adlererik/voicevault/hardware/evidence/2026-11-12/README.md

# VoiceVault B0 hardware evidence — 2026-11-12

**Latest complete-board routing checkpoint fails native DRC. Manufacturing and physical qualification remain blocked.** No board was manufactured or measured. The Rust laboratory's eleven verification groups were not rerun for this CAD-only change.

Actual native KiCad partial routing

The native board contains **296 electrical components, 14 probe pads and four mounting holes**, on a provisional two-sided 70 × 45 mm outline. The image labels actual, unchanged footprint positions and shows the latest complete-board autorouter result. Routing is incomplete and has native DRC errors. The six-layer/1.0mm stackup is a proposal, not an accepted manufacturing specification.

## Latest global autorouting result

Official **FreeRouting 2.5.0**, unmodified JAR, OpenJDK 25.0.4.1. The 30-minute job limit was reached, and the router saved an SES. The entire copper result was imported into the live editor through kipy; all 314 placements and original zones were preserved. Copper zones were refilled before native DRC.

**Native KiCad: 280 open connections; 33 layout errors and 100 warnings; 2,137 tracks/vias (274 vias, including 53 laser).** Two tracks violate the antenna rule, twelve tracks are undersized, nineteen thermal connections are starved, and one hundred copper items are dangling. This is not accepted manufacturing copper. [Complete result, logs, DSN, SES and native DRC](autoroute/README.md).

## Historical input checkpoint and circuit-model checks

The table, `report.json` and `drc.json` below describe the saved **pre-autoroute source hash `40b4ab8a…`**, not the current board. Earlier passing guards do not establish that the new global result passes. The input checkpoint remains available in Git commit `53378f2`. The Rust laboratory and circuit models were not rerun for the global copper import.

| Check | Recorded result | Evidence / scope |
|---|---|---|
| Source copies | Nine preserved references match their hashes | [Report](report.json) |
| MCU identity/pin mapping | 144 balls and 29 selected functions agree with pinned ST data | Actual native schematic export and [independent ST data](../../rev-b/reference/st-ufbga144-ballout.json) |
| Circuit-to-pad correspondence | 1,026 schematic-connected nodes, 124 intentional NC pins; 314 footprints | Actual PCB pad/net inspection, not just the circuit manifest |
| microSD replacement | Molex 1040310811, eleven logical pins / fourteen lands agree with reviewed drawing and actual board | [Geometry check](microsd-footprint.json), [replacement stage](routing/microsd-replacement.json), [revision/provenance limits](../../rev-b/reference/microsd-selection.json) |
| ERC | Zero issues | [Native ERC report](erc.rpt) |
| DRC | Zero non-routing violations; **495 unrouted connections** | [Native DRC report](drc.json). This snapshot lists all 495 open connections. Progress always uses the full native ratsnest when the detailed list is capped. |
| Antenna rule negative control | Unrelated track and ground via rejected; RF-feed track allowed | [Result](antenna-negative/result.json). A board copy was deliberately modified; the live PCB was unchanged. |
| Copper import guard | Valid existing-net RF connection retained, antenna intrusion rejected; live board unchanged | [Control result](routing/import-control.json), [reproducible check](../../tools/check_routing_import.py) |
| Laser-via audit | Thirty-one laser vias; no nominal geometry violations; deliberately bad spacing rejected | [Geometry and limits](hdi-geometry.json) |
| MCP acceptance guards | Changed candidate and stale source rejected; live board unchanged | [Actual negative controls](routing/mcp-acceptance-control.json) |
| Local KiCad MCP | KiCad 10.0.8, 314 footprints, 199 named nets | [Actual stdio-to-IPC call result](mcp-connection.json) |
| ngspice 47 models | **799 cases completed** | Passive/static model assumptions below. |
| Power allocation | Named engineering modes fit the proposed 1200mAh-pack allocation under explicit assumptions | [Budget inputs/results and limitations](power-budget.json). Not measured power or battery life. |
| Historical routing trial | Incomplete, 480-second timeout; no accepted route | [Record](routing-study.json), [log](routing-study.log). Earlier copy, no output applied. Fanout progress is not routing completion. |

The pre-autoroute board contained **345 track segments, 103 vias (31 laser) and four ground pours**, alongside the tested antenna rule area. The full native count fell from 853 to 495; most of that reduction comes from ground pours. [Initial RF-stage record](routing/rf-stage.json), [accepted MCU connection](routing/core-route.json), [RF ground refinement](routing/rf-ground-refinement.json). A later bounded lattice-router study timed out with no saved route and was not applied: [record](routing/lattice-timeout.json), [log](routing/lattice.log).

Accepted routing stages: [14 MCU ground escapes](routing/mcu-ground-escape.json), [PMIC capacitor/placement adaptation](routing/pmic-cap-route.json), [first control batch](routing/control-wave1.json), [second control batch](routing/control-wave2.json). The batches each contain eight control nets; the associated `*-plan.json` and `*-mcp.json` records retain the proposed paths and actual local acceptance calls. [Main crystal placement, routes and seven ground microvias](routing/hse-layout.json) were accepted after a separate explicit placement/pad comparison and native checks; the chip and capacitor branches stay on F.Cu. [Method, reproducibility and process assumptions](../../rev-b/ROUTING.md).

[Manufacturing cost comparison](../../rev-b/MANUFACTURING_COST.md) targets four assemblies delivered to Sweden. Public fees establish cost drivers, not a cheapest complete delivered quotation.

Additional bounded Freerouting studies also timed out without an output session and were not applied: [360-second run](routing/freerouting-bounded.json), [240-second run with fanout disabled](routing/freerouting-no-fanout.json). The [local search-budget modification](routing/freerouting-budget-patch.json) is explicit; these were modified-tool experiments, not upstream qualification results. Fine-pitch escape and clock/decoupling placement need deliberate engineering before another whole-board routing attempt.

The [report](report.json) records SHA-256 hashes of the exact CAD, project/rule files and circuit manifest that were checked. All manufacturing blockers remain visible. Its `native_nets` count includes virtual singleton NC records; **199** is the count of named copper nets.

## Circuit-model measurements

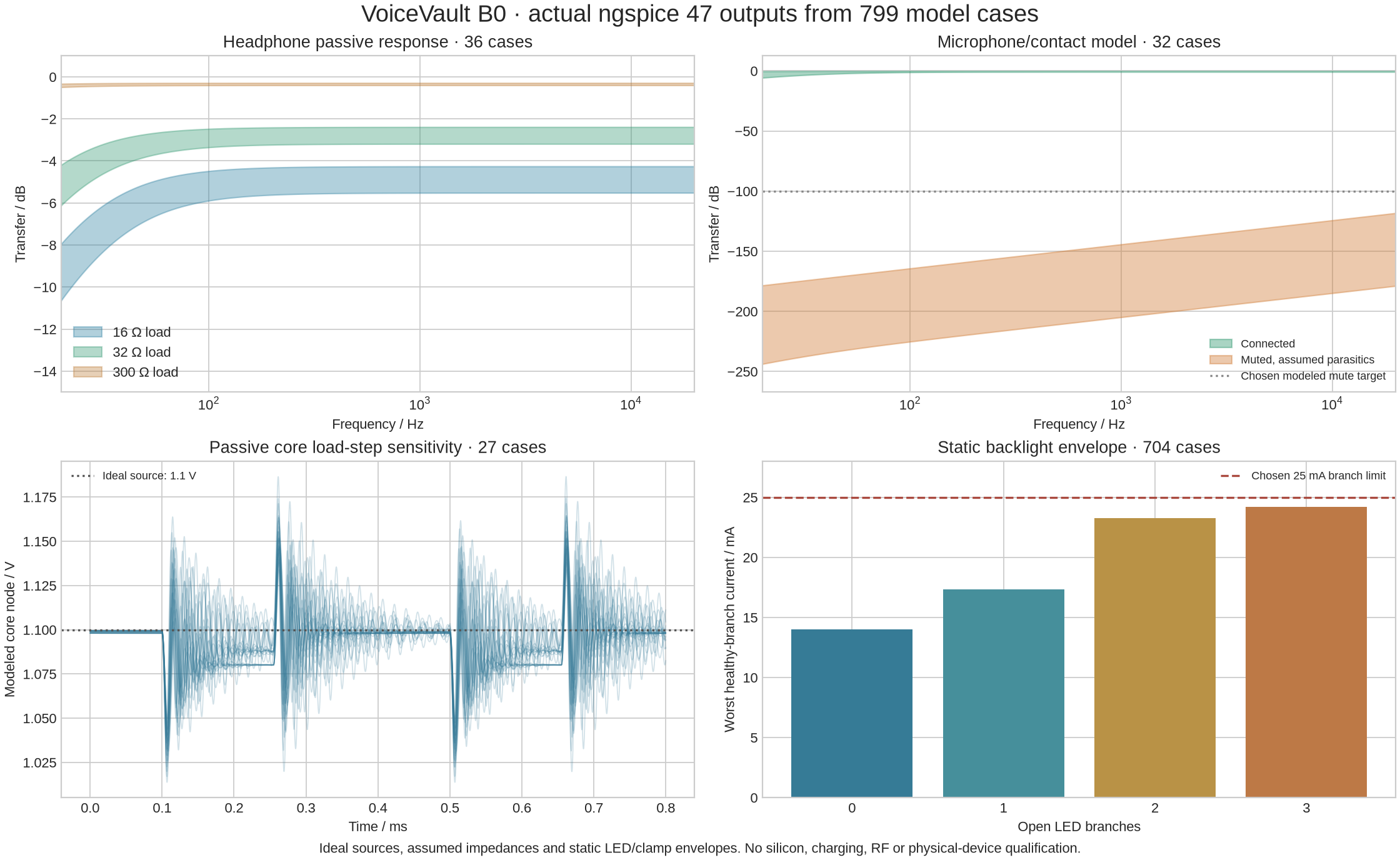
[picture p3: hardware/evidence/2026-11-12/circuit-results.png]
Actual model outputs


- [27 MCU passive core-network cases](spice-core/summary.json): ideal averaged source, component sensitivities and a specified load step. No MCU regulator/control-loop model.
- [36 headphone, 32 microphone and 704 backlight cases](spice-audio-backlight/summary.json): exact measured model outputs, input assumptions and limits. No codec/charging/converter silicon or acoustic model.
- [Representative raw inputs, logs and data](sample-cases/) include the maximum-current and maximum-voltage backlight cases. The complete 799-case numerical summaries are retained above. Re-run the scripts to regenerate every raw case locally.
- [Simulator version](spice-audio-backlight/version.txt), [plot-library versions](plot-tools.json), [latest CAD/import check log](check.log), [799-case run before the final layout-only refinement](model-check-before-layout-refinement.log).

Reproduce available checks with `./hardware/check --design-only --spice`. The `--design-only` exit status concerns available checks; it does not clear the manufacturing verdict. Model results cannot establish that the device functions securely on physical silicon or withstands the adversary described in the software threat model.

## What remains

An accepted HDI stackup/pad process, reviewed exact parts and lifecycle/sourcing, completed power/RF/signal routing and planes, thermal/charging/ESD review, independent electrical review, final BOM/CPL/DFM/test-fixture acceptance, board-specific firmware and actual measured samples/interrupts/access denials. [Active design and gates](../../rev-b/README.md)

## Saved placement before whole-board autorouting

The saved 448-item copper checkpoint has 345 track segments, 103 vias (31 laser), 495 open connections and zero native layout violations. Twelve further control nets were accepted in [batch 3](routing/control-wave3.json), then seven inner escapes were explicitly reworked without changing other copper or pad positions. The [before audit](routing/mcu-escape-before.json) detected nine blocked sites; the [checked rework](routing/mcu-escape-rework.json) and [current audit](mcu-escape-reservations.json) leave all 68 reserved MCU sites clear. The audit also rejects an injected foreign branch on a memory-only copy. This covers MCU escape space, not complete fanout or other packages.

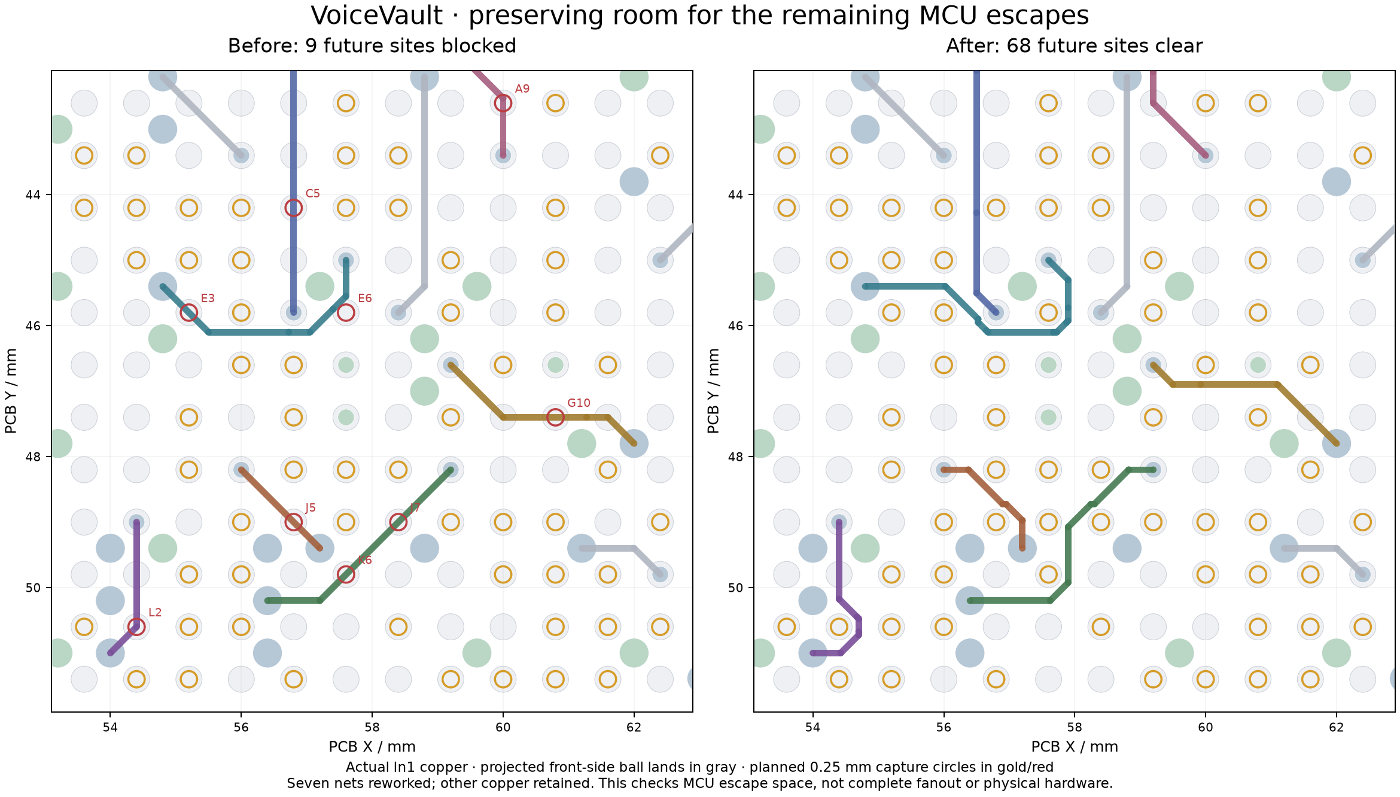
[picture p4: hardware/evidence/2026-11-12/mcu-escape-review.png]
Actual native MCU escape geometry


The owner has now selected a complete-board FreeRouting DSN/SES workflow. These saved-placement checks describe the input checkpoint; the whole-board import and final DRC are separate results.
