adlererik/voicevault/docs/evidence/voicevault-live/README.md

# VoiceVault complete live verification

Run `voicevault-complete` on 2026-11-10, with runtime sources identified by the tested-source manifest (native implementation commit e2742cc, with the subsequent UI refinement explicitly recorded). All eleven required groups and 42 checks passed; the runner exited zero. The journal is the actual event set and the verdict links raw logs. `live`/`live-faults` are extra eight-second observed calls. Scored timing traces are recorded, not live telemetry. The four Kani proofs and six >=120-second fuzz campaigns retain their original bounds/gates.

The local full artifact also contains offline HTML, generated WAVs, fuzz corpora and the public-key diagnostic ELF. These are software evidence, not a physical device test or production firmware. Earlier interrupted development attempts are not counted as successful full runs. The original phase-two directory remains unchanged except for an added verbatim copy of its summary.
