adlererik/voicevault/hardware/evidence/2026-11-13/quilter/routing-input/README.md

# Routing input — not a manufacturing release

This is the native-checked input to Quilter job `6af65cc705fb406688266032`, not a finished result or the live KiCad project. It has unfinished connections and 67 dangling-copper warnings. Native DRC reported zero errors and the separate laser-hole audit passed. See the parent evidence and hardware/rev-b/QUILTER_ROUTING.md. The project uses embedded footprint geometry; its source libraries are in hardware/rev-b.
