adlererik/voicevault/hardware/requirements-design.txt

-r requirements-mcp.txt
# Offline two-sided courtyard packing. KiCad itself supplies the native CAD API.
rectpack==0.2.2
