adlererik/voicevault/hardware/requirements-mcp.txt

# Official MCP SDK and official KiCad IPC bindings, tested together.
mcp==1.26.0
kicad-python==0.8.0
