adlererik/voicevault/hardware/rev-b/QUILTER_ROUTING.md

# Quilter routing preparation — 13 November 2026

**Full cloud trial finished at 89% routed and failed native qualification.** The live KiCad board still contains the earlier unfinished FreeRouting checkpoint. Cloud results and repair candidates are isolated copies, not an accepted replacement. [Actual returned board, failures and native evidence](../evidence/2026-11-13/quilter/routed-return/README.md).

**A corrected full-layout retry launched at 14:35 Europe/Stockholm on 13 November:** [VoiceVault B0 — Corrected routing, fanout disabled](https://app.quilter.ai/jobs/6af70fde5e1a5ebf38278f80). It runs on Quilter's servers and can continue with Codex/the computer off. This is a submitted job, not a completed or qualified PCB. [Saved settings and launch evidence](../evidence/2026-11-13/quilter/native-repair/cloud-retry.json).

The retry uses a fresh-process-verified copy with zero native layout errors, 214 dangling-copper warnings and 207 unfinished connections. Native-DRC-driven cleanup removed 193 offending cloud copper items while preserving all 473 protected source items; the reviewed core/battery-capacitor and package-land corrections are included. [Native cleanup verification](../evidence/2026-11-13/quilter/native-repair/verification.json).

The new submission explicitly disables forced fanout for all seven BGAs and increases new-routing clearance to 0.15 mm and ordinary via diameter to 0.50 mm with 0.20 mm drill. The reviewed current/decoupling/clock/converter tables were re-imported, rather than trusting automatic guesses. All 314 components remain placed; Quilter reports 492 pins to route. The account remains Free Plan; no purchase, upgrade or manufacturing order was made. Returned copper still requires original-rule native refill/DRC, geometry and electrical review before live acceptance. Input ENIG metadata does not change the cloud preset's displayed Lead-Free finish; final finish/stackup acceptance remains open.

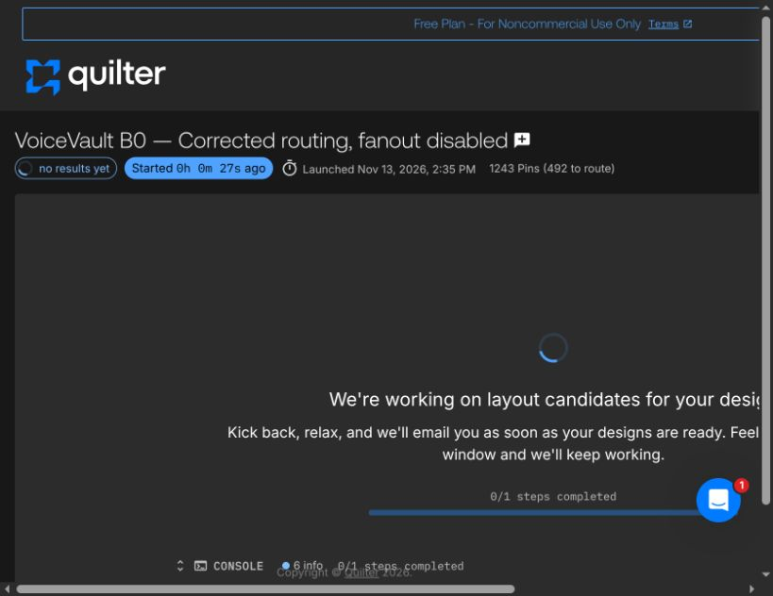
[picture p9: hardware/evidence/2026-11-13/quilter/native-repair/retry-started.jpg]
Corrected cloud retry launched


## Separate new project

The owner requested an independently configured [new VoiceVault project](https://app.quilter.ai/projects/6af617fb05fb406688265ff7). The cancelled project and its guessed settings were not reused or modified. The free account was used; no purchase, upgrade, manufacturing order or supplier message was made.

[The placement-only job](https://app.quilter.ai/jobs/6af61bb61a10ff2500b2aac8) finished on 12 November at 22:27 Europe/Stockholm and produced six placements. This is not a completed routing run. All six were downloaded and checked with native KiCad. Each retained all 314 footprints, 1,243 pads, numbered pad/net assignments and 65 fixed anchors; 249 flexible components moved. Sensitive RF/clock/switch-node copper and the antenna reservations were retained. Quilter's summary reported 122 successful physical-rule checks, two warning groups and no cloud DRC errors per placement.

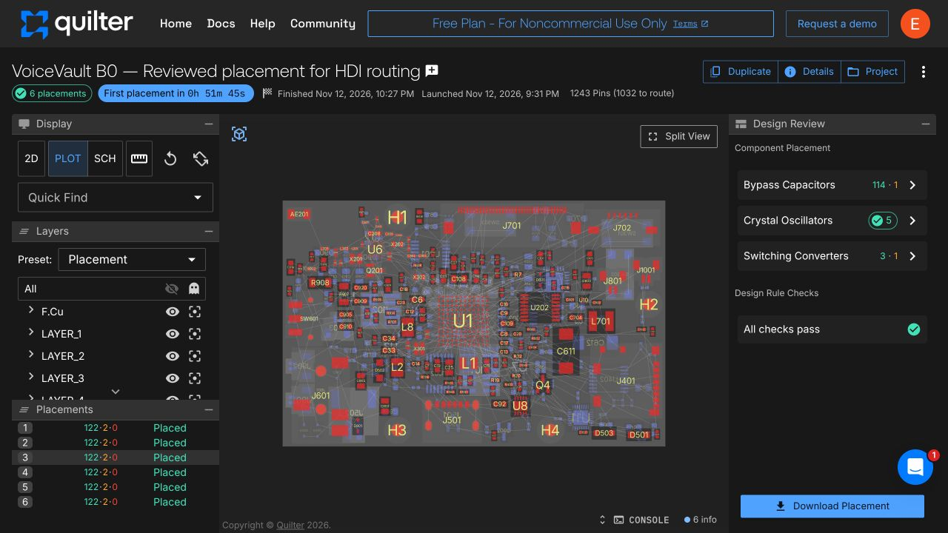
[picture p10: hardware/evidence/2026-11-13/quilter/placement-finished.jpg]
Finished placement job


## Independently selected provisional construction

The new configuration uses six copper layers with ground-reference layers 2 and 5, signals on the other four layers, and no dedicated power plane. The JLCPCB profile is a routing study, not factory acceptance or evidence that JLCPCB is the cheapest assembled supplier. It models 1.538 mm of copper/dielectric; the exported construction including masks sums to approximately 1.599 mm. This differs from the earlier provisional 1.0 mm board.

Minimum routing width/clearance is 0.10 mm; ordinary vias use 0.45 mm lands and 0.20 mm drills; edge allowance is 0.50 mm. The existing first-order HDI laser-via intent is 0.25/0.10 mm. Component gap, current budgets, dielectric construction, effective capacitance and assembly capabilities remain assumptions requiring review. Thirty power-current rows were supplied as design envelopes, not measured currents or fault limits.

The reviewed input had 115 unique bypass-capacitor relationships, five crystal groups, four converter groups and seven BGA fanout entries. A subsequent pin-function review corrected several shared-rail MCU capacitor associations, including the two distinct VDD11 core balls, the SMPS input and the analog/I/O/USB domains. Shared net membership alone does not establish correct decoupling placement. Original submitted tables remain frozen; the corrections are recorded separately in [pin-review.json](../evidence/2026-11-13/quilter/pin-review.json). They do not change schematic nets or establish that the final power layout is adequate.

## Native acceptance checks and rejected experiments

Returned poses from placement 3 were transferred onto the trusted source CAD rather than accepting an entire returned project. This preserved exact original sensitive copper, antenna geometry and native rules. Ground pours were restored. The exported general thickness, still 1.0 mm despite the larger stack, was corrected on the review copy.

Native `kicad-cli` 10.0.8 initialized the original rules, refilled zones and reported **zero layout violations** on that reconstructed placement. This board is still unrouted: the detailed open-connection report reaches its 499-item list limit. Zero layout violations here does not mean a working PCB. [Native placement checks](../evidence/2026-11-13/quilter/placement-drc.json) · [All six identity checks](../evidence/2026-11-13/quilter/placement-inspection.json).

A local automatic capacitor-placement experiment was rejected in full: its courtyard-only search did not account for existing ground vias, and native DRC found 18 findings, including shorts. It was never imported into the live editor. A first automated BGA escape trial was also rejected pending correction of drill-clearance handling. The corrected two-pass trial produced 383 track segments and 90 vias. Native refill/DRC reported zero errors and 67 dangling-copper warnings; the independent laser audit checked 1,002 overlapping-hole pairs and 1,878 foreign-trace pairs with zero findings. Dangling escapes remain unfinished routing, not completed connections. [Escape evidence](../evidence/2026-11-13/quilter/escape-result.json). Router-generated copper must satisfy original native rules and a separate laser-hole geometry audit before acceptance. Rules have not been relaxed to conceal these results.

## Full routing trial launched

[VoiceVault B0 — Native-checked routing trial](https://app.quilter.ai/jobs/6af65cc705fb406688266032) launched on **13 November at 01:49 Europe/Stockholm** in **Full layout** mode. The upload parsed as 314 preplaced components, zero unplaced components and 957 pins to route. The stackup and minimum dimensions were reviewed explicitly. Five configuration tables were downloaded again and matched exactly; GND was verified as primary. [Actual submitted tables and equality checks](../evidence/2026-11-13/quilter/constraints/verification.json).

An additional native physical-connectivity audit examines 250 connected BGA pins with zones excluded from traversal. Its positive control detects existing through vias; its negative control removes conductive links on an in-memory copy and confirms MCU M8 becomes disconnected. Five pins currently have laser-only paths: U10 C3, U6 F7/H1 and U1 A4/A10. Of these 250 pins, 110 currently reach a through via, five have laser-only paths and 135 have no via path. Surface escape routes may still be possible; these counts are not completed-route percentages. Their onward escapes must be checked in the routed output; the input still has 505 full native open connections. [Connectivity evidence](../evidence/2026-11-13/quilter/escape-connectivity.json).

The trial finished on **13 November at 11:22 Europe/Stockholm**, producing candidate 1.1 at 89% routed. Native reconstruction/refill with the original rules found **103 unfinished connections, 294 layout errors and 117 warnings**. The candidate is rejected for live acceptance. The [returned files and diagnosis](../evidence/2026-11-13/quilter/routed-return/README.md) are preserved separately from the [actual native routing input](../evidence/2026-11-13/quilter/routing-input/voicevault-standalone-b0.kicad_pcb). Neither is a fabrication release. A separate DRC-driven repair and whole-board reroute is in progress; the live board remains unchanged until a replacement is qualified.

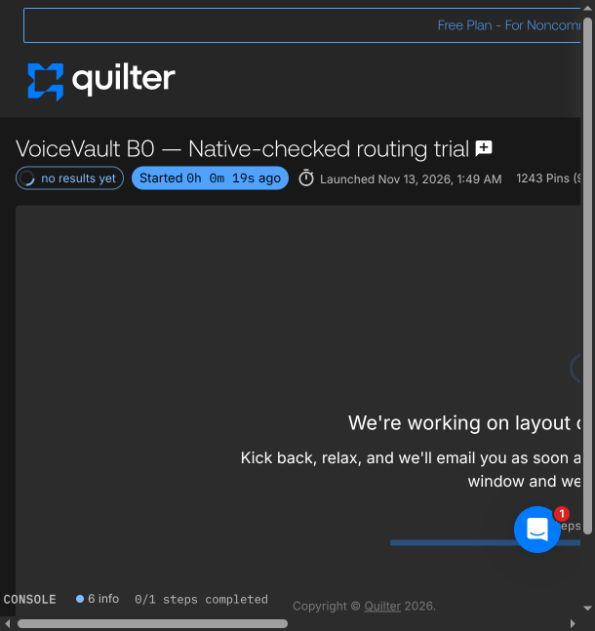
[picture p11: hardware/evidence/2026-11-13/quilter/routing-started.jpg]
Full routing trial launched


## Why routing is staged

Quilter currently documents through-via support; blind/buried-via generation remains in development. Its UI also states that KiCad custom text rules are not parsed. Explicit antenna keepouts were therefore added to the cloud input, and the original native rules are reapplied locally. See [Quilter capabilities](https://www.quilter.ai/) and [official change log](https://www.quilter.ai/changelog).

The planned sequence is placement, locally verified HDI escape preparation, a new full-routing job, returned-copper inspection, native editor import, zone refill and full DRC. Local escape preparation uses public APIs in the official unmodified FreeRouting 2.5.0 JAR through a custom driver. This is an experimental routing aid, not an audited extension or proof of completion. It generates paths algorithmically; no manually supplied trace coordinates are used. CPU and memory limits protect the development computer. The [experimental driver source](../tools/VoiceVaultFanout.java) is included for review; it uses the unchanged official JAR (SHA-256 `f6f51bb02245e8e717f9359bd260cc9c5c0b1bc0acc8b7cb2cd5b8ffeb5de3c7`). The driver and generated escapes remain distinct from the official CLI and from final routing qualification.

Outstanding gates include complete fine-pitch escapes and signal routing, power-return/decoupling geometry, RF/NFC/clock layout, trace-current sizing, exact manufacturer stackup/laser process, sourcing/derating, full ERC/DRC and independent electrical review. No manufacturing files have been released. No physical performance or security claim follows from these CAD checks.

## Returned-board identity gate

[check_quilter_candidate.py](../tools/check_quilter_candidate.py) compares component references, values, library identifiers, poses, pad numbers/nets/geometry, pad orientation/offset/corner treatment, local clearance/mask/paste overrides, copper-layer count, board outline, protected input copper and exact antenna rule areas. It rejects duplicate component references and flags unknown copper nets and unexpected new non-through via processes. Its source/candidate hashes bind the output to actual files. The saved [positive and six deliberate mutation controls](../evidence/2026-11-13/quilter/candidate-gate-controls.json) pass: net substitution, changed antenna restriction, missing protected copper, pad rotation, mask change and duplicate footprint. The controls restore the in-memory candidate and verify it against a fresh file load without saving. This gate does not approve the completed routing: native clearance rules, laser-hole geometry and electrical review remain separate requirements. Split or merged original segments require explicit review; the guard does not silently waive them.

## Proposed core-power placement repair

While the full routing job runs, an isolated three-component proposal moves C27/C107 to the rear beneath VDD11 balls D4/J9 and moves supervisor bypass C305 near U4 supply pin 4. The automatic search includes actual existing copper and drilled-hole obstacles. Native refill/DRC reports zero errors and the same 67 dangling-copper warnings; pad nets are preserved. [Hash-bound proposal and exact positions](../evidence/2026-11-13/quilter/core-power-placement-proposal.json).

These changes are absent from both the live board and the running cloud input. Zero XY projection across two PCB faces is a placement measurement, not proof of a short electrical loop. The proposal needs fresh routing, return-path inspection and qualification on the returned cloud candidate before acceptance.

## Server input verification and supplementary escape trial

The active job's **Download Input Files** archive was downloaded back from Quilter. All 21 file hashes match the upload manifest exactly. The PCB hash differs from the archived failed whole-board FreeRouting result. [Server verification](../evidence/2026-11-13/quilter/server-input-verification.json).

The local fanout driver now has an optional minimum escape-length argument; the default remains 0.6 mm, reproducing the submitted trial. A separate zero-minimum experiment permits the search to consider immediate via locations for fine-pitch pads. It runs on the isolated three-component repair proposal, not on the live board or the running cloud input. It produced 387 track segments and 93 vias, passed native refill/DRC with zero errors and 69 dangling-copper warnings, and passed the independent 14-laser-via audit. It still has 505 open connections. This is preparation for possible repair, not finished routing. [Measured trial result](../evidence/2026-11-13/quilter/direct-escape-trial.json).

No clearance limits were relaxed for this trial. Filled/planarized blind vias, exact stackup and assembly acceptance remain required; see [JLCPCB's published HDI process](https://jlcpcb.com/help/article/hdi-pcb-capabilities-faq).

## Parallel circuit and parts review

While full routing runs, the [parts-selection review](PARTS_SELECTION.md) records 182 additional nominal component candidates and a separately checked C502 battery-decoupling correction. It records rejected/held tolerance mismatches and preserves effective-capacitance, regulator-loop and assembly gates. The corrected copy preserves all source copper and electrical net assignments and passes native ERC/layout-error checks, but retains 505 open connections. It is not uploaded to the running job and is not accepted into the live editor. It must be integrated with fresh routing and electrical review after a routed result is available.

## Fine-pitch package review

Manufacturer drawing review identified two more geometry corrections to evaluate after the cloud result. ST's STWLC38 Figure 17 recommends 0.240 mm footprint lands; U5's draft uses 0.210 mm. ST's ST25R3916B Figure 43 shows a 0.330 mm footprint example; U7's draft uses 0.250 mm. The nominal grid/pad centers are retained in the isolated correction probe. [STWLC38 DS14078 p56](https://www.st.com/resource/en/datasheet/stwlc38.pdf) · [ST25R3916B DS13541 Rev11 p163](https://www.st.com/resource/en/datasheet/st25r3916b.pdf).

An isolated copy applies only those two diameter changes after the battery/core-capacitor proposals. Its 76 changed pads retain exact numbers, net assignments and centers; all 473 source copper items, antenna restrictions and outline are preserved. Native initialized refill/DRC reports zero layout errors and 67 dangling-copper warnings, with 505 full open connections. The isolated footprint-library copies match the changed board instances. [Hash-bound geometry probe](../evidence/2026-11-13/quilter/package-land-probe/verification.json).

TI's exact [YZF eight-ball package drawing](https://www.ti.com/lit/pdf/MXBG053J), linked from the TPS61062YZFR product page, confirms the draft's 0.5 mm grid and missing B2 position. It is a package drawing, not approval of PCB mask, paste or land construction; U9 remains unchanged.

These are **review copies**, not changes to the live board or current cloud input. Final copper/mask/paste construction, filled/planarized via integration, electrical return paths, routing and assembler acceptance remain open. Manufacturer nominal examples do not establish that the complete board can be assembled or will work.
