adlererik/voicevault/hardware/evidence/2026-11-13/quilter/constraints/ground_nets.csv

net_name | is_primary | use_region_pour
GND | true | false
