adlererik/voicevault/docs/evidence/phase2/README.md

# Recorded phase-two evidence

This is a curated snapshot of the fresh complete run. The raw verdict links its diagnostic logs. Timing and ARM reports state their gates, observations and limits. Reproduce with `./lab watch` to generate a new run; exact OS timings and OS-random calls will differ. The diagnostic ELF and recovered synthetic WAVs remain in the local downloadable evidence bundle. No production secret keys are included.
