adlererik/voicevault/docs/screenshots/authenticated-peer-rejection.jpg

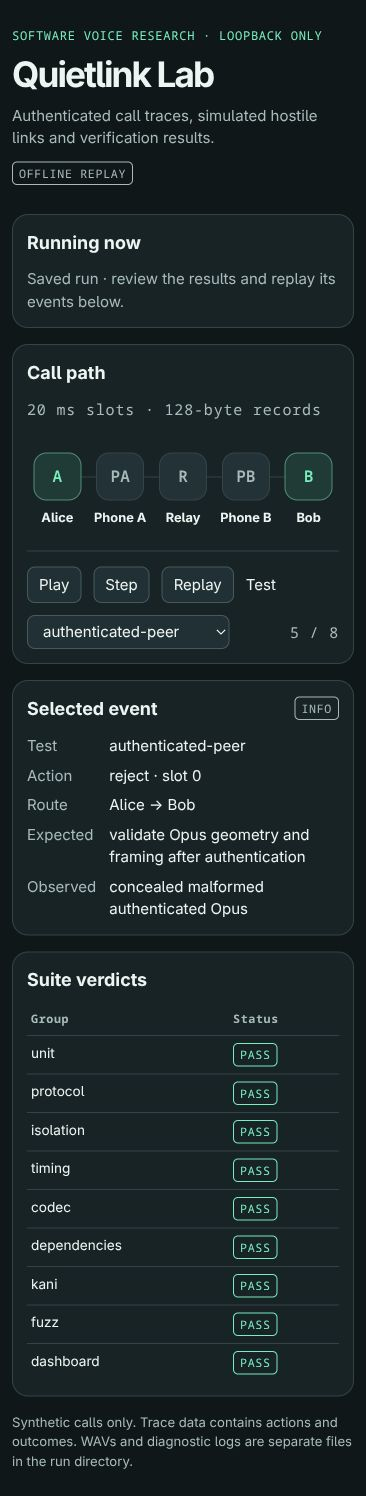
docs/screenshots/authenticated-peer-rejection.jpg
