adlererik/voicevault/docs/screenshots/command-deck-narrow-deck.png

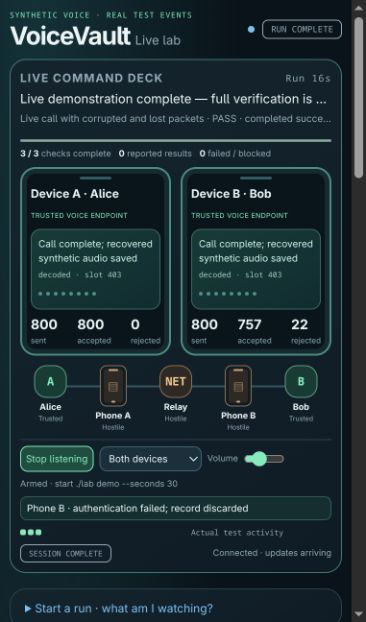
docs/screenshots/command-deck-narrow-deck.png
