adlererik/voicevault/docs/screenshots/dashboard-overview.jpg

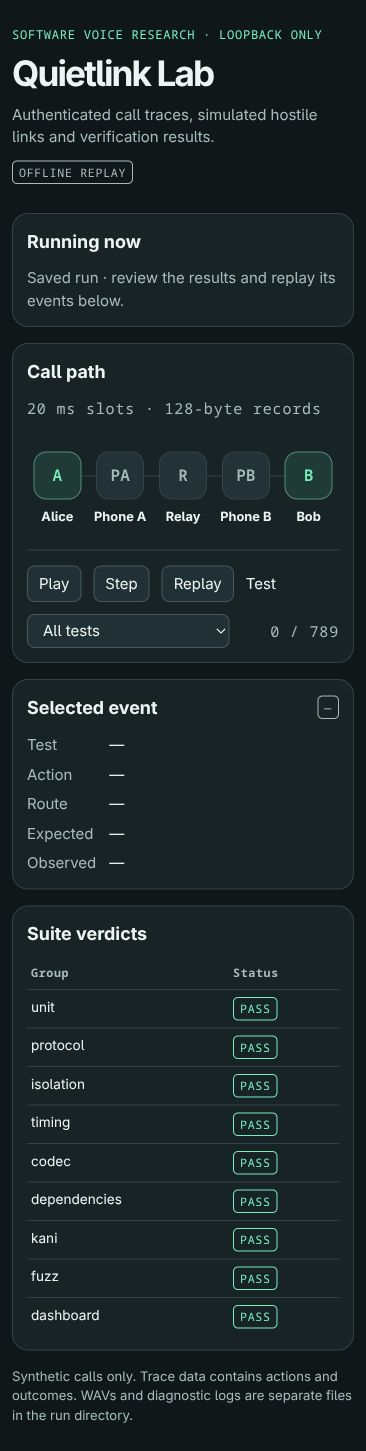
docs/screenshots/dashboard-overview.jpg
