adlererik/voicevault/docs/screenshots/phase2-live.jpg

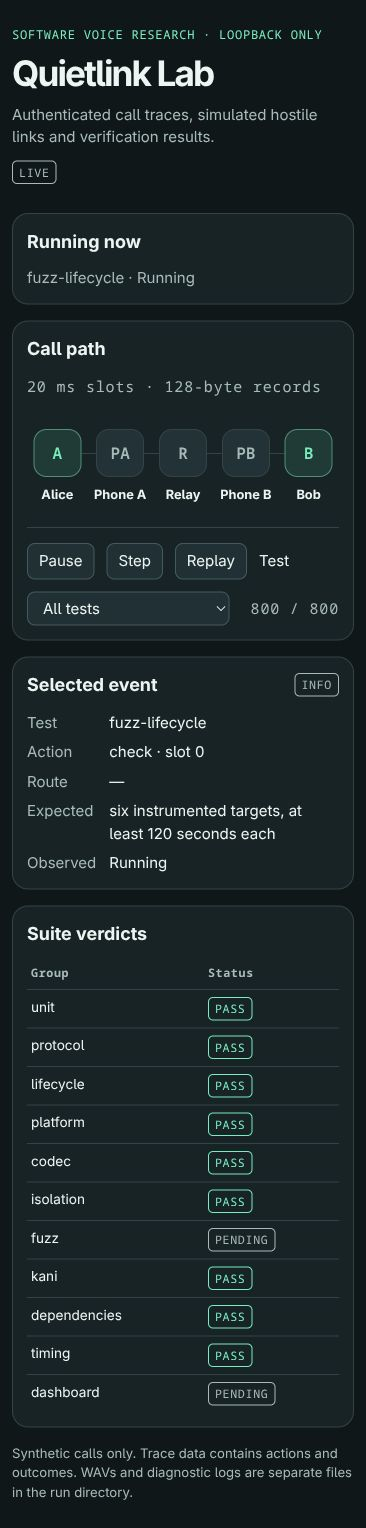
docs/screenshots/phase2-live.jpg
