adlererik/voicevault/docs/screenshots/voicevault-complete.png

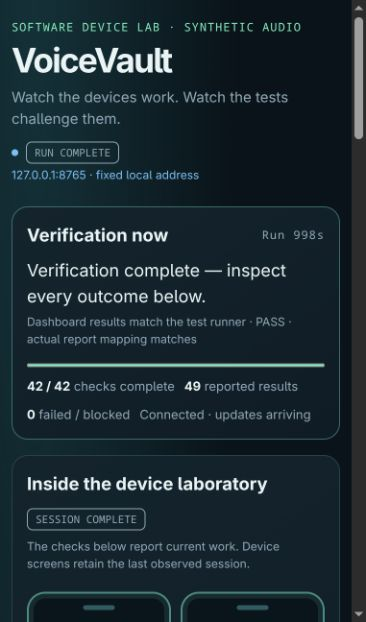
docs/screenshots/voicevault-complete.png
