adlererik/voicevault/docs/screenshots/voicevault-fuzz-progress.png

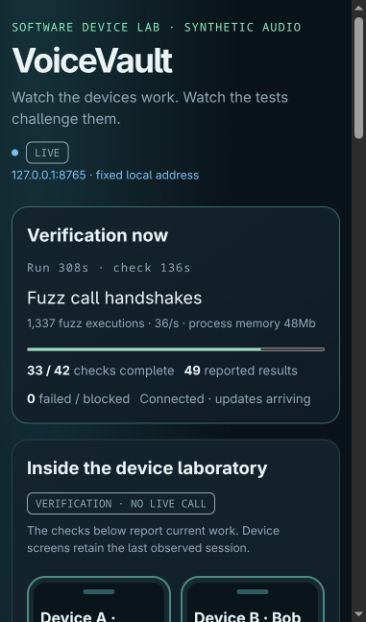
docs/screenshots/voicevault-fuzz-progress.png
