adlererik/voicevault/docs/screenshots/voicevault-live-devices.png

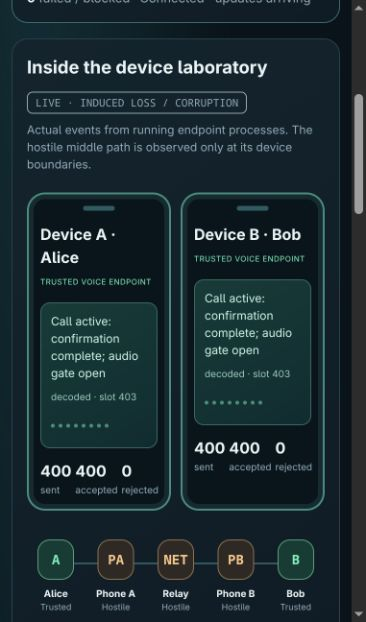
docs/screenshots/voicevault-live-devices.png
