adlererik/voicevault/docs/screenshots/voxbastion-pairing.jpg

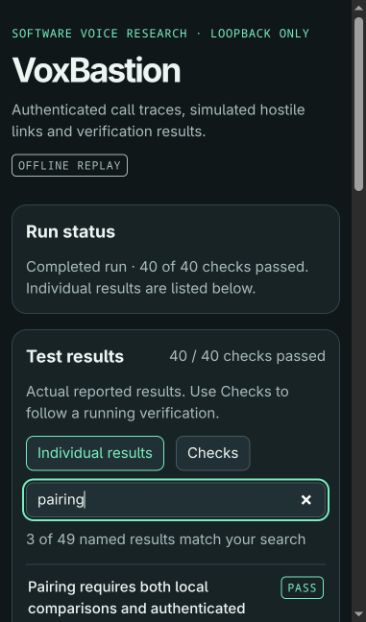
docs/screenshots/voxbastion-pairing.jpg
