adlererik/voicevault/hardware/evidence/2026-11-12/placement.png

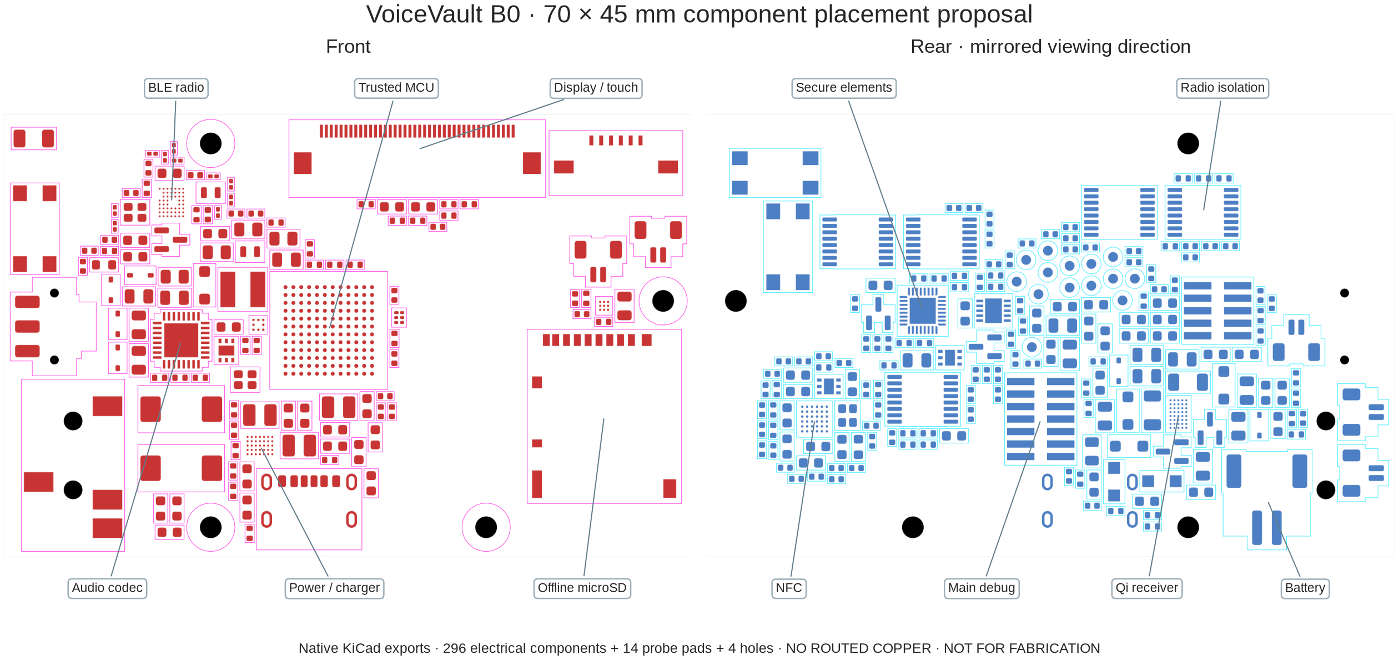
hardware/evidence/2026-11-12/placement.png
