adlererik/voicevault/hardware/rev-b/evidence/board-power-draft.png

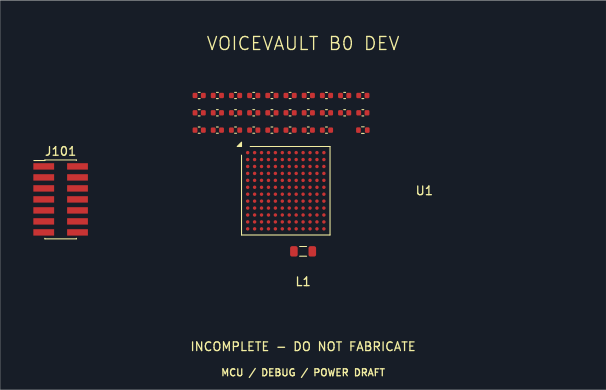
hardware/rev-b/evidence/board-power-draft.png
