adlererik/voicevault/hardware/rev-b/parts-candidates.csv

Manufacturer | CandidateMPN | QuantityPerBoard | QuantityForFourBoards | References | Package | NominalValue | Source | Status | RemainingReview
YAGEO | CC0201GRNPO9BN120 | 2 | 8 | C210,C211 | 0201 | 12p | https://www.yageogroup.com/component-documentation/download/specsheet/CC0201GRNPO9BN120 | CANDIDATE ONLY - NOT ACCEPTED FOR ASSEMBLY | Radio/crystal nominal value and tolerance only; load/stray capacitance, oscillator startup and RF behavior require measurement
YAGEO | CC0201GRNPO9BN160 | 2 | 8 | C201,C202 | 0201 | 16p | https://www.yageogroup.com/component-documentation/download/specsheet/CC0201GRNPO9BN160 | CANDIDATE ONLY - NOT ACCEPTED FOR ASSEMBLY | Radio/crystal nominal value and tolerance only; load/stray capacitance, oscillator startup and RF behavior require measurement
YAGEO | CC0201JRNPO9BN101 | 2 | 8 | C206,C207 | 0201 | 100p | https://www.yageogroup.com/component-documentation/download/specsheet/CC0201JRNPO9BN101 | CANDIDATE ONLY - NOT ACCEPTED FOR ASSEMBLY | Radio/crystal nominal value and tolerance only; load/stray capacitance, oscillator startup and RF behavior require measurement
YAGEO | CC0201KRX7R6BB104 | 2 | 8 | C204,C205 | 0201 | 100n | https://www.yageogroup.com/component-documentation/download/specsheet/CC0201KRX7R6BB104 | CANDIDATE ONLY - NOT ACCEPTED FOR ASSEMBLY | Nominal catalogue screening only; effective capacitance, DC bias, temperature, parasitics, layout and circuit qualification remain open
YAGEO | CC0402JRNPO9BN120 | 4 | 16 | C301,C302,C303,C304 | 0402 | 12p | https://www.yageogroup.com/component-documentation/download/specsheet/CC0402JRNPO9BN120 | CANDIDATE ONLY - NOT ACCEPTED FOR ASSEMBLY | Nominal catalogue checks; effective capacitance, aging, ripple and circuit qualification remain open
YAGEO | CC0402JRNPO9BN330 | 1 | 4 | C610 | 0402 | 33p | https://www.yageogroup.com/component-documentation/download/specsheet/CC0402JRNPO9BN330 | CANDIDATE ONLY - NOT ACCEPTED FOR ASSEMBLY | Nominal catalogue checks; effective capacitance, aging, ripple and circuit qualification remain open
YAGEO | CC0402KRX5R6BB105 | 2 | 8 | C119,C120 | 0402 | 1u | https://www.yageogroup.com/component-documentation/download/specsheet/CC0402KRX5R6BB105 | CANDIDATE ONLY - NOT ACCEPTED FOR ASSEMBLY | Nominal catalogue screening only; effective capacitance, DC bias, temperature, parasitics, layout and circuit qualification remain open; X5R maximum +85 C is an explicit device-temperature constraint
YAGEO | CC0402KRX7R7BB104 | 44 | 176 | C7,C8,C9,C10,C11,C12,C13,C14,C16,C17,C18,C20,C21,C22,C23,C24,C26,C91,C101,C102,C103,C112,C213,C214,C215,C216,C305,C306,C403,C404,C405,C501,C604,C606,C607,C608,C702,C801,C802,C1002,C1027,C1028,C1029,C1030 | 0402 | 100n | https://www.yageogroup.com/component-documentation/download/specsheet/CC0402KRX7R7BB104 | CANDIDATE ONLY - NOT ACCEPTED FOR ASSEMBLY | Nominal catalogue checks; effective capacitance, aging, ripple and circuit qualification remain open
YAGEO | CC0603KRX5R6BB475 | 10 | 40 | C6,C15,C19,C92,C104,C109,C208,C701,C911,C1005 | 0603 | 4.7u | https://www.yageogroup.com/component-documentation/download/specsheet/CC0603KRX5R6BB475 | CANDIDATE ONLY - NOT ACCEPTED FOR ASSEMBLY | Nominal catalogue screening only; effective capacitance, DC bias, temperature, parasitics, layout and circuit qualification remain open; X5R maximum +85 C is an explicit device-temperature constraint
YAGEO | CC0603KRX7R6BB225 | 11 | 44 | C27,C107,C401,C614,C615,C704,C1001,C1003,C1007,C1009,C1016 | 0603 | 2.2u | https://www.yageogroup.com/component-documentation/download/specsheet/CC0603KRX7R6BB225 | CANDIDATE ONLY - NOT ACCEPTED FOR ASSEMBLY | Nominal X7R bulk/bypass candidate. MCU C27/C107 additionally require guaranteed ESR/effective-capacitance and regulator stability: nominal model plots are not maximum ESR/PVT specifications; all return paths and bench checks remain open.
YAGEO | CC0603KRX7R7BB105 | 10 | 40 | C32,C110,C111,C116,C117,C118,C609,C703,C912,C1012 | 0603 | 1u | https://www.yageogroup.com/component-documentation/download/specsheet/CC0603KRX7R7BB105 | CANDIDATE ONLY - NOT ACCEPTED FOR ASSEMBLY | Nominal catalogue screening only; effective capacitance, DC bias, temperature, parasitics, layout and circuit qualification remain open
YAGEO | CC0603KRX7R9BB104 | 5 | 20 | C35,C114,C115,C917,C918 | 0603 | 100n | https://www.yageogroup.com/component-documentation/download/specsheet/CC0603KRX7R9BB104 | CANDIDATE ONLY - NOT ACCEPTED FOR ASSEMBLY | Nominal catalogue checks; effective capacitance, aging, ripple and circuit qualification remain open
YAGEO | CC0805KFX5R8BB106 | 12 | 48 | C25,C108,C402,C601,C602,C603,C605,C803,C913,C914,C915,C916 | 0805 | 10u | https://www.yageogroup.com/component-documentation/download/specsheet/CC0805KFX5R8BB106 | CANDIDATE ONLY - NOT ACCEPTED FOR ASSEMBLY | Nominal catalogue screening only; effective capacitance, DC bias, temperature, parasitics, layout and circuit qualification remain open; X5R maximum +85 C is an explicit device-temperature constraint; C25 MCU SMPS input and Qi rectifier effective-capacitance/ripple requirements are not qualified
Panasonic | ERJ2RKF10R0X | 2 | 8 | R606,R607 | 0402 | 10R | https://na.industrial.panasonic.com/products/resistors/smd-chip-resistors/lineup/chip-resistors/series/57494/model/65828 | CANDIDATE ONLY - NOT ACCEPTED FOR ASSEMBLY | Meets printed minimum power rating; actual thermal/pulse/layout capability and allocation remain open
Panasonic | ERJ2RKF12R0X | 1 | 4 | R707 | 0402 | 12R | https://industrial.panasonic.com/ww/products/pt/general-purpose-chip-resistors/models/ERJ2RKF12R0X | CANDIDATE ONLY - NOT ACCEPTED FOR ASSEMBLY | Meets printed minimum power rating; actual thermal/pulse/layout capability and allocation remain open
Panasonic | ERJP06F2000V | 4 | 16 | R709,R710,R711,R712 | 0805 | 200R | https://industrial.panasonic.com/tw/products/pt/small-and-high-power-chip-resistors/models/ERJP06F2000V | CANDIDATE ONLY - NOT ACCEPTED FOR ASSEMBLY | Meets printed minimum power rating; actual thermal/pulse/layout capability and allocation remain open
YAGEO | RC0402FR-07100KL | 21 | 84 | R201,R203,R204,R205,R206,R302,R401,R402,R603,R608,R703,R704,R708,R801,R906,R912,R913,R914,R1001,R1005,R1006 | 0402 | 100k | https://www.yageogroup.com/component-documentation/download/specsheet/RC0402FR-07100KL | CANDIDATE ONLY - NOT ACCEPTED FOR ASSEMBLY | Nominal catalogue checks only; actual power/temperature and assembler allocation remain open
YAGEO | RC0402FR-0710KL | 3 | 12 | R301,R901,R904 | 0402 | 10k | https://www.yageogroup.com/component-documentation/download/specsheet/RC0402FR-0710KL | CANDIDATE ONLY - NOT ACCEPTED FOR ASSEMBLY | Nominal catalogue checks only; actual power/temperature and assembler allocation remain open
YAGEO | RC0402FR-07150KL | 1 | 4 | R905 | 0402 | 150k | https://www.yageogroup.com/component-documentation/download/specsheet/RC0402FR-07150KL | CANDIDATE ONLY - NOT ACCEPTED FOR ASSEMBLY | Nominal catalogue checks only; actual power/temperature and assembler allocation remain open
YAGEO | RC0402FR-071KL | 3 | 12 | R34,R106,R605 | 0402 | 1k | https://www.yageogroup.com/component-documentation/download/specsheet/RC0402FR-071KL | CANDIDATE ONLY - NOT ACCEPTED FOR ASSEMBLY | Nominal catalogue checks only; actual power/temperature and assembler allocation remain open
YAGEO | RC0402FR-07220KL | 1 | 4 | R903 | 0402 | 220k | https://www.yageogroup.com/component-documentation/download/specsheet/RC0402FR-07220KL | CANDIDATE ONLY - NOT ACCEPTED FOR ASSEMBLY | Nominal catalogue checks only; actual power/temperature and assembler allocation remain open
YAGEO | RC0402FR-072K2L | 9 | 36 | R5,R7,R19,R20,R601,R602,R604,R909,R910 | 0402 | 2.2k | https://www.yageogroup.com/component-documentation/download/specsheet/RC0402FR-072K2L | CANDIDATE ONLY - NOT ACCEPTED FOR ASSEMBLY | Nominal catalogue checks only; actual power/temperature and assembler allocation remain open
YAGEO | RC0402FR-07330KL | 2 | 8 | R12,R102 | 0402 | 330k | https://www.yageogroup.com/component-documentation/download/specsheet/RC0402FR-07330KL | CANDIDATE ONLY - NOT ACCEPTED FOR ASSEMBLY | Nominal catalogue checks only; actual power/temperature and assembler allocation remain open
YAGEO | RC0402FR-0747KL | 21 | 84 | R21,R22,R31,R32,R33,R103,R104,R105,R202,R303,R304,R403,R404,R405,R406,R407,R705,R706,R802,R911,R1002 | 0402 | 47k | https://www.yageogroup.com/component-documentation/download/specsheet/RC0402FR-0747KL | CANDIDATE ONLY - NOT ACCEPTED FOR ASSEMBLY | Nominal catalogue checks only; actual power/temperature and assembler allocation remain open
YAGEO | RC0402FR-074K7L | 2 | 8 | R701,R702 | 0402 | 4.7k | https://www.yageogroup.com/component-documentation/download/specsheet/RC0402FR-074K7L | CANDIDATE ONLY - NOT ACCEPTED FOR ASSEMBLY | Nominal catalogue checks only; actual power/temperature and assembler allocation remain open
YAGEO | RC0402FR-076K8L | 1 | 4 | R902 | 0402 | 6.8k | https://www.yageogroup.com/component-documentation/download/specsheet/RC0402FR-076K8L | CANDIDATE ONLY - NOT ACCEPTED FOR ASSEMBLY | Nominal catalogue checks only; actual power/temperature and assembler allocation remain open
YAGEO | RC0402JR-070RL | 1 | 4 | R101 | 0402 | 0R | https://www.yageogroup.com/component-documentation/download/specsheet/RC0402JR-070RL | CANDIDATE ONLY - NOT ACCEPTED FOR ASSEMBLY | Jumper current/resistance govern selection; not an ideal zero-resistance current shunt
YAGEO | RC0603JR-070RL | 1 | 4 | R609 | 0603 | 0R | https://www.yageogroup.com/component-documentation/download/specsheet/RC0603JR-070RL | CANDIDATE ONLY - NOT ACCEPTED FOR ASSEMBLY | Jumper current/resistance govern selection; not an ideal zero-resistance current shunt
KEMET | T520D227M006ATE025 | 2 | 8 | C611,C612 | EIA-7343-31 | 220u | https://www.yageogroup.com/component-documentation/download/specsheet/T520D227M006ATE025 | CANDIDATE ONLY - NOT ACCEPTED FOR ASSEMBLY | C611/C612 headphone DC-block candidates only; verify polarized land pattern, DC operating point, transient/reverse stress, leakage, pop and dummy-load behavior before wearing headphones
