adlererik/voicevault/hardware/rev-b/circuit-inventory.csv

Reference | Circuit value / requirements | KiCad footprint | Identified design order code | Procurement status | Remaining part review
AE201 | 2450AT18B0100001E | VoiceVault_B0:Johanson_2450AT18x100 | 2450AT18B0100001E | NOT ACCEPTED FOR ASSEMBLY | Exact package/revision, lifecycle, sourcing and assembly acceptance required
C6 | 4.7u 10V | VoiceVault_B0:C_0603_1608Metric |  | NOT ACCEPTED FOR ASSEMBLY | Exact MPN, tolerance/derating, package/polarity and current/thermal review required
C7 | 100n 10V | VoiceVault_B0:C_0402_1005Metric |  | NOT ACCEPTED FOR ASSEMBLY | Exact MPN, tolerance/derating, package/polarity and current/thermal review required
C8 | 100n 10V | VoiceVault_B0:C_0402_1005Metric |  | NOT ACCEPTED FOR ASSEMBLY | Exact MPN, tolerance/derating, package/polarity and current/thermal review required
C9 | 100n 10V | VoiceVault_B0:C_0402_1005Metric |  | NOT ACCEPTED FOR ASSEMBLY | Exact MPN, tolerance/derating, package/polarity and current/thermal review required
C10 | 100n 10V | VoiceVault_B0:C_0402_1005Metric |  | NOT ACCEPTED FOR ASSEMBLY | Exact MPN, tolerance/derating, package/polarity and current/thermal review required
C11 | 100n 10V | VoiceVault_B0:C_0402_1005Metric |  | NOT ACCEPTED FOR ASSEMBLY | Exact MPN, tolerance/derating, package/polarity and current/thermal review required
C12 | 100n 10V | VoiceVault_B0:C_0402_1005Metric |  | NOT ACCEPTED FOR ASSEMBLY | Exact MPN, tolerance/derating, package/polarity and current/thermal review required
C13 | 100n 10V | VoiceVault_B0:C_0402_1005Metric |  | NOT ACCEPTED FOR ASSEMBLY | Exact MPN, tolerance/derating, package/polarity and current/thermal review required
C14 | 100n 10V | VoiceVault_B0:C_0402_1005Metric |  | NOT ACCEPTED FOR ASSEMBLY | Exact MPN, tolerance/derating, package/polarity and current/thermal review required
C15 | 4.7u 10V | VoiceVault_B0:C_0603_1608Metric |  | NOT ACCEPTED FOR ASSEMBLY | Exact MPN, tolerance/derating, package/polarity and current/thermal review required
C16 | 100n 10V | VoiceVault_B0:C_0402_1005Metric |  | NOT ACCEPTED FOR ASSEMBLY | Exact MPN, tolerance/derating, package/polarity and current/thermal review required
C17 | 100n 10V | VoiceVault_B0:C_0402_1005Metric |  | NOT ACCEPTED FOR ASSEMBLY | Exact MPN, tolerance/derating, package/polarity and current/thermal review required
C18 | 100n 10V | VoiceVault_B0:C_0402_1005Metric |  | NOT ACCEPTED FOR ASSEMBLY | Exact MPN, tolerance/derating, package/polarity and current/thermal review required
C19 | 4.7u 10V | VoiceVault_B0:C_0603_1608Metric |  | NOT ACCEPTED FOR ASSEMBLY | Exact MPN, tolerance/derating, package/polarity and current/thermal review required
C20 | 100n 10V | VoiceVault_B0:C_0402_1005Metric |  | NOT ACCEPTED FOR ASSEMBLY | Exact MPN, tolerance/derating, package/polarity and current/thermal review required
C21 | 100n 10V | VoiceVault_B0:C_0402_1005Metric |  | NOT ACCEPTED FOR ASSEMBLY | Exact MPN, tolerance/derating, package/polarity and current/thermal review required
C22 | 100n 10V | VoiceVault_B0:C_0402_1005Metric |  | NOT ACCEPTED FOR ASSEMBLY | Exact MPN, tolerance/derating, package/polarity and current/thermal review required
C23 | 100n 10V | VoiceVault_B0:C_0402_1005Metric |  | NOT ACCEPTED FOR ASSEMBLY | Exact MPN, tolerance/derating, package/polarity and current/thermal review required
C24 | 100n 10V | VoiceVault_B0:C_0402_1005Metric |  | NOT ACCEPTED FOR ASSEMBLY | Exact MPN, tolerance/derating, package/polarity and current/thermal review required
C25 | 10u 10V | VoiceVault_B0:C_0805_2012Metric |  | NOT ACCEPTED FOR ASSEMBLY | Exact MPN, tolerance/derating, package/polarity and current/thermal review required
C26 | 100n 10V | VoiceVault_B0:C_0402_1005Metric |  | NOT ACCEPTED FOR ASSEMBLY | Exact MPN, tolerance/derating, package/polarity and current/thermal review required
C27 | 2.2u 10V | VoiceVault_B0:C_0603_1608Metric |  | NOT ACCEPTED FOR ASSEMBLY | Exact MPN, tolerance/derating, package/polarity and current/thermal review required
C32 | 1u 16V | VoiceVault_B0:C_0603_1608Metric |  | NOT ACCEPTED FOR ASSEMBLY | Exact MPN, tolerance/derating, package/polarity and current/thermal review required
C33 | 10u 10V | VoiceVault_B0:C_0603_1608Metric |  | NOT ACCEPTED FOR ASSEMBLY | Exact MPN, tolerance/derating, package/polarity and current/thermal review required
C34 | 10u 10V | VoiceVault_B0:C_0603_1608Metric |  | NOT ACCEPTED FOR ASSEMBLY | Exact MPN, tolerance/derating, package/polarity and current/thermal review required
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
C609 | 1u 10V X7R | VoiceVault_B0:C_0603_1608Metric |  | NOT ACCEPTED FOR ASSEMBLY | Exact MPN, tolerance/derating, package/polarity and current/thermal review required
C610 | 33p C0G | VoiceVault_B0:C_0402_1005Metric |  | NOT ACCEPTED FOR ASSEMBLY | Exact MPN, tolerance/derating, package/polarity and current/thermal review required
C611 | 220u 6.3V polymer; exact MPN qualification pending | VoiceVault_B0:CP_EIA-7343-31_Kemet-D |  | NOT ACCEPTED FOR ASSEMBLY | Exact MPN, tolerance/derating, package/polarity and current/thermal review required
C612 | 220u 6.3V polymer; exact MPN qualification pending | VoiceVault_B0:CP_EIA-7343-31_Kemet-D |  | NOT ACCEPTED FOR ASSEMBLY | Exact MPN, tolerance/derating, package/polarity and current/thermal review required
C614 | 2.2u 10V | VoiceVault_B0:C_0603_1608Metric |  | NOT ACCEPTED FOR ASSEMBLY | Exact MPN, tolerance/derating, package/polarity and current/thermal review required
C615 | 2.2u 10V | VoiceVault_B0:C_0603_1608Metric |  | NOT ACCEPTED FOR ASSEMBLY | Exact MPN, tolerance/derating, package/polarity and current/thermal review required
C701 | 4.7u 10V | VoiceVault_B0:C_0603_1608Metric |  | NOT ACCEPTED FOR ASSEMBLY | Exact MPN, tolerance/derating, package/polarity and current/thermal review required
C702 | 100n 10V | VoiceVault_B0:C_0402_1005Metric |  | NOT ACCEPTED FOR ASSEMBLY | Exact MPN, tolerance/derating, package/polarity and current/thermal review required
C703 | 1u 10V | VoiceVault_B0:C_0603_1608Metric |  | NOT ACCEPTED FOR ASSEMBLY | Exact MPN, tolerance/derating, package/polarity and current/thermal review required
C704 | 2.2u 10V | VoiceVault_B0:C_0603_1608Metric |  | NOT ACCEPTED FOR ASSEMBLY | Exact MPN, tolerance/derating, package/polarity and current/thermal review required
C705 | 1u 50V X7R | VoiceVault_B0:C_0805_2012Metric |  | NOT ACCEPTED FOR ASSEMBLY | Exact MPN, tolerance/derating, package/polarity and current/thermal review required
C801 | 100n 10V | VoiceVault_B0:C_0402_1005Metric |  | NOT ACCEPTED FOR ASSEMBLY | Exact MPN, tolerance/derating, package/polarity and current/thermal review required
C802 | 100n 10V | VoiceVault_B0:C_0402_1005Metric |  | NOT ACCEPTED FOR ASSEMBLY | Exact MPN, tolerance/derating, package/polarity and current/thermal review required
C803 | 10u 10V | VoiceVault_B0:C_0805_2012Metric |  | NOT ACCEPTED FOR ASSEMBLY | Exact MPN, tolerance/derating, package/polarity and current/thermal review required
C901 | 100n 50V X7R | VoiceVault_B0:C_0805_2012Metric |  | NOT ACCEPTED FOR ASSEMBLY | Exact MPN, tolerance/derating, package/polarity and current/thermal review required
C902 | 100n 50V X7R | VoiceVault_B0:C_0805_2012Metric |  | NOT ACCEPTED FOR ASSEMBLY | Exact MPN, tolerance/derating, package/polarity and current/thermal review required
C903 | 47n 50V X7R | VoiceVault_B0:C_0805_2012Metric |  | NOT ACCEPTED FOR ASSEMBLY | Exact MPN, tolerance/derating, package/polarity and current/thermal review required
C904 | 1n 50V C0G | VoiceVault_B0:C_0603_1608Metric |  | NOT ACCEPTED FOR ASSEMBLY | Exact MPN, tolerance/derating, package/polarity and current/thermal review required
C905 | 47n 50V | VoiceVault_B0:C_0603_1608Metric |  | NOT ACCEPTED FOR ASSEMBLY | Exact MPN, tolerance/derating, package/polarity and current/thermal review required
C906 | 47n 50V | VoiceVault_B0:C_0603_1608Metric |  | NOT ACCEPTED FOR ASSEMBLY | Exact MPN, tolerance/derating, package/polarity and current/thermal review required
C907 | 22n 50V | VoiceVault_B0:C_0603_1608Metric |  | NOT ACCEPTED FOR ASSEMBLY | Exact MPN, tolerance/derating, package/polarity and current/thermal review required
C908 | 22n 50V | VoiceVault_B0:C_0603_1608Metric |  | NOT ACCEPTED FOR ASSEMBLY | Exact MPN, tolerance/derating, package/polarity and current/thermal review required
C909 | 10n 50V | VoiceVault_B0:C_0603_1608Metric |  | NOT ACCEPTED FOR ASSEMBLY | Exact MPN, tolerance/derating, package/polarity and current/thermal review required
C910 | 10n 50V | VoiceVault_B0:C_0603_1608Metric |  | NOT ACCEPTED FOR ASSEMBLY | Exact MPN, tolerance/derating, package/polarity and current/thermal review required
C911 | 4.7u 10V | VoiceVault_B0:C_0603_1608Metric |  | NOT ACCEPTED FOR ASSEMBLY | Exact MPN, tolerance/derating, package/polarity and current/thermal review required
C912 | 1u 10V | VoiceVault_B0:C_0603_1608Metric |  | NOT ACCEPTED FOR ASSEMBLY | Exact MPN, tolerance/derating, package/polarity and current/thermal review required
C913 | 10u 25V X5R | VoiceVault_B0:C_0805_2012Metric |  | NOT ACCEPTED FOR ASSEMBLY | Exact MPN, tolerance/derating, package/polarity and current/thermal review required
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
C1016 | 2.2u 10V | VoiceVault_B0:C_0603_1608Metric |  | NOT ACCEPTED FOR ASSEMBLY | Exact MPN, tolerance/derating, package/polarity and current/thermal review required
C1017 | 680p C0G 50V | VoiceVault_B0:C_0402_1005Metric |  | NOT ACCEPTED FOR ASSEMBLY | Exact MPN, tolerance/derating, package/polarity and current/thermal review required
C1018 | 680p C0G 50V | VoiceVault_B0:C_0402_1005Metric |  | NOT ACCEPTED FOR ASSEMBLY | Exact MPN, tolerance/derating, package/polarity and current/thermal review required
C1019 | 150p C0G 50V | VoiceVault_B0:C_0402_1005Metric |  | NOT ACCEPTED FOR ASSEMBLY | Exact MPN, tolerance/derating, package/polarity and current/thermal review required
C1020 | 150p C0G 50V | VoiceVault_B0:C_0402_1005Metric |  | NOT ACCEPTED FOR ASSEMBLY | Exact MPN, tolerance/derating, package/polarity and current/thermal review required
C1021 | 68p C0G 50V | VoiceVault_B0:C_0402_1005Metric |  | NOT ACCEPTED FOR ASSEMBLY | Exact MPN, tolerance/derating, package/polarity and current/thermal review required
C1022 | 68p C0G 50V | VoiceVault_B0:C_0402_1005Metric |  | NOT ACCEPTED FOR ASSEMBLY | Exact MPN, tolerance/derating, package/polarity and current/thermal review required
C1023 | 10p C0G 50V | VoiceVault_B0:C_0402_1005Metric |  | NOT ACCEPTED FOR ASSEMBLY | Exact MPN, tolerance/derating, package/polarity and current/thermal review required
C1024 | 10p C0G 50V | VoiceVault_B0:C_0402_1005Metric |  | NOT ACCEPTED FOR ASSEMBLY | Exact MPN, tolerance/derating, package/polarity and current/thermal review required
C1025 | 180p C0G 50V | VoiceVault_B0:C_0402_1005Metric |  | NOT ACCEPTED FOR ASSEMBLY | Exact MPN, tolerance/derating, package/polarity and current/thermal review required
C1026 | 180p C0G 50V | VoiceVault_B0:C_0402_1005Metric |  | NOT ACCEPTED FOR ASSEMBLY | Exact MPN, tolerance/derating, package/polarity and current/thermal review required
C1027 | 100n 10V | VoiceVault_B0:C_0402_1005Metric |  | NOT ACCEPTED FOR ASSEMBLY | Exact MPN, tolerance/derating, package/polarity and current/thermal review required
C1028 | 100n 10V | VoiceVault_B0:C_0402_1005Metric |  | NOT ACCEPTED FOR ASSEMBLY | Exact MPN, tolerance/derating, package/polarity and current/thermal review required
C1029 | 100n 10V | VoiceVault_B0:C_0402_1005Metric |  | NOT ACCEPTED FOR ASSEMBLY | Exact MPN, tolerance/derating, package/polarity and current/thermal review required
C1030 | 100n 10V | VoiceVault_B0:C_0402_1005Metric |  | NOT ACCEPTED FOR ASSEMBLY | Exact MPN, tolerance/derating, package/polarity and current/thermal review required
D501 | PMEG2010ER,115 | VoiceVault_B0:Nexperia_CFP3_SOD-123W | PMEG2010ER,115 | NOT ACCEPTED FOR ASSEMBLY | Exact package/revision, lifecycle, sourcing and assembly acceptance required
D502 | PMEG2010ER,115 | VoiceVault_B0:Nexperia_CFP3_SOD-123W | PMEG2010ER,115 | NOT ACCEPTED FOR ASSEMBLY | Exact package/revision, lifecycle, sourcing and assembly acceptance required
D503 | SMF5.0A | VoiceVault_B0:D_SOD-123F |  | NOT ACCEPTED FOR ASSEMBLY | Exact MPN, tolerance/derating, package/polarity and current/thermal review required
D601 | BAT54WS; DLDO to ALDO pop suppression | VoiceVault_B0:D_SOD-323 |  | NOT ACCEPTED FOR ASSEMBLY | Exact MPN, tolerance/derating, package/polarity and current/thermal review required
D602 | PESD5V0S1BA,115; bidirectional ESD | VoiceVault_B0:D_SOD-323 | PESD5V0S1BA,115 | NOT ACCEPTED FOR ASSEMBLY | Exact package/revision, lifecycle, sourcing and assembly acceptance required
D603 | PESD5V0S1BA,115; bidirectional ESD | VoiceVault_B0:D_SOD-323 | PESD5V0S1BA,115 | NOT ACCEPTED FOR ASSEMBLY | Exact package/revision, lifecycle, sourcing and assembly acceptance required
D604 | PESD5V0S1BA,115; bidirectional ESD | VoiceVault_B0:D_SOD-323 | PESD5V0S1BA,115 | NOT ACCEPTED FOR ASSEMBLY | Exact package/revision, lifecycle, sourcing and assembly acceptance required
D701 | BZT52H-C6V2,115; open-load clamp | VoiceVault_B0:D_SOD-123F | BZT52H-C6V2,115 | NOT ACCEPTED FOR ASSEMBLY | Exact package/revision, lifecycle, sourcing and assembly acceptance required
D901 | 1N4148WS-7-F | VoiceVault_B0:D_SOD-323 | 1N4148WS-7-F | NOT ACCEPTED FOR ASSEMBLY | Exact package/revision, lifecycle, sourcing and assembly acceptance required
D902 | 1N4148WS-7-F | VoiceVault_B0:D_SOD-323 | 1N4148WS-7-F | NOT ACCEPTED FOR ASSEMBLY | Exact package/revision, lifecycle, sourcing and assembly acceptance required
D903 | SMF13A | VoiceVault_B0:D_SOD-123F |  | NOT ACCEPTED FOR ASSEMBLY | Exact MPN, tolerance/derating, package/polarity and current/thermal review required
D904 | SMF13A | VoiceVault_B0:D_SOD-123F |  | NOT ACCEPTED FOR ASSEMBLY | Exact MPN, tolerance/derating, package/polarity and current/thermal review required
F501 | MF-PSMF050X-2 | VoiceVault_B0:Fuse_0805_2012Metric | MF-PSMF050X-2 | NOT ACCEPTED FOR ASSEMBLY | Exact package/revision, lifecycle, sourcing and assembly acceptance required
J101 | FTSH-107-01-L-DV / STDC14 | VoiceVault_B0:Samtec_FTSH-107-01-L-DV | FTSH-107-01-L-DV | NOT ACCEPTED FOR ASSEMBLY | Exact package/revision, lifecycle, sourcing and assembly acceptance required
J102 | FTSH-105-01-L-DV / radio SWD | VoiceVault_B0:Samtec_FTSH-105-01-L-DV | FTSH-105-01-L-DV | NOT ACCEPTED FOR ASSEMBLY | Exact package/revision, lifecycle, sourcing and assembly acceptance required
J401 | 1040310811 | VoiceVault_B0:microSD_HC_Molex_104031-0811 | 1040310811 | NOT ACCEPTED FOR ASSEMBLY | Exact package/revision, lifecycle, sourcing and assembly acceptance required
J501 | USB4125-GF-A | VoiceVault_B0:USB_C_Receptacle_GCT_USB4125-xx-x_6P_TopMnt_Horizontal |  | NOT ACCEPTED FOR ASSEMBLY | Exact MPN, tolerance/derating, package/polarity and current/thermal review required
J502 | S2B-PH-SM4-TB(LF)(SN); BATTERY | VoiceVault_B0:JST_PH_S2B-PH-SM4-TB_1x02-1MP_P2.00mm_Horizontal | S2B-PH-SM4-TB(LF)(SN) | NOT ACCEPTED FOR ASSEMBLY | Exact package/revision, lifecycle, sourcing and assembly acceptance required
J503 | BM02B-SRSS-TB(LF)(SN); EXTERNAL NTC | VoiceVault_B0:JST_SH_BM02B-SRSS-TB_1x02-1MP_P1.00mm_Vertical | BM02B-SRSS-TB(LF)(SN) | NOT ACCEPTED FOR ASSEMBLY | Exact package/revision, lifecycle, sourcing and assembly acceptance required
J601 | SJ-43514-SMT-TR; CTIA headset | VoiceVault_B0:SJ43514SMT | SJ-43514-SMT-TR | NOT ACCEPTED FOR ASSEMBLY | Exact package/revision, lifecycle, sourcing and assembly acceptance required
J701 | FH12-40S-0.5SH(55); TFT FFC | VoiceVault_B0:Hirose_FH12-40S-0.5SH_1x40-1MP_P0.50mm_Horizontal | FH12-40S-0.5SH(55) | NOT ACCEPTED FOR ASSEMBLY | Exact package/revision, lifecycle, sourcing and assembly acceptance required
J702 | 2005280060; TOUCH FFC | VoiceVault_B0:Molex_200528-0060_1x06-1MP_P1.00mm_Horizontal | 2005280060 | NOT ACCEPTED FOR ASSEMBLY | Exact package/revision, lifecycle, sourcing and assembly acceptance required
J801 | BM02B-SRSS-TB(LF)(SN); LRA | VoiceVault_B0:JST_SH_BM02B-SRSS-TB_1x02-1MP_P1.00mm_Vertical | BM02B-SRSS-TB(LF)(SN) | NOT ACCEPTED FOR ASSEMBLY | Exact package/revision, lifecycle, sourcing and assembly acceptance required
J901 | BM02B-SRSS-TB(LF)(SN); 760308101219 COIL | VoiceVault_B0:JST_SH_BM02B-SRSS-TB_1x02-1MP_P1.00mm_Vertical | BM02B-SRSS-TB(LF)(SN) | NOT ACCEPTED FOR ASSEMBLY | Exact package/revision, lifecycle, sourcing and assembly acceptance required
J902 | BM02B-SRSS-TB(LF)(SN); COIL NTC | VoiceVault_B0:JST_SH_BM02B-SRSS-TB_1x02-1MP_P1.00mm_Vertical | BM02B-SRSS-TB(LF)(SN) | NOT ACCEPTED FOR ASSEMBLY | Exact package/revision, lifecycle, sourcing and assembly acceptance required
J1001 | BM02B-SRSS-TB(LF)(SN); NFC ANTENNA | VoiceVault_B0:JST_SH_BM02B-SRSS-TB_1x02-1MP_P1.00mm_Vertical | BM02B-SRSS-TB(LF)(SN) | NOT ACCEPTED FOR ASSEMBLY | Exact package/revision, lifecycle, sourcing and assembly acceptance required
L1 | VLS252012HBX-2R2M-1 / 2.2uH | VoiceVault_B0:L_1008_2520Metric | VLS252012HBX-2R2M-1 | NOT ACCEPTED FOR ASSEMBLY | Exact package/revision, lifecycle, sourcing and assembly acceptance required
L2 | VLS252012HBX-2R2M-1 / 2.2uH | VoiceVault_B0:L_1008_2520Metric | VLS252012HBX-2R2M-1 | NOT ACCEPTED FOR ASSEMBLY | Exact package/revision, lifecycle, sourcing and assembly acceptance required
L8 | VLS252012HBX-2R2M-1 / 2.2uH | VoiceVault_B0:L_1008_2520Metric | VLS252012HBX-2R2M-1 | NOT ACCEPTED FOR ASSEMBLY | Exact package/revision, lifecycle, sourcing and assembly acceptance required
L201 | 3.3nH RF 5% | VoiceVault_B0:L_0201_0603Metric |  | NOT ACCEPTED FOR ASSEMBLY | Exact MPN, tolerance/derating, package/polarity and current/thermal review required
L202 | 2.7nH RF; VNA tune | VoiceVault_B0:L_0402_1005Metric |  | NOT ACCEPTED FOR ASSEMBLY | Exact MPN, tolerance/derating, package/polarity and current/thermal review required
L203 | 3.3nH RF; VNA tune | VoiceVault_B0:L_0402_1005Metric |  | NOT ACCEPTED FOR ASSEMBLY | Exact MPN, tolerance/derating, package/polarity and current/thermal review required
L701 | SRN4018-220M / 22uH | VoiceVault_B0:L_Bourns-SRN4018 | SRN4018-220M | NOT ACCEPTED FOR ASSEMBLY | Exact package/revision, lifecycle, sourcing and assembly acceptance required
L1001 | 270nH RF | VoiceVault_B0:L_0603_1608Metric |  | NOT ACCEPTED FOR ASSEMBLY | Exact MPN, tolerance/derating, package/polarity and current/thermal review required
L1002 | 270nH RF | VoiceVault_B0:L_0603_1608Metric |  | NOT ACCEPTED FOR ASSEMBLY | Exact MPN, tolerance/derating, package/polarity and current/thermal review required
Q2 | AO3401A (AOS) | VoiceVault_B0:SOT-23 | AO3401A | NOT ACCEPTED FOR ASSEMBLY | Exact package/revision, lifecycle, sourcing and assembly acceptance required
Q4 | AO3401A (AOS) | VoiceVault_B0:SOT-23 | AO3401A | NOT ACCEPTED FOR ASSEMBLY | Exact package/revision, lifecycle, sourcing and assembly acceptance required
Q201 | 2N7002 | VoiceVault_B0:SOT-23 |  | NOT ACCEPTED FOR ASSEMBLY | Exact MPN, tolerance/derating, package/polarity and current/thermal review required
Q901 | AO3401A (AOS) | VoiceVault_B0:SOT-23 | AO3401A | NOT ACCEPTED FOR ASSEMBLY | Exact package/revision, lifecycle, sourcing and assembly acceptance required
Q902 | 2N7002 | VoiceVault_B0:SOT-23 |  | NOT ACCEPTED FOR ASSEMBLY | Exact MPN, tolerance/derating, package/polarity and current/thermal review required
R5 | 2.2k 1% | VoiceVault_B0:R_0402_1005Metric |  | NOT ACCEPTED FOR ASSEMBLY | Exact MPN, tolerance/derating, package/polarity and current/thermal review required
R7 | 2.2k 1% | VoiceVault_B0:R_0402_1005Metric |  | NOT ACCEPTED FOR ASSEMBLY | Exact MPN, tolerance/derating, package/polarity and current/thermal review required
R12 | 330k 1% | VoiceVault_B0:R_0402_1005Metric |  | NOT ACCEPTED FOR ASSEMBLY | Exact MPN, tolerance/derating, package/polarity and current/thermal review required
R19 | 2.2k | VoiceVault_B0:R_0402_1005Metric |  | NOT ACCEPTED FOR ASSEMBLY | Exact MPN, tolerance/derating, package/polarity and current/thermal review required
R20 | 2.2k | VoiceVault_B0:R_0402_1005Metric |  | NOT ACCEPTED FOR ASSEMBLY | Exact MPN, tolerance/derating, package/polarity and current/thermal review required
R21 | 47k | VoiceVault_B0:R_0402_1005Metric |  | NOT ACCEPTED FOR ASSEMBLY | Exact MPN, tolerance/derating, package/polarity and current/thermal review required
R22 | 47k | VoiceVault_B0:R_0402_1005Metric |  | NOT ACCEPTED FOR ASSEMBLY | Exact MPN, tolerance/derating, package/polarity and current/thermal review required
R31 | 47k | VoiceVault_B0:R_0402_1005Metric |  | NOT ACCEPTED FOR ASSEMBLY | Exact MPN, tolerance/derating, package/polarity and current/thermal review required
R32 | 47k | VoiceVault_B0:R_0402_1005Metric |  | NOT ACCEPTED FOR ASSEMBLY | Exact MPN, tolerance/derating, package/polarity and current/thermal review required
R33 | 47k | VoiceVault_B0:R_0402_1005Metric |  | NOT ACCEPTED FOR ASSEMBLY | Exact MPN, tolerance/derating, package/polarity and current/thermal review required
R34 | 1k | VoiceVault_B0:R_0402_1005Metric |  | NOT ACCEPTED FOR ASSEMBLY | Exact MPN, tolerance/derating, package/polarity and current/thermal review required
R101 | 0R - VBAT from regulated rail | VoiceVault_B0:R_0402_1005Metric |  | NOT ACCEPTED FOR ASSEMBLY | Exact MPN, tolerance/derating, package/polarity and current/thermal review required
R102 | 330k 1% | VoiceVault_B0:R_0402_1005Metric |  | NOT ACCEPTED FOR ASSEMBLY | Exact MPN, tolerance/derating, package/polarity and current/thermal review required
R103 | 47k 1% | VoiceVault_B0:R_0402_1005Metric |  | NOT ACCEPTED FOR ASSEMBLY | Exact MPN, tolerance/derating, package/polarity and current/thermal review required
R104 | 47k 1% | VoiceVault_B0:R_0402_1005Metric |  | NOT ACCEPTED FOR ASSEMBLY | Exact MPN, tolerance/derating, package/polarity and current/thermal review required
R105 | 47k 1% | VoiceVault_B0:R_0402_1005Metric |  | NOT ACCEPTED FOR ASSEMBLY | Exact MPN, tolerance/derating, package/polarity and current/thermal review required
R106 | 1k | VoiceVault_B0:R_0402_1005Metric |  | NOT ACCEPTED FOR ASSEMBLY | Exact MPN, tolerance/derating, package/polarity and current/thermal review required
R201 | 100k | VoiceVault_B0:R_0402_1005Metric |  | NOT ACCEPTED FOR ASSEMBLY | Exact MPN, tolerance/derating, package/polarity and current/thermal review required
R202 | 47k | VoiceVault_B0:R_0402_1005Metric |  | NOT ACCEPTED FOR ASSEMBLY | Exact MPN, tolerance/derating, package/polarity and current/thermal review required
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
R906 | 100k 1% | VoiceVault_B0:R_0402_1005Metric |  | NOT ACCEPTED FOR ASSEMBLY | Exact MPN, tolerance/derating, package/polarity and current/thermal review required
R907 | ERJ-P08F2000V / 200R surge | VoiceVault_B0:R_1206_3216Metric | ERJ-P08F2000V | NOT ACCEPTED FOR ASSEMBLY | Exact package/revision, lifecycle, sourcing and assembly acceptance required
R908 | ERJ-P08F2000V / 200R surge | VoiceVault_B0:R_1206_3216Metric | ERJ-P08F2000V | NOT ACCEPTED FOR ASSEMBLY | Exact package/revision, lifecycle, sourcing and assembly acceptance required
R909 | 2.2k | VoiceVault_B0:R_0402_1005Metric |  | NOT ACCEPTED FOR ASSEMBLY | Exact MPN, tolerance/derating, package/polarity and current/thermal review required
R910 | 2.2k | VoiceVault_B0:R_0402_1005Metric |  | NOT ACCEPTED FOR ASSEMBLY | Exact MPN, tolerance/derating, package/polarity and current/thermal review required
R911 | 47k | VoiceVault_B0:R_0402_1005Metric |  | NOT ACCEPTED FOR ASSEMBLY | Exact MPN, tolerance/derating, package/polarity and current/thermal review required
R912 | 100k | VoiceVault_B0:R_0402_1005Metric |  | NOT ACCEPTED FOR ASSEMBLY | Exact MPN, tolerance/derating, package/polarity and current/thermal review required
R913 | 100k | VoiceVault_B0:R_0402_1005Metric |  | NOT ACCEPTED FOR ASSEMBLY | Exact MPN, tolerance/derating, package/polarity and current/thermal review required
R914 | 100k | VoiceVault_B0:R_0402_1005Metric |  | NOT ACCEPTED FOR ASSEMBLY | Exact MPN, tolerance/derating, package/polarity and current/thermal review required
R1001 | 100k | VoiceVault_B0:R_0402_1005Metric |  | NOT ACCEPTED FOR ASSEMBLY | Exact MPN, tolerance/derating, package/polarity and current/thermal review required
R1002 | 47k | VoiceVault_B0:R_0402_1005Metric |  | NOT ACCEPTED FOR ASSEMBLY | Exact MPN, tolerance/derating, package/polarity and current/thermal review required
R1003 | 2R 1% | VoiceVault_B0:R_0402_1005Metric |  | NOT ACCEPTED FOR ASSEMBLY | Exact MPN, tolerance/derating, package/polarity and current/thermal review required
R1004 | 2R 1% | VoiceVault_B0:R_0402_1005Metric |  | NOT ACCEPTED FOR ASSEMBLY | Exact MPN, tolerance/derating, package/polarity and current/thermal review required
R1005 | 100k | VoiceVault_B0:R_0402_1005Metric |  | NOT ACCEPTED FOR ASSEMBLY | Exact MPN, tolerance/derating, package/polarity and current/thermal review required
R1006 | 100k | VoiceVault_B0:R_0402_1005Metric |  | NOT ACCEPTED FOR ASSEMBLY | Exact MPN, tolerance/derating, package/polarity and current/thermal review required
SW301 | TL3305AF160QG | VoiceVault_B0:SW_SPST_TL3305A | TL3305AF160QG | NOT ACCEPTED FOR ASSEMBLY | Exact package/revision, lifecycle, sourcing and assembly acceptance required
SW302 | TL3305AF160QG | VoiceVault_B0:SW_SPST_TL3305A | TL3305AF160QG | NOT ACCEPTED FOR ASSEMBLY | Exact package/revision, lifecycle, sourcing and assembly acceptance required
SW503 | TL3305AF160QG; POWER | VoiceVault_B0:SW_SPST_TL3305A | TL3305AF160QG | NOT ACCEPTED FOR ASSEMBLY | Exact package/revision, lifecycle, sourcing and assembly acceptance required
SW601 | JS102011SAQN; physical microphone disconnect | VoiceVault_B0:SW_SPDT_CK_JS102011SAQN | JS102011SAQN | NOT ACCEPTED FOR ASSEMBLY | Exact package/revision, lifecycle, sourcing and assembly acceptance required
U1 | STM32U5G9ZJJ6Q | VoiceVault_B0:UFBGA-144_10x10mm_Layout12x12_P0.8mm | STM32U5G9ZJJ6Q | NOT ACCEPTED FOR ASSEMBLY | Exact package/revision, lifecycle, sourcing and assembly acceptance required
U3 | nPM1300-CAAA | VoiceVault_B0:nPM1300_CAAA_Nordic | nPM1300-CAAA | NOT ACCEPTED FOR ASSEMBLY | Exact package/revision, lifecycle, sourcing and assembly acceptance required
U4 | TPS3420DDRYR | VoiceVault_B0:Texas_USON-6_1x1.45mm_P0.5mm_SMD | TPS3420DDRYR | NOT ACCEPTED FOR ASSEMBLY | Exact package/revision, lifecycle, sourcing and assembly acceptance required
U5 | STWLC38JRM | VoiceVault_B0:STWLC38_WLCSP40_REVIEW | STWLC38JRM | NOT ACCEPTED FOR ASSEMBLY | Exact package/revision, lifecycle, sourcing and assembly acceptance required
U6 | nRF52832-CIAA | VoiceVault_B0:nRF52832_CIAA_Nordic | nRF52832-CIAA | NOT ACCEPTED FOR ASSEMBLY | Exact package/revision, lifecycle, sourcing and assembly acceptance required
U7 | ST25R3916B-BWLT | VoiceVault_B0:ST25R3916B_WLCSP36_REVIEW | ST25R3916B-BWLT | NOT ACCEPTED FOR ASSEMBLY | Exact package/revision, lifecycle, sourcing and assembly acceptance required
U8 | SLS32AIA010MKUSON10XTMA2 | VoiceVault_B0:OPTIGA_PG_USON10_2 | SLS32AIA010MKUSON10XTMA2 | NOT ACCEPTED FOR ASSEMBLY | Exact package/revision, lifecycle, sourcing and assembly acceptance required
U9 | TPS61062YZFR | VoiceVault_B0:TPS61062_YZF8_REVIEW | TPS61062YZFR | NOT ACCEPTED FOR ASSEMBLY | Exact package/revision, lifecycle, sourcing and assembly acceptance required
U10 | DRV2624YFFR | VoiceVault_B0:DRV2624_YFF9 | DRV2624YFFR | NOT ACCEPTED FOR ASSEMBLY | Exact package/revision, lifecycle, sourcing and assembly acceptance required
U11 | TROPIC01 - ordering revision pending | VoiceVault_B0:TROPIC01_QFN32_vendor |  | NOT ACCEPTED FOR ASSEMBLY | Exact MPN, tolerance/derating, package/polarity and current/thermal review required
U201 | SN74AXC4T774PWR | VoiceVault_B0:TSSOP-16_4.4x5mm_P0.65mm | SN74AXC4T774PWR | NOT ACCEPTED FOR ASSEMBLY | Exact package/revision, lifecycle, sourcing and assembly acceptance required
U202 | SN74AXC4T774PWR | VoiceVault_B0:TSSOP-16_4.4x5mm_P0.65mm | SN74AXC4T774PWR | NOT ACCEPTED FOR ASSEMBLY | Exact package/revision, lifecycle, sourcing and assembly acceptance required
U401 | TLV75533PDRVR | VoiceVault_B0:TI_DRV0006A_WSON6_2x2_EP1x1p6 | TLV75533PDRVR | NOT ACCEPTED FOR ASSEMBLY | Exact package/revision, lifecycle, sourcing and assembly acceptance required
U402 | SN74AXC4T774PWR | VoiceVault_B0:TSSOP-16_4.4x5mm_P0.65mm | SN74AXC4T774PWR | NOT ACCEPTED FOR ASSEMBLY | Exact package/revision, lifecycle, sourcing and assembly acceptance required
U601 | TLV320AIC3204IRHBR | VoiceVault_B0:QFN-32-1EP_5x5mm_P0.5mm_EP3.45x3.45mm | TLV320AIC3204IRHBR | NOT ACCEPTED FOR ASSEMBLY | Exact package/revision, lifecycle, sourcing and assembly acceptance required
U602 | TLV75533PDRVR | VoiceVault_B0:TI_DRV0006A_WSON6_2x2_EP1x1p6 | TLV75533PDRVR | NOT ACCEPTED FOR ASSEMBLY | Exact package/revision, lifecycle, sourcing and assembly acceptance required
U1001 | TLV75533PDRVR | VoiceVault_B0:TI_DRV0006A_WSON6_2x2_EP1x1p6 | TLV75533PDRVR | NOT ACCEPTED FOR ASSEMBLY | Exact package/revision, lifecycle, sourcing and assembly acceptance required
U1002 | SN74AXC4T774PWR | VoiceVault_B0:TSSOP-16_4.4x5mm_P0.65mm | SN74AXC4T774PWR | NOT ACCEPTED FOR ASSEMBLY | Exact package/revision, lifecycle, sourcing and assembly acceptance required
U1003 | SN74AXC4T774PWR | VoiceVault_B0:TSSOP-16_4.4x5mm_P0.65mm | SN74AXC4T774PWR | NOT ACCEPTED FOR ASSEMBLY | Exact package/revision, lifecycle, sourcing and assembly acceptance required
X201 | 830059597 / 32MHz CL10pF; load tuning required | VoiceVault_B0:Crystal_SMD_2016-4Pin_2.0x1.6mm | 830059597 | NOT ACCEPTED FOR ASSEMBLY | Exact package/revision, lifecycle, sourcing and assembly acceptance required
X202 | 830062558 / 32.768kHz CL9pF | VoiceVault_B0:Crystal_SMD_2012-2Pin_2.0x1.2mm | 830062558 | NOT ACCEPTED FOR ASSEMBLY | Exact package/revision, lifecycle, sourcing and assembly acceptance required
X301 | 830059597 / 32MHz CL10pF | VoiceVault_B0:Crystal_SMD_2016-4Pin_2.0x1.6mm | 830059597 | NOT ACCEPTED FOR ASSEMBLY | Exact package/revision, lifecycle, sourcing and assembly acceptance required
X302 | 830062558 / 32.768kHz CL9pF | VoiceVault_B0:Crystal_SMD_2012-2Pin_2.0x1.2mm | 830062558 | NOT ACCEPTED FOR ASSEMBLY | Exact package/revision, lifecycle, sourcing and assembly acceptance required
X1001 | 830108212709 / 27.12MHz CL8pF | VoiceVault_B0:Crystal_SMD_2016-4Pin_2.0x1.6mm | 830108212709 | NOT ACCEPTED FOR ASSEMBLY | Exact package/revision, lifecycle, sourcing and assembly acceptance required
