adlererik/voicevault/hardware/rev-b/core-parts.csv

Upstream reference | PDF page | Manufacturer | Upstream MPN | Upstream footprint name | Purpose | JLC part code | Sourcing status
U1 | 2 | STMicroelectronics | STM32U5G9ZJJ6Q | UFBGA144_STM | trusted MCU |  | QUOTE AND EXACT PACKAGE/REVISION CONFIRMATION REQUIRED
U3 | 5 | Nordic Semiconductor | nPM1300-CAAA | Nordic_WLCSP-35_308X238X50 | PMIC |  | QUOTE AND EXACT PACKAGE/REVISION CONFIRMATION REQUIRED
U4 | 5 | Texas Instruments | TPS3420DDRYR | FP-DRY0006A-MFG | push-button reset timer |  | QUOTE AND EXACT PACKAGE/REVISION CONFIRMATION REQUIRED
U5 | 6 | STMicroelectronics | STWLC38JRM | BGA40C40P5X8_213X333X57 | Qi receiver |  | QUOTE AND EXACT PACKAGE/REVISION CONFIRMATION REQUIRED
U6 | 9 | Nordic Semiconductor | nRF52832-CIAA | BGA50C40P7X8_295X322X50 | untrusted BLE controller |  | QUOTE AND EXACT PACKAGE/REVISION CONFIRMATION REQUIRED
U7 | 10 | STMicroelectronics | ST25R3916B-BWLT | WLCSP36_3P213X3P203_STM | NFC controller - retain as requested; VoiceVault use undecided |  | QUOTE AND EXACT PACKAGE/REVISION CONFIRMATION REQUIRED
U8 | 12 | Infineon | SLS32AIA010MKUSON10XTMA2 | PG-USON-10-2_B | OPTIGA Trust M |  | QUOTE AND EXACT PACKAGE/REVISION CONFIRMATION REQUIRED
U9 | 13 | Texas Instruments | TPS61062YZF | YZF0008AEAE | backlight driver |  | QUOTE AND EXACT PACKAGE/REVISION CONFIRMATION REQUIRED
U10 | 14 | Texas Instruments | DRV2624YFFR | BGA-9_1.47X1.47_B | haptic driver |  | QUOTE AND EXACT PACKAGE/REVISION CONFIRMATION REQUIRED
U11 | 11 | Tropic Square | TROPIC01 | QFN32_4x4_TROPIC | secure element - exact silicon/order code still needed |  | QUOTE AND EXACT PACKAGE/REVISION CONFIRMATION REQUIRED
