adlererik/voicevault/hardware/rev-b/upstream-inventory-DRAFT.csv

Source assembly | Source PDF page | Reference (DRAFT) | MPN from upstream metadata | Generic BOM reference | Upstream footprint identifier | Description | Review status
ts7_main_rev_d_sch | 2 | C1 |  | CAPC_12p_5%_50V_C0G | C_0402_B | Ceramic Capacitor | SOURCE MAPPING / PROCUREMENT REVIEW REQUIRED
ts7_main_rev_d_sch | 2 | C2 |  | CAPC_12p_5%_50V_C0G | C_0402_B | Ceramic Capacitor | SOURCE MAPPING / PROCUREMENT REVIEW REQUIRED
ts7_main_rev_d_sch | 2 | C3 |  | CAPC_12p_5%_50V_C0G | C_0402_B | Ceramic Capacitor | SOURCE MAPPING / PROCUREMENT REVIEW REQUIRED
ts7_main_rev_d_sch | 2 | C4 |  | CAPC_12p_5%_50V_C0G | C_0402_B | Ceramic Capacitor | SOURCE MAPPING / PROCUREMENT REVIEW REQUIRED
ts7_main_rev_d_sch | 2 | C5 |  | CAPC_100n_10%_6V3_X5R | C_0201_B | Ceramic Capacitor | SOURCE MAPPING / PROCUREMENT REVIEW REQUIRED
ts7_main_rev_d_sch | 2 | J10 | SQT-16Q1G |  | SQT-16Q1G-Footprint-1 | Spring contact | SOURCE MAPPING / PROCUREMENT REVIEW REQUIRED
ts7_main_rev_d_sch | 2 | R1 |  | RES_6k8_1%_50V | R_0402_B | Resistor | SOURCE MAPPING / PROCUREMENT REVIEW REQUIRED
ts7_main_rev_d_sch | 2 | R2 |  | RES_10k_1%_50V | R_0402_B | Resistor | SOURCE MAPPING / PROCUREMENT REVIEW REQUIRED
ts7_main_rev_d_sch | 2 | R3 |  | RES_2k2_1%_50V | R_0402_B | Resistor | SOURCE MAPPING / PROCUREMENT REVIEW REQUIRED
ts7_main_rev_d_sch | 2 | R4 |  | RES_2k2_1%_50V | R_0402_B | Resistor | SOURCE MAPPING / PROCUREMENT REVIEW REQUIRED
ts7_main_rev_d_sch | 2 | R5 |  | RES_2k2_1%_50V | R_0402_B | Resistor | SOURCE MAPPING / PROCUREMENT REVIEW REQUIRED
ts7_main_rev_d_sch | 2 | R6 |  | RES_2k2_1%_50V | R_0402_B | Resistor | SOURCE MAPPING / PROCUREMENT REVIEW REQUIRED
ts7_main_rev_d_sch | 2 | R7 |  | RES_2k2_1%_50V | R_0402_B | Resistor | SOURCE MAPPING / PROCUREMENT REVIEW REQUIRED
ts7_main_rev_d_sch | 2 | R8 |  | RES_2k2_1%_50V | R_0402_B | Resistor | SOURCE MAPPING / PROCUREMENT REVIEW REQUIRED
ts7_main_rev_d_sch | 2 | TP1 |  |  | TP_1.0mm | SMT test point | SOURCE MAPPING / PROCUREMENT REVIEW REQUIRED
ts7_main_rev_d_sch | 2 | TP2 |  |  | TP_1.0mm | SMT test point | SOURCE MAPPING / PROCUREMENT REVIEW REQUIRED
ts7_main_rev_d_sch | 2 | TP3 |  |  | TP_1.0mm | SMT test point | SOURCE MAPPING / PROCUREMENT REVIEW REQUIRED
ts7_main_rev_d_sch | 2 | TP4 |  |  | TP_1.0mm | SMT test point | SOURCE MAPPING / PROCUREMENT REVIEW REQUIRED
ts7_main_rev_d_sch | 2 | TP5 |  |  | TP_1.0mm | SMT test point | SOURCE MAPPING / PROCUREMENT REVIEW REQUIRED
ts7_main_rev_d_sch | 2 | TP6 |  |  | TP_1.0mm | SMT test point | SOURCE MAPPING / PROCUREMENT REVIEW REQUIRED
ts7_main_rev_d_sch | 2 | TP7 |  |  | TP_1.0mm | SMT test point | SOURCE MAPPING / PROCUREMENT REVIEW REQUIRED
ts7_main_rev_d_sch | 2 | TP12 |  |  | TP_1.0mm | SMT test point | SOURCE MAPPING / PROCUREMENT REVIEW REQUIRED
ts7_main_rev_d_sch | 2 | TP19 |  |  | TP_1.0mm | SMT test point | SOURCE MAPPING / PROCUREMENT REVIEW REQUIRED
ts7_main_rev_d_sch | 2 | TP20 |  |  | TP_1.0mm | SMT test point | SOURCE MAPPING / PROCUREMENT REVIEW REQUIRED
ts7_main_rev_d_sch | 2 | TP42 |  |  | TP_1.0mm | SMT test point | SOURCE MAPPING / PROCUREMENT REVIEW REQUIRED
ts7_main_rev_d_sch | 2 | TP43 |  |  | TP_1.0mm | SMT test point | SOURCE MAPPING / PROCUREMENT REVIEW REQUIRED
ts7_main_rev_d_sch | 2 | TP44 |  |  | TP_1.0mm | SMT test point | SOURCE MAPPING / PROCUREMENT REVIEW REQUIRED
ts7_main_rev_d_sch | 2 | TP49 |  |  | TP_0.8mm | SMT test point | SOURCE MAPPING / PROCUREMENT REVIEW REQUIRED
ts7_main_rev_d_sch | 2 | U1A | STM32U5G9ZJJ6Q |  | UFBGA144_STM | Advanced Graphics and Ultra Low Power CortexM-33 with Trustzone, NEOCHROM VG GPU, 160MHZ, with 3 MBSRAM and 4M of Flash. | SOURCE MAPPING / PROCUREMENT REVIEW REQUIRED
ts7_main_rev_d_sch | 2 | X1 |  |  | WE-XTAL_IQXC-42 | 830059597 WE-XTAL Quartz Crystal | SOURCE MAPPING / PROCUREMENT REVIEW REQUIRED
ts7_main_rev_d_sch | 2 | Y1 |  |  | WE-XTAL_IQXC-25 | 830062558 WE-XTAL Quartz Crystal | SOURCE MAPPING / PROCUREMENT REVIEW REQUIRED
ts7_main_rev_d_sch | 3 | C6 |  | CAPC_4u7_20%_6V3_X5R | C_0201_B | Ceramic Capacitor | SOURCE MAPPING / PROCUREMENT REVIEW REQUIRED
ts7_main_rev_d_sch | 3 | C7 |  | CAPC_100n_10%_6V3_X5R | C_0201_B | Ceramic Capacitor | SOURCE MAPPING / PROCUREMENT REVIEW REQUIRED
ts7_main_rev_d_sch | 3 | C8 |  | CAPC_100n_10%_6V3_X5R | C_0201_B | Ceramic Capacitor | SOURCE MAPPING / PROCUREMENT REVIEW REQUIRED
ts7_main_rev_d_sch | 3 | C9 |  | CAPC_100n_10%_6V3_X5R | C_0201_B | Ceramic Capacitor | SOURCE MAPPING / PROCUREMENT REVIEW REQUIRED
ts7_main_rev_d_sch | 3 | C10 |  | CAPC_100n_10%_6V3_X5R | C_0201_B | Ceramic Capacitor | SOURCE MAPPING / PROCUREMENT REVIEW REQUIRED
ts7_main_rev_d_sch | 3 | C11 |  | CAPC_100n_10%_6V3_X5R | C_0201_B | Ceramic Capacitor | SOURCE MAPPING / PROCUREMENT REVIEW REQUIRED
ts7_main_rev_d_sch | 3 | C12 |  | CAPC_100n_10%_6V3_X5R | C_0201_B | Ceramic Capacitor | SOURCE MAPPING / PROCUREMENT REVIEW REQUIRED
ts7_main_rev_d_sch | 3 | C13 |  | CAPC_100n_10%_6V3_X5R | C_0201_B | Ceramic Capacitor | SOURCE MAPPING / PROCUREMENT REVIEW REQUIRED
ts7_main_rev_d_sch | 3 | C14 |  | CAPC_100n_10%_6V3_X5R | C_0201_B | Ceramic Capacitor | SOURCE MAPPING / PROCUREMENT REVIEW REQUIRED
ts7_main_rev_d_sch | 3 | C15 |  | CAPC_4u7_20%_6V3_X5R | C_0201_B | Ceramic Capacitor | SOURCE MAPPING / PROCUREMENT REVIEW REQUIRED
ts7_main_rev_d_sch | 3 | C16 |  | CAPC_100n_10%_6V3_X5R | C_0201_B | Ceramic Capacitor | SOURCE MAPPING / PROCUREMENT REVIEW REQUIRED
ts7_main_rev_d_sch | 3 | C17 |  | CAPC_100n_10%_6V3_X5R | C_0201_B | Ceramic Capacitor | SOURCE MAPPING / PROCUREMENT REVIEW REQUIRED
ts7_main_rev_d_sch | 3 | C18 |  | CAPC_100n_10%_6V3_X5R | C_0201_B | Ceramic Capacitor | SOURCE MAPPING / PROCUREMENT REVIEW REQUIRED
ts7_main_rev_d_sch | 3 | C19 |  | CAPC_4u7_20%_6V3_X5R | C_0201_B | Ceramic Capacitor | SOURCE MAPPING / PROCUREMENT REVIEW REQUIRED
ts7_main_rev_d_sch | 3 | C20 |  | CAPC_100n_10%_6V3_X5R | C_0201_B | Ceramic Capacitor | SOURCE MAPPING / PROCUREMENT REVIEW REQUIRED
ts7_main_rev_d_sch | 3 | C21 |  | CAPC_100n_10%_6V3_X5R | C_0201_B | Ceramic Capacitor | SOURCE MAPPING / PROCUREMENT REVIEW REQUIRED
ts7_main_rev_d_sch | 3 | C22 |  | CAPC_100n_10%_6V3_X5R | C_0201_B | Ceramic Capacitor | SOURCE MAPPING / PROCUREMENT REVIEW REQUIRED
ts7_main_rev_d_sch | 3 | C23 |  | CAPC_100n_10%_6V3_X5R | C_0201_B | Ceramic Capacitor | SOURCE MAPPING / PROCUREMENT REVIEW REQUIRED
ts7_main_rev_d_sch | 3 | C24 |  | CAPC_100n_10%_6V3_X5R | C_0201_B | Ceramic Capacitor | SOURCE MAPPING / PROCUREMENT REVIEW REQUIRED
ts7_main_rev_d_sch | 3 | C25 |  | CAPC_10u_20%_10V_X5R | C_0402_B | Ceramic Capacitor | SOURCE MAPPING / PROCUREMENT REVIEW REQUIRED
ts7_main_rev_d_sch | 3 | C26 |  | CAPC_100n_10%_6V3_X5R | C_0402_B | Ceramic Capacitor | SOURCE MAPPING / PROCUREMENT REVIEW REQUIRED
ts7_main_rev_d_sch | 3 | C27 |  | CAPC_4u7_20%_6V3_X5R | C_0402_B | Ceramic Capacitor | SOURCE MAPPING / PROCUREMENT REVIEW REQUIRED
ts7_main_rev_d_sch | 3 | L1 |  | IND_2u2 | L_0603_B | Inductor | SOURCE MAPPING / PROCUREMENT REVIEW REQUIRED
ts7_main_rev_d_sch | 3 | TP13 |  |  | TP_1.0mm | SMT test point | SOURCE MAPPING / PROCUREMENT REVIEW REQUIRED
ts7_main_rev_d_sch | 3 | U1B | STM32U5G9ZJJ6Q |  | UFBGA144_STM | Advanced Graphics and Ultra Low Power CortexM-33 with Trustzone, NEOCHROM VG GPU, 160MHZ, with 3 MBSRAM and 4M of Flash. | SOURCE MAPPING / PROCUREMENT REVIEW REQUIRED
ts7_main_rev_d_sch | 4 | C28 |  | CAPC_4n7_5%_50V_X7R | C_0402_B | Ceramic Capacitor | SOURCE MAPPING / PROCUREMENT REVIEW REQUIRED
ts7_main_rev_d_sch | 4 | C29 |  | CAPC_4n7_5%_50V_X7R | C_0402_B | Ceramic Capacitor | SOURCE MAPPING / PROCUREMENT REVIEW REQUIRED
ts7_main_rev_d_sch | 4 | D4 |  |  | FP-DPY0002A-MFG | Trans Voltage Suppressor Diode, 90W, 5.5V V(RWM), Bidirectional, 1 Element, Silicon | SOURCE MAPPING / PROCUREMENT REVIEW REQUIRED
ts7_main_rev_d_sch | 4 | D5 |  |  | FP-DPY0002A-MFG | Trans Voltage Suppressor Diode, 90W, 5.5V V(RWM), Bidirectional, 1 Element, Silicon | SOURCE MAPPING / PROCUREMENT REVIEW REQUIRED
ts7_main_rev_d_sch | 4 | J1 | USB4720-03-A |  | GCT_USB4720-03-A_REVA | IP67 Type C USB 2.0 Connector | SOURCE MAPPING / PROCUREMENT REVIEW REQUIRED
ts7_main_rev_d_sch | 4 | R9 |  | RES_1M_1%_50V | R_0402_B | Resistor | SOURCE MAPPING / PROCUREMENT REVIEW REQUIRED
ts7_main_rev_d_sch | 4 | R10 |  | RES_1M_1%_50V | R_0402_B | Resistor | SOURCE MAPPING / PROCUREMENT REVIEW REQUIRED
ts7_main_rev_d_sch | 4 | TP14 |  |  | TP_1.0mm | SMT test point | SOURCE MAPPING / PROCUREMENT REVIEW REQUIRED
ts7_main_rev_d_sch | 4 | TP15 |  |  | TP_1.0mm | SMT test point | SOURCE MAPPING / PROCUREMENT REVIEW REQUIRED
ts7_main_rev_d_sch | 4 | TP16 |  |  | TP_1.0mm | SMT test point | SOURCE MAPPING / PROCUREMENT REVIEW REQUIRED
ts7_main_rev_d_sch | 4 | TP17 |  |  | TP_1.0mm | SMT test point | SOURCE MAPPING / PROCUREMENT REVIEW REQUIRED
ts7_main_rev_d_sch | 4 | TP18 |  |  | TP_1.0mm | SMT test point | SOURCE MAPPING / PROCUREMENT REVIEW REQUIRED
ts7_main_rev_d_sch | 4 | U2 |  |  | FP-RVZ0014A-MFG | Trans Voltage Suppressor Diode, 40W, 5.5V V(RWM), Unidirectional, 1 Element, Silicon | SOURCE MAPPING / PROCUREMENT REVIEW REQUIRED
ts7_main_rev_d_sch | 5 | C32 |  | CAPC_100n_10%_50V_X7R | C_0402_B | Ceramic Capacitor | SOURCE MAPPING / PROCUREMENT REVIEW REQUIRED
ts7_main_rev_d_sch | 5 | C33 |  | CAPC_10u_20%_10V_X5R | C_0402_B | Ceramic Capacitor | SOURCE MAPPING / PROCUREMENT REVIEW REQUIRED
ts7_main_rev_d_sch | 5 | C34 |  | CAPC_10u_20%_10V_X5R | C_0402_B | Ceramic Capacitor | SOURCE MAPPING / PROCUREMENT REVIEW REQUIRED
ts7_main_rev_d_sch | 5 | C35 |  | CAPC_100n_10%_50V_X7R | C_0402_B | Ceramic Capacitor | SOURCE MAPPING / PROCUREMENT REVIEW REQUIRED
ts7_main_rev_d_sch | 5 | C36 |  | CAPC_10u_20%_10V_X5R | C_0402_B | Ceramic Capacitor | SOURCE MAPPING / PROCUREMENT REVIEW REQUIRED
ts7_main_rev_d_sch | 5 | C37 |  | CAPC_100n_10%_50V_X7R | C_0402_B | Ceramic Capacitor | SOURCE MAPPING / PROCUREMENT REVIEW REQUIRED
ts7_main_rev_d_sch | 5 | C38 |  | CAPC_10u_20%_10V_X5R | C_0402_B | Ceramic Capacitor | SOURCE MAPPING / PROCUREMENT REVIEW REQUIRED
ts7_main_rev_d_sch | 5 | D1A | PMEG4010CPAS |  | DFN2020D-3 | Rectifier Diode, Schottky, 2 Element, 40V V(RRM), Silicon | SOURCE MAPPING / PROCUREMENT REVIEW REQUIRED
ts7_main_rev_d_sch | 5 | D1A | PMEG4010CPAS |  | DFN2020D-3 | Rectifier Diode, Schottky, 2 Element, 40V V(RRM), Silicon | SOURCE MAPPING / PROCUREMENT REVIEW REQUIRED
ts7_main_rev_d_sch | 5 | D6 | BAS521 | DREC_BAS521 | SOD523 | Rectifier Diode | SOURCE MAPPING / PROCUREMENT REVIEW REQUIRED
ts7_main_rev_d_sch | 5 | L2 |  | IND_2u2 | L_0603_B | Inductor | SOURCE MAPPING / PROCUREMENT REVIEW REQUIRED
ts7_main_rev_d_sch | 5 | Q1 | CSD13380F3 | MOSN_CSD13380F3 | FP-YJM003A-MFG | 12-V, N channel NexFET™ power MOSFET, single LGA 0.6 mm x 0.7 mm, 76 mOhm, gate ESD protection | SOURCE MAPPING / PROCUREMENT REVIEW REQUIRED
ts7_main_rev_d_sch | 5 | Q5 | CSD25501F3 |  | PICOSTAR3_YJN_TEX | -20-V, P channel NexFET™ power MOSFET, single LGA 0.6 mm x 0.7 mm, 76 mOhm, gate ESD protection | SOURCE MAPPING / PROCUREMENT REVIEW REQUIRED
ts7_main_rev_d_sch | 5 | R12 |  | RES_330k_1%_50V | R_0402_B | Resistor | SOURCE MAPPING / PROCUREMENT REVIEW REQUIRED
ts7_main_rev_d_sch | 5 | R13 |  | RES_47k_1%_50V | R_0402_B | Resistor | SOURCE MAPPING / PROCUREMENT REVIEW REQUIRED
ts7_main_rev_d_sch | 5 | R39 |  | RES_1M_1%_50V | R_0402_B | Resistor | SOURCE MAPPING / PROCUREMENT REVIEW REQUIRED
ts7_main_rev_d_sch | 5 | TP21 |  |  | TP_1.0mm | SMT test point | SOURCE MAPPING / PROCUREMENT REVIEW REQUIRED
ts7_main_rev_d_sch | 5 | TP22 |  |  | TP_1.0mm | SMT test point | SOURCE MAPPING / PROCUREMENT REVIEW REQUIRED
ts7_main_rev_d_sch | 5 | TP23 |  |  | TP_1.0mm | SMT test point | SOURCE MAPPING / PROCUREMENT REVIEW REQUIRED
ts7_main_rev_d_sch | 5 | TP24 |  |  | TP_1.0mm | SMT test point | SOURCE MAPPING / PROCUREMENT REVIEW REQUIRED
ts7_main_rev_d_sch | 5 | TP25 |  |  | TP_1.0mm | SMT test point | SOURCE MAPPING / PROCUREMENT REVIEW REQUIRED
ts7_main_rev_d_sch | 5 | TP26 |  |  | TP_1.0mm | SMT test point | SOURCE MAPPING / PROCUREMENT REVIEW REQUIRED
ts7_main_rev_d_sch | 5 | TP27 |  |  | TP_1.0mm | SMT test point | SOURCE MAPPING / PROCUREMENT REVIEW REQUIRED
ts7_main_rev_d_sch | 5 | U3 | nPM1300-CAAA |  | Nordic_WLCSP-35_308X238X50 | Li-Ion/Li-Polymer/LiFePo4 USB-C battery charger with high efficiency buck regulators, LDOs or load switches, LED drivers, TWI and VBUSOUT | SOURCE MAPPING / PROCUREMENT REVIEW REQUIRED
ts7_main_rev_d_sch | 5 | U4 | TPS3420DDRYR |  | FP-DRY0006A-MFG | Dual-channel push-button controller with configurable delay | SOURCE MAPPING / PROCUREMENT REVIEW REQUIRED
ts7_main_rev_d_sch | 6 | C39 |  | CAPC_10u_20%_10V_X5R | C_0402_B | Ceramic Capacitor | SOURCE MAPPING / PROCUREMENT REVIEW REQUIRED
ts7_main_rev_d_sch | 6 | C40 |  | CAPC_10u_20%_10V_X5R | C_0402_B | Ceramic Capacitor | SOURCE MAPPING / PROCUREMENT REVIEW REQUIRED
ts7_main_rev_d_sch | 6 | C41 |  | CAPC_22n_10%_50V_X7R | C_0402_B | Ceramic Capacitor | SOURCE MAPPING / PROCUREMENT REVIEW REQUIRED
ts7_main_rev_d_sch | 6 | C42 |  | CAPC_10n_10%_50V_X7R | C_0402_B | Ceramic Capacitor | SOURCE MAPPING / PROCUREMENT REVIEW REQUIRED
ts7_main_rev_d_sch | 6 | C43 |  | CAPC_47n_10%_50V_X7R | C_0402_B | Ceramic Capacitor | SOURCE MAPPING / PROCUREMENT REVIEW REQUIRED
ts7_main_rev_d_sch | 6 | C44 |  | CAPC_3n3_5%_50V_X7R | C_0402_B | Ceramic Capacitor | SOURCE MAPPING / PROCUREMENT REVIEW REQUIRED
ts7_main_rev_d_sch | 6 | C45 |  | CAPC_100n_10%_50V_X7R | C_0402_B | Ceramic Capacitor | SOURCE MAPPING / PROCUREMENT REVIEW REQUIRED
ts7_main_rev_d_sch | 6 | C46 |  | CAPC_100n_10%_50V_X7R | C_0402_B | Ceramic Capacitor | SOURCE MAPPING / PROCUREMENT REVIEW REQUIRED
ts7_main_rev_d_sch | 6 | C47 |  | CAPC_47n_10%_50V_X7R | C_0402_B | Ceramic Capacitor | SOURCE MAPPING / PROCUREMENT REVIEW REQUIRED
ts7_main_rev_d_sch | 6 | C48 |  | CAPC_4u7_20%_6V3_X5R | C_0402_B | Ceramic Capacitor | SOURCE MAPPING / PROCUREMENT REVIEW REQUIRED
ts7_main_rev_d_sch | 6 | C49 |  | CAPC_1u_10%_6V3_X5R | C_0402_B | Ceramic Capacitor | SOURCE MAPPING / PROCUREMENT REVIEW REQUIRED
ts7_main_rev_d_sch | 6 | C50 |  | CAPC_4u7_20%_25V_X5R | C_0402_B | Ceramic Capacitor | SOURCE MAPPING / PROCUREMENT REVIEW REQUIRED
ts7_main_rev_d_sch | 6 | C51 |  | CAPC_10n_10%_50V_X7R | C_0402_B | Ceramic Capacitor | SOURCE MAPPING / PROCUREMENT REVIEW REQUIRED
ts7_main_rev_d_sch | 6 | C52 |  | CAPC_22n_10%_50V_X7R | C_0402_B | Ceramic Capacitor | SOURCE MAPPING / PROCUREMENT REVIEW REQUIRED
ts7_main_rev_d_sch | 6 | NT1 |  |  | NETTIE 2W 03mm | Net Tie 2-way | SOURCE MAPPING / PROCUREMENT REVIEW REQUIRED
ts7_main_rev_d_sch | 6 | R14 |  | RES_100k_1%_50V | R_0402_B | Resistor | SOURCE MAPPING / PROCUREMENT REVIEW REQUIRED
ts7_main_rev_d_sch | 6 | R15 |  | RES_10k_1%_50V | R_0402_B | Resistor | SOURCE MAPPING / PROCUREMENT REVIEW REQUIRED
ts7_main_rev_d_sch | 6 | R16 |  | RES_10k_1%_50V | R_0402_B | Resistor | SOURCE MAPPING / PROCUREMENT REVIEW REQUIRED
ts7_main_rev_d_sch | 6 | R17 | CRCW0603200RFKEAHP | RES_200R_1%_75V | R_0603_B | Resistor | SOURCE MAPPING / PROCUREMENT REVIEW REQUIRED
ts7_main_rev_d_sch | 6 | TP28 |  |  | TP_1.0mm | SMT test point | SOURCE MAPPING / PROCUREMENT REVIEW REQUIRED
ts7_main_rev_d_sch | 6 | TP30 |  |  | TP_1.0mm | SMT test point | SOURCE MAPPING / PROCUREMENT REVIEW REQUIRED
ts7_main_rev_d_sch | 6 | U5 | STWLC38JRM |  | BGA40C40P5X8_213X333X57 | Qi-compliant inductive wireless power receiver for 15W applications | SOURCE MAPPING / PROCUREMENT REVIEW REQUIRED
ts7_main_rev_d_sch | 7 | J2 | BM28B0.6-6DS/2-0.35V(51) |  | BM28B0.6-6DS_2-0.35V | BM28 Series 0.35mm Pitch, 0.6mm Stacking Height, FPC-to-Board Connectors Supporting Up to 5A | SOURCE MAPPING / PROCUREMENT REVIEW REQUIRED
ts7_main_rev_d_sch | 7 | TP32 |  |  | TP_1.0mm | SMT test point | SOURCE MAPPING / PROCUREMENT REVIEW REQUIRED
ts7_main_rev_d_sch | 7 | TP33 |  |  | TP_1.0mm | SMT test point | SOURCE MAPPING / PROCUREMENT REVIEW REQUIRED
ts7_main_rev_d_sch | 8 | J3 | BM28B0.6-6DS/2-0.35V(51) |  | BM28B0.6-6DS_2-0.35V | BM28 Series 0.35mm Pitch, 0.6mm Stacking Height, FPC-to-Board Connectors Supporting Up to 5A | SOURCE MAPPING / PROCUREMENT REVIEW REQUIRED
ts7_main_rev_d_sch | 8 | TP29 |  |  | TP_0.8mm | SMT test point | SOURCE MAPPING / PROCUREMENT REVIEW REQUIRED
ts7_main_rev_d_sch | 8 | TP31 |  |  | TP_0.8mm | SMT test point | SOURCE MAPPING / PROCUREMENT REVIEW REQUIRED
ts7_main_rev_d_sch | 8 | TP47 |  |  | TP_0.8mm | SMT test point | SOURCE MAPPING / PROCUREMENT REVIEW REQUIRED
ts7_main_rev_d_sch | 8 | TP48 |  |  | TP_0.8mm | SMT test point | SOURCE MAPPING / PROCUREMENT REVIEW REQUIRED
ts7_main_rev_d_sch | 9 | A1 |  |  | 2450AT18B0100001E-Footprint-1 | RF/Microwave Antenna, 2400MHz Min, 2500MHz Max | SOURCE MAPPING / PROCUREMENT REVIEW REQUIRED
ts7_main_rev_d_sch | 9 | C30 |  | CAPC_DNP_5%_6V3_X7R | C_0201_B | Ceramic Capacitor | SOURCE MAPPING / PROCUREMENT REVIEW REQUIRED
ts7_main_rev_d_sch | 9 | C31 |  | CAPC_DNP_5%_6V3_X7R | C_0201_B | Ceramic Capacitor | SOURCE MAPPING / PROCUREMENT REVIEW REQUIRED
ts7_main_rev_d_sch | 9 | C53 |  | CAPC_2p2_5%_50V_C0G | C_0201_B | Ceramic Capacitor | SOURCE MAPPING / PROCUREMENT REVIEW REQUIRED
ts7_main_rev_d_sch | 9 | C57 |  | CAPC_15p_2%_50V_C0G | C_0402_B | Ceramic Capacitor | SOURCE MAPPING / PROCUREMENT REVIEW REQUIRED
ts7_main_rev_d_sch | 9 | C58 |  | CAPC_15p_2%_50V_C0G | C_0402_B | Ceramic Capacitor | SOURCE MAPPING / PROCUREMENT REVIEW REQUIRED
ts7_main_rev_d_sch | 9 | C59 |  | CAPC_100n_10%_6V3_X7R | C_0402_B | Ceramic Capacitor | SOURCE MAPPING / PROCUREMENT REVIEW REQUIRED
ts7_main_rev_d_sch | 9 | C60 |  | CAPC_100p_2%_50V_C0G | C_0402_B | Ceramic Capacitor | SOURCE MAPPING / PROCUREMENT REVIEW REQUIRED
ts7_main_rev_d_sch | 9 | C61 |  | CAPC_100p_2%_50V_C0G | C_0402_B | Ceramic Capacitor | SOURCE MAPPING / PROCUREMENT REVIEW REQUIRED
ts7_main_rev_d_sch | 9 | C62 |  | CAPC_1u_10%_6V3_X5R | C_0402_B | Ceramic Capacitor | SOURCE MAPPING / PROCUREMENT REVIEW REQUIRED
ts7_main_rev_d_sch | 9 | C63 |  | CAPC_100n_10%_6V3_X5R | C_0402_B | Ceramic Capacitor | SOURCE MAPPING / PROCUREMENT REVIEW REQUIRED
ts7_main_rev_d_sch | 9 | C64 |  | CAPC_100n_10%_6V3_X5R | C_0402_B | Ceramic Capacitor | SOURCE MAPPING / PROCUREMENT REVIEW REQUIRED
ts7_main_rev_d_sch | 9 | C65 |  | CAPC_4u7_20%_6V3_X5R | C_0402_B | Ceramic Capacitor | SOURCE MAPPING / PROCUREMENT REVIEW REQUIRED
ts7_main_rev_d_sch | 9 | C66 |  | CAPC_4u7_20%_6V3_X5R | C_0402_B | Ceramic Capacitor | SOURCE MAPPING / PROCUREMENT REVIEW REQUIRED
ts7_main_rev_d_sch | 9 | L4 |  | IND_1n | L_0201 | Inductor | SOURCE MAPPING / PROCUREMENT REVIEW REQUIRED
ts7_main_rev_d_sch | 9 | R40 |  | RES_100k_1%_50V | R_0402_B | Resistor | SOURCE MAPPING / PROCUREMENT REVIEW REQUIRED
ts7_main_rev_d_sch | 9 | R43 |  | RES_0R_1%_50V | R_0201 | Resistor | SOURCE MAPPING / PROCUREMENT REVIEW REQUIRED
ts7_main_rev_d_sch | 9 | R44 |  | RES_0R_1%_50V | R_0201 | Resistor | SOURCE MAPPING / PROCUREMENT REVIEW REQUIRED
ts7_main_rev_d_sch | 9 | TP34 |  |  | TP_1.0mm | SMT test point | SOURCE MAPPING / PROCUREMENT REVIEW REQUIRED
ts7_main_rev_d_sch | 9 | TP35 |  |  | TP_1.0mm | SMT test point | SOURCE MAPPING / PROCUREMENT REVIEW REQUIRED
ts7_main_rev_d_sch | 9 | TP36 |  |  | TP_1.0mm | SMT test point | SOURCE MAPPING / PROCUREMENT REVIEW REQUIRED
ts7_main_rev_d_sch | 9 | TP37 |  |  | TP_1.0mm | SMT test point | SOURCE MAPPING / PROCUREMENT REVIEW REQUIRED
ts7_main_rev_d_sch | 9 | U6 | nRF52832-CIAA |  | BGA50C40P7X8_295X322X50 | Multi-protocol Bluetooth Low Energy, ANT and 2.4GHz proprietary system-on-chip | SOURCE MAPPING / PROCUREMENT REVIEW REQUIRED
ts7_main_rev_d_sch | 9 | X2 |  |  | WE-XTAL_IQXC-42 | 830059597 WE-XTAL Quartz Crystal | SOURCE MAPPING / PROCUREMENT REVIEW REQUIRED
ts7_main_rev_d_sch | 10 | C67 |  | CAPC_2u2_20%_6V3_X5R | C_0402_B | Ceramic Capacitor | SOURCE MAPPING / PROCUREMENT REVIEW REQUIRED
ts7_main_rev_d_sch | 10 | C68 |  | CAPC_10n_10%_6V3_X5R | C_0402_B | Ceramic Capacitor | SOURCE MAPPING / PROCUREMENT REVIEW REQUIRED
ts7_main_rev_d_sch | 10 | C69 |  | CAPC_2u2_20%_6V3_X5R | C_0402_B | Ceramic Capacitor | SOURCE MAPPING / PROCUREMENT REVIEW REQUIRED
ts7_main_rev_d_sch | 10 | C70 |  | CAPC_10n_10%_6V3_X5R | C_0402_B | Ceramic Capacitor | SOURCE MAPPING / PROCUREMENT REVIEW REQUIRED
ts7_main_rev_d_sch | 10 | C71 |  | CAPC_150p_5%_50V_C0G | C_0402_B | Ceramic Capacitor | SOURCE MAPPING / PROCUREMENT REVIEW REQUIRED
ts7_main_rev_d_sch | 10 | C72 |  | CAPC_4u7_20%_6V3_X5R | C_0402_B | Ceramic Capacitor | SOURCE MAPPING / PROCUREMENT REVIEW REQUIRED
ts7_main_rev_d_sch | 10 | C73 |  | CAPC_10n_10%_6V3_X5R | C_0402_B | Ceramic Capacitor | SOURCE MAPPING / PROCUREMENT REVIEW REQUIRED
ts7_main_rev_d_sch | 10 | C75 |  | CAPC_22n_10%_50V_X7R | C_0402_B | Ceramic Capacitor | SOURCE MAPPING / PROCUREMENT REVIEW REQUIRED
ts7_main_rev_d_sch | 10 | C76 |  | CAPC_10p_5%_50V_C0G | C_0402_B | Ceramic Capacitor | SOURCE MAPPING / PROCUREMENT REVIEW REQUIRED
ts7_main_rev_d_sch | 10 | C77 |  | CAPC_680p_5%_50V_C0G | C_0402_B | Ceramic Capacitor | SOURCE MAPPING / PROCUREMENT REVIEW REQUIRED
ts7_main_rev_d_sch | 10 | C78 |  | CAPC_180p_5%_50V_C0G | C_0402_B | Ceramic Capacitor | SOURCE MAPPING / PROCUREMENT REVIEW REQUIRED
ts7_main_rev_d_sch | 10 | C79 |  | CAPC_2u2_20%_6V3_X5R | C_0402_B | Ceramic Capacitor | SOURCE MAPPING / PROCUREMENT REVIEW REQUIRED
ts7_main_rev_d_sch | 10 | C80 |  | CAPC_10n_10%_6V3_X5R | C_0402_B | Ceramic Capacitor | SOURCE MAPPING / PROCUREMENT REVIEW REQUIRED
ts7_main_rev_d_sch | 10 | C81 |  | CAPC_1u_10%_6V3_X5R | C_0402_B | Ceramic Capacitor | SOURCE MAPPING / PROCUREMENT REVIEW REQUIRED
ts7_main_rev_d_sch | 10 | C82 |  | CAPC_10n_10%_6V3_X5R | C_0402_B | Ceramic Capacitor | SOURCE MAPPING / PROCUREMENT REVIEW REQUIRED
ts7_main_rev_d_sch | 10 | C83 |  | CAPC_680p_5%_50V_C0G | C_0402_B | Ceramic Capacitor | SOURCE MAPPING / PROCUREMENT REVIEW REQUIRED
ts7_main_rev_d_sch | 10 | C84 |  | CAPC_180p_5%_50V_C0G | C_0402_B | Ceramic Capacitor | SOURCE MAPPING / PROCUREMENT REVIEW REQUIRED
ts7_main_rev_d_sch | 10 | C85 |  | CAPC_10p_5%_50V_C0G | C_0402_B | Ceramic Capacitor | SOURCE MAPPING / PROCUREMENT REVIEW REQUIRED
ts7_main_rev_d_sch | 10 | C86 |  | CAPC_150p_5%_50V_C0G | C_0402_B | Ceramic Capacitor | SOURCE MAPPING / PROCUREMENT REVIEW REQUIRED
ts7_main_rev_d_sch | 10 | C87 |  | CAPC_2u2_20%_6V3_X5R | C_0402_B | Ceramic Capacitor | SOURCE MAPPING / PROCUREMENT REVIEW REQUIRED
ts7_main_rev_d_sch | 10 | C88 |  | CAPC_10n_10%_6V3_X5R | C_0402_B | Ceramic Capacitor | SOURCE MAPPING / PROCUREMENT REVIEW REQUIRED
ts7_main_rev_d_sch | 10 | C89 |  | CAPC_10p_5%_50V_C0G | C_0402_B | Ceramic Capacitor | SOURCE MAPPING / PROCUREMENT REVIEW REQUIRED
ts7_main_rev_d_sch | 10 | C90 |  | CAPC_10p_5%_50V_C0G | C_0402_B | Ceramic Capacitor | SOURCE MAPPING / PROCUREMENT REVIEW REQUIRED
ts7_main_rev_d_sch | 10 | C105 |  | CAPC_68p_5%_50V_C0G | C_0402_B | Ceramic Capacitor | SOURCE MAPPING / PROCUREMENT REVIEW REQUIRED
ts7_main_rev_d_sch | 10 | C106 |  | CAPC_68p_5%_50V_C0G | C_0402_B | Ceramic Capacitor | SOURCE MAPPING / PROCUREMENT REVIEW REQUIRED
ts7_main_rev_d_sch | 10 | L5 |  | IND_270n | L_0402_B | Inductor | SOURCE MAPPING / PROCUREMENT REVIEW REQUIRED
ts7_main_rev_d_sch | 10 | L6 |  | IND_270n | L_0402_B | Inductor | SOURCE MAPPING / PROCUREMENT REVIEW REQUIRED
ts7_main_rev_d_sch | 10 | R18 |  | RES_47k_1%_50V | R_0402_B | Resistor | SOURCE MAPPING / PROCUREMENT REVIEW REQUIRED
ts7_main_rev_d_sch | 10 | R37 |  | RES_2R_1%_50V | R_0402_B | Resistor | SOURCE MAPPING / PROCUREMENT REVIEW REQUIRED
ts7_main_rev_d_sch | 10 | R38 |  | RES_2R_1%_50V | R_0402_B | Resistor | SOURCE MAPPING / PROCUREMENT REVIEW REQUIRED
ts7_main_rev_d_sch | 10 | U7 | ST25R3916B-BWLT |  | WLCSP36_3P213X3P203_STM | High performance NFC universal device and EMVCo reader | SOURCE MAPPING / PROCUREMENT REVIEW REQUIRED
ts7_main_rev_d_sch | 10 | X3 |  |  | WE-XTAL_IQXC-42 | 830108212709 WE-XTAL Quartz Crystal | SOURCE MAPPING / PROCUREMENT REVIEW REQUIRED
ts7_main_rev_d_sch | 11 | C101 |  | CAPC_100n_10%_50V_X5R | C_0402_B | Ceramic Capacitor | SOURCE MAPPING / PROCUREMENT REVIEW REQUIRED
ts7_main_rev_d_sch | 11 | C102 |  | CAPC_100n_10%_50V_X5R | C_0402_B | Ceramic Capacitor | SOURCE MAPPING / PROCUREMENT REVIEW REQUIRED
ts7_main_rev_d_sch | 11 | C103 |  | CAPC_100n_10%_50V_X5R | C_0402_B | Ceramic Capacitor | SOURCE MAPPING / PROCUREMENT REVIEW REQUIRED
ts7_main_rev_d_sch | 11 | C104 |  | CAPC_4u7_20%_6V3_X5R | C_0402_B | Ceramic Capacitor | SOURCE MAPPING / PROCUREMENT REVIEW REQUIRED
ts7_main_rev_d_sch | 11 | Q4 | CSD25501F3 |  | PICOSTAR3_YJN_TEX | -20-V, P channel NexFET™ power MOSFET, single LGA 0.6 mm x 0.7 mm, 76 mOhm, gate ESD protection | SOURCE MAPPING / PROCUREMENT REVIEW REQUIRED
ts7_main_rev_d_sch | 11 | R31 |  | RES_47k_1%_50V | R_0402_B | Resistor | SOURCE MAPPING / PROCUREMENT REVIEW REQUIRED
ts7_main_rev_d_sch | 11 | R32 |  | RES_47k_1%_50V | R_0402_B | Resistor | SOURCE MAPPING / PROCUREMENT REVIEW REQUIRED
ts7_main_rev_d_sch | 11 | R33 |  | RES_47k_1%_50V | R_0402_B | Resistor | SOURCE MAPPING / PROCUREMENT REVIEW REQUIRED
ts7_main_rev_d_sch | 11 | R34 |  | RES_47k_1%_50V | R_0402_B | Resistor | SOURCE MAPPING / PROCUREMENT REVIEW REQUIRED
ts7_main_rev_d_sch | 11 | R35 |  | RES_47k_1%_50V | R_0402_B | Resistor | SOURCE MAPPING / PROCUREMENT REVIEW REQUIRED
ts7_main_rev_d_sch | 11 | R36 |  | RES_47k_1%_50V | R_0402_B | Resistor | SOURCE MAPPING / PROCUREMENT REVIEW REQUIRED
ts7_main_rev_d_sch | 11 | TP9 |  |  | TP_1.0mm | SMT test point | SOURCE MAPPING / PROCUREMENT REVIEW REQUIRED
ts7_main_rev_d_sch | 11 | U11 | TROPIC01 |  | QFN32_4x4_TROPIC | Tropic01 secure element | SOURCE MAPPING / PROCUREMENT REVIEW REQUIRED
ts7_main_rev_d_sch | 12 | C91 |  | CAPC_100n_10%_50V_X5R | C_0402_B | Ceramic Capacitor | SOURCE MAPPING / PROCUREMENT REVIEW REQUIRED
ts7_main_rev_d_sch | 12 | C92 |  | CAPC_4u7_20%_6V3_X5R | C_0402_B | Ceramic Capacitor | SOURCE MAPPING / PROCUREMENT REVIEW REQUIRED
ts7_main_rev_d_sch | 12 | Q2 | CSD25501F3 |  | PICOSTAR3_YJN_TEX | -20-V, P channel NexFET™ power MOSFET, single LGA 0.6 mm x 0.7 mm, 76 mOhm, gate ESD protection | SOURCE MAPPING / PROCUREMENT REVIEW REQUIRED
ts7_main_rev_d_sch | 12 | R19 |  | RES_2k2_1%_50V | R_0402_B | Resistor | SOURCE MAPPING / PROCUREMENT REVIEW REQUIRED
ts7_main_rev_d_sch | 12 | R20 |  | RES_2k2_1%_50V | R_0402_B | Resistor | SOURCE MAPPING / PROCUREMENT REVIEW REQUIRED
ts7_main_rev_d_sch | 12 | R21 |  | RES_47k_1%_50V | R_0402_B | Resistor | SOURCE MAPPING / PROCUREMENT REVIEW REQUIRED
ts7_main_rev_d_sch | 12 | R22 |  | RES_47k_1%_50V | R_0402_B | Resistor | SOURCE MAPPING / PROCUREMENT REVIEW REQUIRED
ts7_main_rev_d_sch | 12 | TP8 |  |  | TP_1.0mm | SMT test point | SOURCE MAPPING / PROCUREMENT REVIEW REQUIRED
ts7_main_rev_d_sch | 12 | U8 | SLS32AIA010MKUSON10XTMA2 |  | PG-USON-10-2_B | Security controller / secure element USON-10 -40°C +85°C | SOURCE MAPPING / PROCUREMENT REVIEW REQUIRED
ts7_main_rev_d_sch | 13 | C93 |  | CAPC_100n_10%_50V_X5R | C_0402_B | Ceramic Capacitor | SOURCE MAPPING / PROCUREMENT REVIEW REQUIRED
ts7_main_rev_d_sch | 13 | C94 |  | CAPC_2u2_20%_10V_X5R | C_0402_B | Ceramic Capacitor | SOURCE MAPPING / PROCUREMENT REVIEW REQUIRED
ts7_main_rev_d_sch | 13 | C95 |  | CAPC_1u_10%_25V_X5R | C_0402_B | Ceramic Capacitor | SOURCE MAPPING / PROCUREMENT REVIEW REQUIRED
ts7_main_rev_d_sch | 13 | C96 |  | CAPC_4u7_20%_16V_X5R | C_0402_B | Ceramic Capacitor | SOURCE MAPPING / PROCUREMENT REVIEW REQUIRED
ts7_main_rev_d_sch | 13 | C97 |  | CAPC_4u7_20%_16V_X5R | C_0402_B | Ceramic Capacitor | SOURCE MAPPING / PROCUREMENT REVIEW REQUIRED
ts7_main_rev_d_sch | 13 | J5 | DF37B-24DS-0.4V(51) |  | DF37B-24DS-0.4V | DF37 Series 24 Position Board Mount 0.5 MM Straight Socket | SOURCE MAPPING / PROCUREMENT REVIEW REQUIRED
ts7_main_rev_d_sch | 13 | J9 | SQT-16Q1G |  | SQT-16Q1G-Footprint-1 | Spring contact | SOURCE MAPPING / PROCUREMENT REVIEW REQUIRED
ts7_main_rev_d_sch | 13 | L7 | SRN2510BTA-150M | IND_15u | SRN2510BTA | Inductor | SOURCE MAPPING / PROCUREMENT REVIEW REQUIRED
ts7_main_rev_d_sch | 13 | Q3 | CSD25501F3 |  | PICOSTAR3_YJN_TEX | -20-V, P channel NexFET™ power MOSFET, single LGA 0.6 mm x 0.7 mm, 76 mOhm, gate ESD protection | SOURCE MAPPING / PROCUREMENT REVIEW REQUIRED
ts7_main_rev_d_sch | 13 | R11 |  | RES_2k2_1%_50V | R_0402_B | Resistor | SOURCE MAPPING / PROCUREMENT REVIEW REQUIRED
ts7_main_rev_d_sch | 13 | R23 |  | RES_12R4_1%_50V | R_0402_B | Resistor | SOURCE MAPPING / PROCUREMENT REVIEW REQUIRED
ts7_main_rev_d_sch | 13 | R24 |  | RES_10k_1%_50V | R_0402_B | Resistor | SOURCE MAPPING / PROCUREMENT REVIEW REQUIRED
ts7_main_rev_d_sch | 13 | R25 |  | RES_47k_1%_50V | R_0402_B | Resistor | SOURCE MAPPING / PROCUREMENT REVIEW REQUIRED
ts7_main_rev_d_sch | 13 | R41 |  | RES_2k2_1%_50V | R_0402_B | Resistor | SOURCE MAPPING / PROCUREMENT REVIEW REQUIRED
ts7_main_rev_d_sch | 13 | R42 |  | RES_10k_1%_50V | R_0402_B | Resistor | SOURCE MAPPING / PROCUREMENT REVIEW REQUIRED
ts7_main_rev_d_sch | 13 | TP38 |  |  | TP_1.0mm | SMT test point | SOURCE MAPPING / PROCUREMENT REVIEW REQUIRED
ts7_main_rev_d_sch | 13 | TP39 |  |  | TP_1.0mm | SMT test point | SOURCE MAPPING / PROCUREMENT REVIEW REQUIRED
ts7_main_rev_d_sch | 13 | TP40 |  |  | TP_1.0mm | SMT test point | SOURCE MAPPING / PROCUREMENT REVIEW REQUIRED
ts7_main_rev_d_sch | 13 | TP45 |  |  | TP_1.0mm | SMT test point | SOURCE MAPPING / PROCUREMENT REVIEW REQUIRED
ts7_main_rev_d_sch | 13 | TP46 |  |  | TP_1.0mm | SMT test point | SOURCE MAPPING / PROCUREMENT REVIEW REQUIRED
ts7_main_rev_d_sch | 13 | U9 | TPS61062YZF |  | YZF0008AEAE | LED Driver, 1-Segment, PBGA8 | SOURCE MAPPING / PROCUREMENT REVIEW REQUIRED
ts7_main_rev_d_sch | 14 | C98 |  | CAPC_100n_10%_50V_X5R | C_0402_B | Ceramic Capacitor | SOURCE MAPPING / PROCUREMENT REVIEW REQUIRED
ts7_main_rev_d_sch | 14 | C99 |  | CAPC_100n_10%_50V_X5R | C_0402_B | Ceramic Capacitor | SOURCE MAPPING / PROCUREMENT REVIEW REQUIRED
ts7_main_rev_d_sch | 14 | J6 | SQT-16Q1G |  | SQT-16Q1G-Footprint-1 | Spring contact | SOURCE MAPPING / PROCUREMENT REVIEW REQUIRED
ts7_main_rev_d_sch | 14 | J7 | SQT-16Q1G |  | SQT-16Q1G-Footprint-1 | Spring contact | SOURCE MAPPING / PROCUREMENT REVIEW REQUIRED
ts7_main_rev_d_sch | 14 | R26 |  | RES_10k_1%_50V | R_0402_B | Resistor | SOURCE MAPPING / PROCUREMENT REVIEW REQUIRED
ts7_main_rev_d_sch | 14 | TP10 |  |  | TP_1.0mm | SMT test point | SOURCE MAPPING / PROCUREMENT REVIEW REQUIRED
ts7_main_rev_d_sch | 14 | TP41 |  |  | TP_1.0mm | SMT test point | SOURCE MAPPING / PROCUREMENT REVIEW REQUIRED
ts7_main_rev_d_sch | 14 | U10 | DRV2624YFFR |  | BGA-9_1.47X1.47_B | LRA/ERM Haptic Drive with waveform library, auto-resonance tracking, & low power consumption BGA9 - 0,4mm pitch | SOURCE MAPPING / PROCUREMENT REVIEW REQUIRED
ts7_main_rev_d_sch | 15 | C100 |  | CAPC_100n_10%_6V3_X5R | C_0402_B | Ceramic Capacitor | SOURCE MAPPING / PROCUREMENT REVIEW REQUIRED
ts7_main_rev_d_sch | 15 | J8 | BM28B0.6-6DS/2-0.35V(51) |  | BM28B0.6-6DS_2-0.35V | BM28 Series 0.35mm Pitch, 0.6mm Stacking Height, FPC-to-Board Connectors Supporting Up to 5A | SOURCE MAPPING / PROCUREMENT REVIEW REQUIRED
ts7_main_rev_d_sch | 15 | R27 |  | RES_100R_1%_50V | R_0402_B | Resistor | SOURCE MAPPING / PROCUREMENT REVIEW REQUIRED
ts7_main_rev_d_sch | 15 | R28 |  | RES_300R_1%_50V | R_0402_B | Resistor | SOURCE MAPPING / PROCUREMENT REVIEW REQUIRED
ts7_main_rev_d_sch | 15 | R29 |  | RES_68R_1%_50V | R_0402_B | Resistor | SOURCE MAPPING / PROCUREMENT REVIEW REQUIRED
ts7_main_rev_d_sch | 15 | R30 |  | RES_680R_1%_50V | R_0402_B | Resistor | SOURCE MAPPING / PROCUREMENT REVIEW REQUIRED
ts7_main_rev_d_sch | 15 | TP11 |  |  | TP_1.0mm | SMT test point | SOURCE MAPPING / PROCUREMENT REVIEW REQUIRED
ts7_fpc_ui_rev_d_sch | 1 | D1 |  |  | FP-APHF1608LSEEQBDZGKC-MFG | LED RGB CLEAR 4SMD | SOURCE MAPPING / PROCUREMENT REVIEW REQUIRED
ts7_fpc_ui_rev_d_sch | 1 | J1 | BM28B0.6-6DP/2-0.35V(51) |  | BM28B0.6-6DP_2-0.35V-Footprint-1 | BM28 Series 0.35mm Pitch, 0.6mm Stacking Height, FPC-to-Board Connectors Supporting Up to 5A | SOURCE MAPPING / PROCUREMENT REVIEW REQUIRED
ts7_fpc_ui_rev_d_sch | 1 | S1 | EVP6AWD40 |  | EVP6A | Operation switches for portable electronic equipment (Mobile phone, Portable audio). Low profile (0.6mm) and Small size (3.0 x 2.0mm). IP67 | SOURCE MAPPING / PROCUREMENT REVIEW REQUIRED
ts7_fpc_ant_rev_d_sch | 1 | J1 | BM28B0.6-6DP/2-0.35V(51) |  | BM28B0.6-6DP_2-0.35V-Footprint-1 | BM28 Series 0.35mm Pitch, 0.6mm Stacking Height, FPC-to-Board Connectors Supporting Up to 5A | SOURCE MAPPING / PROCUREMENT REVIEW REQUIRED
ts7_fpc_ant_rev_d_sch | 1 | R1 |  | RES_10k_1%_50V | R_0402_B | Resistor (NTC) | SOURCE MAPPING / PROCUREMENT REVIEW REQUIRED
