adlererik/voicevault/hardware/evidence/2026-11-13/quilter/native-repair/constraints/bga_components.csv

component | generate_fanout
U1 | false
U3 | false
U5 | false
U6 | false
U7 | false
U9 | false
U10 | false
