adlererik/voicevault/docs/assets/verification-results.png

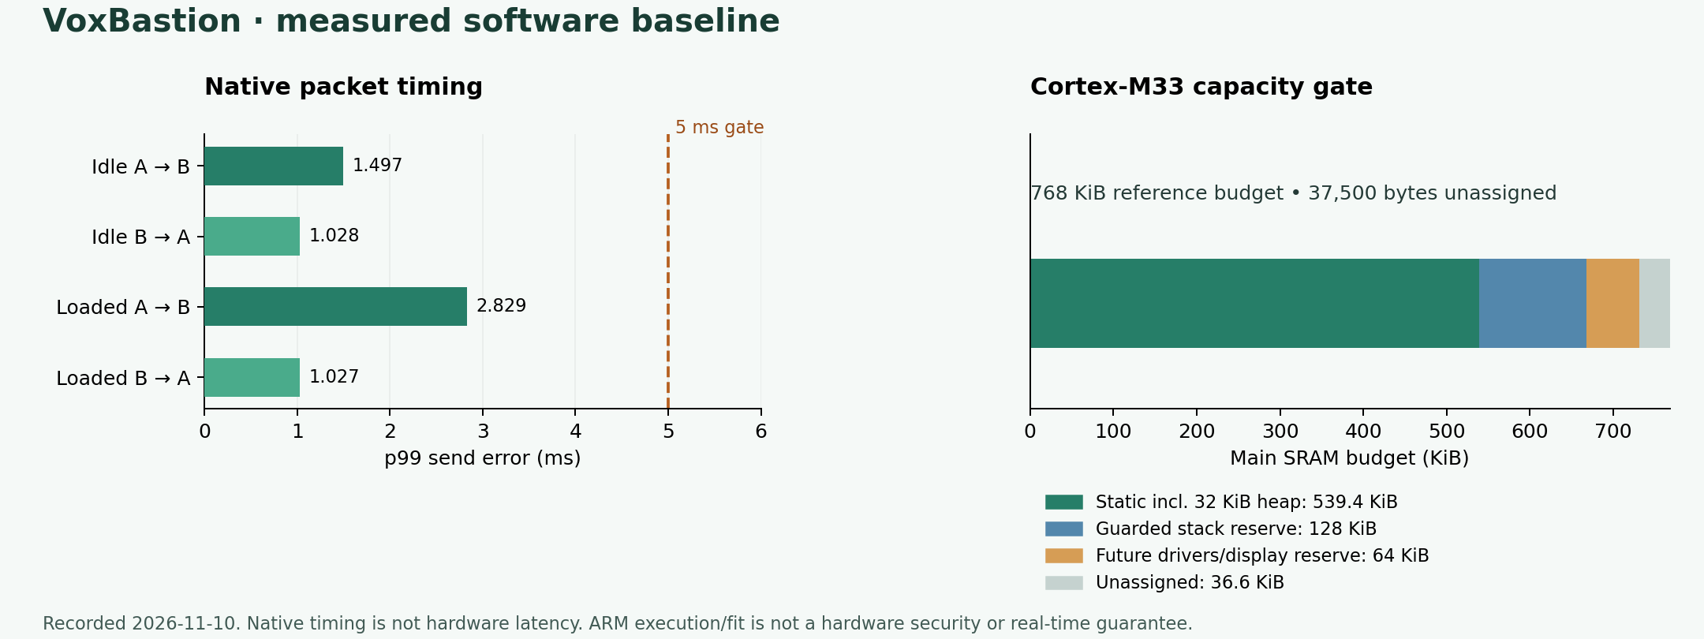
docs/assets/verification-results.png
