adlererik/voicevault/docs/assets/voicevault-verification.png

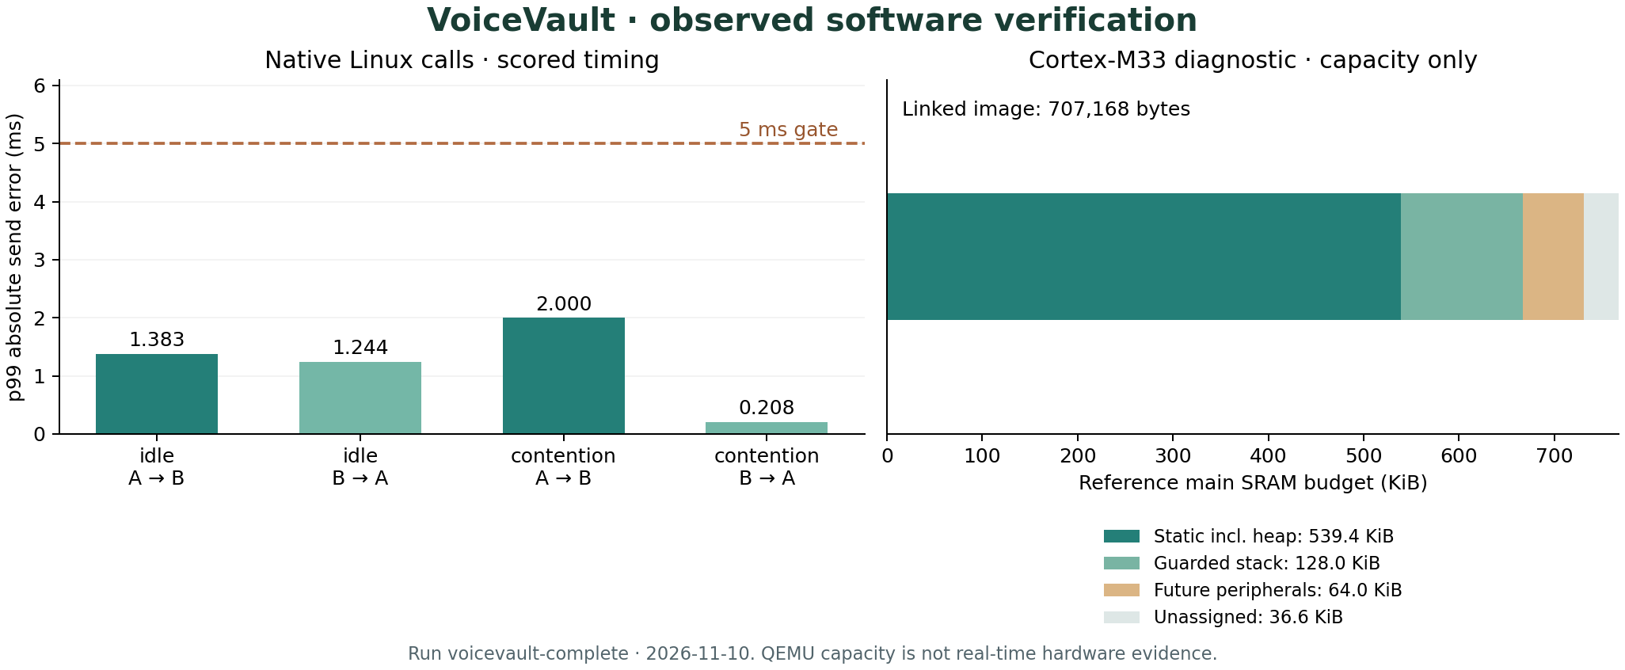
docs/assets/voicevault-verification.png
