adlererik/voicevault/docs/screenshots/phase2-tests-visible.jpg

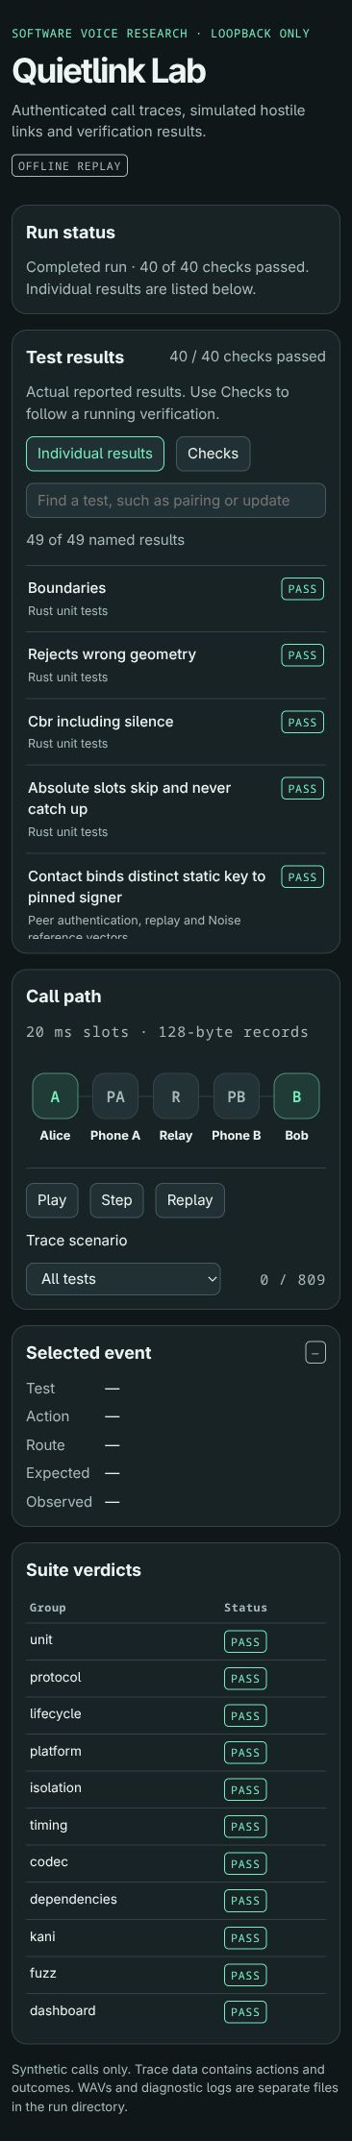
docs/screenshots/phase2-tests-visible.jpg
