adlererik/voicevault/docs/screenshots/voicevault-individual-results.png

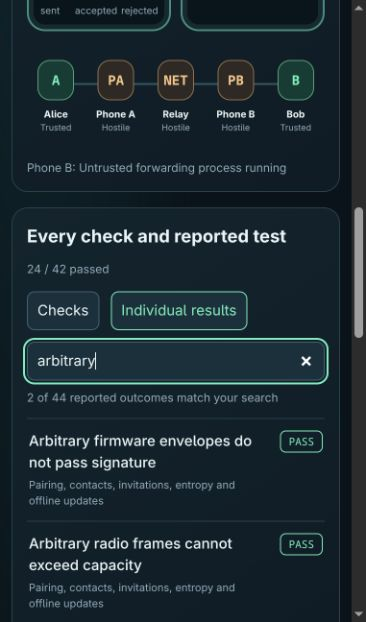
docs/screenshots/voicevault-individual-results.png
