adlererik/voicevault/hardware/evidence/2026-11-13/quilter/native-repair/circuit-settings-ui.txt

Browser tab: 3, Title: "Quilter - The PCB Compiler", URL: "https://app.quilter.ai/jobs/6af70fde5e1a5ebf38278f80/create/circuit-comprehension".
0 AXWebArea Quilter - The PCB Compiler, URL: app.quilter.ai/jobs/6af70fde5e1a5ebf38278f80/create/circuit-comprehension
	1 container
		2 container root
			3 container
				4 link app.quilter.ai/
				5 text Free Plan - For Noncommercial Use Only
				6 link Description: Terms, Value: quilter.ai/terms
				7 link Description: Request a demo, Value: quilter.ai/request-demo
				8 button Erik Adler
					9 image Erik Adler
			10 text Upload Files Stackup Fabricator Constraints Floorplan Circuit Comprehension Constraints Review and Submit
			11 container
				12 text Tell us about your design  —  Review and edit the information that Quilter will use when computing your board.
			13 heading Differential Pairs Download CSV Docs  0 to review, Value: 3
				14 button (collapsed) Differential Pairs Download CSV Docs  0 to review, Secondary Actions: Expand
					15 text Differential Pairs
					16 link Description: Download CSV, Value: app.quilter.ai/jobs/6af70fde5e1a5ebf38278f80/create/circuit-comprehension
					17 link Description: Docs , Value: docs.quilter.ai/differential_pairs
					18 text 0 to review
			19 heading Single-ended Impedance Signals Download CSV Docs  0 to review, Value: 3
				20 button (collapsed) Single-ended Impedance Signals Download CSV Docs  0 to review, Secondary Actions: Expand
					21 text Single-ended Impedance Signals
					22 link Description: Download CSV, Value: app.quilter.ai/jobs/6af70fde5e1a5ebf38278f80/create/circuit-comprehension
					23 link Description: Docs , Value: docs.quilter.ai/single_ended_impedance_signals
					24 text 0 to review
			25 container
				26 heading Power Nets Download CSV Docs  30 to review, Value: 3
					27 button (expanded) Power Nets Download CSV Docs  30 to review, Secondary Actions: Collapse
						28 text Power Nets
						29 link Description: Download CSV, Value: app.quilter.ai/jobs/6af70fde5e1a5ebf38278f80/create/circuit-comprehension
						30 link Description: Docs , Value: docs.quilter.ai/high_current_nets
						31 text 30 to review
				32 text Nets listed here will be sized according to the specified current with an allowable temperature rise of 20°C as defined in IPC-2221. Values may be specified using all common units (mA, A, etc), and will be converted to mA for internal calculations. Voltage drop simulation (BETA): Requires power pours. Optionally configure a source component and pin for resistance and voltage drop. Leave both blank to let Quilter calculate resistance using the worst pin pair and select the worst-case source for voltage drop. 1 to 10 of 30. Page 1 of 3
				33 table
					34 row Net Name Maximum Current (mA) Attempt Power Pour? Actions
						35 cell
							36 text Net Name
						37 cell
							38 text Maximum Current (mA)
						39 cell
							40 text Attempt Power Pour?
						41 cell
							42 text Actions
					43 container
						44 row (selectable) AUD_3V3_REG 250mA Press SPACE to toggle cell value (unchecked)  Remove this row
							45 cell
								46 text AUD_3V3_REG
							47 cell
								48 text 250mA
							49 cell
								50 checkbox (settable, integer) Description: Press SPACE to toggle cell value (unchecked), Value: 0, ID: ag-854-input
								51 text 
							52 cell
								53 button Remove this row
						54 row (selectable) AUD_AVDD_1V8 200mA Press SPACE to toggle cell value (unchecked)  Remove this row
							55 cell
								56 text AUD_AVDD_1V8
							57 cell
								58 text 200mA
							59 cell
								60 checkbox (settable, integer) Description: Press SPACE to toggle cell value (unchecked), Value: 0, ID: ag-856-input
								61 text 
							62 cell
								63 button Remove this row
						64 row (selectable) AUD_DVDD_1V72 50mA Press SPACE to toggle cell value (unchecked)  Remove this row
							65 cell
								66 text AUD_DVDD_1V72
							67 cell
								68 text 50mA
							69 cell
								70 checkbox (settable, integer) Description: Press SPACE to toggle cell value (unchecked), Value: 0, ID: ag-858-input
								71 text 
							72 cell
								73 button Remove this row
						74 row (selectable) AUD_LDOIN_3V3 250mA Press SPACE to toggle cell value (unchecked)  Remove this row
							75 cell
								76 text AUD_LDOIN_3V3
							77 cell
								78 text 250mA
							79 cell
								80 checkbox (settable, integer) Description: Press SPACE to toggle cell value (unchecked), Value: 0, ID: ag-860-input
								81 text 
							82 cell
								83 button Remove this row
						84 row (selectable) AUX_3V3 200mA Press SPACE to toggle cell value (unchecked)  Remove this row
							85 cell
								86 text AUX_3V3
							87 cell
								88 text 200mA
							89 cell
								90 checkbox (settable, integer) Description: Press SPACE to toggle cell value (unchecked), Value: 0, ID: ag-862-input
								91 text 
							92 cell
								93 button Remove this row
						94 row (selectable) MCU_VBAT_3V3 50mA Press SPACE to toggle cell value (unchecked)  Remove this row
							95 cell
								96 text MCU_VBAT_3V3
							97 cell
								98 text 50mA
							99 cell
								100 checkbox (settable, integer) Description: Press SPACE to toggle cell value (unchecked), Value: 0, ID: ag-864-input
								101 text 
							102 cell
								103 button Remove this row
						104 row (selectable) NFC_3V3 200mA Press SPACE to toggle cell value (unchecked)  Remove this row
							105 cell
								106 text NFC_3V3
							107 cell
								108 text 200mA
							109 cell
								110 checkbox (settable, integer) Description: Press SPACE to toggle cell value (unchecked), Value: 0, ID: ag-866-input
								111 text 
							112 cell
								113 button Remove this row
						114 row (selectable) OP_3V3 100mA Press SPACE to toggle cell value (unchecked)  Remove this row
							115 cell
								116 text OP_3V3
							117 cell
								118 text 100mA
							119 cell
								120 checkbox (settable, integer) Description: Press SPACE to toggle cell value (unchecked), Value: 0, ID: ag-868-input
								121 text 
							122 cell
								123 button Remove this row
						124 row (selectable) QI_5V 1000mA Press SPACE to toggle cell value (unchecked)  Remove this row
							125 cell
								126 text QI_5V
							127 cell
								128 text 1000mA
							129 cell
								130 checkbox (settable, integer) Description: Press SPACE to toggle cell value (unchecked), Value: 0, ID: ag-870-input
								131 text 
							132 cell
								133 button Remove this row
						134 row (selectable) QI_VAA_2V5 200mA Press SPACE to toggle cell value (unchecked)  Remove this row
							135 cell
								136 text QI_VAA_2V5
							137 cell
								138 text 200mA
							139 cell
								140 checkbox (settable, integer) Description: Press SPACE to toggle cell value (unchecked), Value: 0, ID: ag-872-input
								141 text 
							142 cell
								143 button Remove this row
				144 container ag-230
					145 text Page Size:
					146 combo box (collapsed) Description: Page Size, Value: 10, Secondary Actions: Expand
						147 text 10
					148 text 1
					149 text to
					150 text 10
					151 text of
					152 text 30
					153 button (disabled) First Page
					154 button (disabled) Previous Page
					155 text Page
					156 text 1
					157 text of
					158 text 3
					159 button Next Page
					160 button Last Page
				161 button Add Row
				162 button Add Multiple
				163 button Add By Netclass
				164 button Download CSV
				165 button Upload CSV
				166 button Remove all entries
			167 container
				168 heading Ground Nets Download CSV Docs  1 to review, Value: 3
					169 button (expanded) Ground Nets Download CSV Docs  1 to review, Secondary Actions: Collapse
						170 text Ground Nets
						171 link Description: Download CSV, Value: app.quilter.ai/jobs/6af70fde5e1a5ebf38278f80/create/circuit-comprehension
						172 link Description: Docs , Value: docs.quilter.ai/ground_nets
						173 text 1 to review
				174 text Ground nets provide return paths and reference planes for signals. The selected Primary Ground will be used for ground layers.
				175 content list
					176 container
						177 AXListMarker • 
						178 text Only one net can be marked as the Primary Ground (main ground layer)
					179 container
						180 AXListMarker • 
						181 text A net cannot be both a Primary Ground and use a Region Pour
				182 text The Region Pours option will attempt to create a ground plane in the shape of the containing Placement Region.
				183 content list
					184 container
						185 AXListMarker • 
						186 text The design MUST have at least one detected ground layer (check your stackup)
					187 container
						188 AXListMarker • 
						189 text Region pours only work if the placement region is manually placed within the board boundary
					190 container
						191 AXListMarker • 
						192 text Components using the ground net to be poured must be included in a placement region
				193 text No Rows To Show
				194 table
					195 row Net Name Primary Ground Use Region Pour Actions
						196 cell
							197 text Net Name
						198 cell
							199 text Primary Ground
						200 cell
							201 text Use Region Pour
						202 cell
							203 text Actions
					204 row (selectable) GND unchecked  Remove this row
						205 cell
							206 text GND
						207 cell
							208 radio button (settable, integer) 1
						209 cell
							210 checkbox (disabled, settable, integer) Description: unchecked, Value: 0, ID: ag-401-input
							211 text 
						212 cell
							213 button Remove this row
				214 button Add Row
				215 button Download CSV
				216 button Upload CSV
				217 button Remove all entries
			218 container
				219 heading Switching Converters Download CSV Docs  4 to review, Value: 3
					220 button (expanded) Switching Converters Download CSV Docs  4 to review, Secondary Actions: Collapse
						221 text Switching Converters
						222 link Description: Download CSV, Value: app.quilter.ai/jobs/6af70fde5e1a5ebf38278f80/create/circuit-comprehension
						223 link Description: Docs , Value: docs.quilter.ai/switching_converters
						224 text 4 to review
				225 text Switching converters added here will have input/output capacitors and inductors placed to minimize current return loops and prevent switching noise.
				226 text Designs may also benefit from adding the converter-inductor net to the Power Nets list and selecting the Attempt Power Pour option.
				227 text Note: Specifying input and output capacitors is optional. No Rows To Show
				228 table
					229 row Switching Converter Inductor Input Capacitor Output Capacitor Actions
						230 cell
							231 text Switching Converter
						232 cell
							233 text Inductor
						234 cell
							235 text Input Capacitor
						236 cell
							237 text Output Capacitor
						238 cell
							239 text Actions
					240 container
						241 row (selectable) U1 L1 C25 C107 Remove this row
							242 cell
								243 text U1
							244 cell
								245 text L1
							246 cell
								247 text C25
							248 cell
								249 text C107
							250 cell
								251 button Remove this row
						252 row (selectable) U3 L2 C33 C36 Remove this row
							253 cell
								254 text U3
							255 cell
								256 text L2
							257 cell
								258 text C33
							259 cell
								260 text C36
							261 cell
								262 button Remove this row
						263 row (selectable) U3 L8 C34 C113 Remove this row
							264 cell
								265 text U3
							266 cell
								267 text L8
							268 cell
								269 text C34
							270 cell
								271 text C113
							272 cell
								273 button Remove this row
						274 row (selectable) U9 L701 C704 C705 Remove this row
							275 cell
								276 text U9
							277 cell
								278 text L701
							279 cell
								280 text C704
							281 cell
								282 text C705
							283 cell
								284 button Remove this row
				285 button Add Row
				286 button Download CSV
				287 button Upload CSV
				288 button Remove all entries
			289 container
				290 heading Bypass Capacitors Download CSV Docs  115 to review, Value: 3
					291 button (expanded) Bypass Capacitors Download CSV Docs  115 to review, Secondary Actions: Collapse
						292 text Bypass Capacitors
						293 link Description: Download CSV, Value: app.quilter.ai/jobs/6af70fde5e1a5ebf38278f80/create/circuit-comprehension
						294 link Description: Docs , Value: docs.quilter.ai/bypass_capacitors
						295 text 115 to review
				296 text Capacitors listed here will be placed to minimize impedance between the capacitor and the pin. The most likely mistake in automatic detection is choosing the wrong pin on the parent component. You can correct any values by clicking a cell in the table. They will:
				297 content list
					298 container
						299 AXListMarker • 
						300 text Be placed as close as possible to the assigned pin
					301 container
						302 AXListMarker • 
						303 text Be placed in order of smallest to largest capacitance
					304 container
						305 AXListMarker • 
						306 text Use as few vias to connect to the pin as possible
				307 text BETA:  Detection confidence shows low, medium, or high confidence based on how we determined the parent component and pin. Low confidence entries (red) should be checked against your schematic while high confidence (green) are likely to be correct. Capacitance values may be specified using all common units (µF/uF, nF, etc), and will be converted to nF for internal calculations. 1 to 10 of 115. Page 1 of 12
				308 table
					309 row Capacitor Bypassed Component Bypassed Pin Capacitance (nF) Detection Confidence Actions
						310 cell
							311 text Capacitor
						312 cell
							313 text Bypassed Component
						314 cell
							315 text Bypassed Pin
						316 cell
							317 text Capacitance (nF)
						318 cell
							319 text Detection Confidence
						320 cell
							321 text Actions
					322 container
						323 row (selectable) C7 U1 H5 100nF Full confidence — set by you Remove this row
							324 cell
								325 text C7
							326 cell
								327 text U1
							328 cell
								329 text H5
							330 cell
								331 text 100nF
							332 cell
								333 container Full confidence — set by you
									334 text ✓
							335 cell
								336 button Remove this row
						337 row (selectable) C8 U1 G8 100nF Full confidence — set by you Remove this row
							338 cell
								339 text C8
							340 cell
								341 text U1
							342 cell
								343 text G8
							344 cell
								345 text 100nF
							346 cell
								347 container Full confidence — set by you
									348 text ✓
							349 cell
								350 button Remove this row
						351 row (selectable) C9 U1 E10 100nF Full confidence — set by you Remove this row
							352 cell
								353 text C9
							354 cell
								355 text U1
							356 cell
								357 text E10
							358 cell
								359 text 100nF
							360 cell
								361 container Full confidence — set by you
									362 text ✓
							363 cell
								364 button Remove this row
						365 row (selectable) C10 U1 F5 100nF Full confidence — set by you Remove this row
							366 cell
								367 text C10
							368 cell
								369 text U1
							370 cell
								371 text F5
							372 cell
								373 text 100nF
							374 cell
								375 container Full confidence — set by you
									376 text ✓
							377 cell
								378 button Remove this row
						379 row (selectable) C11 U1 M8 100nF Full confidence — set by you Remove this row
							380 cell
								381 text C11
							382 cell
								383 text U1
							384 cell
								385 text M8
							386 cell
								387 text 100nF
							388 cell
								389 container Full confidence — set by you
									390 text ✓
							391 cell
								392 button Remove this row
						393 row (selectable) C12 U1 H7 100nF Full confidence — set by you Remove this row
							394 cell
								395 text C12
							396 cell
								397 text U1
							398 cell
								399 text H7
							400 cell
								401 text 100nF
							402 cell
								403 container Full confidence — set by you
									404 text ✓
							405 cell
								406 button Remove this row
						407 row (selectable) C13 U1 D10 100nF Full confidence — set by you Remove this row
							408 cell
								409 text C13
							410 cell
								411 text U1
							412 cell
								413 text D10
							414 cell
								415 text 100nF
							416 cell
								417 container Full confidence — set by you
									418 text ✓
							419 cell
								420 button Remove this row
						421 row (selectable) C14 U1 J4 100nF Full confidence — set by you Remove this row
							422 cell
								423 text C14
							424 cell
								425 text U1
							426 cell
								427 text J4
							428 cell
								429 text 100nF
							430 cell
								431 container Full confidence — set by you
									432 text ✓
							433 cell
								434 button Remove this row
						435 row (selectable) C15 U1 H7 4700nF Full confidence — set by you Remove this row
							436 cell
								437 text C15
							438 cell
								439 text U1
							440 cell
								441 text H7
							442 cell
								443 text 4700nF
							444 cell
								445 container Full confidence — set by you
									446 text ✓
							447 cell
								448 button Remove this row
						449 row (selectable) C16 U1 E8 100nF Full confidence — set by you Remove this row
							450 cell
								451 text C16
							452 cell
								453 text U1
							454 cell
								455 text E8
							456 cell
								457 text 100nF
							458 cell
								459 container Full confidence — set by you
									460 text ✓
							461 cell
								462 button Remove this row
				463 container ag-267
					464 text Page Size:
					465 combo box (collapsed) Description: Page Size, Value: 10, Secondary Actions: Expand
						466 text 10
					467 text 1
					468 text to
					469 text 10
					470 text of
					471 text 115
					472 button (disabled) First Page
					473 button (disabled) Previous Page
					474 text Page
					475 text 1
					476 text of
					477 text 12
					478 button Next Page
					479 button Last Page
				480 button Add Row
				481 button Download CSV
				482 button Upload CSV
				483 button Remove all entries
			484 container
				485 heading Crystal Oscillators Download CSV Docs  5 to review, Value: 3
					486 button (expanded) Crystal Oscillators Download CSV Docs  5 to review, Secondary Actions: Collapse
						487 text Crystal Oscillators
						488 link Description: Download CSV, Value: app.quilter.ai/jobs/6af70fde5e1a5ebf38278f80/create/circuit-comprehension
						489 link Description: Docs , Value: docs.quilter.ai/crystal_oscillators
						490 text 5 to review
				491 text Oscillators listed here will be placed to minimize impedance between the oscillator and their parent's pins by placing them as close as possible to their assigned parent component. Connections will avoid using vias whenever possible. No Rows To Show
				492 table
					493 row Crystal Parent Parent Pin 1 Parent Pin 2 Actions
						494 cell
							495 text Crystal
						496 cell
							497 text Parent
						498 cell
							499 text Parent Pin 1
						500 cell
							501 text Parent Pin 2
						502 cell
							503 text Actions
					504 container
						505 row (selectable) X1001 U7 D6 C6 Remove this row
							506 cell
								507 text X1001
							508 cell
								509 text U7
							510 cell
								511 text D6
							512 cell
								513 text C6
							514 cell
								515 button Remove this row
						516 row (selectable) X201 U6 B2 A1 Remove this row
							517 cell
								518 text X201
							519 cell
								520 text U6
							521 cell
								522 text B2
							523 cell
								524 text A1
							525 cell
								526 button Remove this row
						527 row (selectable) X202 U6 D7 C7 Remove this row
							528 cell
								529 text X202
							530 cell
								531 text U6
							532 cell
								533 text D7
							534 cell
								535 text C7
							536 cell
								537 button Remove this row
						538 row (selectable) X301 U1 H2 J1 Remove this row
							539 cell
								540 text X301
							541 cell
								542 text U1
							543 cell
								544 text H2
							545 cell
								546 text J1
							547 cell
								548 button Remove this row
						549 row (selectable) X302 U1 C1 D2 Remove this row
							550 cell
								551 text X302
							552 cell
								553 text U1
							554 cell
								555 text C1
							556 cell
								557 text D2
							558 cell
								559 button Remove this row
				560 button Add Row
				561 button Download CSV
				562 button Upload CSV
				563 button Remove all entries
			564 container
				565 heading BGA Components Download CSV Docs  7 to review, Value: 3
					566 button (expanded) BGA Components Download CSV Docs  7 to review, Secondary Actions: Collapse
						567 text BGA Components
						568 link Description: Download CSV, Value: app.quilter.ai/jobs/6af70fde5e1a5ebf38278f80/create/circuit-comprehension
						569 link Description: Docs , Value: docs.quilter.ai/bga_components
						570 text 7 to review
				571 text BETA: May not be successful on all footprints, especially those with non-square pin grids. This table lists BGA-like components which typically have high pin densities and may require fanouts to be routed. The "Generate Fanout" option controls whether Quilter should attempt to generate a fanout pattern for the component's pins. Currently detects BGA, CSP, LGA, and PGA type footprints. You can also manually add any components that aren't detected that need a fanout. No Rows To Show
				572 table
					573 row Component Generate Fanout Actions
						574 cell
							575 text Component
						576 cell
							577 text Generate Fanout
						578 cell
							579 text Actions
					580 container
						581 row U1 Press SPACE to toggle cell value (unchecked)  Remove this row
							582 cell
								644 text U1
							583 cell
								584 checkbox (settable, integer) Description: Press SPACE to toggle cell value (unchecked), Value: 0, ID: ag-1395-input
								645 text 
							585 cell
								586 button Remove this row
						587 row U3 Press SPACE to toggle cell value (unchecked)  Remove this row
							588 cell
								646 text U3
							589 cell
								590 checkbox (settable, integer) Description: Press SPACE to toggle cell value (unchecked), Value: 0, ID: ag-1397-input
								647 text 
							591 cell
								592 button Remove this row
						593 row U5 Press SPACE to toggle cell value (unchecked)  Remove this row
							594 cell
								648 text U5
							595 cell
								596 checkbox (settable, integer) Description: Press SPACE to toggle cell value (unchecked), Value: 0, ID: ag-1399-input
								649 text 
							597 cell
								598 button Remove this row
						599 row U6 Press SPACE to toggle cell value (unchecked)  Remove this row
							600 cell
								650 text U6
							601 cell
								602 checkbox (settable, integer) Description: Press SPACE to toggle cell value (unchecked), Value: 0, ID: ag-1401-input
								651 text 
							603 cell
								604 button Remove this row
						605 row U7 Press SPACE to toggle cell value (unchecked)  Remove this row
							606 cell
								652 text U7
							607 cell
								608 checkbox (settable, integer) Description: Press SPACE to toggle cell value (unchecked), Value: 0, ID: ag-1403-input
								653 text 
							609 cell
								610 button Remove this row
						611 row U9 Press SPACE to toggle cell value (unchecked)  Remove this row
							612 cell
								654 text U9
							613 cell
								614 checkbox (settable, integer) Description: Press SPACE to toggle cell value (unchecked), Value: 0, ID: ag-1405-input
								655 text 
							615 cell
								616 button Remove this row
						617 row U10 Press SPACE to toggle cell value (unchecked)  Remove this row
							618 cell
								656 text U10
							619 cell
								620 checkbox (settable, integer) Description: Press SPACE to toggle cell value (unchecked), Value: 0, ID: ag-1407-input
								657 text 
							621 cell
								622 button Remove this row
				623 button Add Row
				624 button Download CSV
				625 button Upload CSV
				626 button Remove all entries
			627 container
				628 link Description: Back, Value: app.quilter.ai/jobs/6af70fde5e1a5ebf38278f80/create/floorplan
				629 button Continue
			630 container
				631 button Expand console
					632 text CONSOLE
				633 text 6 info
			634 text UI:  1.51.0  |  API:  1.51.0 | Copyright © 
			635 link Description: Quilter, Value: quilter.ai/
			636 text 2026 .
		637 container
			638 container Open Intercom Messenger, 1 new message
				639 AXWebArea Intercom Live Chat, URL: about:blank
					640 container Description: Intercom, ID: intercom-container
						641 container Intercom Messenger
							642 button (collapsed) Description: Open Intercom Messenger, 1 new message, Secondary Actions: Expand
			643 text 1

The focused UI element is 625 button Upload CSV
