adlererik/voicevault/(list of files, drawings)

Other design files:
hardware/evidence/2026-11-12/autoroute/voicevault.dsn
