adlererik/voicevault/hardware/rev-b/voicevault-standalone-b0.kicad_pcb

## KiCad design hardware/rev-b/voicevault-standalone-b0.kicad_pcb (2026-11-12)

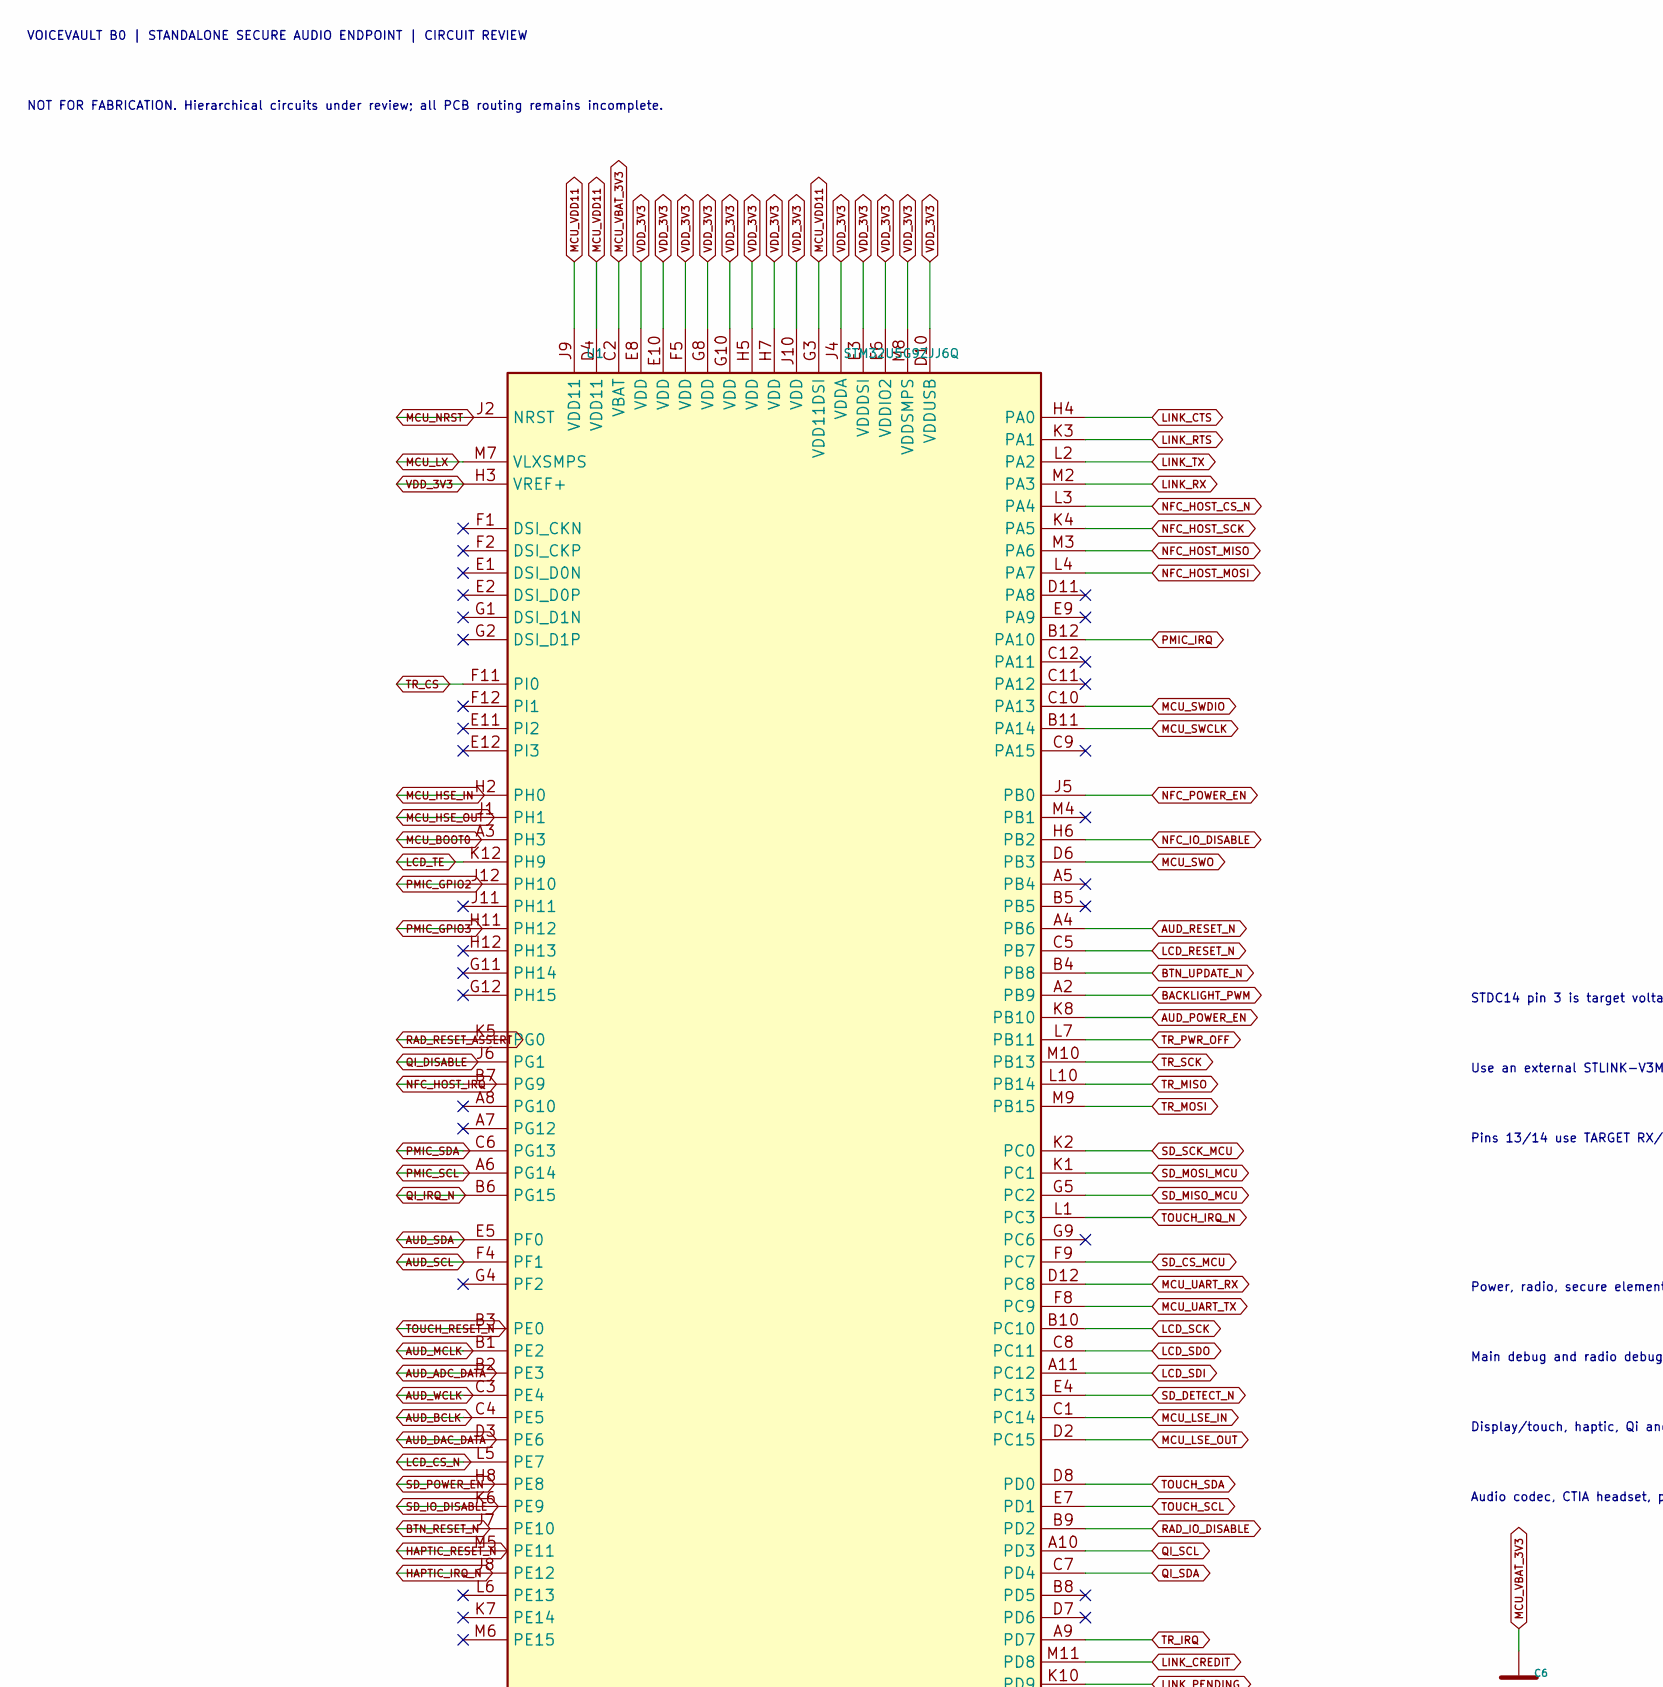
[picture p27: schematic voicevault-standalone-b0.kicad_sch, VoiceVault B0 - standalone circuit review, part in row 1, column 1]

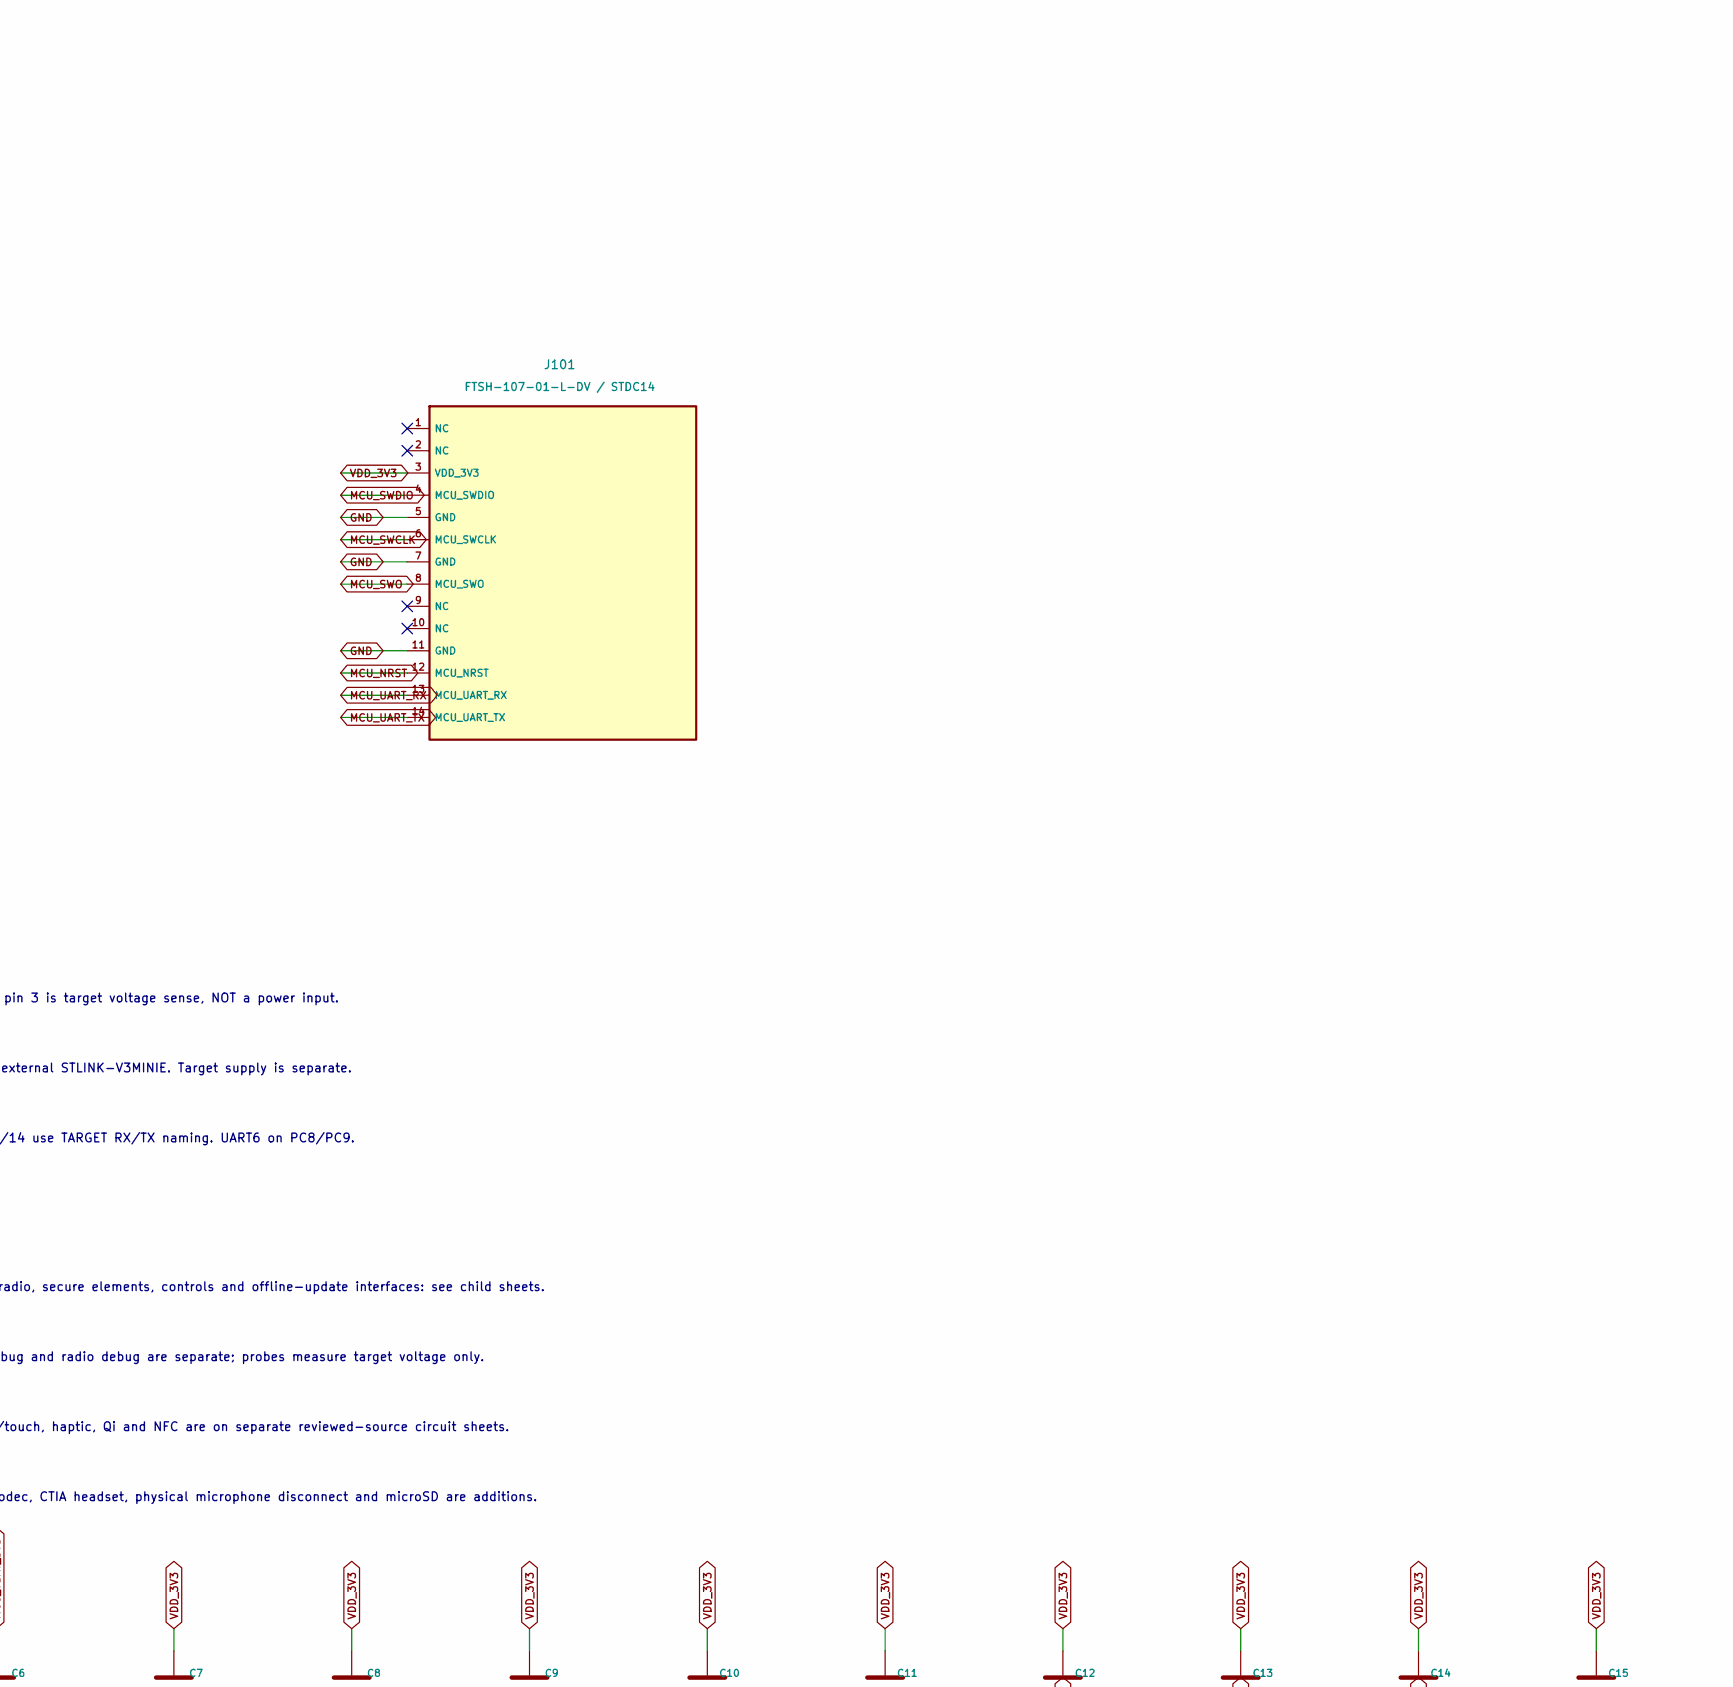
[picture p28: schematic voicevault-standalone-b0.kicad_sch, VoiceVault B0 - standalone circuit review, part in row 1, column 2]

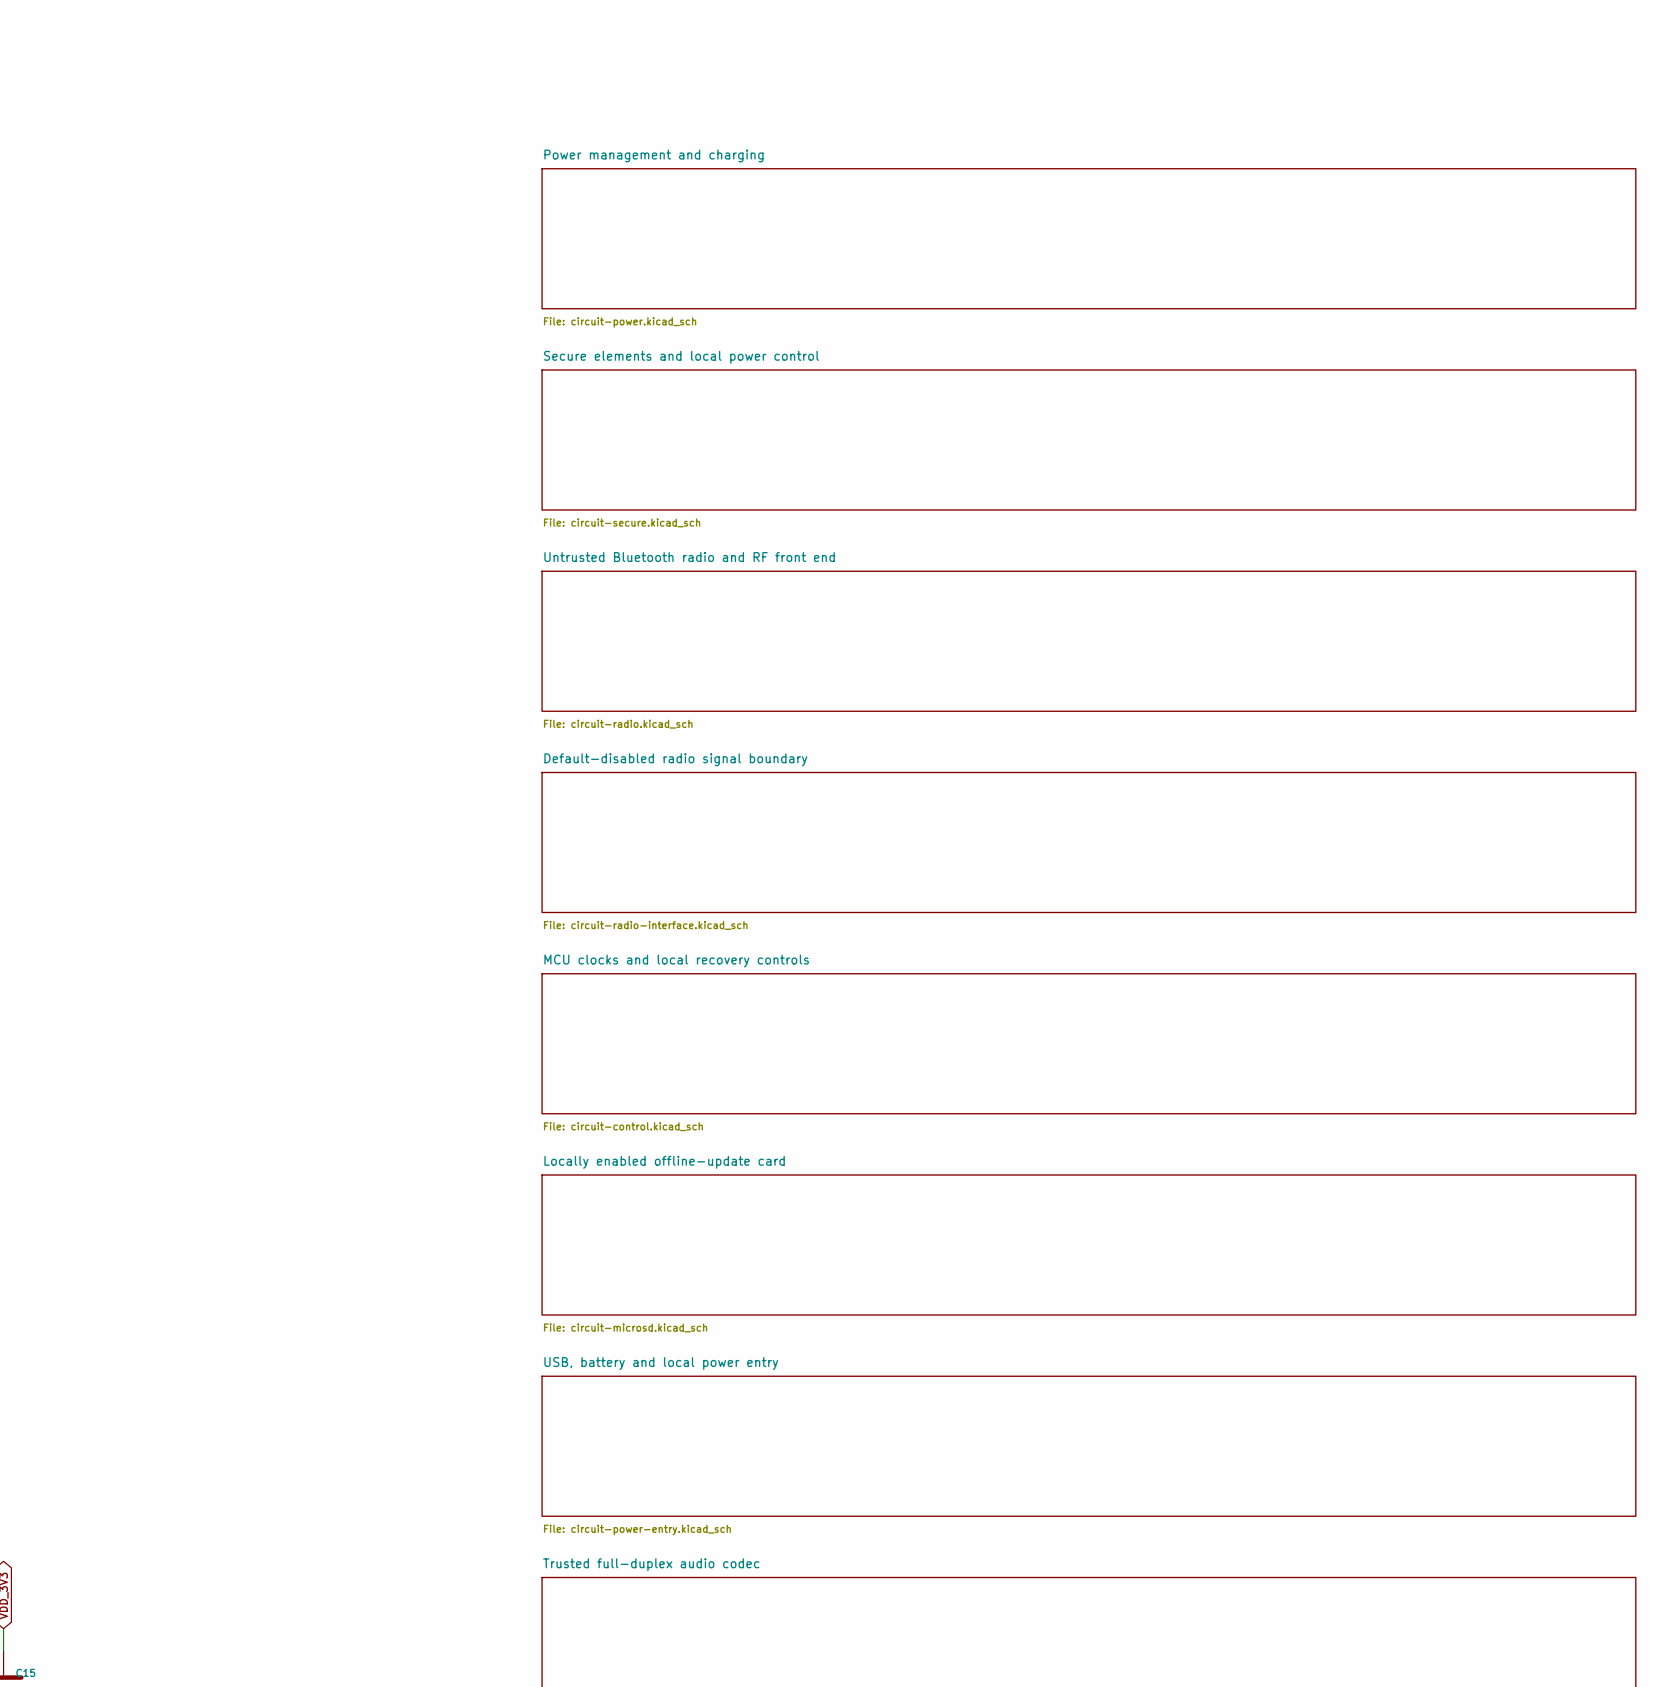
[picture p29: schematic voicevault-standalone-b0.kicad_sch, VoiceVault B0 - standalone circuit review, part in row 1, column 3]

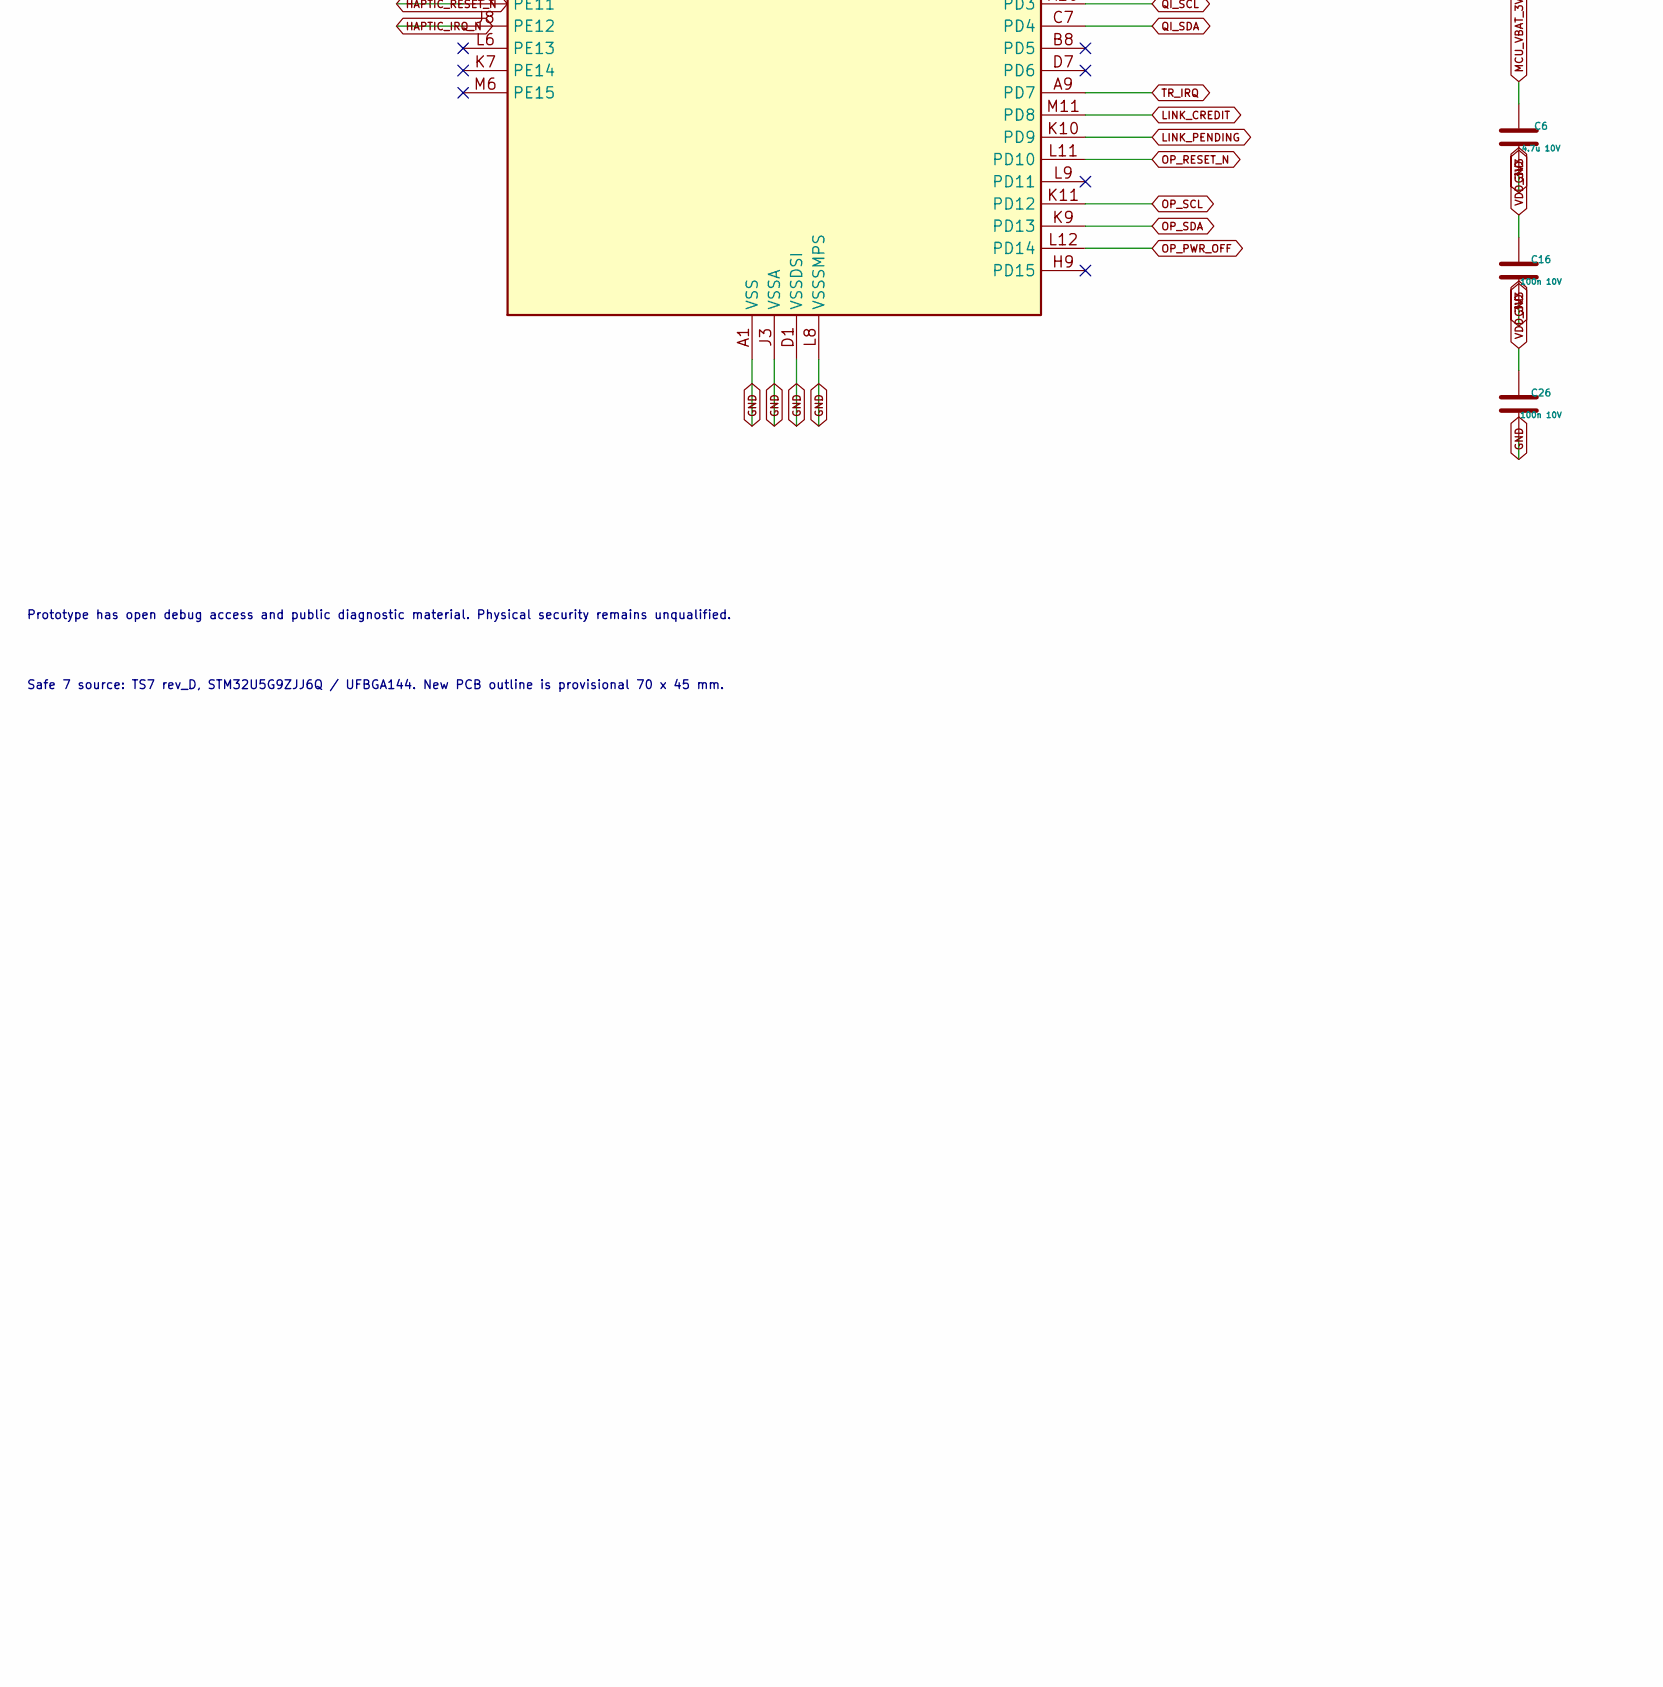
[picture p30: schematic voicevault-standalone-b0.kicad_sch, VoiceVault B0 - standalone circuit review, part in row 2, column 1]

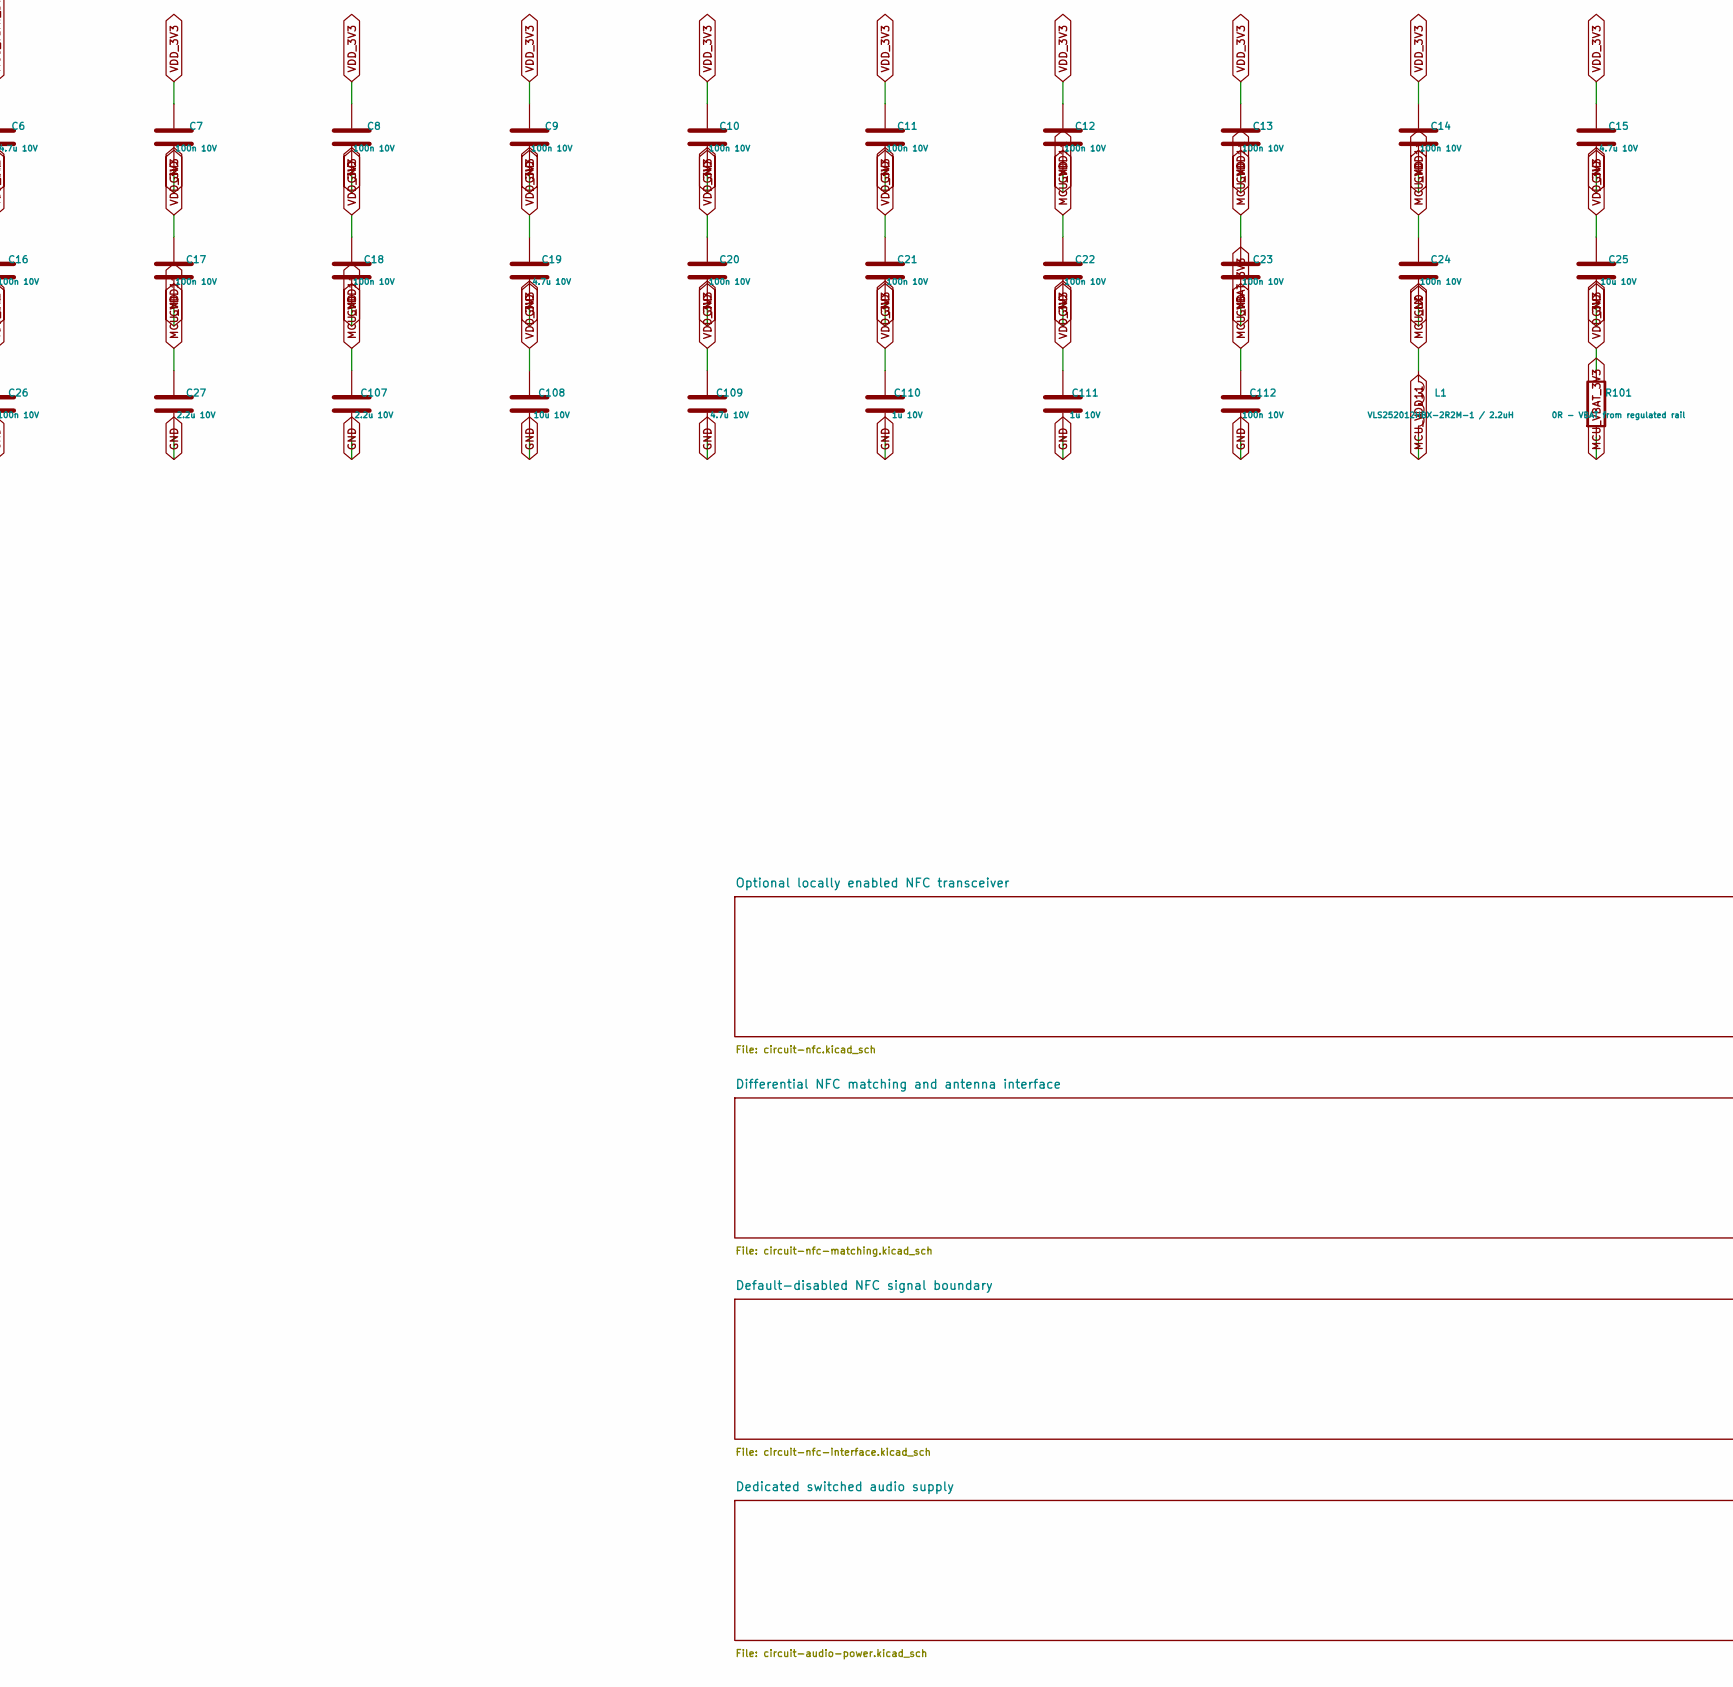
[picture p31: schematic voicevault-standalone-b0.kicad_sch, VoiceVault B0 - standalone circuit review, part in row 2, column 2]

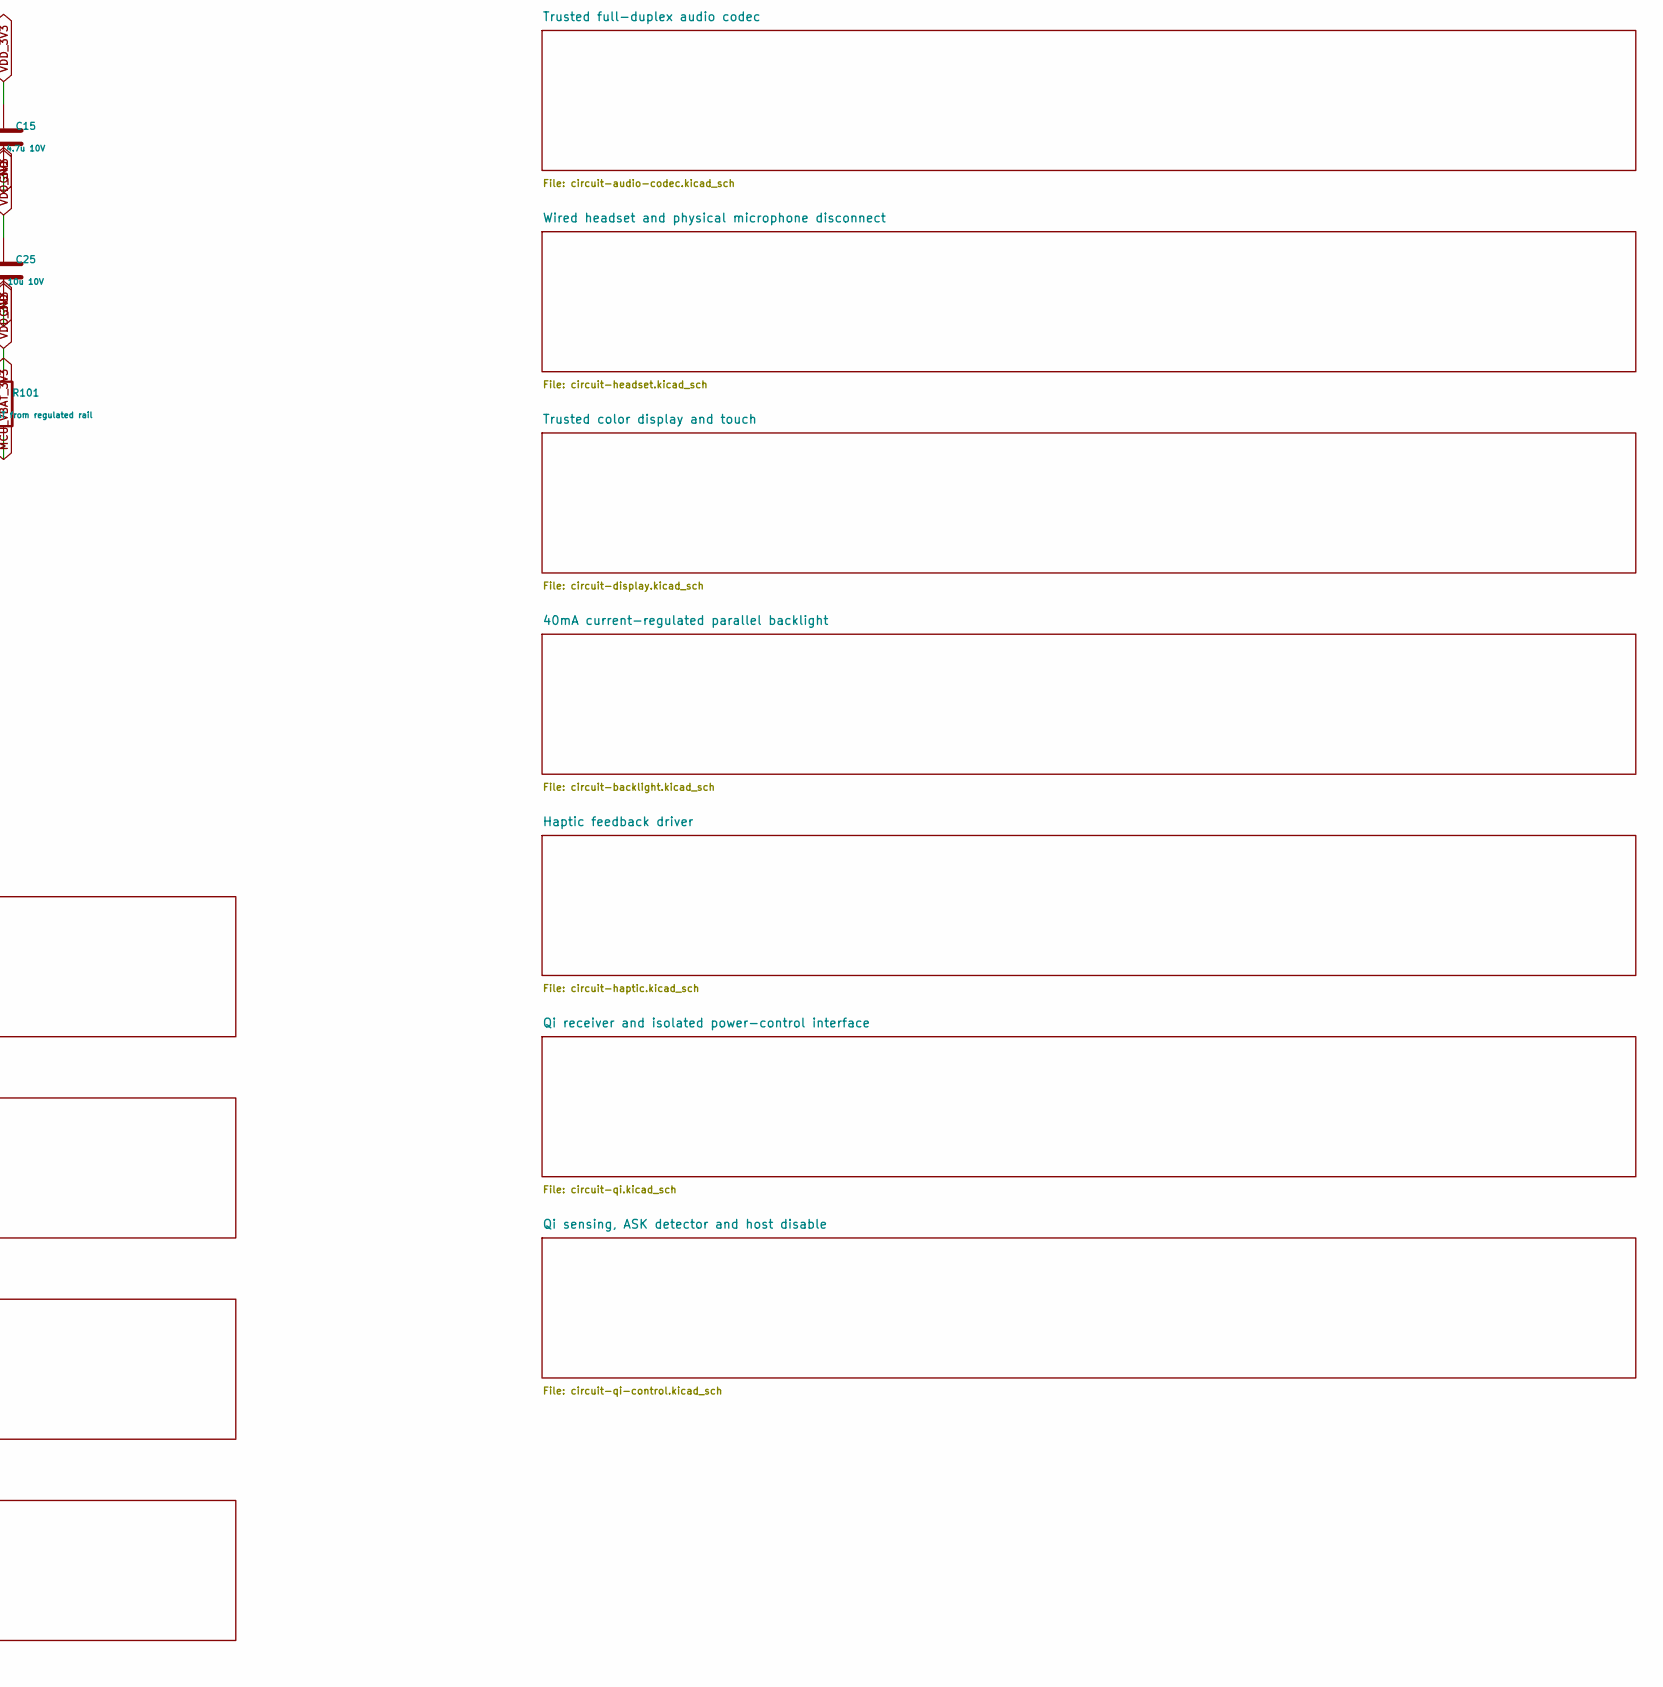
[picture p32: schematic voicevault-standalone-b0.kicad_sch, VoiceVault B0 - standalone circuit review, part in row 2, column 3]

Parts:
C6, C15, C19, C109: 4.7u 10V; C_0603_1608Metric
C7, C8, C9, C10, C11, C12, C13, C14, C16, C17, C18, C20, C21, C22, C23, C24, C26, C112: 100n 10V; C_0402_1005Metric
C25, C108: 10u 10V; C_0805_2012Metric
C27, C107: 2.2u 10V; C_0603_1608Metric
C110, C111: 1u 10V; C_0603_1608Metric
J101: FTSH-107-01-L-DV / STDC14; Samtec_FTSH-107-01-L-DV
L1: VLS252012HBX-2R2M-1 / 2.2uH; L_1008_2520Metric
R101: 0R - VBAT from regulated rail; R_0402_1005Metric
U1: STM32U5G9ZJJ6Q; UFBGA-144_10x10mm_Layout12x12_P0.8mm

Connections:
AUD_ADC_DATA: U1.B2 (PE3); also elsewhere on the board
AUD_BCLK: U1.C4 (PE5); also elsewhere on the board
AUD_DAC_DATA: U1.D3 (PE6); also elsewhere on the board
AUD_MCLK: U1.B1 (PE2); also elsewhere on the board
AUD_POWER_EN: U1.K8 (PB10); also elsewhere on the board
AUD_RESET_N: U1.A4 (PB6); also elsewhere on the board
AUD_SCL: U1.F4 (PF1); also elsewhere on the board
AUD_SDA: U1.E5 (PF0); also elsewhere on the board
AUD_WCLK: U1.C3 (PE4); also elsewhere on the board
BACKLIGHT_PWM: U1.A2 (PB9); also elsewhere on the board
BTN_RESET_N: U1.J7 (PE10); also elsewhere on the board
BTN_UPDATE_N: U1.B4 (PB8); also elsewhere on the board
GND: C6.2, C7.2, C8.2, C9.2, C10.2, C11.2, C12.2, C13.2, C14.2, C15.2, C16.2, C17.2, C18.2, C19.2, C20.2, C21.2, C22.2, C23.2, C24.2, C25.2, C26.2, C27.2, C107.2, C108.2, C109.2, C110.2, C111.2, C112.2, J101.5 (GND), J101.7 (GND), J101.11 (GND), U1.A1 (VSS), U1.A12 (VSS), U1.D1 (VSSDSI), U1.D5 (VSS), U1.D9 (VSS), U1.F3 (VSSDSI), U1.F6 (VSS), U1.F7 (VSS), U1.F10 (VSS), U1.G6 (VSS), U1.G7 (VSS), U1.H1 (VSSDSI), U1.H10 (VSS), U1.J3 (VSSA), U1.L8 (VSSSMPS), U1.M1 (VSS), U1.M12 (VSS); also elsewhere on the board
HAPTIC_IRQ_N: U1.J8 (PE12); also elsewhere on the board
HAPTIC_RESET_N: U1.M5 (PE11); also elsewhere on the board
LCD_CS_N: U1.L5 (PE7); also elsewhere on the board
LCD_RESET_N: U1.C5 (PB7); also elsewhere on the board
LCD_SCK: U1.B10 (PC10); also elsewhere on the board
LCD_SDI: U1.A11 (PC12); also elsewhere on the board
LCD_SDO: U1.C8 (PC11); also elsewhere on the board
LCD_TE: U1.K12 (PH9); also elsewhere on the board
LINK_CREDIT: U1.M11 (PD8); also elsewhere on the board
LINK_CTS: U1.H4 (PA0); also elsewhere on the board
LINK_PENDING: U1.K10 (PD9); also elsewhere on the board
LINK_RTS: U1.K3 (PA1); also elsewhere on the board
LINK_RX: U1.M2 (PA3); also elsewhere on the board
LINK_TX: U1.L2 (PA2); also elsewhere on the board
MCU_BOOT0: U1.A3 (PH3); also elsewhere on the board
MCU_HSE_IN: U1.H2 (PH0); also elsewhere on the board
MCU_HSE_OUT: U1.J1 (PH1); also elsewhere on the board
MCU_LSE_IN: U1.C1 (PC14); also elsewhere on the board
MCU_LSE_OUT: U1.D2 (PC15); also elsewhere on the board
MCU_LX: L1.1, U1.M7 (VLXSMPS)
MCU_NRST: J101.12 (MCU_NRST), U1.J2 (NRST); also elsewhere on the board
MCU_SWCLK: J101.6 (MCU_SWCLK), U1.B11 (PA14)
MCU_SWDIO: J101.4 (MCU_SWDIO), U1.C10 (PA13)
MCU_SWO: J101.8 (MCU_SWO), U1.D6 (PB3)
MCU_UART_RX: J101.13 (MCU_UART_RX), U1.D12 (PC8)
MCU_UART_TX: J101.14 (MCU_UART_TX), U1.F8 (PC9)
MCU_VBAT_3V3: C6.1, C112.1, R101.2, U1.C2 (VBAT)
MCU_VDD11: C22.1, C23.1, C24.1, C27.1, C107.1, L1.2, U1.D4 (VDD11), U1.G3 (VDD11DSI), U1.J9 (VDD11); also elsewhere on the board
NFC_HOST_CS_N: U1.L3 (PA4); also elsewhere on the board
NFC_HOST_IRQ: U1.B7 (PG9); also elsewhere on the board
NFC_HOST_MISO: U1.M3 (PA6); also elsewhere on the board
NFC_HOST_MOSI: U1.L4 (PA7); also elsewhere on the board
NFC_HOST_SCK: U1.K4 (PA5); also elsewhere on the board
NFC_IO_DISABLE: U1.H6 (PB2); also elsewhere on the board
NFC_POWER_EN: U1.J5 (PB0); also elsewhere on the board
OP_PWR_OFF: U1.L12 (PD14); also elsewhere on the board
OP_RESET_N: U1.L11 (PD10); also elsewhere on the board
OP_SCL: U1.K11 (PD12); also elsewhere on the board
OP_SDA: U1.K9 (PD13); also elsewhere on the board
PMIC_GPIO2: U1.J12 (PH10); also elsewhere on the board
PMIC_GPIO3: U1.H11 (PH12); also elsewhere on the board
PMIC_IRQ: U1.B12 (PA10); also elsewhere on the board
PMIC_SCL: U1.A6 (PG14); also elsewhere on the board
PMIC_SDA: U1.C6 (PG13); also elsewhere on the board
QI_DISABLE: U1.J6 (PG1); also elsewhere on the board
QI_IRQ_N: U1.B6 (PG15); also elsewhere on the board
QI_SCL: U1.A10 (PD3); also elsewhere on the board
QI_SDA: U1.C7 (PD4); also elsewhere on the board
RAD_IO_DISABLE: U1.B9 (PD2); also elsewhere on the board
RAD_RESET_ASSERT: U1.K5 (PG0); also elsewhere on the board
SD_CS_MCU: U1.F9 (PC7); also elsewhere on the board
SD_DETECT_N: U1.E4 (PC13); also elsewhere on the board
SD_IO_DISABLE: U1.K6 (PE9); also elsewhere on the board
SD_MISO_MCU: U1.G5 (PC2); also elsewhere on the board
SD_MOSI_MCU: U1.K1 (PC1); also elsewhere on the board
SD_POWER_EN: U1.H8 (PE8); also elsewhere on the board
SD_SCK_MCU: U1.K2 (PC0); also elsewhere on the board
TOUCH_IRQ_N: U1.L1 (PC3); also elsewhere on the board
TOUCH_RESET_N: U1.B3 (PE0); also elsewhere on the board
TOUCH_SCL: U1.E7 (PD1); also elsewhere on the board
TOUCH_SDA: U1.D8 (PD0); also elsewhere on the board
TR_CS: U1.F11 (PI0); also elsewhere on the board
TR_IRQ: U1.A9 (PD7); also elsewhere on the board
TR_MISO: U1.L10 (PB14); also elsewhere on the board
TR_MOSI: U1.M9 (PB15); also elsewhere on the board
TR_PWR_OFF: U1.L7 (PB11); also elsewhere on the board
TR_SCK: U1.M10 (PB13); also elsewhere on the board
VDD_3V3: C7.1, C8.1, C9.1, C10.1, C11.1, C12.1, C13.1, C14.1, C15.1, C16.1, C17.1, C18.1, C19.1, C20.1, C21.1, C25.1, C26.1, C108.1, C109.1, C110.1, C111.1, J101.3 (VDD_3V3), R101.1, U1.D10 (VDDUSB), U1.E3 (VDDDSI), U1.E6 (VDDIO2), U1.E8 (VDD), U1.E10 (VDD), U1.F5 (VDD), U1.G8 (VDD), U1.G10 (VDD), U1.H3 (VREF+), U1.H5 (VDD), U1.H7 (VDD), U1.J4 (VDDA), U1.J10 (VDD), U1.M8 (VDDSMPS); also elsewhere on the board

Notes on the sheet:
VOICEVAULT B0 | STANDALONE SECURE AUDIO ENDPOINT | CIRCUIT REVIEW
NOT FOR FABRICATION. Hierarchical circuits under review; all PCB routing remains incomplete.
STDC14 pin 3 is target voltage sense, NOT a power input.
Use an external STLINK-V3MINIE. Target supply is separate.
Pins 13/14 use TARGET RX/TX naming. UART6 on PC8/PC9.
Power, radio, secure elements, controls and offline-update interfaces: see child sheets.
Main debug and radio debug are separate; probes measure target voltage only.
Display/touch, haptic, Qi and NFC are on separate reviewed-source circuit sheets.
Audio codec, CTIA headset, physical microphone disconnect and microSD are additions.
Prototype has open debug access and public diagnostic material. Physical security remains unqualified.
Safe 7 source: TS7 rev_D, STM32U5G9ZJJ6Q / UFBGA144. New PCB outline is provisional 70 x 45 mm.
