adlererik/voicevault/hardware/rev-b/voicevault-standalone-b0.kicad_pcb

## KiCad design hardware/rev-b/voicevault-standalone-b0.kicad_pcb (continued)

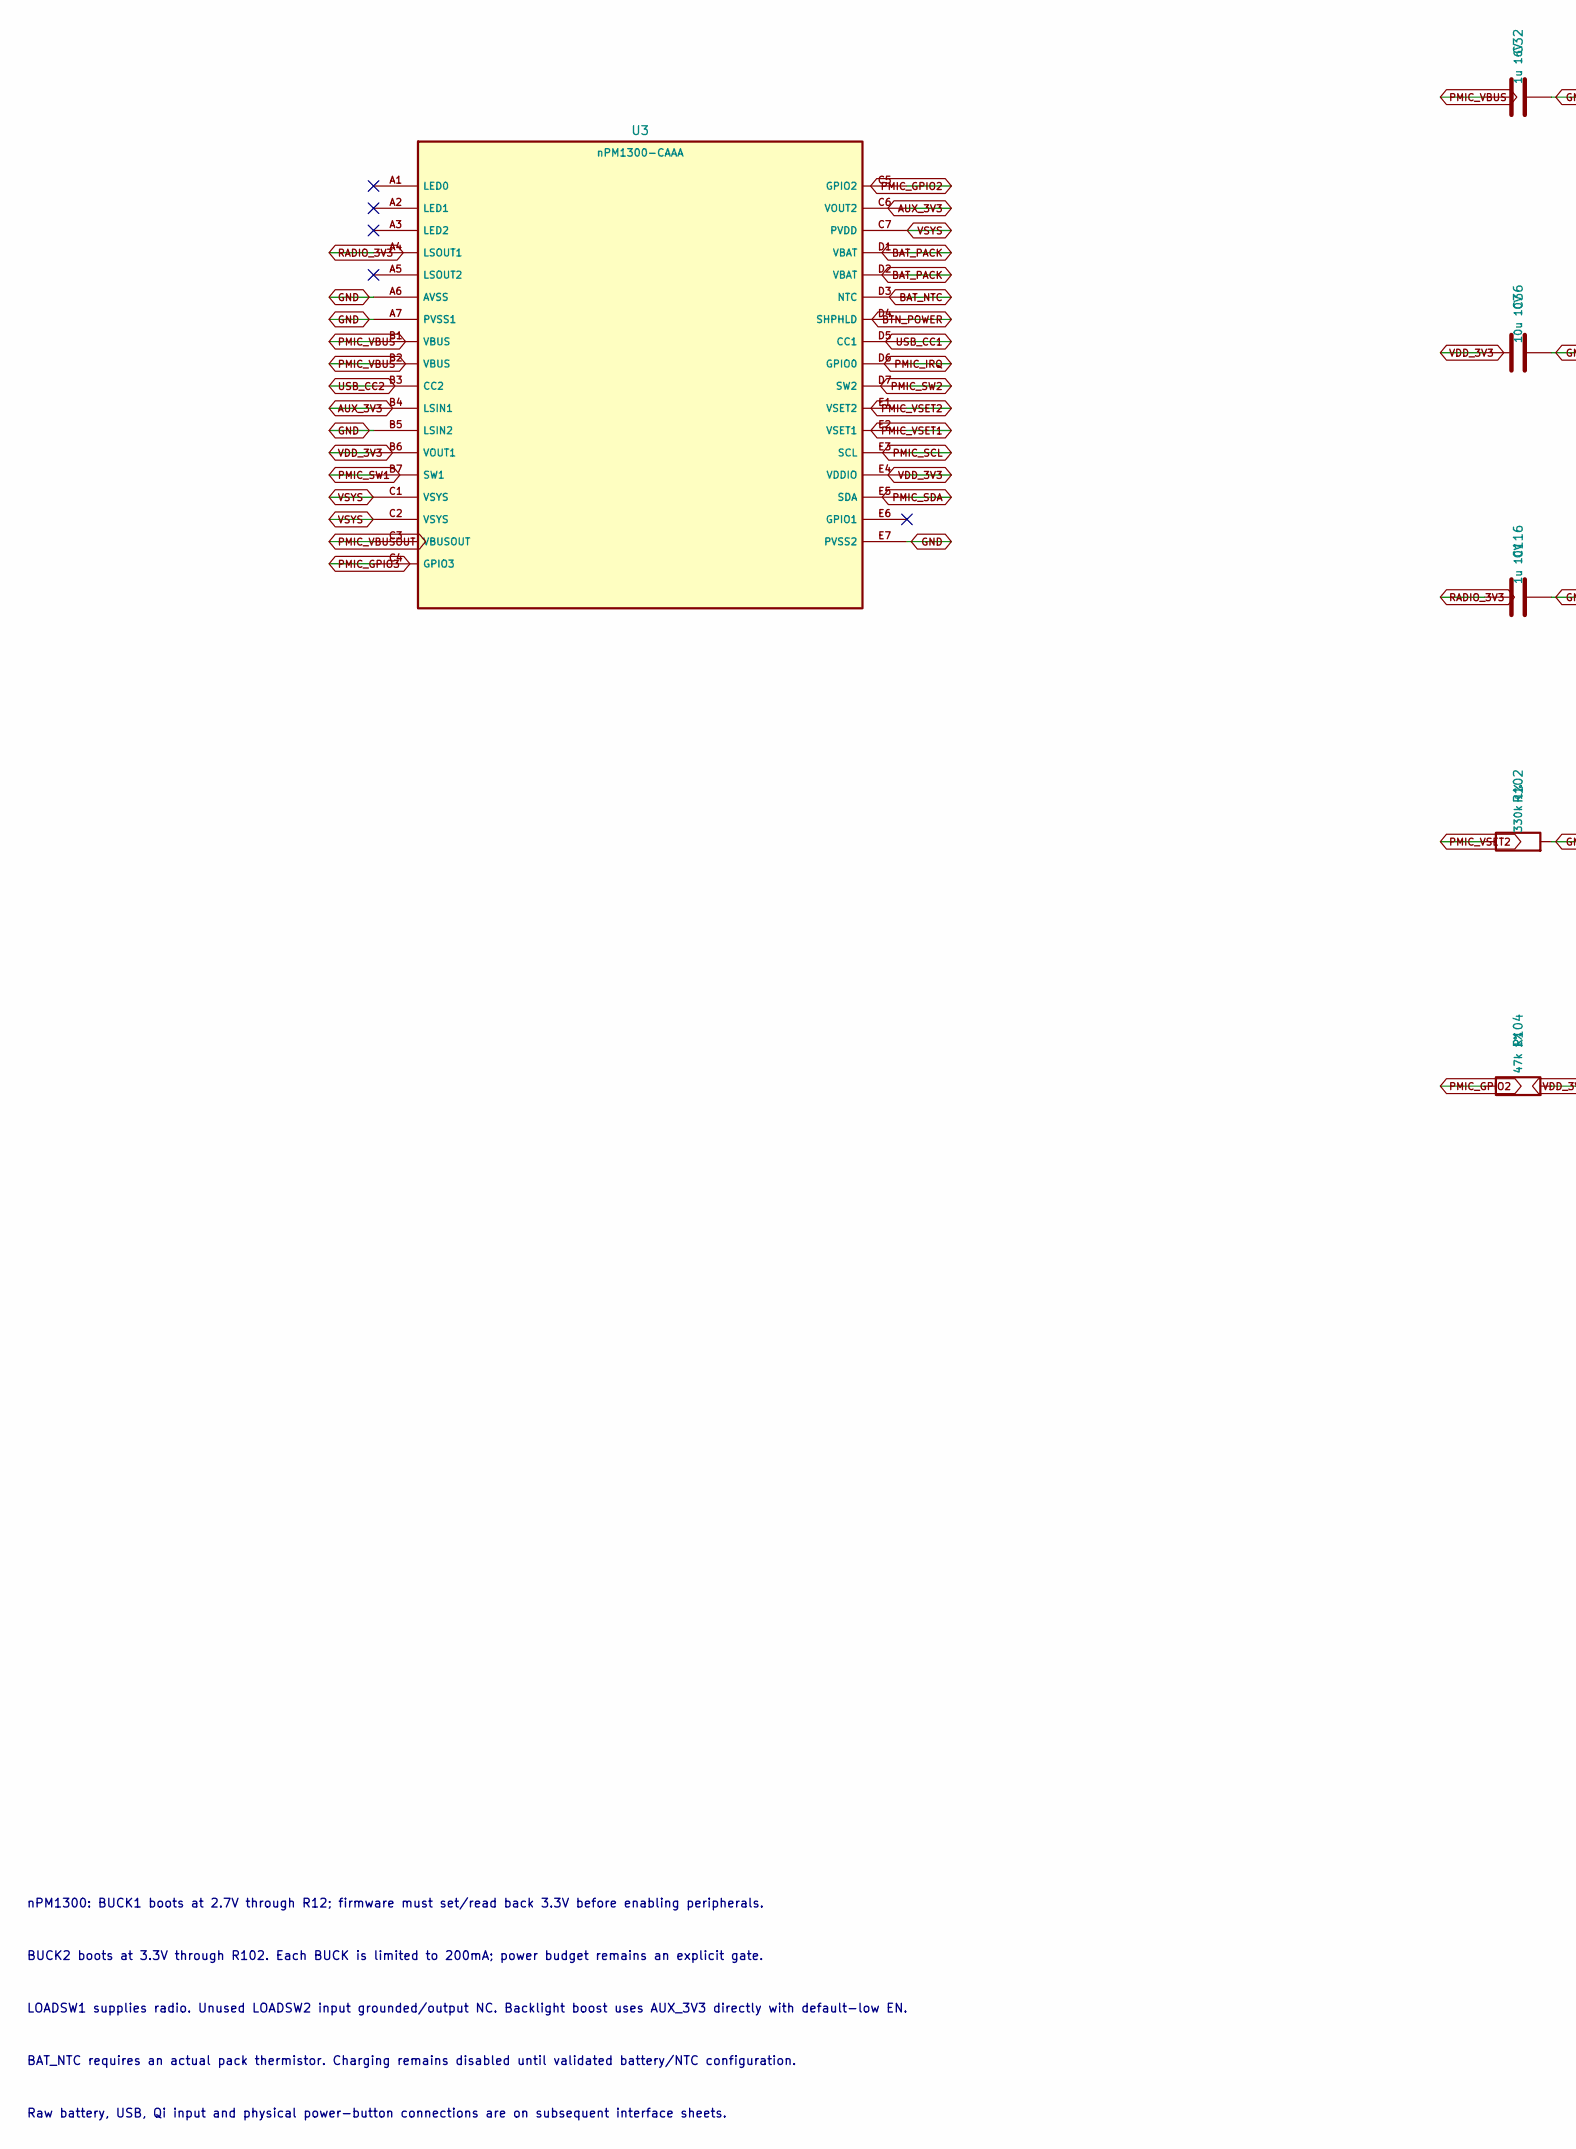
[picture p33: schematic circuit-power.kicad_sch, Power management and charging, part in row 1, column 1]

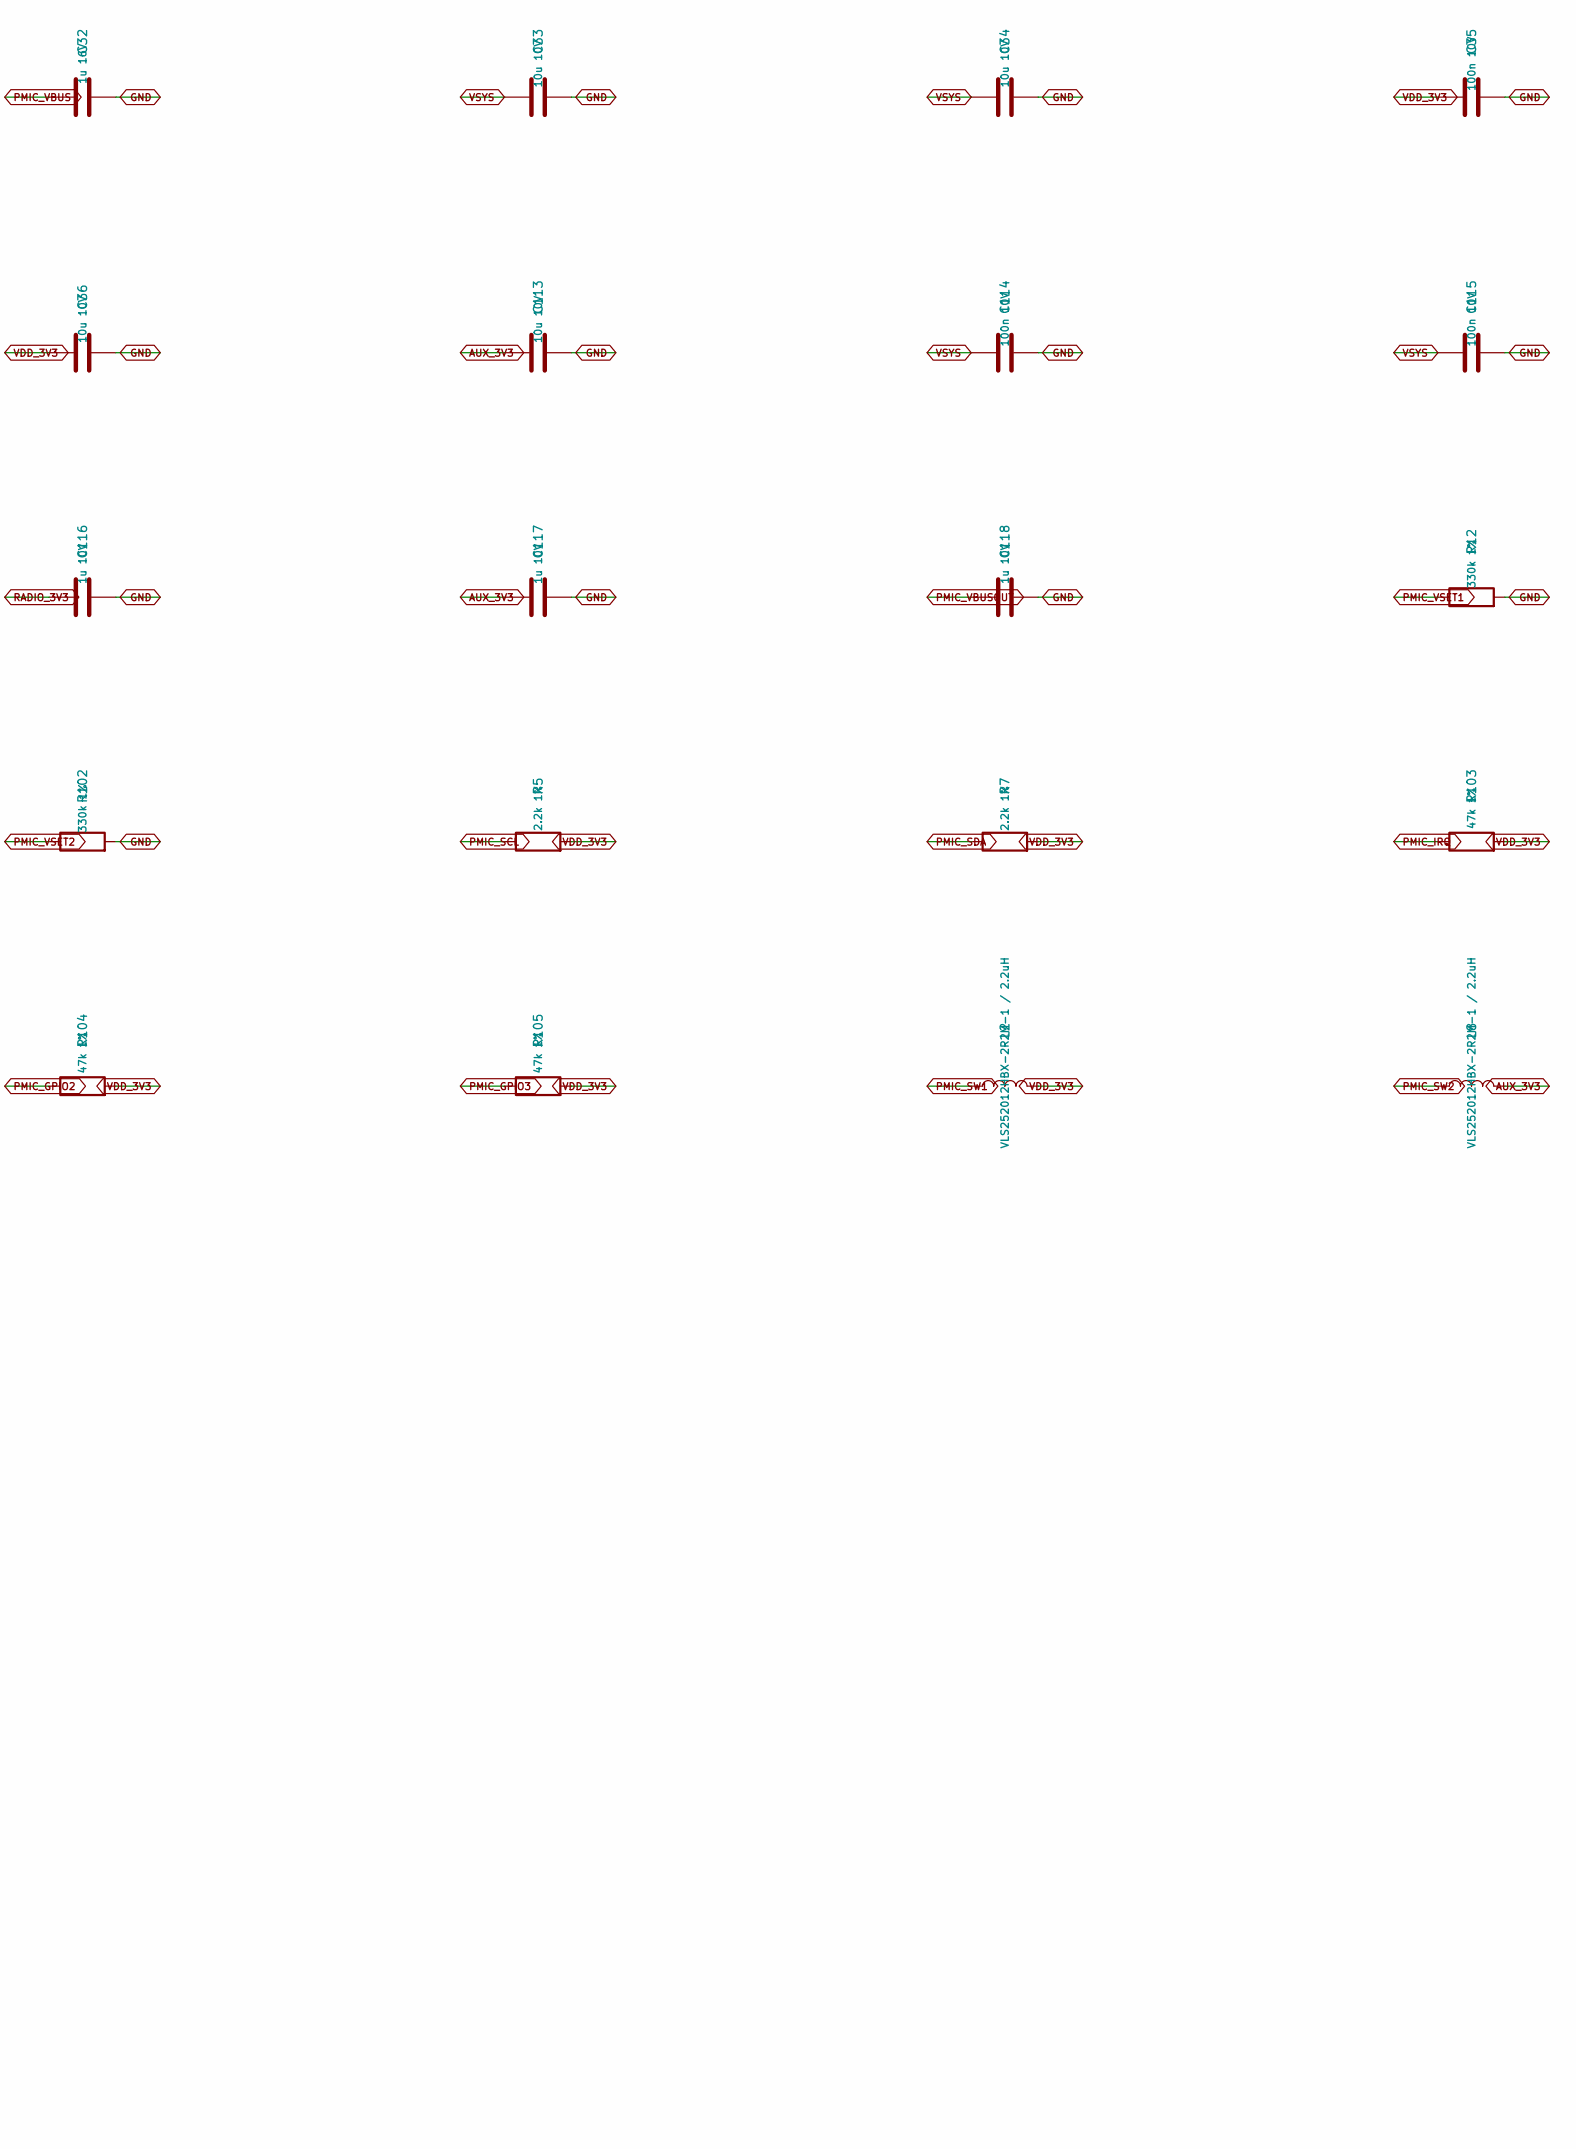
[picture p34: schematic circuit-power.kicad_sch, Power management and charging, part in row 1, column 2]

Parts:
C32: 1u 16V; C_0603_1608Metric
C33, C34, C36, C113: 10u 10V; C_0603_1608Metric
C35, C114, C115: 100n 10V; C_0603_1608Metric
C116, C117, C118: 1u 10V; C_0603_1608Metric
L2, L8: VLS252012HBX-2R2M-1 / 2.2uH; L_1008_2520Metric
R5, R7: 2.2k 1%; R_0402_1005Metric
R12, R102: 330k 1%; R_0402_1005Metric
R103, R104, R105: 47k 1%; R_0402_1005Metric
U3: nPM1300-CAAA; nPM1300_CAAA_Nordic

Connections:
AUX_3V3: C113.1, C117.1, L8.2, U3.B4 (LSIN1), U3.C6 (VOUT2); also elsewhere on the board
BAT_NTC: U3.D3 (NTC); also elsewhere on the board
BAT_PACK: U3.D1 (VBAT), U3.D2 (VBAT); also elsewhere on the board
BTN_POWER: U3.D4 (SHPHLD); also elsewhere on the board
GND: C32.2, C33.2, C34.2, C35.2, C36.2, C113.2, C114.2, C115.2, C116.2, C117.2, C118.2, R12.2, R102.2, U3.A6 (AVSS), U3.A7 (PVSS1), U3.B5 (LSIN2), U3.E7 (PVSS2); also elsewhere on the board
PMIC_GPIO2: R104.1, U3.C5 (GPIO2); also elsewhere on the board
PMIC_GPIO3: R105.1, U3.C4 (GPIO3); also elsewhere on the board
PMIC_IRQ: R103.1, U3.D6 (GPIO0); also elsewhere on the board
PMIC_SCL: R5.1, U3.E3 (SCL); also elsewhere on the board
PMIC_SDA: R7.1, U3.E5 (SDA); also elsewhere on the board
PMIC_SW1: L2.1, U3.B7 (SW1)
PMIC_SW2: L8.1, U3.D7 (SW2)
PMIC_VBUS: C32.1, U3.B1 (VBUS), U3.B2 (VBUS); also elsewhere on the board
PMIC_VBUSOUT: C118.1, U3.C3 (VBUSOUT)
PMIC_VSET1: R12.1, U3.E2 (VSET1)
PMIC_VSET2: R102.1, U3.E1 (VSET2)
RADIO_3V3: C116.1, U3.A4 (LSOUT1); also elsewhere on the board
USB_CC1: U3.D5 (CC1); also elsewhere on the board
USB_CC2: U3.B3 (CC2); also elsewhere on the board
VDD_3V3: C35.1, C36.1, L2.2, R5.2, R7.2, R103.2, R104.2, R105.2, U3.B6 (VOUT1), U3.E4 (VDDIO); also elsewhere on the board
VSYS: C33.1, C34.1, C114.1, C115.1, U3.C1 (VSYS), U3.C2 (VSYS), U3.C7 (PVDD); also elsewhere on the board

Notes on the sheet:
nPM1300: BUCK1 boots at 2.7V through R12; firmware must set/read back 3.3V before enabling peripherals.
BUCK2 boots at 3.3V through R102. Each BUCK is limited to 200mA; power budget remains an explicit gate.
LOADSW1 supplies radio. Unused LOADSW2 input grounded/output NC. Backlight boost uses AUX_3V3 directly with default-low EN.
BAT_NTC requires an actual pack thermistor. Charging remains disabled until validated battery/NTC configuration.
Raw battery, USB, Qi input and physical power-button connections are on subsequent interface sheets.

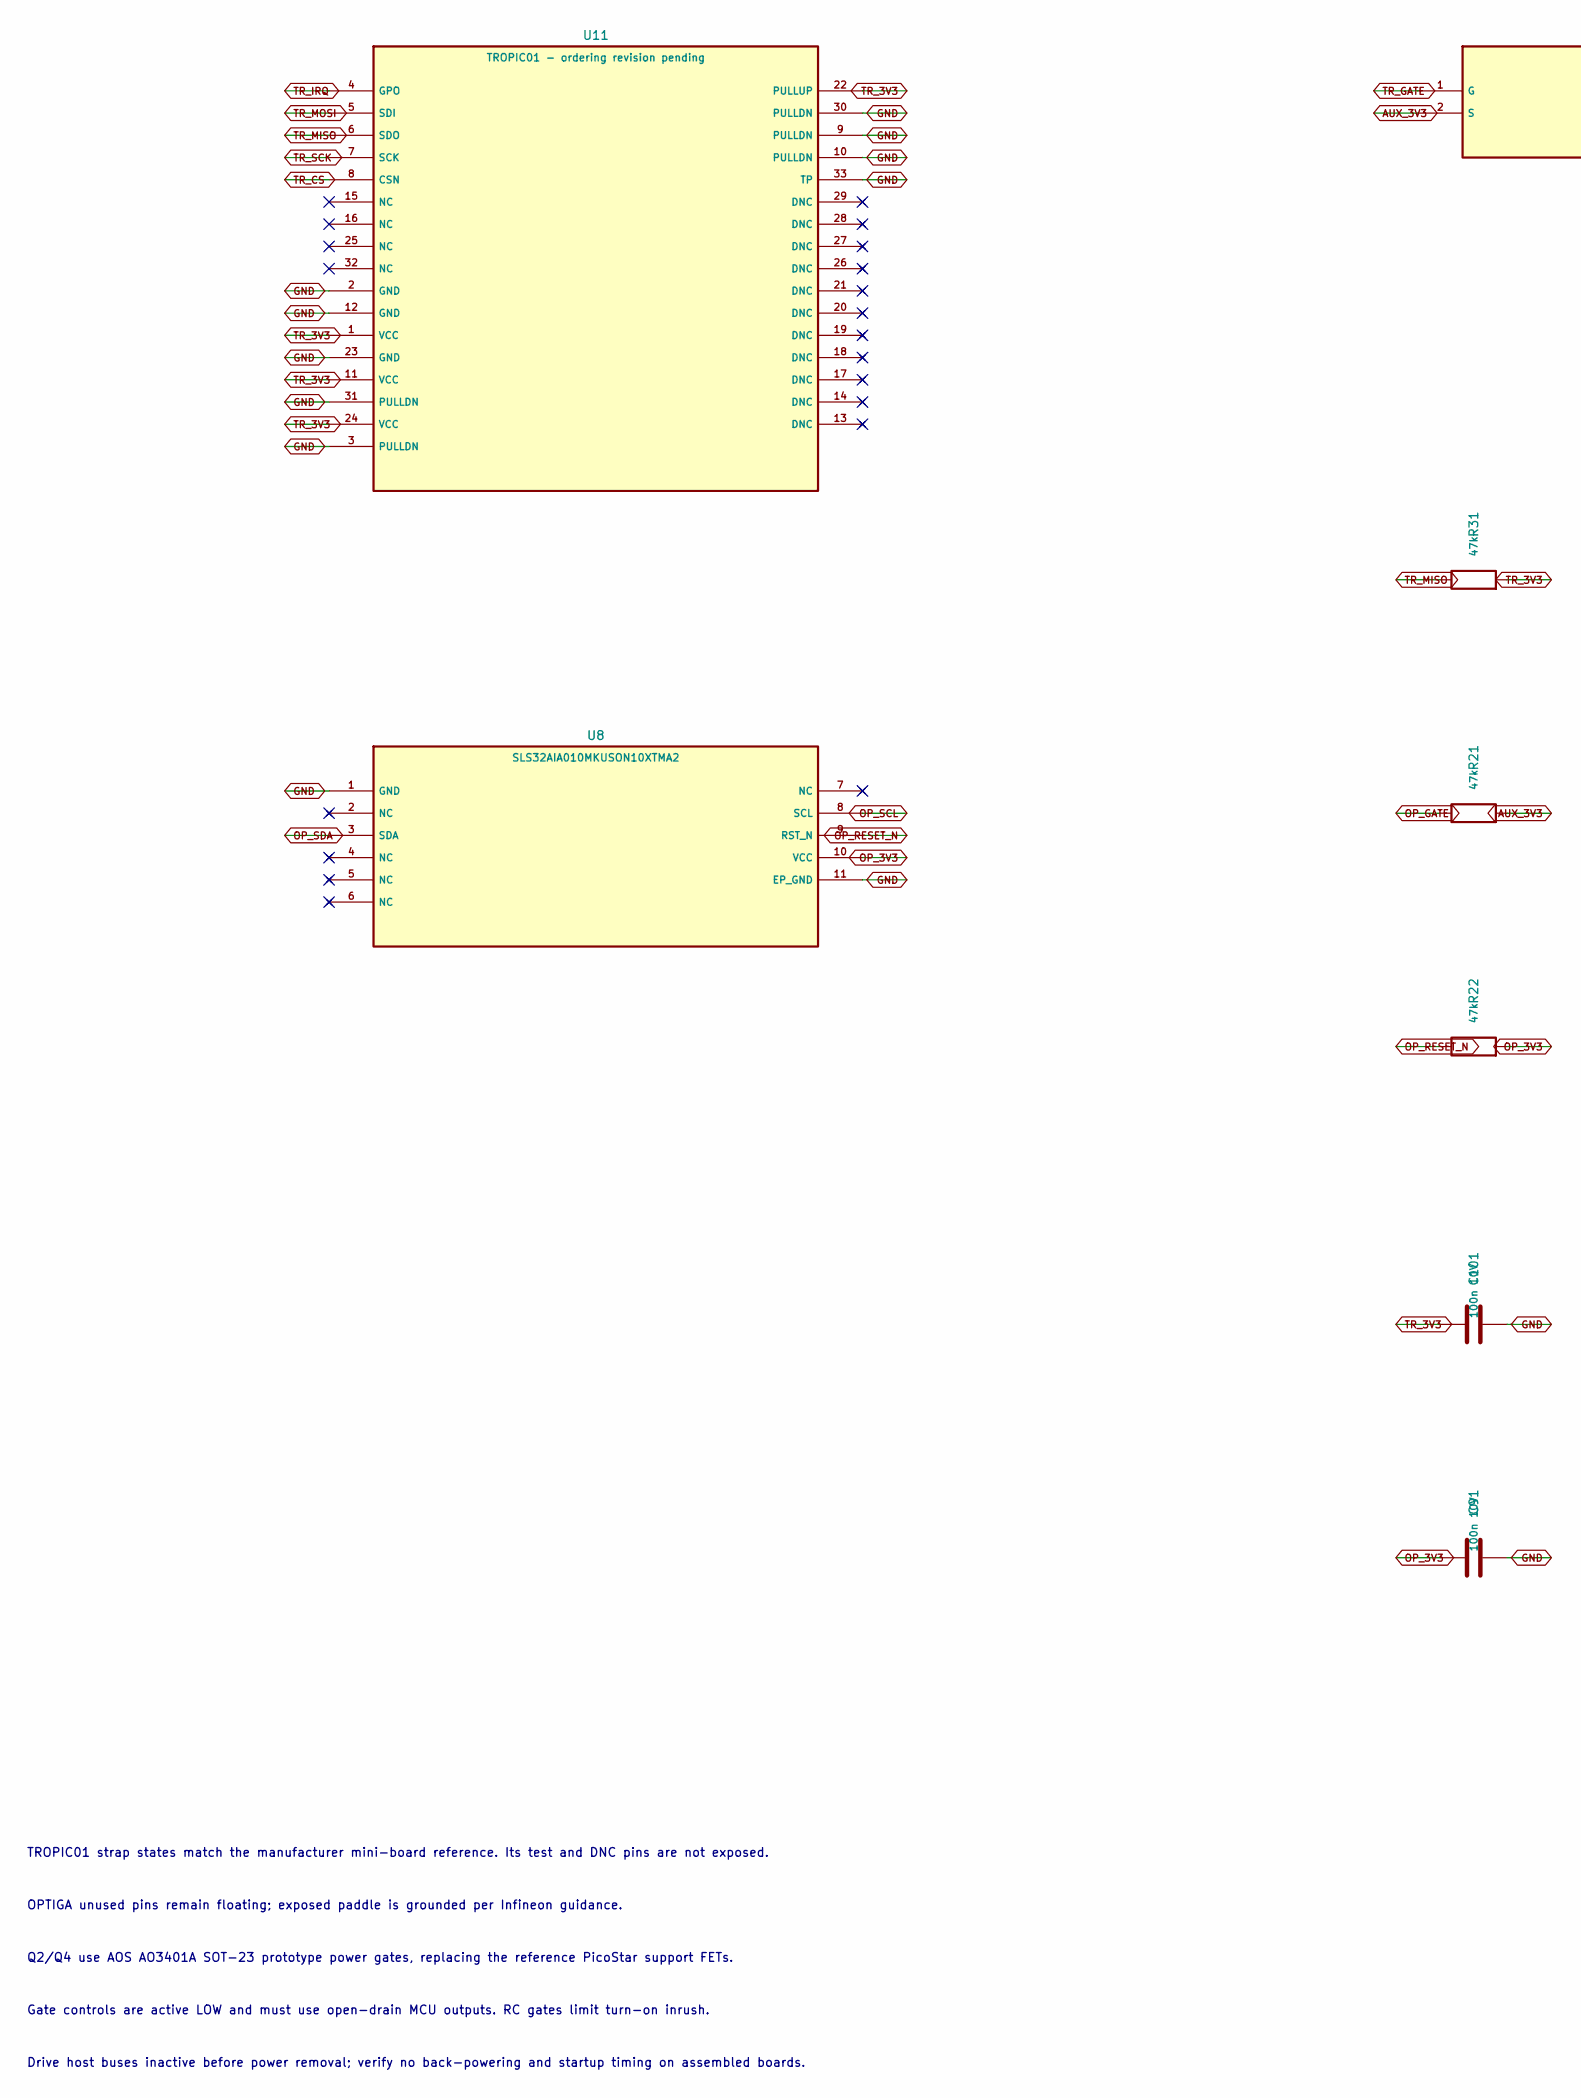
[picture p35: schematic circuit-secure.kicad_sch, Secure elements and local power control, part in row 1, column 1]

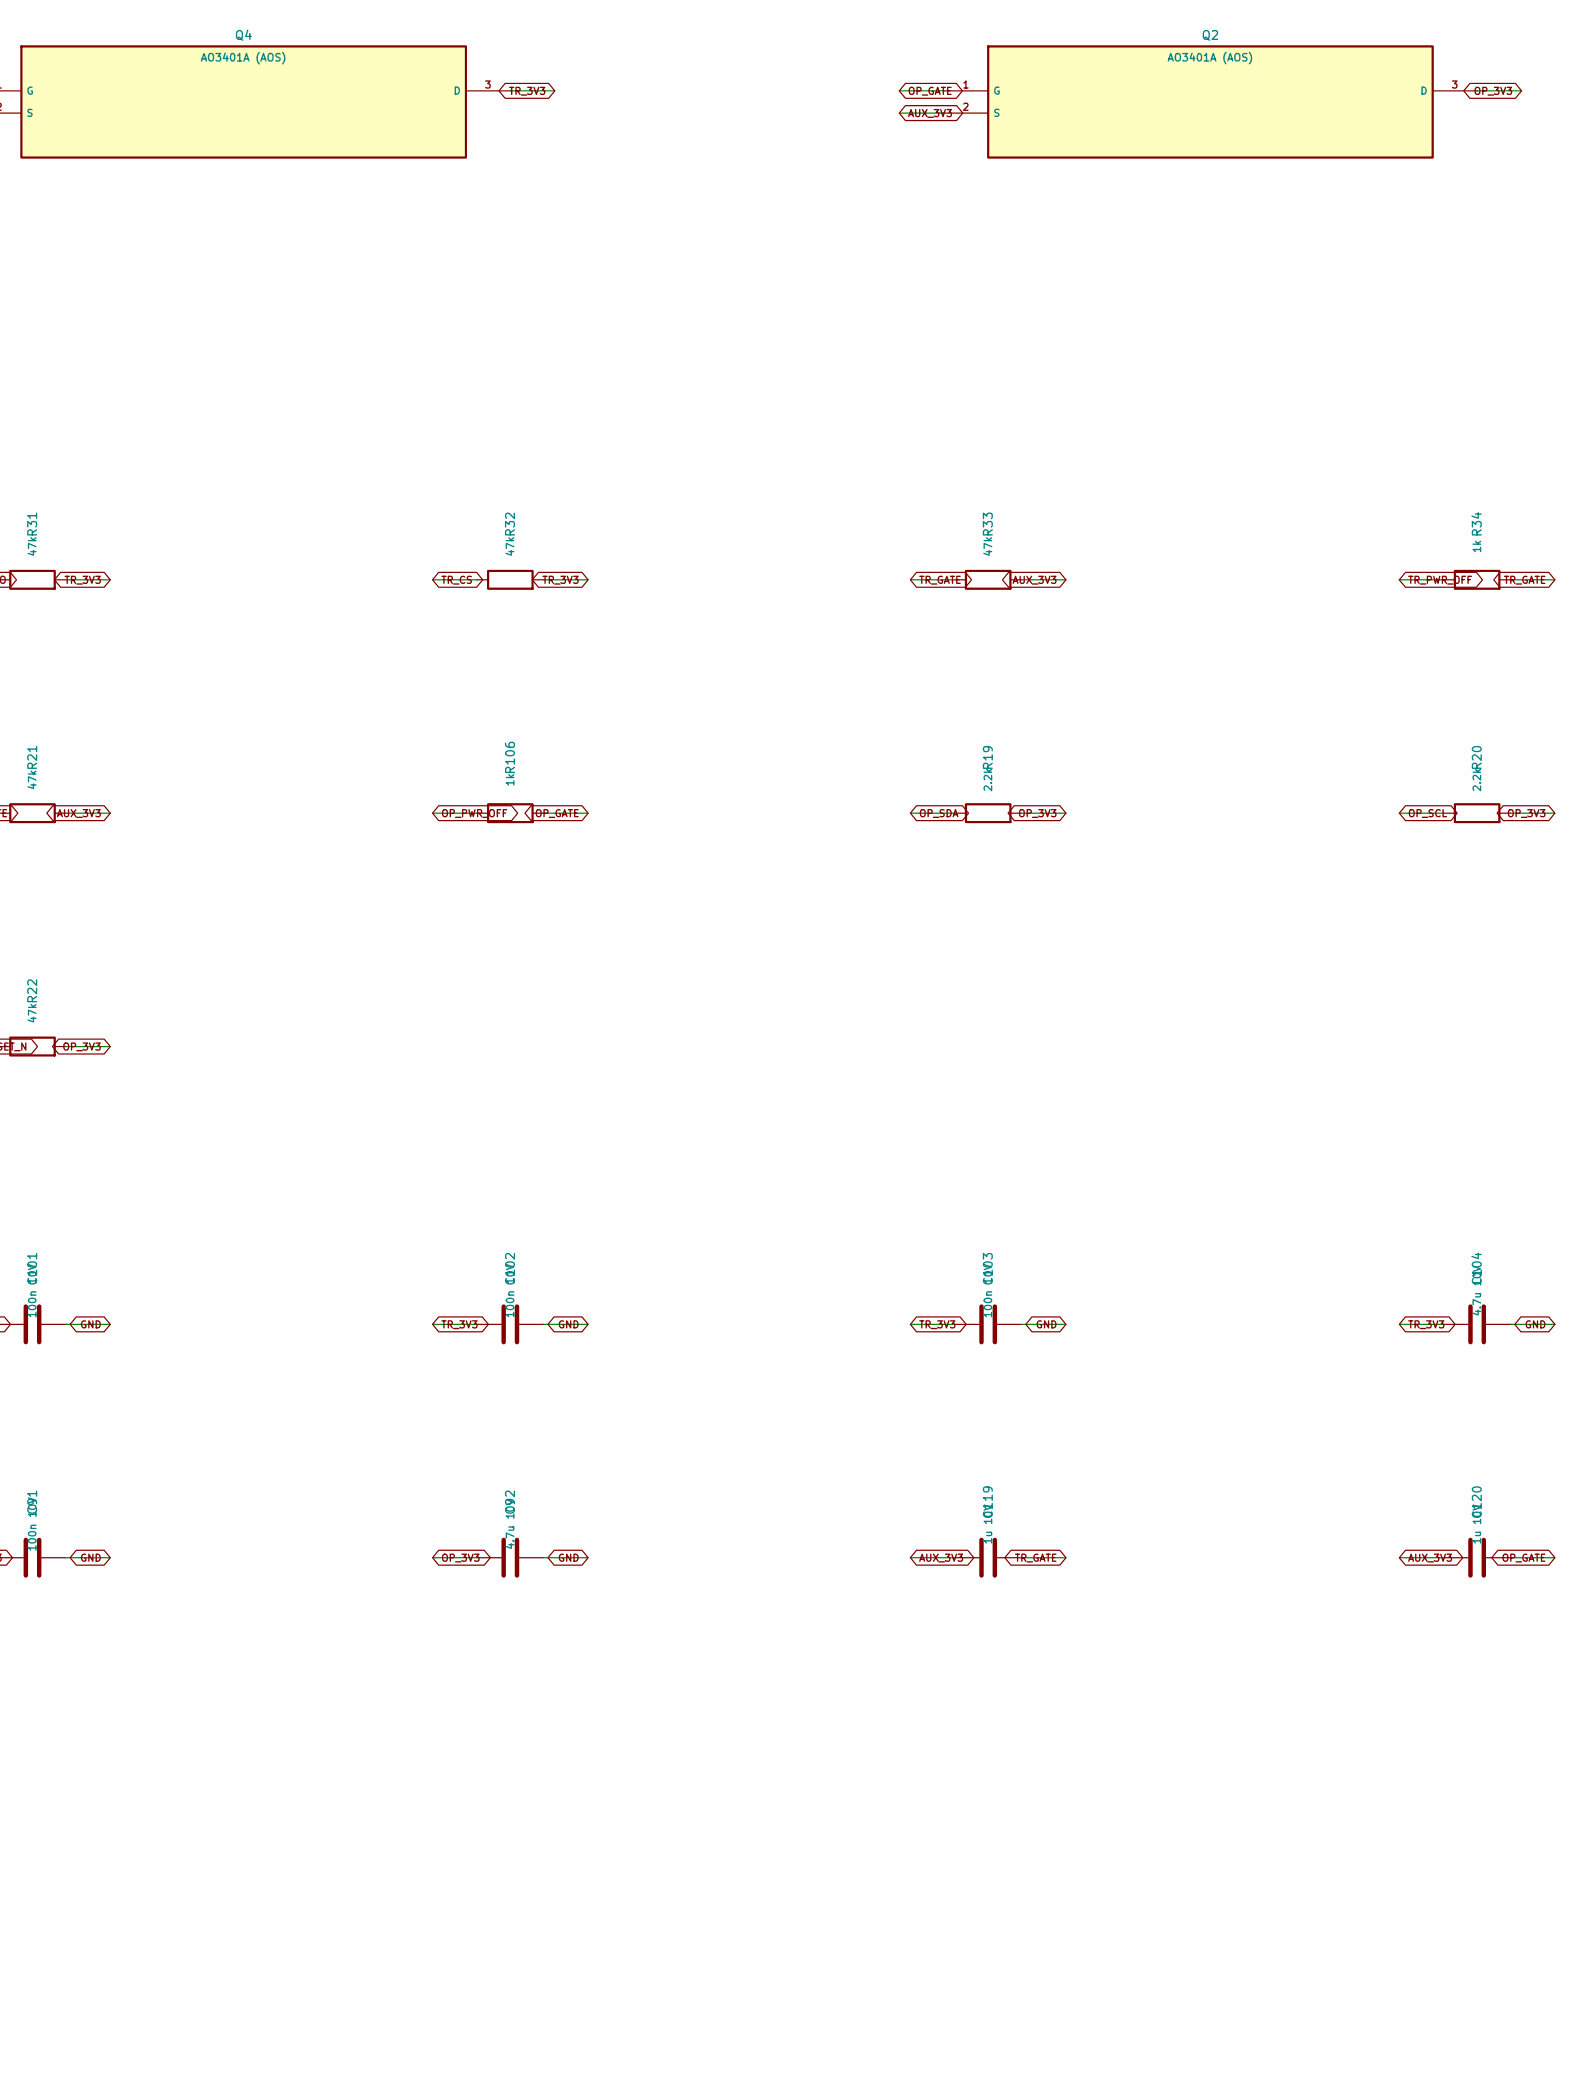
[picture p36: schematic circuit-secure.kicad_sch, Secure elements and local power control, part in row 1, column 2]

Parts:
C91, C101, C102, C103: 100n 10V; C_0402_1005Metric
C92, C104: 4.7u 10V; C_0603_1608Metric
C119, C120: 1u 10V; C_0402_1005Metric
Q2, Q4: AO3401A (AOS); SOT-23
R19, R20: 2.2k; R_0402_1005Metric
R21, R22, R31, R32, R33: 47k; R_0402_1005Metric
R34, R106: 1k; R_0402_1005Metric
U8: SLS32AIA010MKUSON10XTMA2; OPTIGA_PG_USON10_2
U11: TROPIC01 - ordering revision pending; TROPIC01_QFN32_vendor

Connections:
AUX_3V3: C119.1, C120.1, Q2.2 (S), Q4.2 (S), R21.2, R33.2; also elsewhere on the board
GND: C91.2, C92.2, C101.2, C102.2, C103.2, C104.2, U8.1 (GND), U8.11 (EP_GND), U11.2 (GND), U11.3 (PULLDN), U11.9 (PULLDN), U11.10 (PULLDN), U11.12 (GND), U11.23 (GND), U11.30 (PULLDN), U11.31 (PULLDN), U11.33 (TP); also elsewhere on the board
OP_3V3: C91.1, C92.1, Q2.3 (D), R19.2, R20.2, R22.2, U8.10 (VCC); also elsewhere on the board
OP_GATE: C120.2, Q2.1 (G), R21.1, R106.2
OP_PWR_OFF: R106.1; also elsewhere on the board
OP_RESET_N: R22.1, U8.9 (RST_N); also elsewhere on the board
OP_SCL: R20.1, U8.8 (SCL); also elsewhere on the board
OP_SDA: R19.1, U8.3 (SDA); also elsewhere on the board
TR_3V3: C101.1, C102.1, C103.1, C104.1, Q4.3 (D), R31.2, R32.2, U11.1 (VCC), U11.11 (VCC), U11.22 (PULLUP), U11.24 (VCC); also elsewhere on the board
TR_CS: R32.1, U11.8 (CSN); also elsewhere on the board
TR_GATE: C119.2, Q4.1 (G), R33.1, R34.2
TR_IRQ: U11.4 (GPO); also elsewhere on the board
TR_MISO: R31.1, U11.6 (SDO); also elsewhere on the board
TR_MOSI: U11.5 (SDI); also elsewhere on the board
TR_PWR_OFF: R34.1; also elsewhere on the board
TR_SCK: U11.7 (SCK); also elsewhere on the board

Notes on the sheet:
TROPIC01 strap states match the manufacturer mini-board reference. Its test and DNC pins are not exposed.
OPTIGA unused pins remain floating; exposed paddle is grounded per Infineon guidance.
Q2/Q4 use AOS AO3401A SOT-23 prototype power gates, replacing the reference PicoStar support FETs.
Gate controls are active LOW and must use open-drain MCU outputs. RC gates limit turn-on inrush.
Drive host buses inactive before power removal; verify no back-powering and startup timing on assembled boards.
