adlererik/voicevault/hardware/rev-b/voicevault-standalone-b0.kicad_pcb

## KiCad design hardware/rev-b/voicevault-standalone-b0.kicad_pcb (continued)

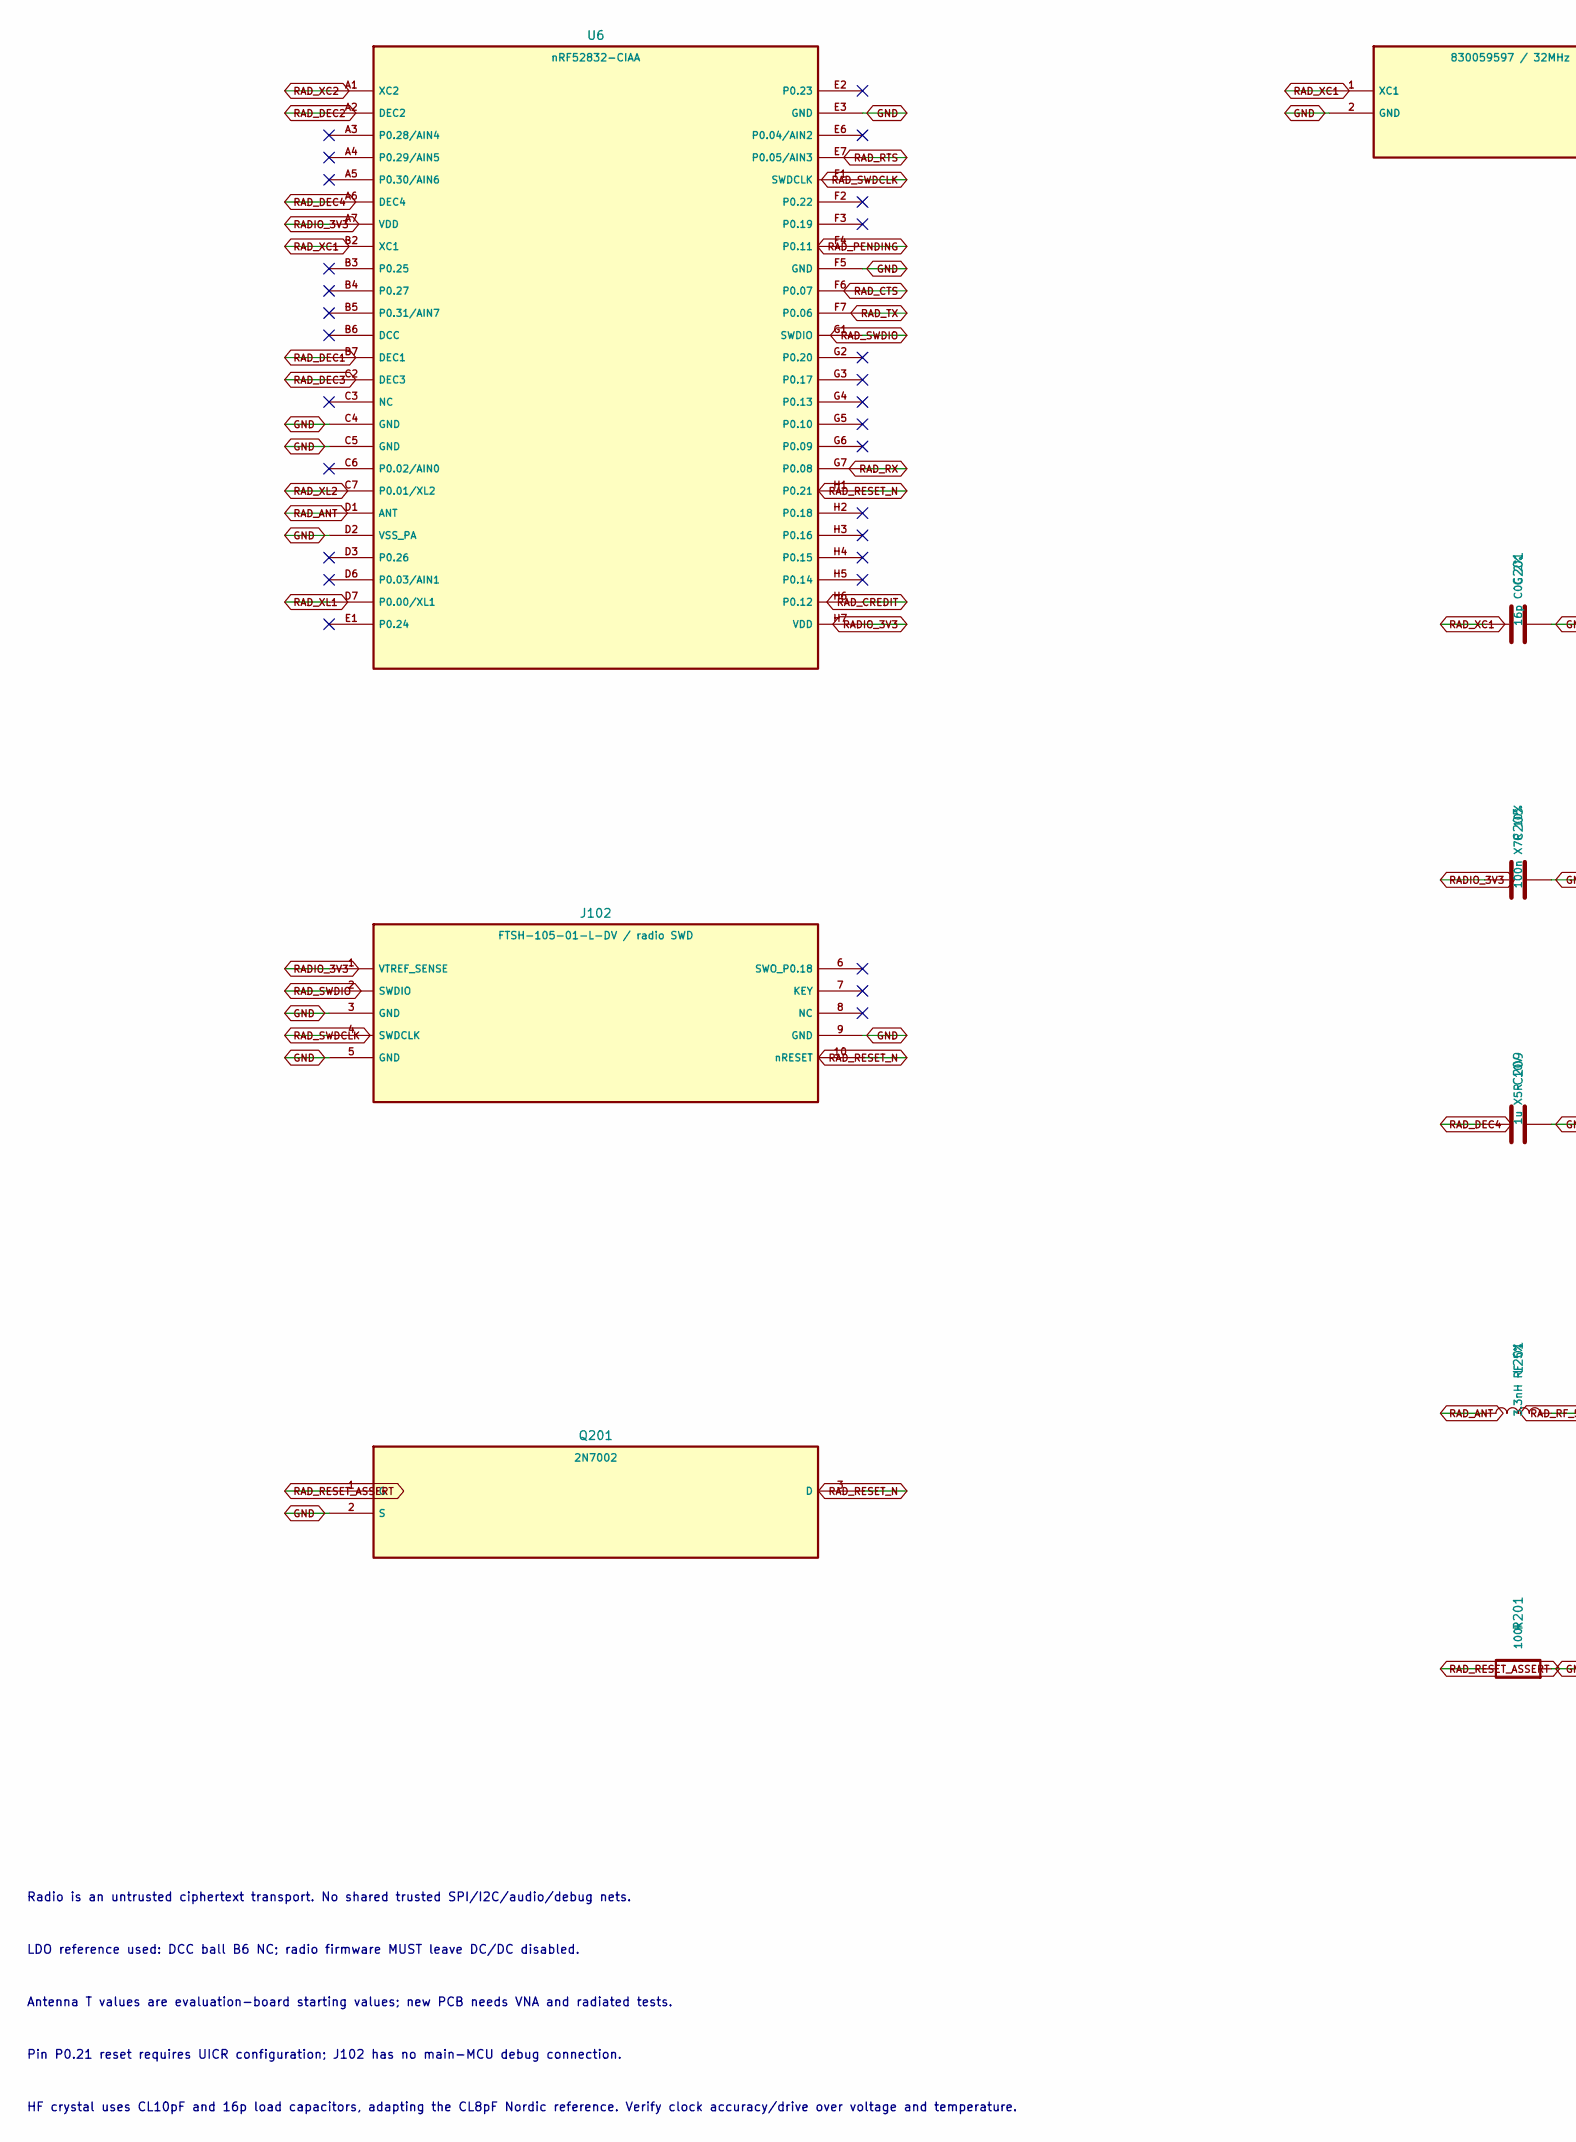
[picture p37: schematic circuit-radio.kicad_sch, Untrusted Bluetooth radio and RF front end, part in row 1, column 1]

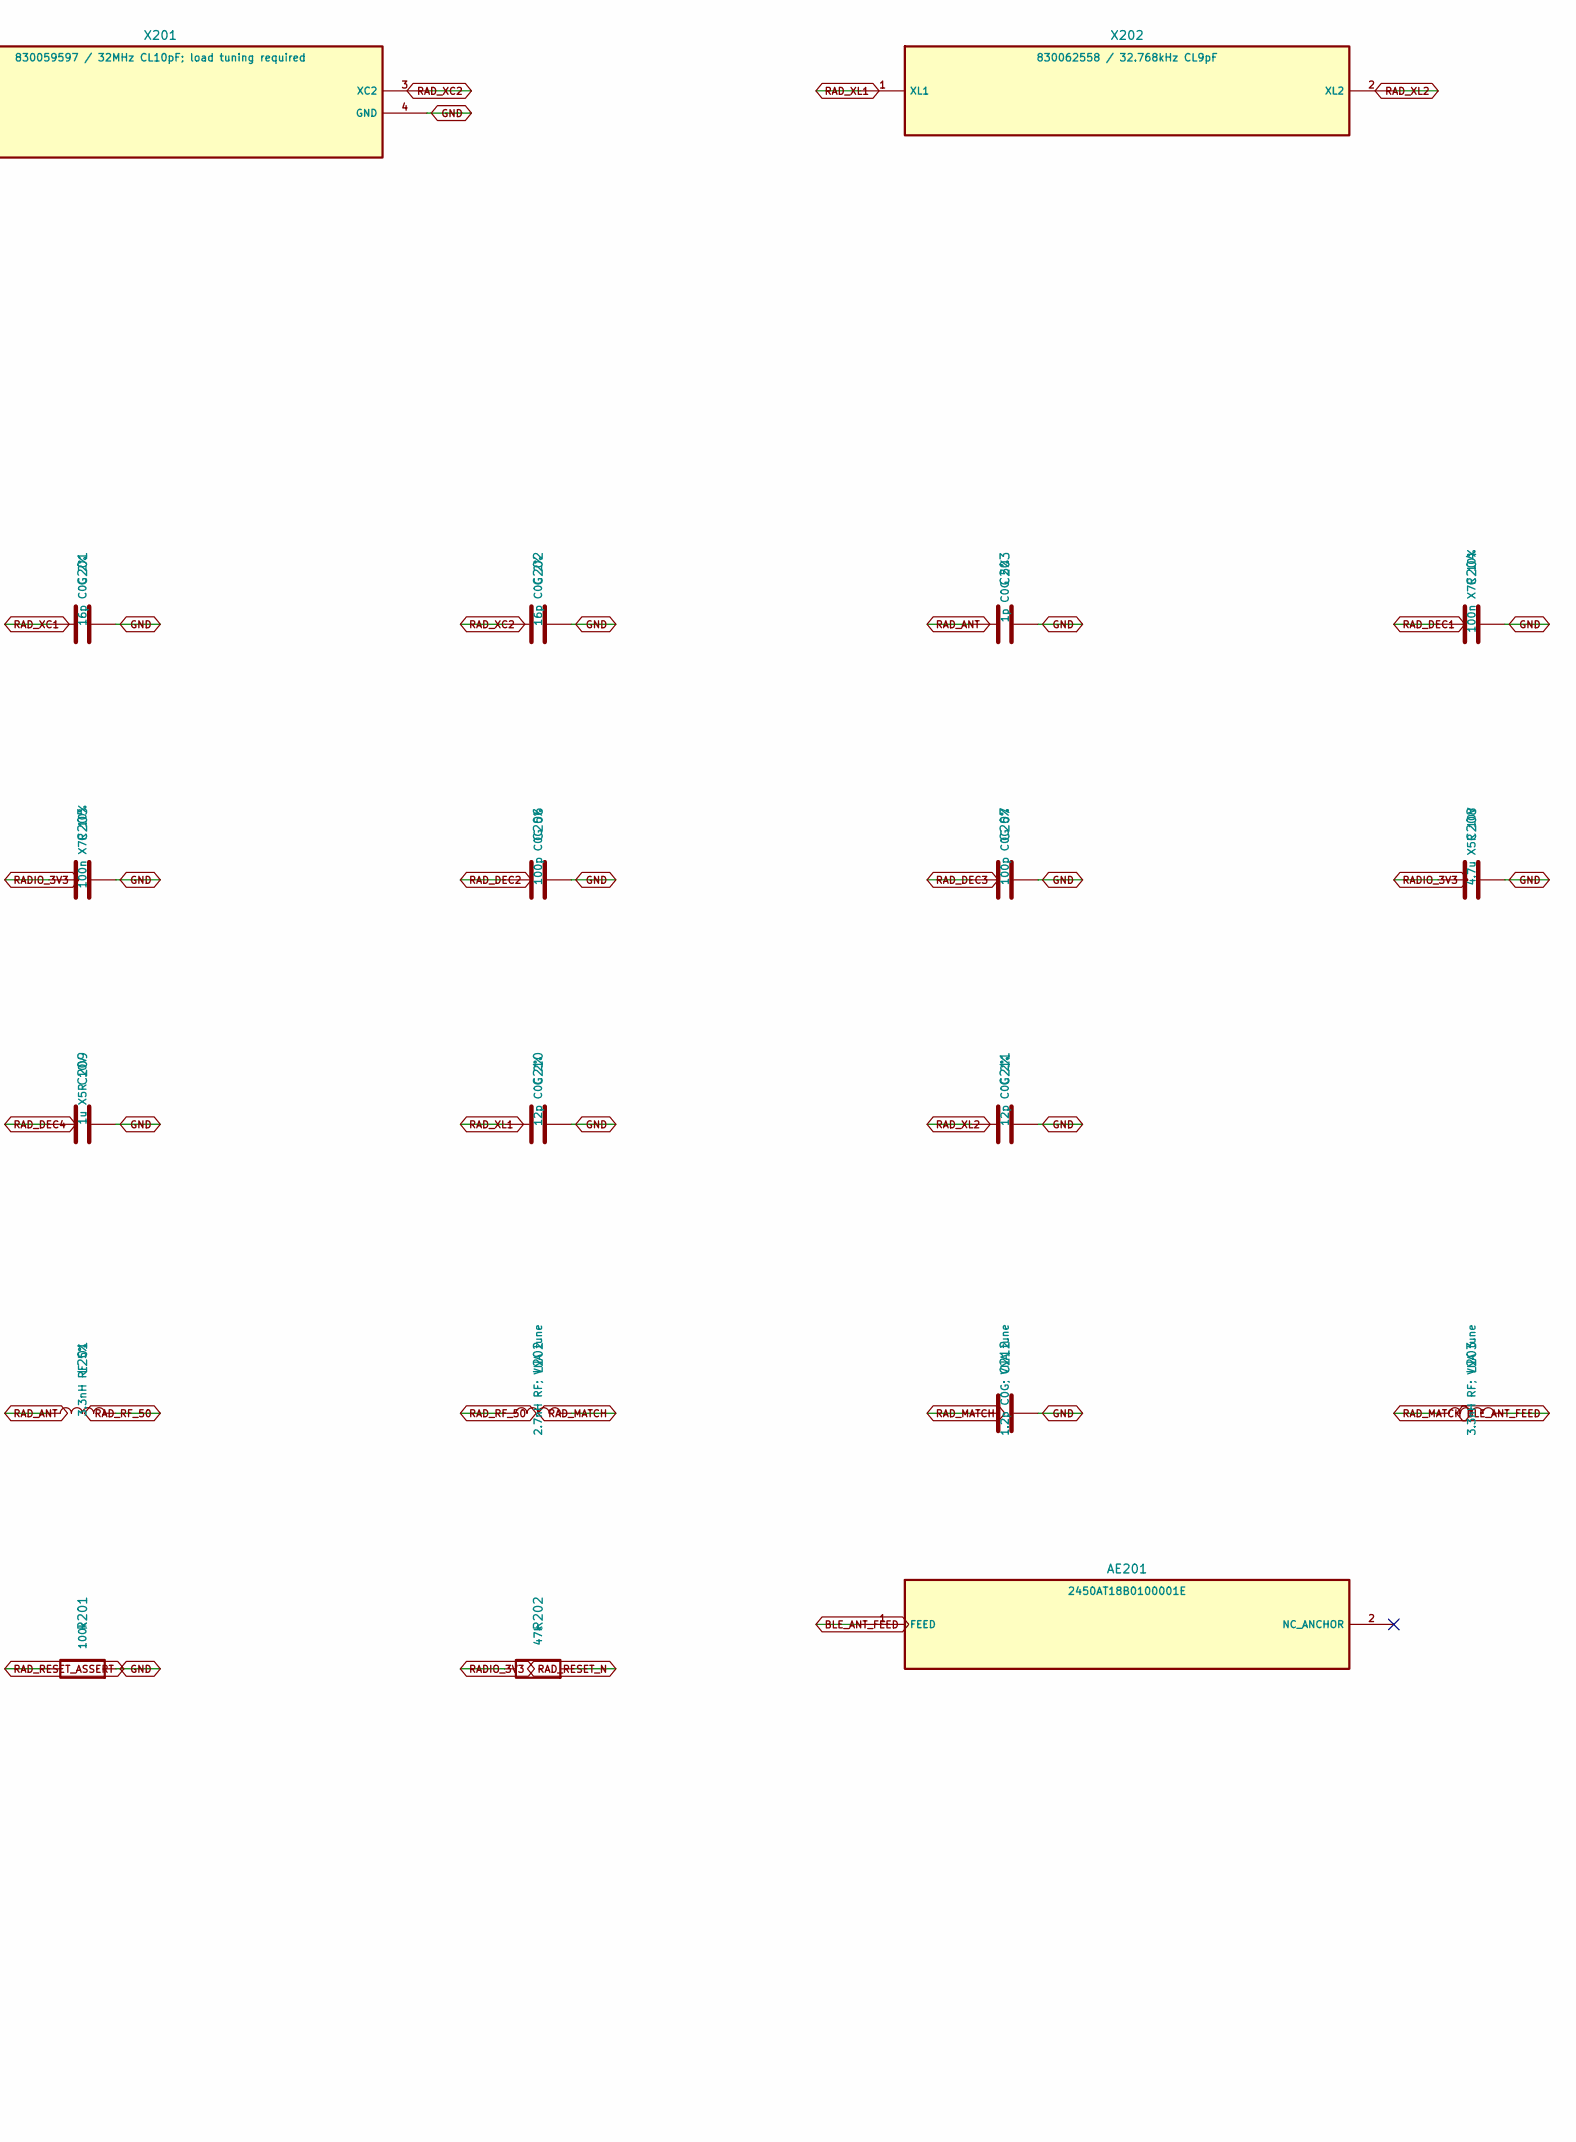
[picture p38: schematic circuit-radio.kicad_sch, Untrusted Bluetooth radio and RF front end, part in row 1, column 2]

Parts:
AE201: 2450AT18B0100001E; Johanson_2450AT18x100
C201, C202: 16p C0G 2%; C_0201_0603Metric
C203: 1p C0G 5%; C_0201_0603Metric
C204, C205: 100n X7R 10%; C_0201_0603Metric
C206, C207: 100p C0G 5%; C_0201_0603Metric
C208: 4.7u X5R 10V; C_0603_1608Metric
C209: 1u X5R 10V; C_0402_1005Metric
C210, C211: 12p C0G 2%; C_0201_0603Metric
C212: 1.2p C0G; VNA tune; C_0402_1005Metric
J102: FTSH-105-01-L-DV / radio SWD; Samtec_FTSH-105-01-L-DV
L201: 3.3nH RF 5%; L_0201_0603Metric
L202: 2.7nH RF; VNA tune; L_0402_1005Metric
L203: 3.3nH RF; VNA tune; L_0402_1005Metric
Q201: 2N7002; SOT-23
R201: 100k; R_0402_1005Metric
R202: 47k; R_0402_1005Metric
U6: nRF52832-CIAA; nRF52832_CIAA_Nordic
X201: 830059597 / 32MHz CL10pF; load tuning required; Crystal_SMD_2016-4Pin_2.0x1.6mm
X202: 830062558 / 32.768kHz CL9pF; Crystal_SMD_2012-2Pin_2.0x1.2mm

Connections:
BLE_ANT_FEED: AE201.1 (FEED), L203.2
GND: C201.2, C202.2, C203.2, C204.2, C205.2, C206.2, C207.2, C208.2, C209.2, C210.2, C211.2, C212.2, J102.3 (GND), J102.5 (GND), J102.9 (GND), Q201.2 (S), R201.2, U6.C4 (GND), U6.C5 (GND), U6.D2 (VSS_PA), U6.E3 (GND), U6.F5 (GND), X201.2 (GND), X201.4 (GND); also elsewhere on the board
RADIO_3V3: C205.1, C208.1, J102.1 (VTREF_SENSE), R202.1, U6.A7 (VDD), U6.H7 (VDD); also elsewhere on the board
RAD_ANT: C203.1, L201.1, U6.D1 (ANT)
RAD_CREDIT: U6.H6 (P0.12); also elsewhere on the board
RAD_CTS: U6.F6 (P0.07); also elsewhere on the board
RAD_DEC1: C204.1, U6.B7 (DEC1)
RAD_DEC2: C206.1, U6.A2 (DEC2)
RAD_DEC3: C207.1, U6.C2 (DEC3)
RAD_DEC4: C209.1, U6.A6 (DEC4)
RAD_MATCH: C212.1, L202.2, L203.1
RAD_PENDING: U6.F4 (P0.11); also elsewhere on the board
RAD_RESET_ASSERT: Q201.1 (G), R201.1; also elsewhere on the board
RAD_RESET_N: J102.10 (nRESET), Q201.3 (D), R202.2, U6.H1 (P0.21)
RAD_RF_50: L201.2, L202.1
RAD_RTS: U6.E7 (P0.05/AIN3); also elsewhere on the board
RAD_RX: U6.G7 (P0.08); also elsewhere on the board
RAD_SWDCLK: J102.4 (SWDCLK), U6.F1 (SWDCLK)
RAD_SWDIO: J102.2 (SWDIO), U6.G1 (SWDIO)
RAD_TX: U6.F7 (P0.06); also elsewhere on the board
RAD_XC1: C201.1, U6.B2 (XC1), X201.1 (XC1)
RAD_XC2: C202.1, U6.A1 (XC2), X201.3 (XC2)
RAD_XL1: C210.1, U6.D7 (P0.00/XL1), X202.1 (XL1)
RAD_XL2: C211.1, U6.C7 (P0.01/XL2), X202.2 (XL2)

Notes on the sheet:
Radio is an untrusted ciphertext transport. No shared trusted SPI/I2C/audio/debug nets.
LDO reference used: DCC ball B6 NC; radio firmware MUST leave DC/DC disabled.
Antenna T values are evaluation-board starting values; new PCB needs VNA and radiated tests.
Pin P0.21 reset requires UICR configuration; J102 has no main-MCU debug connection.
HF crystal uses CL10pF and 16p load capacitors, adapting the CL8pF Nordic reference. Verify clock accuracy/drive over voltage and temperature.

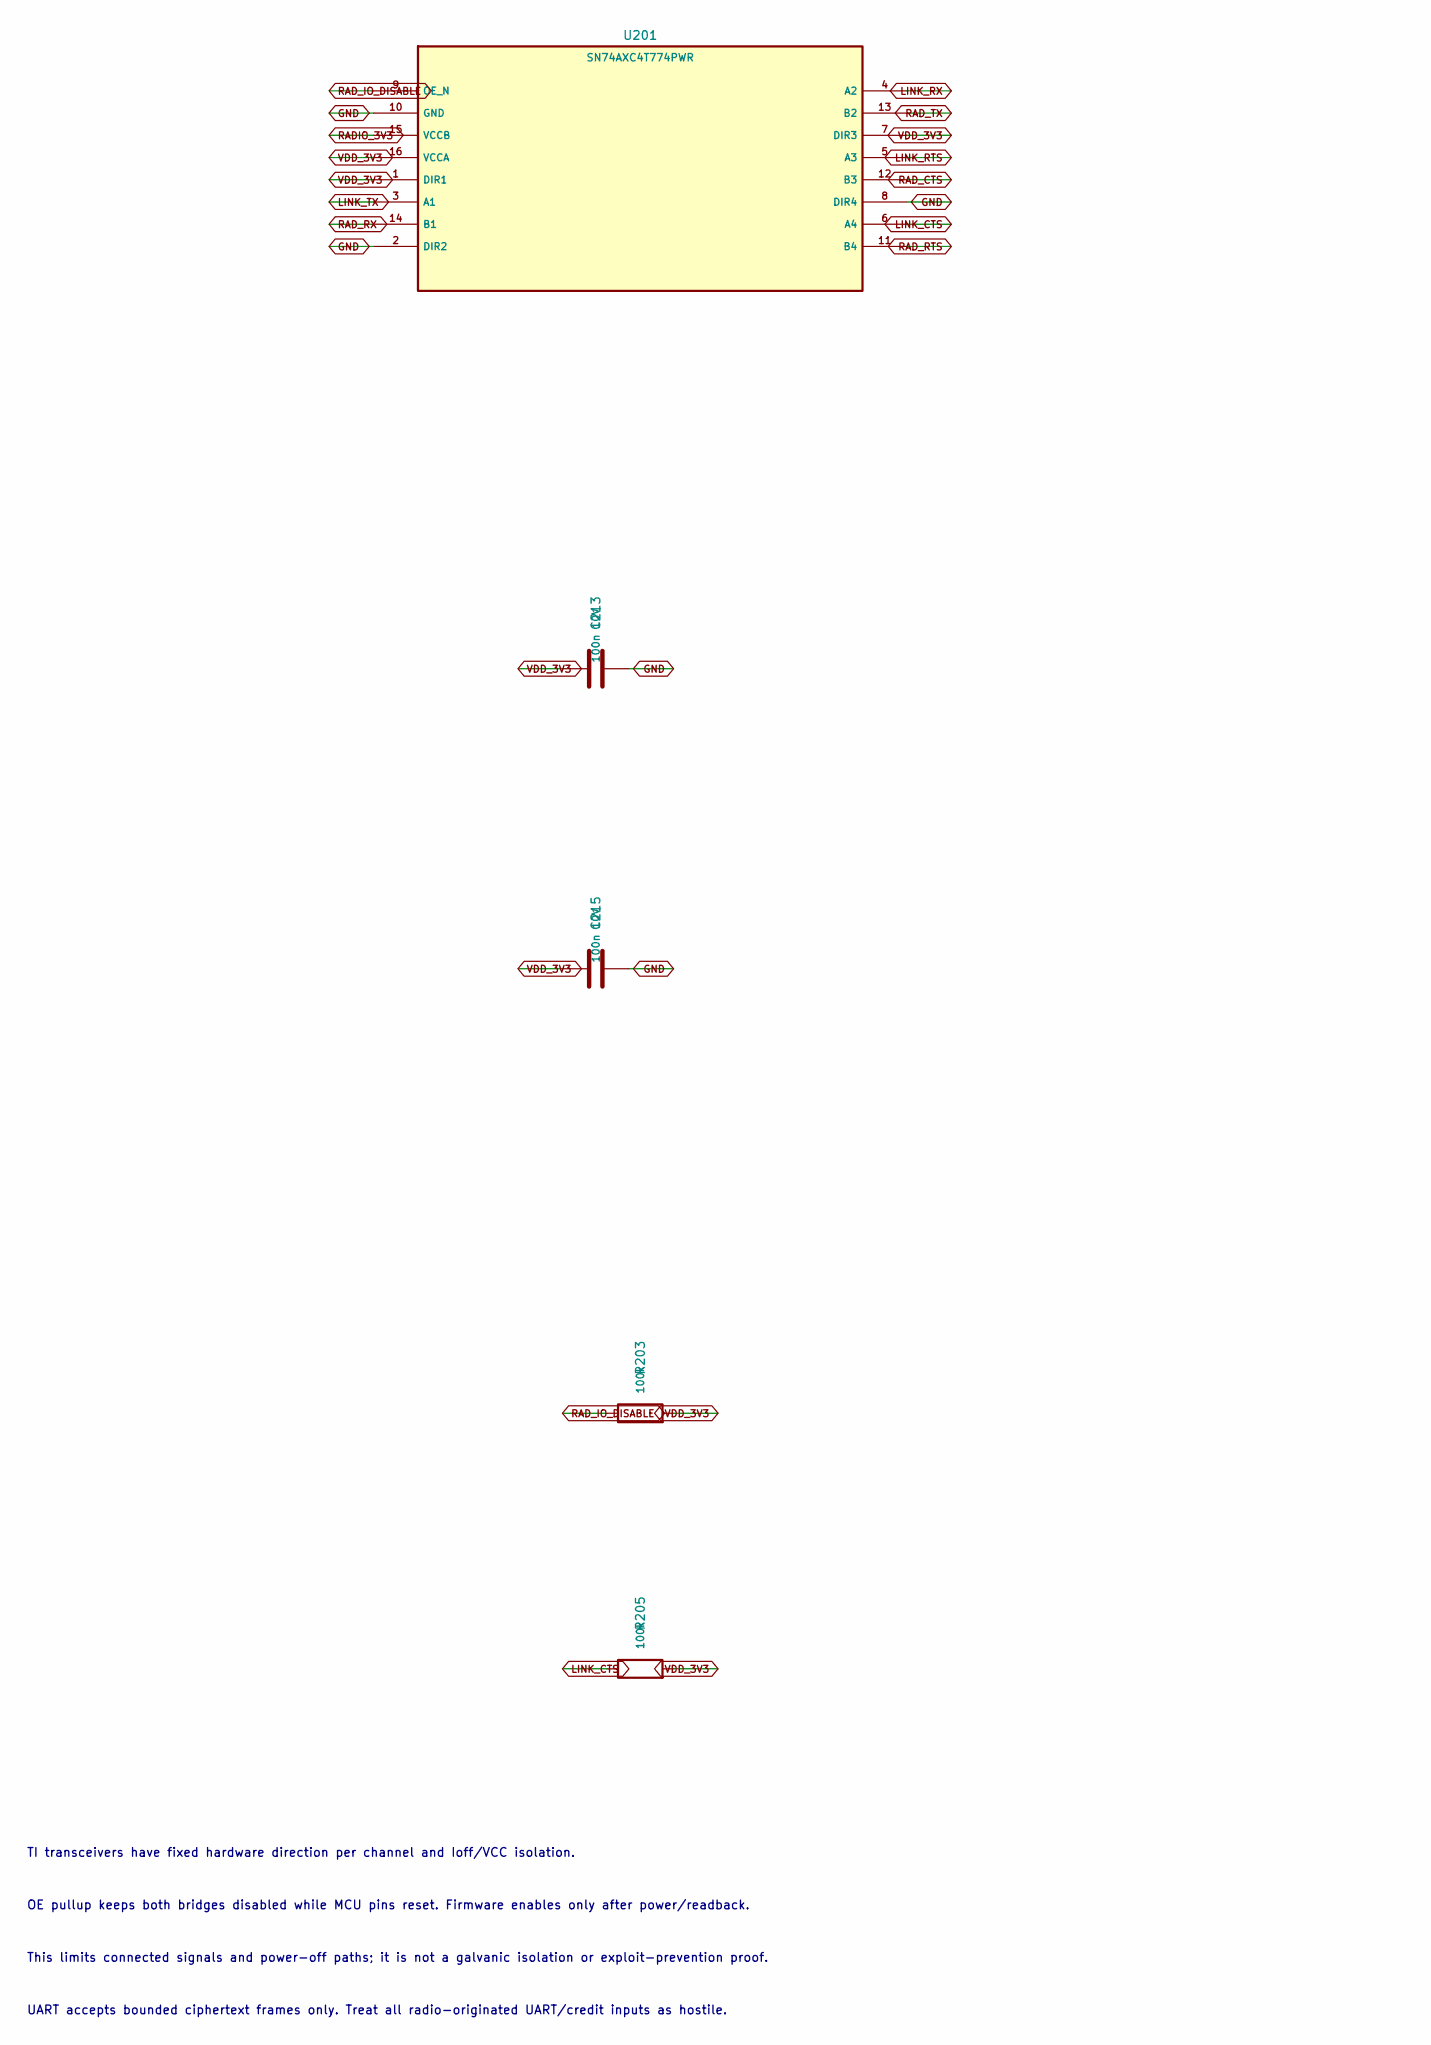
[picture p39: schematic circuit-radio-interface.kicad_sch, Default-disabled radio signal boundary, part in row 1, column 1]

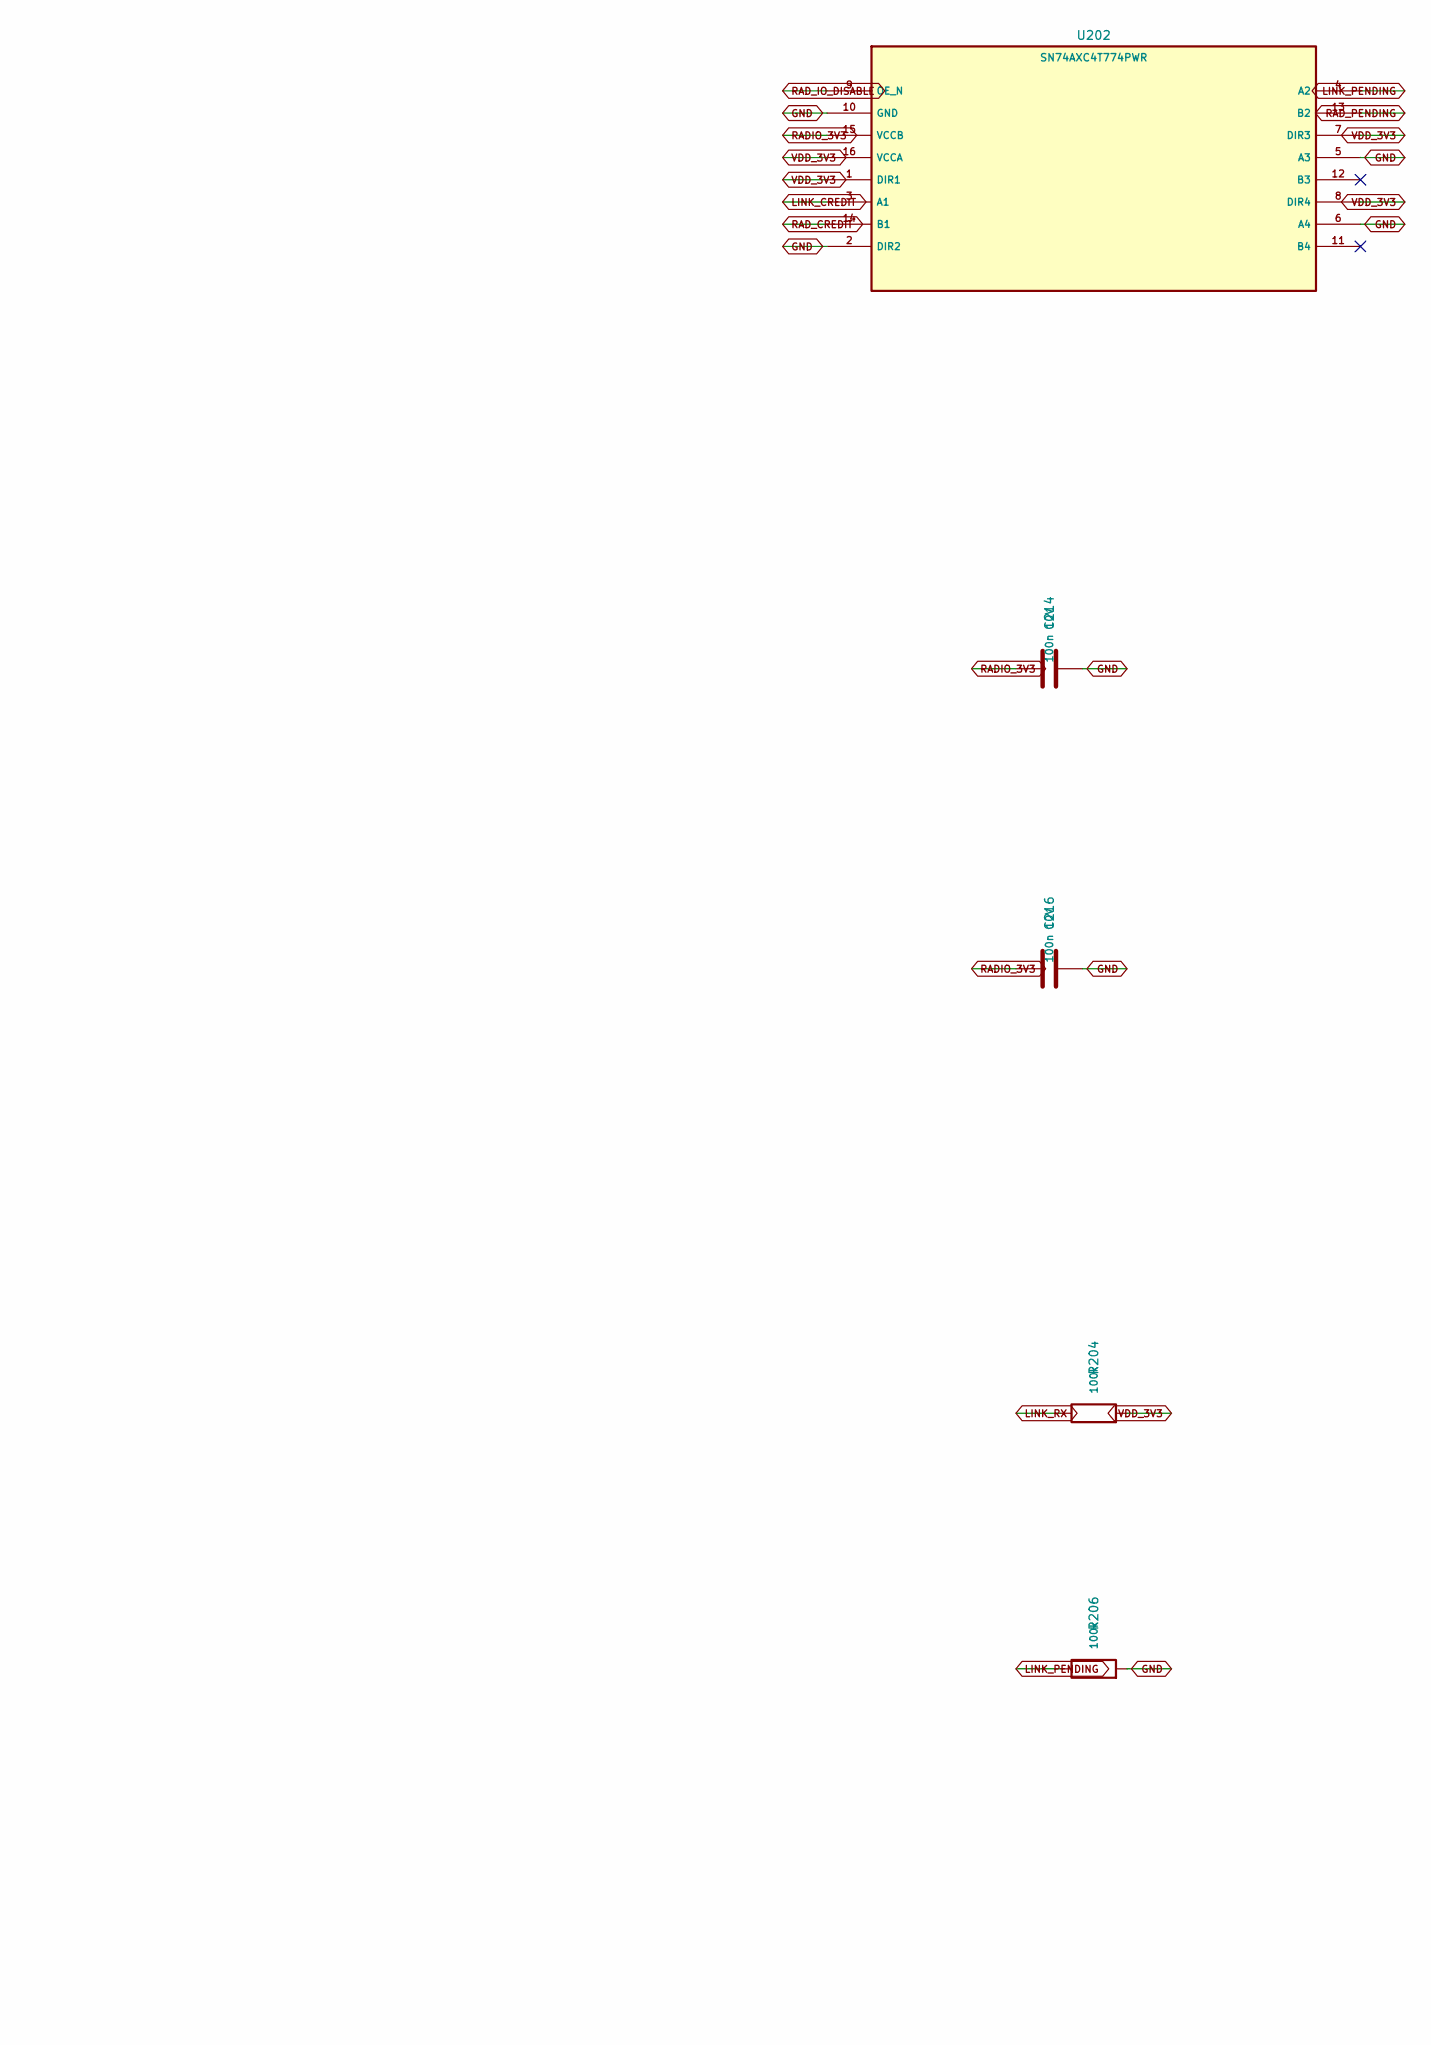
[picture p40: schematic circuit-radio-interface.kicad_sch, Default-disabled radio signal boundary, part in row 1, column 2]

Parts:
C213, C214, C215, C216: 100n 10V; C_0402_1005Metric
R203, R204, R205, R206: 100k; R_0402_1005Metric
U201, U202: SN74AXC4T774PWR; TSSOP-16_4.4x5mm_P0.65mm

Connections:
GND: C213.2, C214.2, C215.2, C216.2, R206.2, U201.2 (DIR2), U201.8 (DIR4), U201.10 (GND), U202.2 (DIR2), U202.5 (A3), U202.6 (A4), U202.10 (GND); also elsewhere on the board
LINK_CREDIT: U202.3 (A1); also elsewhere on the board
LINK_CTS: R205.1, U201.6 (A4); also elsewhere on the board
LINK_PENDING: R206.1, U202.4 (A2); also elsewhere on the board
LINK_RTS: U201.5 (A3); also elsewhere on the board
LINK_RX: R204.1, U201.4 (A2); also elsewhere on the board
LINK_TX: U201.3 (A1); also elsewhere on the board
RADIO_3V3: C214.1, C216.1, U201.15 (VCCB), U202.15 (VCCB); also elsewhere on the board
RAD_CREDIT: U202.14 (B1); also elsewhere on the board
RAD_CTS: U201.12 (B3); also elsewhere on the board
RAD_IO_DISABLE: R203.1, U201.9 (OE_N), U202.9 (OE_N); also elsewhere on the board
RAD_PENDING: U202.13 (B2); also elsewhere on the board
RAD_RTS: U201.11 (B4); also elsewhere on the board
RAD_RX: U201.14 (B1); also elsewhere on the board
RAD_TX: U201.13 (B2); also elsewhere on the board
VDD_3V3: C213.1, C215.1, R203.2, R204.2, R205.2, U201.1 (DIR1), U201.7 (DIR3), U201.16 (VCCA), U202.1 (DIR1), U202.7 (DIR3), U202.8 (DIR4), U202.16 (VCCA); also elsewhere on the board

Notes on the sheet:
TI transceivers have fixed hardware direction per channel and Ioff/VCC isolation.
OE pullup keeps both bridges disabled while MCU pins reset. Firmware enables only after power/readback.
This limits connected signals and power-off paths; it is not a galvanic isolation or exploit-prevention proof.
UART accepts bounded ciphertext frames only. Treat all radio-originated UART/credit inputs as hostile.

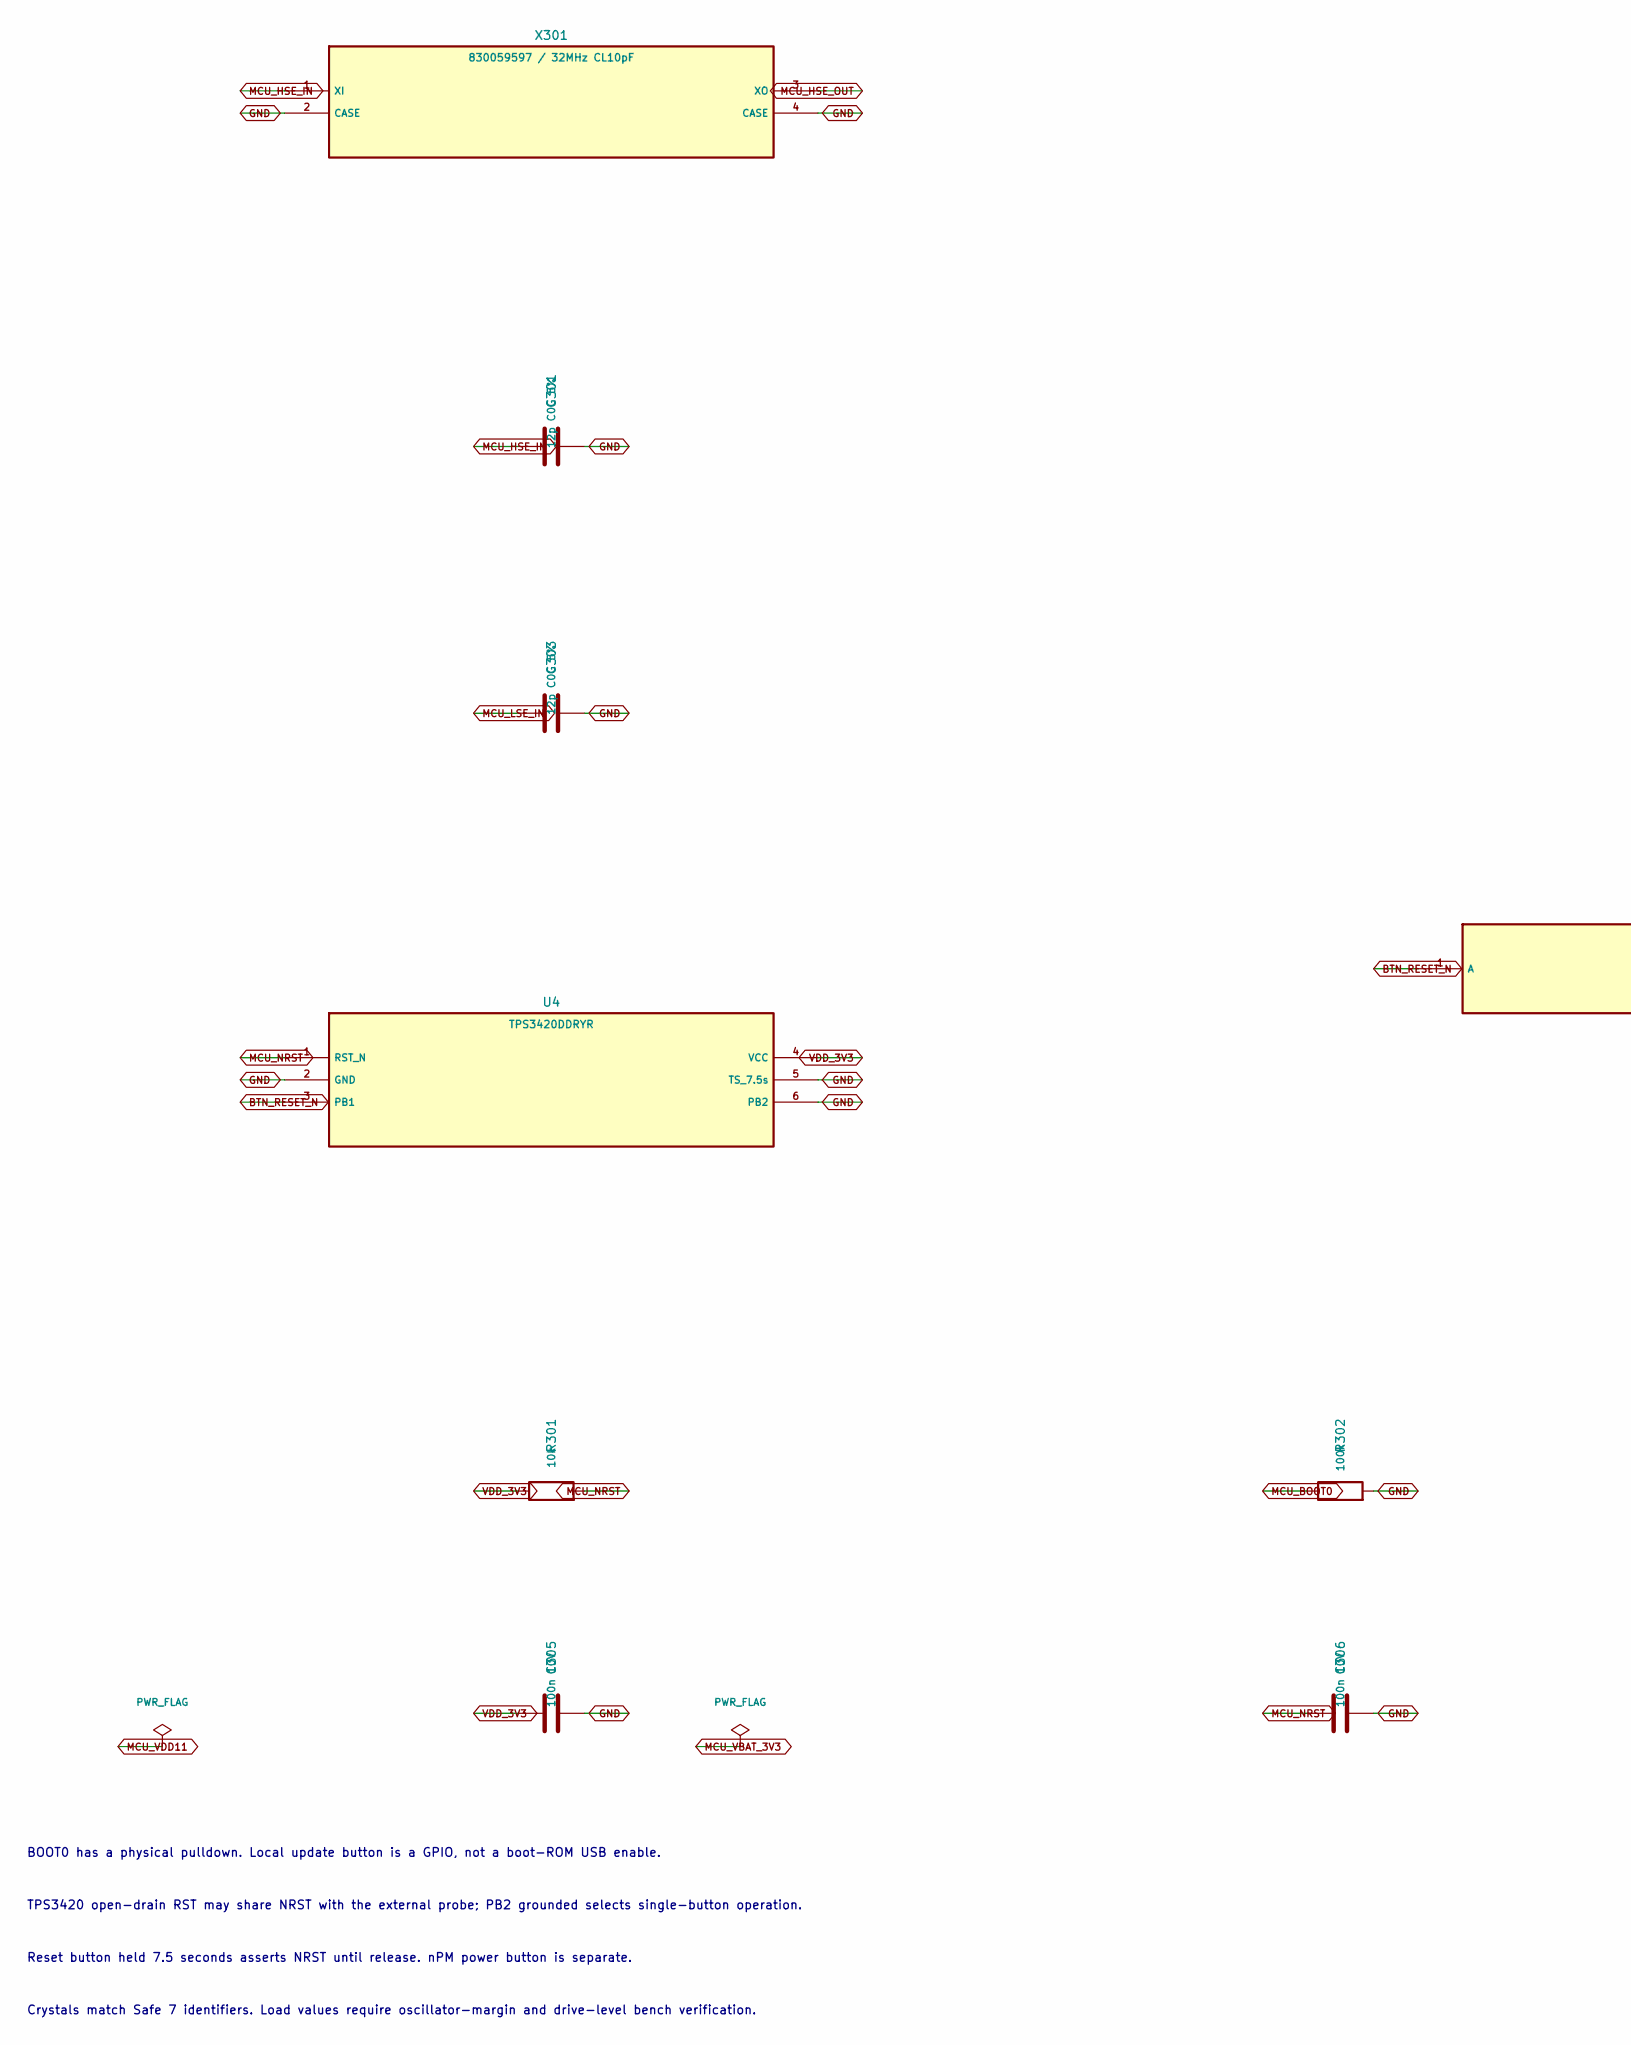
[picture p41: schematic circuit-control.kicad_sch, MCU clocks and local recovery controls, part in row 1, column 1]

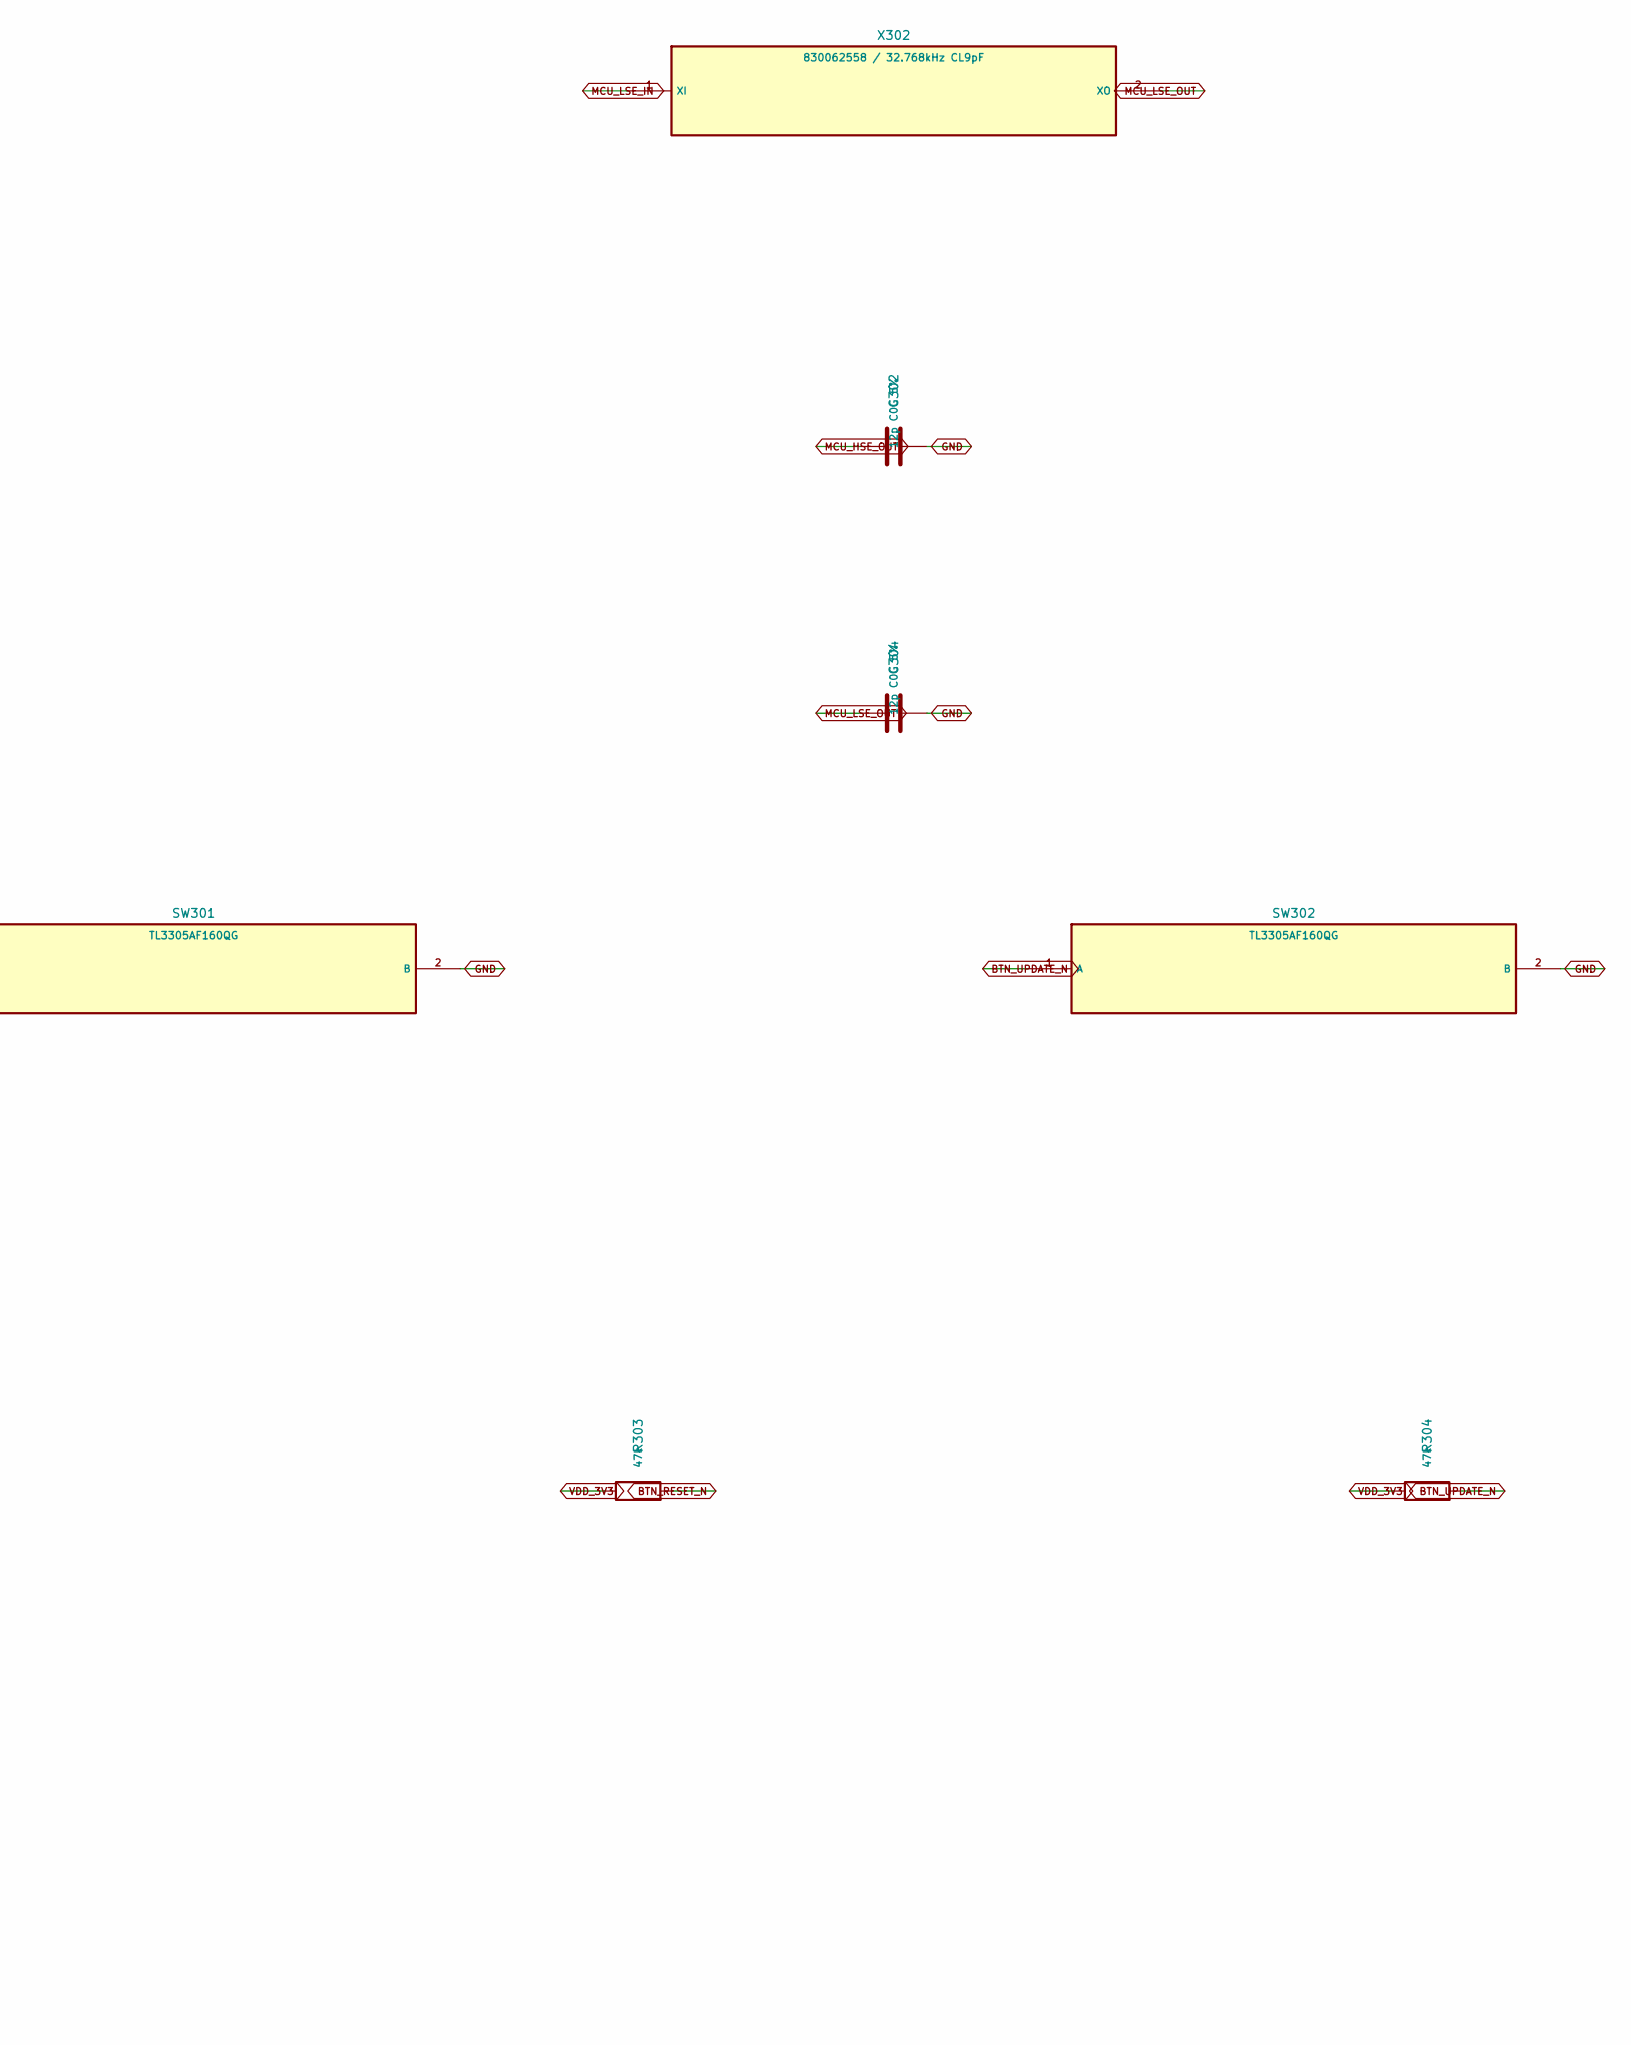
[picture p42: schematic circuit-control.kicad_sch, MCU clocks and local recovery controls, part in row 1, column 2]

Parts:
C301, C302, C303, C304: 12p C0G 5%; C_0402_1005Metric
C305, C306: 100n 10V; C_0402_1005Metric
R301: 10k; R_0402_1005Metric
R302: 100k; R_0402_1005Metric
R303, R304: 47k; R_0402_1005Metric
SW301, SW302: TL3305AF160QG; SW_SPST_TL3305A
U4: TPS3420DDRYR; Texas_USON-6_1x1.45mm_P0.5mm_SMD
X301: 830059597 / 32MHz CL10pF; Crystal_SMD_2016-4Pin_2.0x1.6mm
X302: 830062558 / 32.768kHz CL9pF; Crystal_SMD_2012-2Pin_2.0x1.2mm

Connections:
BTN_RESET_N: R303.2, SW301.1 (A), U4.3 (PB1); also elsewhere on the board
BTN_UPDATE_N: R304.2, SW302.1 (A); also elsewhere on the board
GND: C301.2, C302.2, C303.2, C304.2, C305.2, C306.2, R302.2, SW301.2 (B), SW302.2 (B), U4.2 (GND), U4.5 (TS_7.5s), U4.6 (PB2), X301.2 (CASE), X301.4 (CASE); also elsewhere on the board
MCU_BOOT0: R302.1; also elsewhere on the board
MCU_HSE_IN: C301.1, X301.1 (XI); also elsewhere on the board
MCU_HSE_OUT: C302.1, X301.3 (XO); also elsewhere on the board
MCU_LSE_IN: C303.1, X302.1 (XI); also elsewhere on the board
MCU_LSE_OUT: C304.1, X302.2 (XO); also elsewhere on the board
MCU_NRST: C306.1, R301.2, U4.1 (RST_N); also elsewhere on the board
VDD_3V3: C305.1, R301.1, R303.1, R304.1, U4.4 (VCC); also elsewhere on the board

Notes on the sheet:
BOOT0 has a physical pulldown. Local update button is a GPIO, not a boot-ROM USB enable.
TPS3420 open-drain RST may share NRST with the external probe; PB2 grounded selects single-button operation.
Reset button held 7.5 seconds asserts NRST until release. nPM power button is separate.
Crystals match Safe 7 identifiers. Load values require oscillator-margin and drive-level bench verification.
