adlererik/voicevault/hardware/rev-b/voicevault-standalone-b0.kicad_pcb

## KiCad design hardware/rev-b/voicevault-standalone-b0.kicad_pcb (continued)

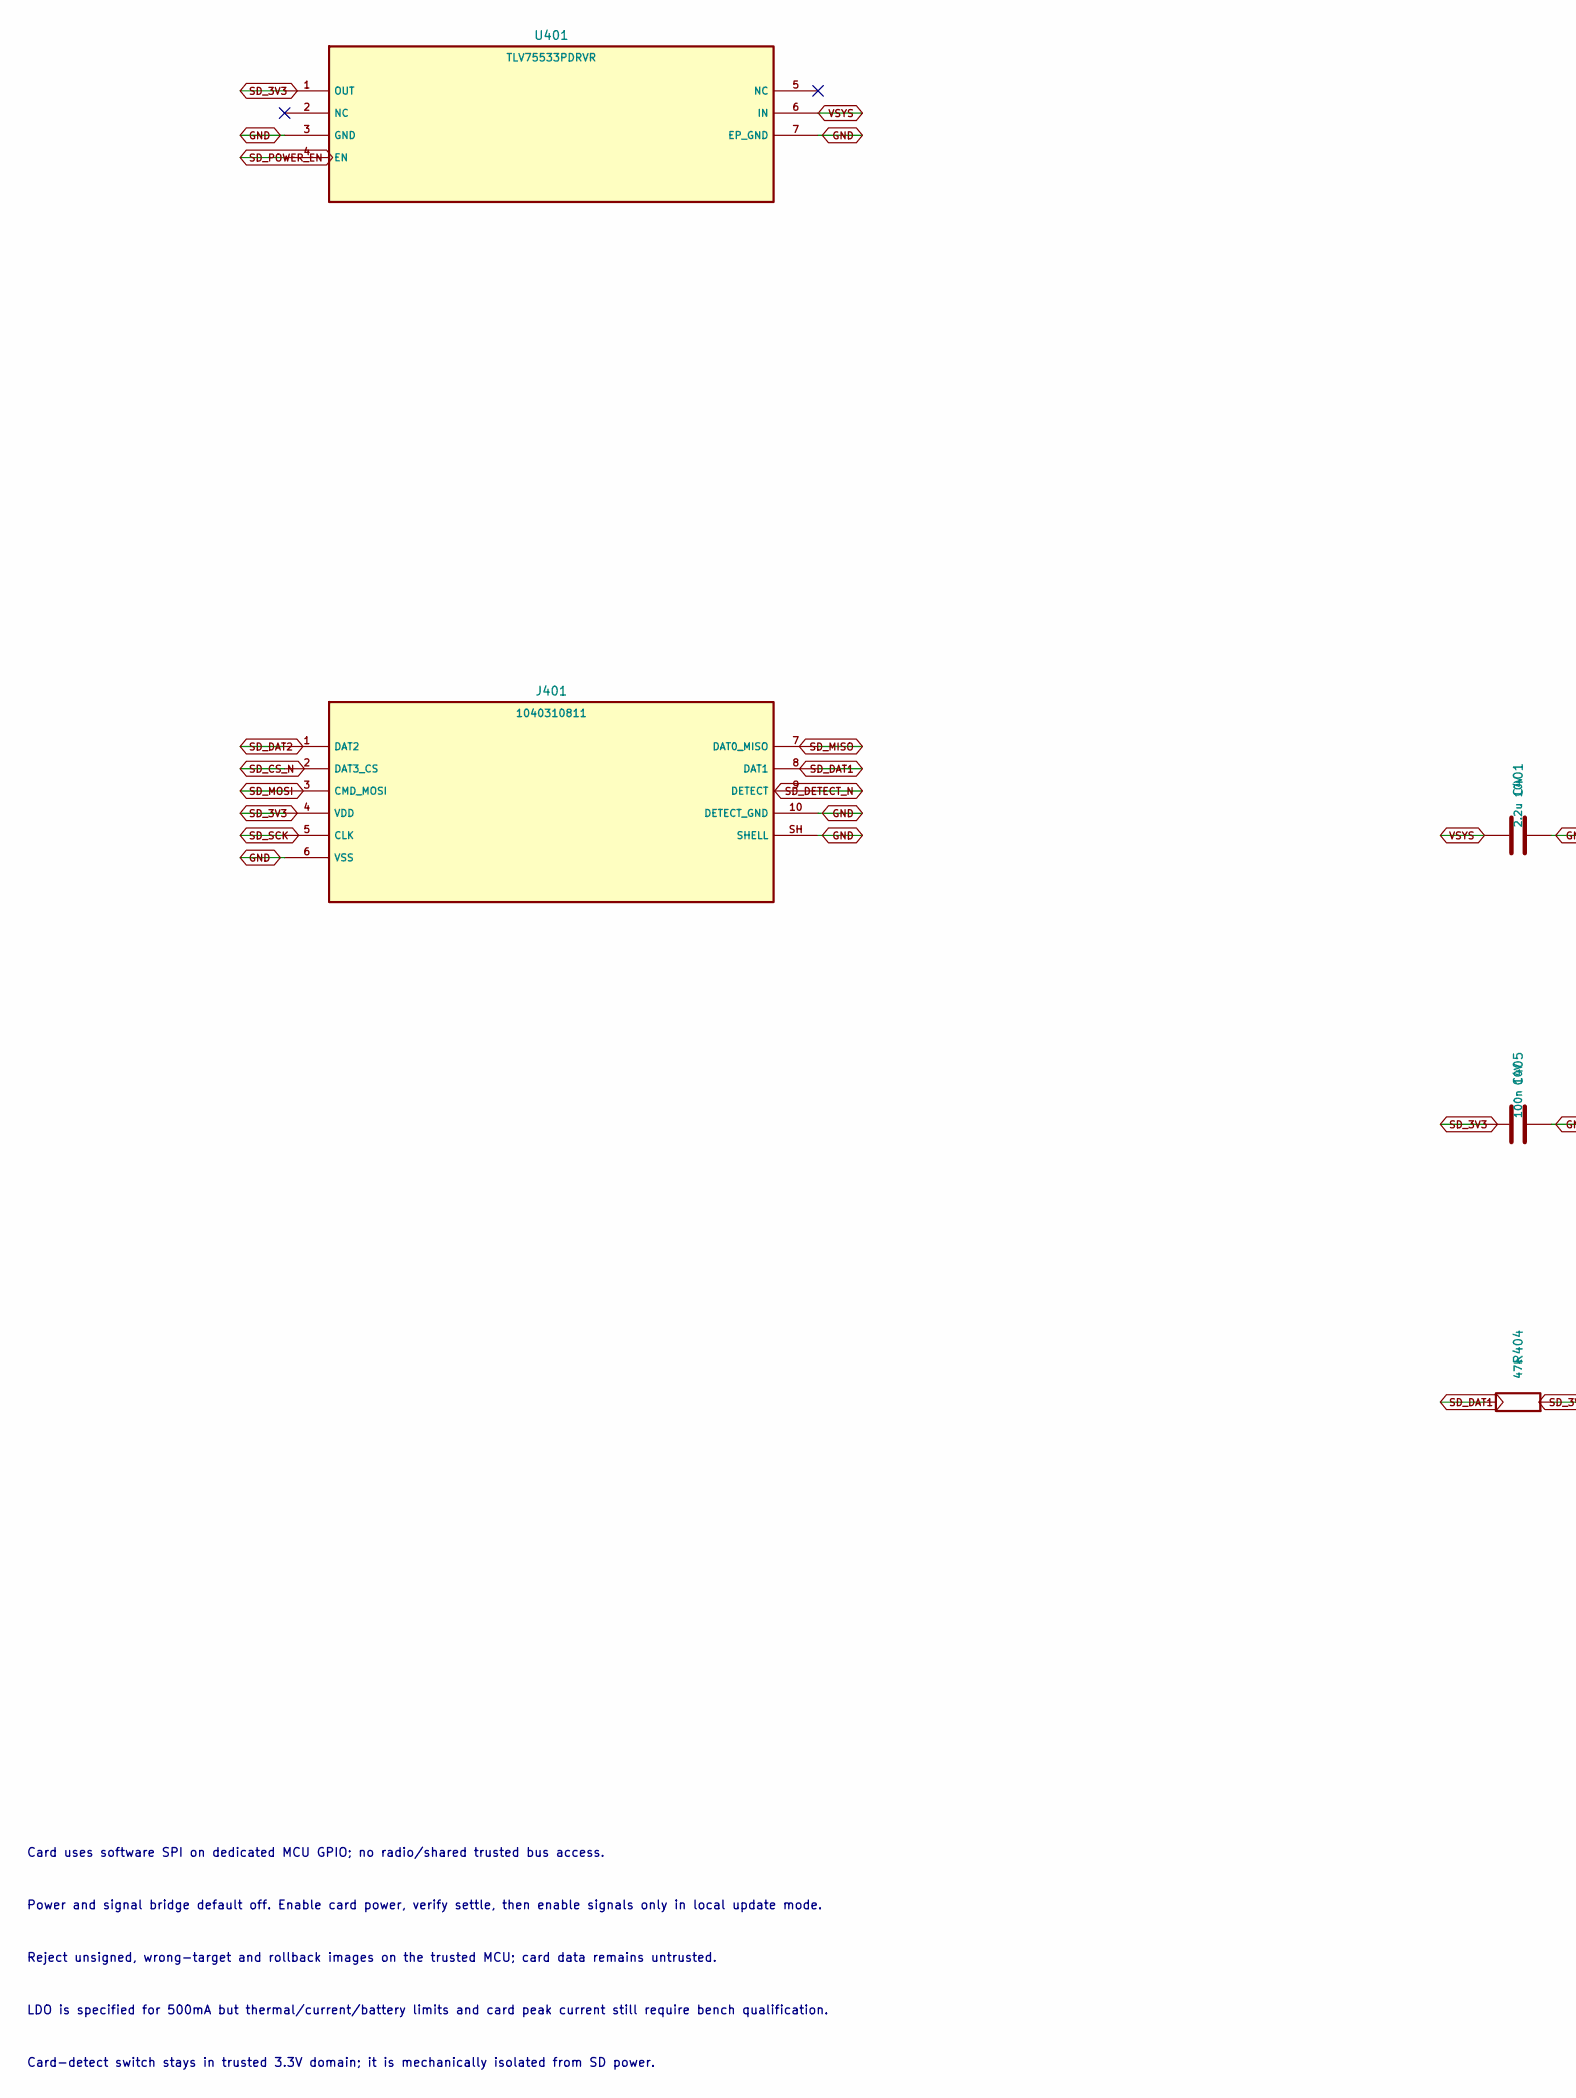
[picture p43: schematic circuit-microsd.kicad_sch, Locally enabled offline-update card, part in row 1, column 1]

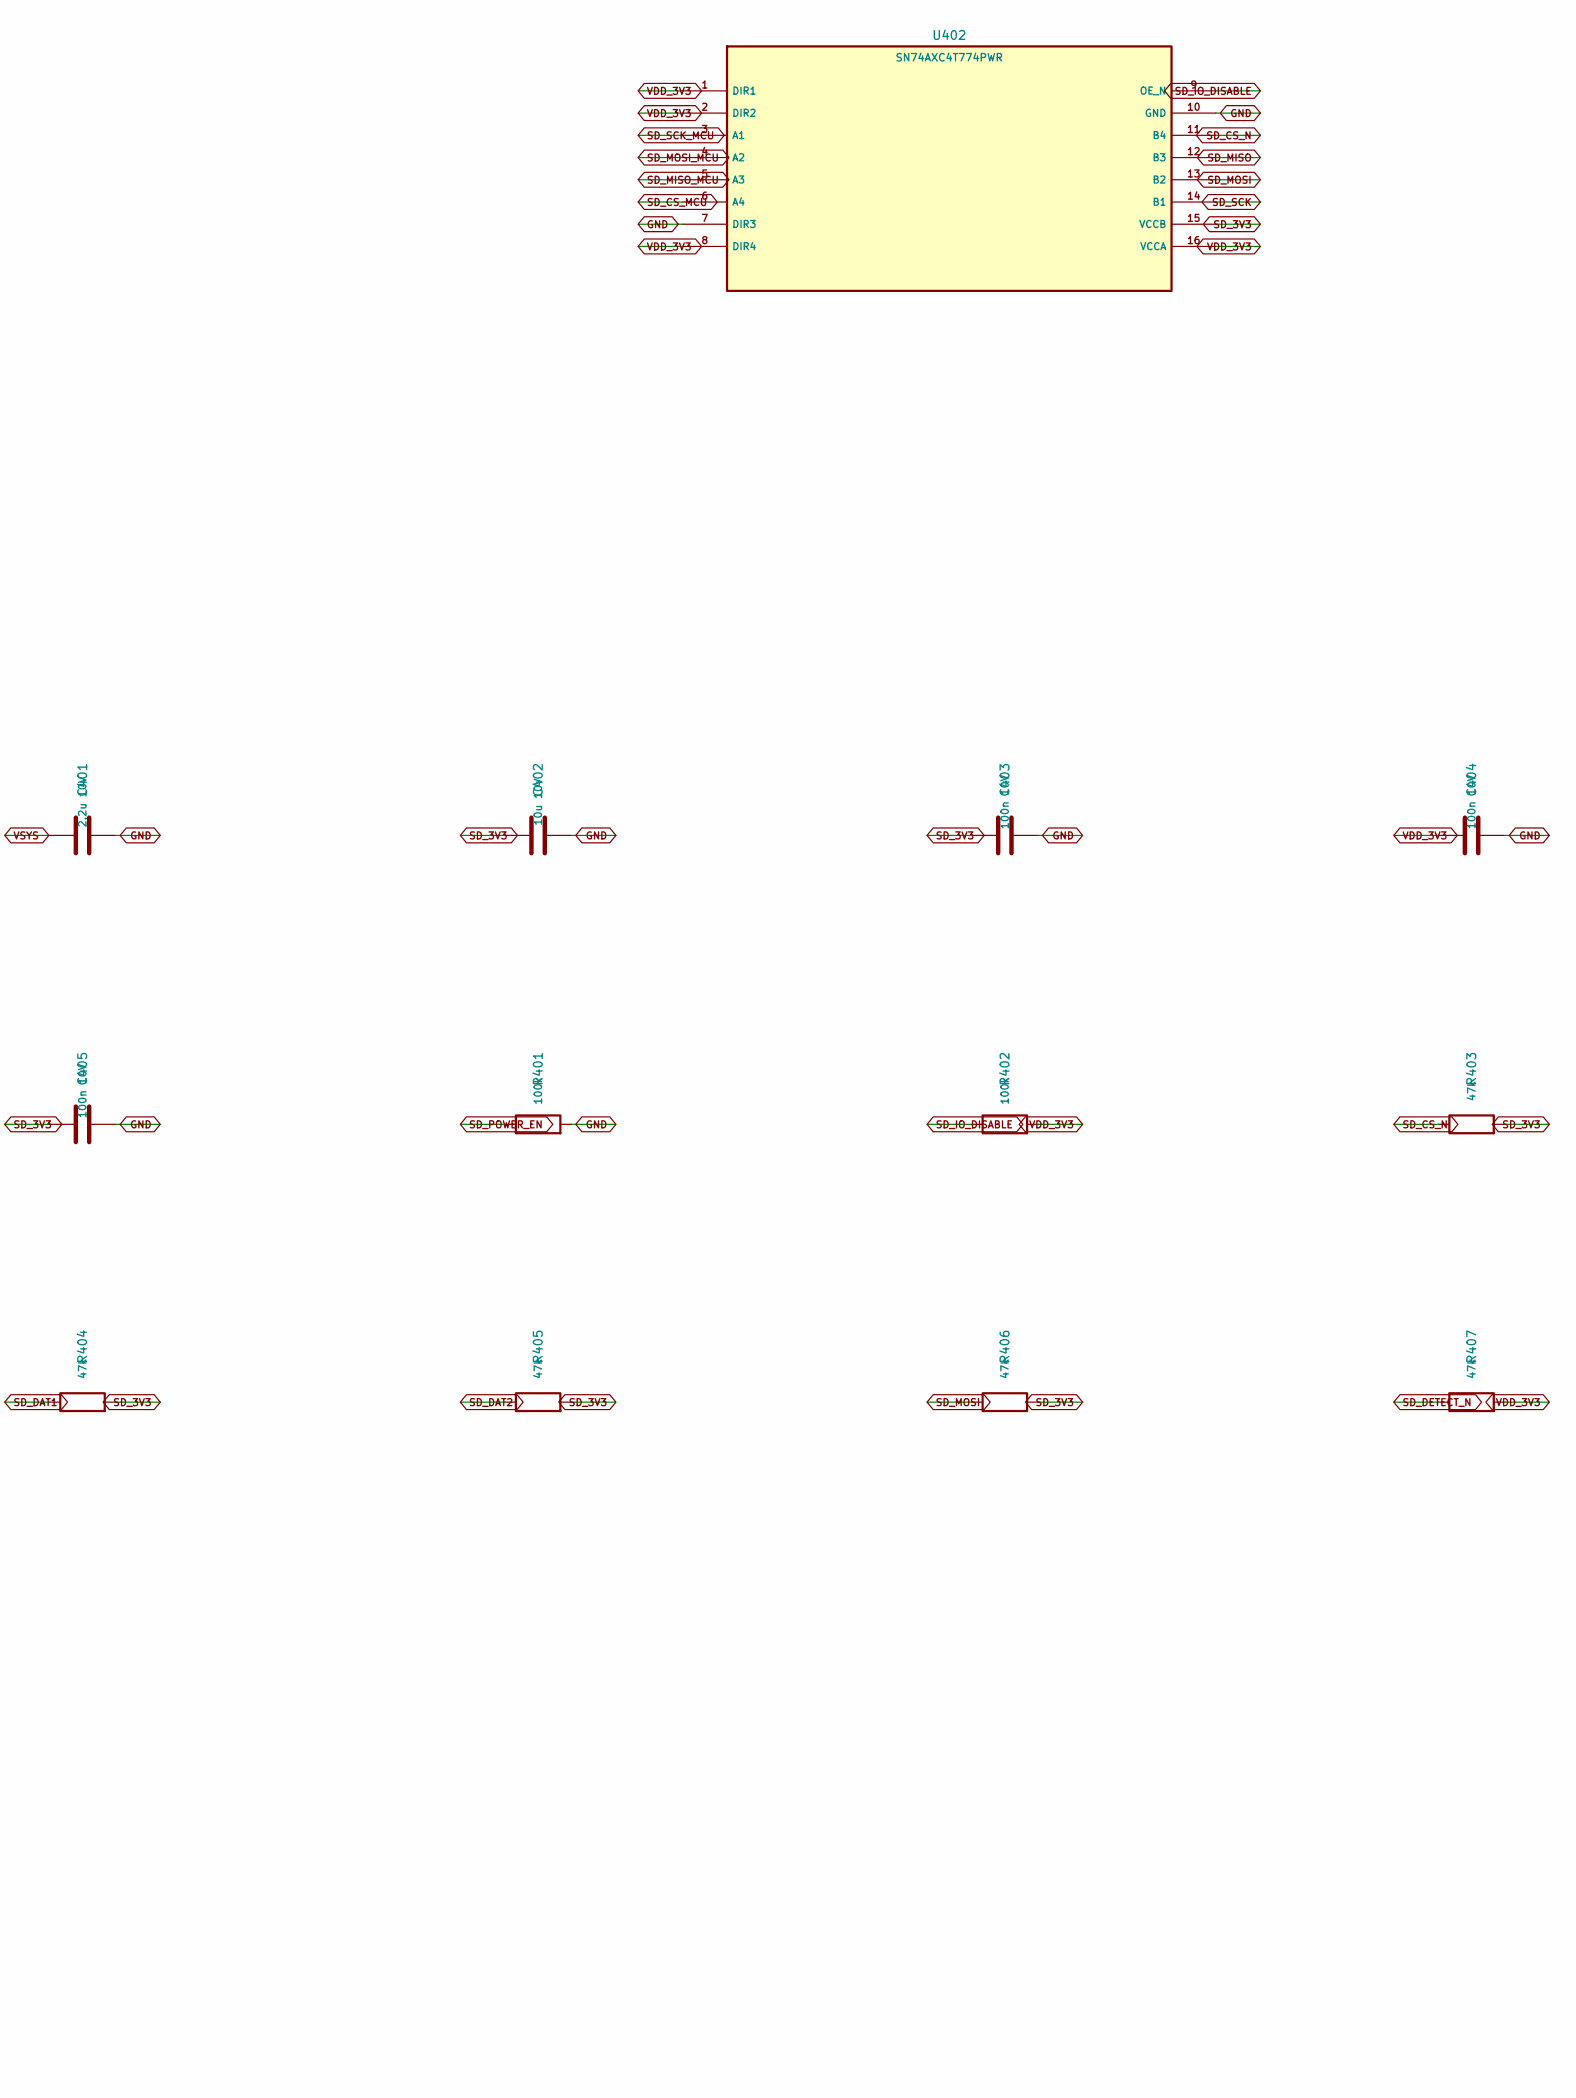
[picture p44: schematic circuit-microsd.kicad_sch, Locally enabled offline-update card, part in row 1, column 2]

Parts:
C401: 2.2u 10V; C_0603_1608Metric
C402: 10u 10V; C_0805_2012Metric
C403, C404, C405: 100n 10V; C_0402_1005Metric
J401: 1040310811; microSD_HC_Molex_104031-0811
R401, R402: 100k; R_0402_1005Metric
R403, R404, R405, R406, R407: 47k; R_0402_1005Metric
U401: TLV75533PDRVR; TI_DRV0006A_WSON6_2x2_EP1x1p6
U402: SN74AXC4T774PWR; TSSOP-16_4.4x5mm_P0.65mm

Connections:
GND: C401.2, C402.2, C403.2, C404.2, C405.2, J401.6 (VSS), J401.10 (DETECT_GND), J401.SH (SHELL), R401.2, U401.3 (GND), U401.7 (EP_GND), U402.7 (DIR3), U402.10 (GND); also elsewhere on the board
SD_3V3: C402.1, C403.1, C405.1, J401.4 (VDD), R403.2, R404.2, R405.2, R406.2, U401.1 (OUT), U402.15 (VCCB); also elsewhere on the board
SD_CS_MCU: U402.6 (A4); also elsewhere on the board
SD_CS_N: J401.2 (DAT3_CS), R403.1, U402.11 (B4)
SD_DAT1: J401.8 (DAT1), R404.1
SD_DAT2: J401.1 (DAT2), R405.1
SD_DETECT_N: J401.9 (DETECT), R407.1; also elsewhere on the board
SD_IO_DISABLE: R402.1, U402.9 (OE_N); also elsewhere on the board
SD_MISO: J401.7 (DAT0_MISO), U402.12 (B3)
SD_MISO_MCU: U402.5 (A3); also elsewhere on the board
SD_MOSI: J401.3 (CMD_MOSI), R406.1, U402.13 (B2)
SD_MOSI_MCU: U402.4 (A2); also elsewhere on the board
SD_POWER_EN: R401.1, U401.4 (EN); also elsewhere on the board
SD_SCK: J401.5 (CLK), U402.14 (B1)
SD_SCK_MCU: U402.3 (A1); also elsewhere on the board
VDD_3V3: C404.1, R402.2, R407.2, U402.1 (DIR1), U402.2 (DIR2), U402.8 (DIR4), U402.16 (VCCA); also elsewhere on the board
VSYS: C401.1, U401.6 (IN); also elsewhere on the board

Notes on the sheet:
Card uses software SPI on dedicated MCU GPIO; no radio/shared trusted bus access.
Power and signal bridge default off. Enable card power, verify settle, then enable signals only in local update mode.
Reject unsigned, wrong-target and rollback images on the trusted MCU; card data remains untrusted.
LDO is specified for 500mA but thermal/current/battery limits and card peak current still require bench qualification.
Card-detect switch stays in trusted 3.3V domain; it is mechanically isolated from SD power.

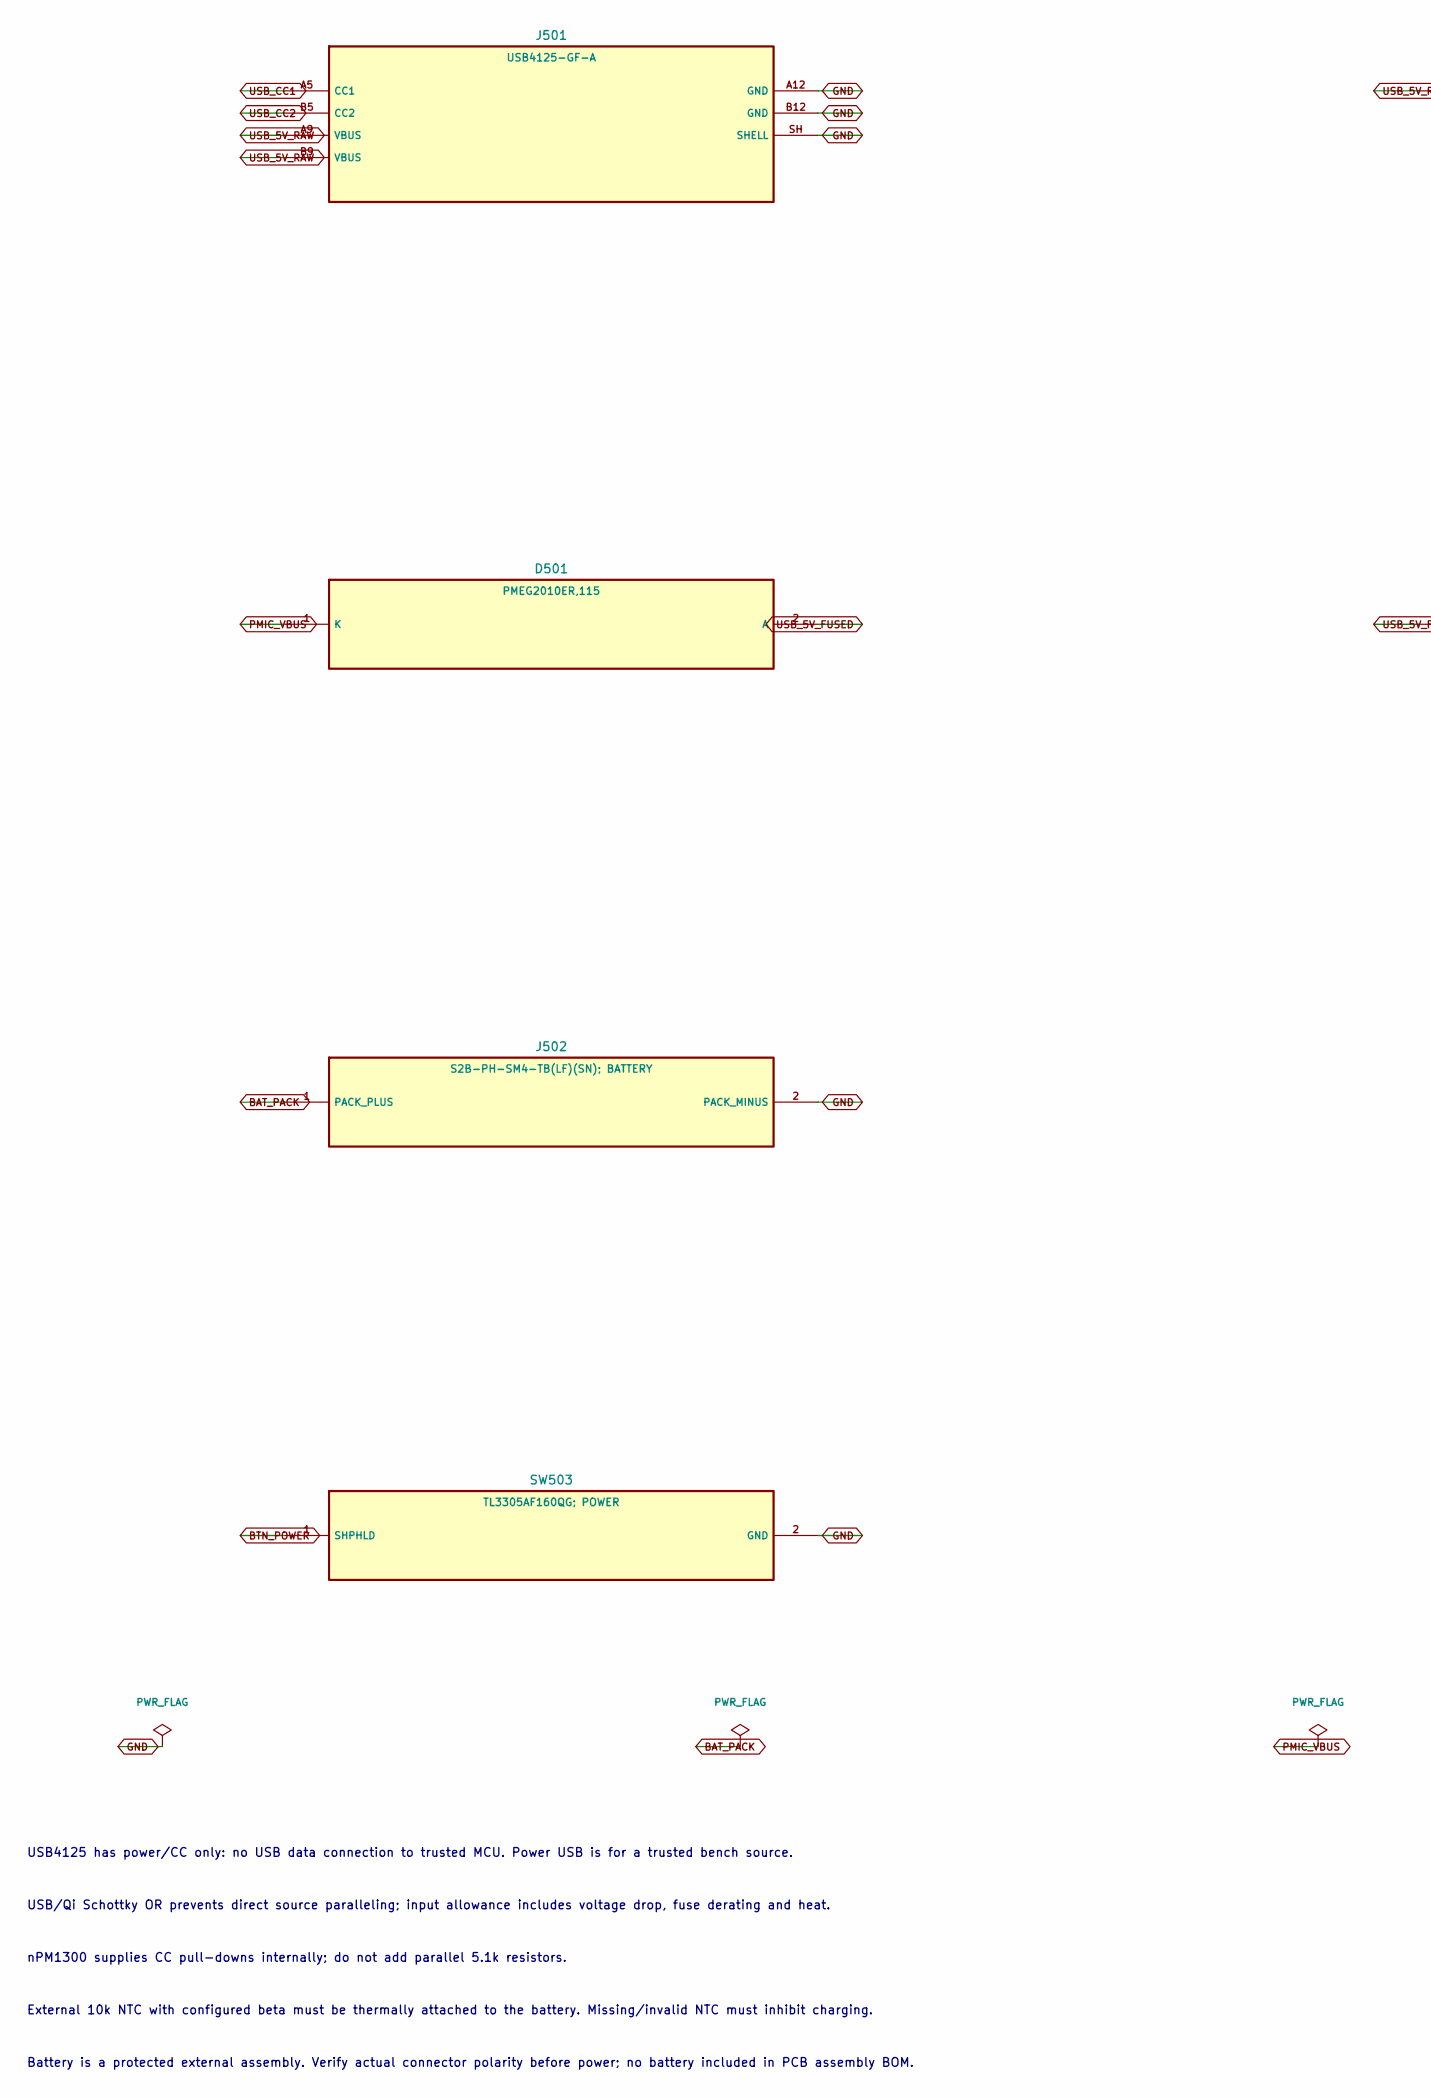
[picture p45: schematic circuit-power-entry.kicad_sch, USB, battery and local power entry, part in row 1, column 1]

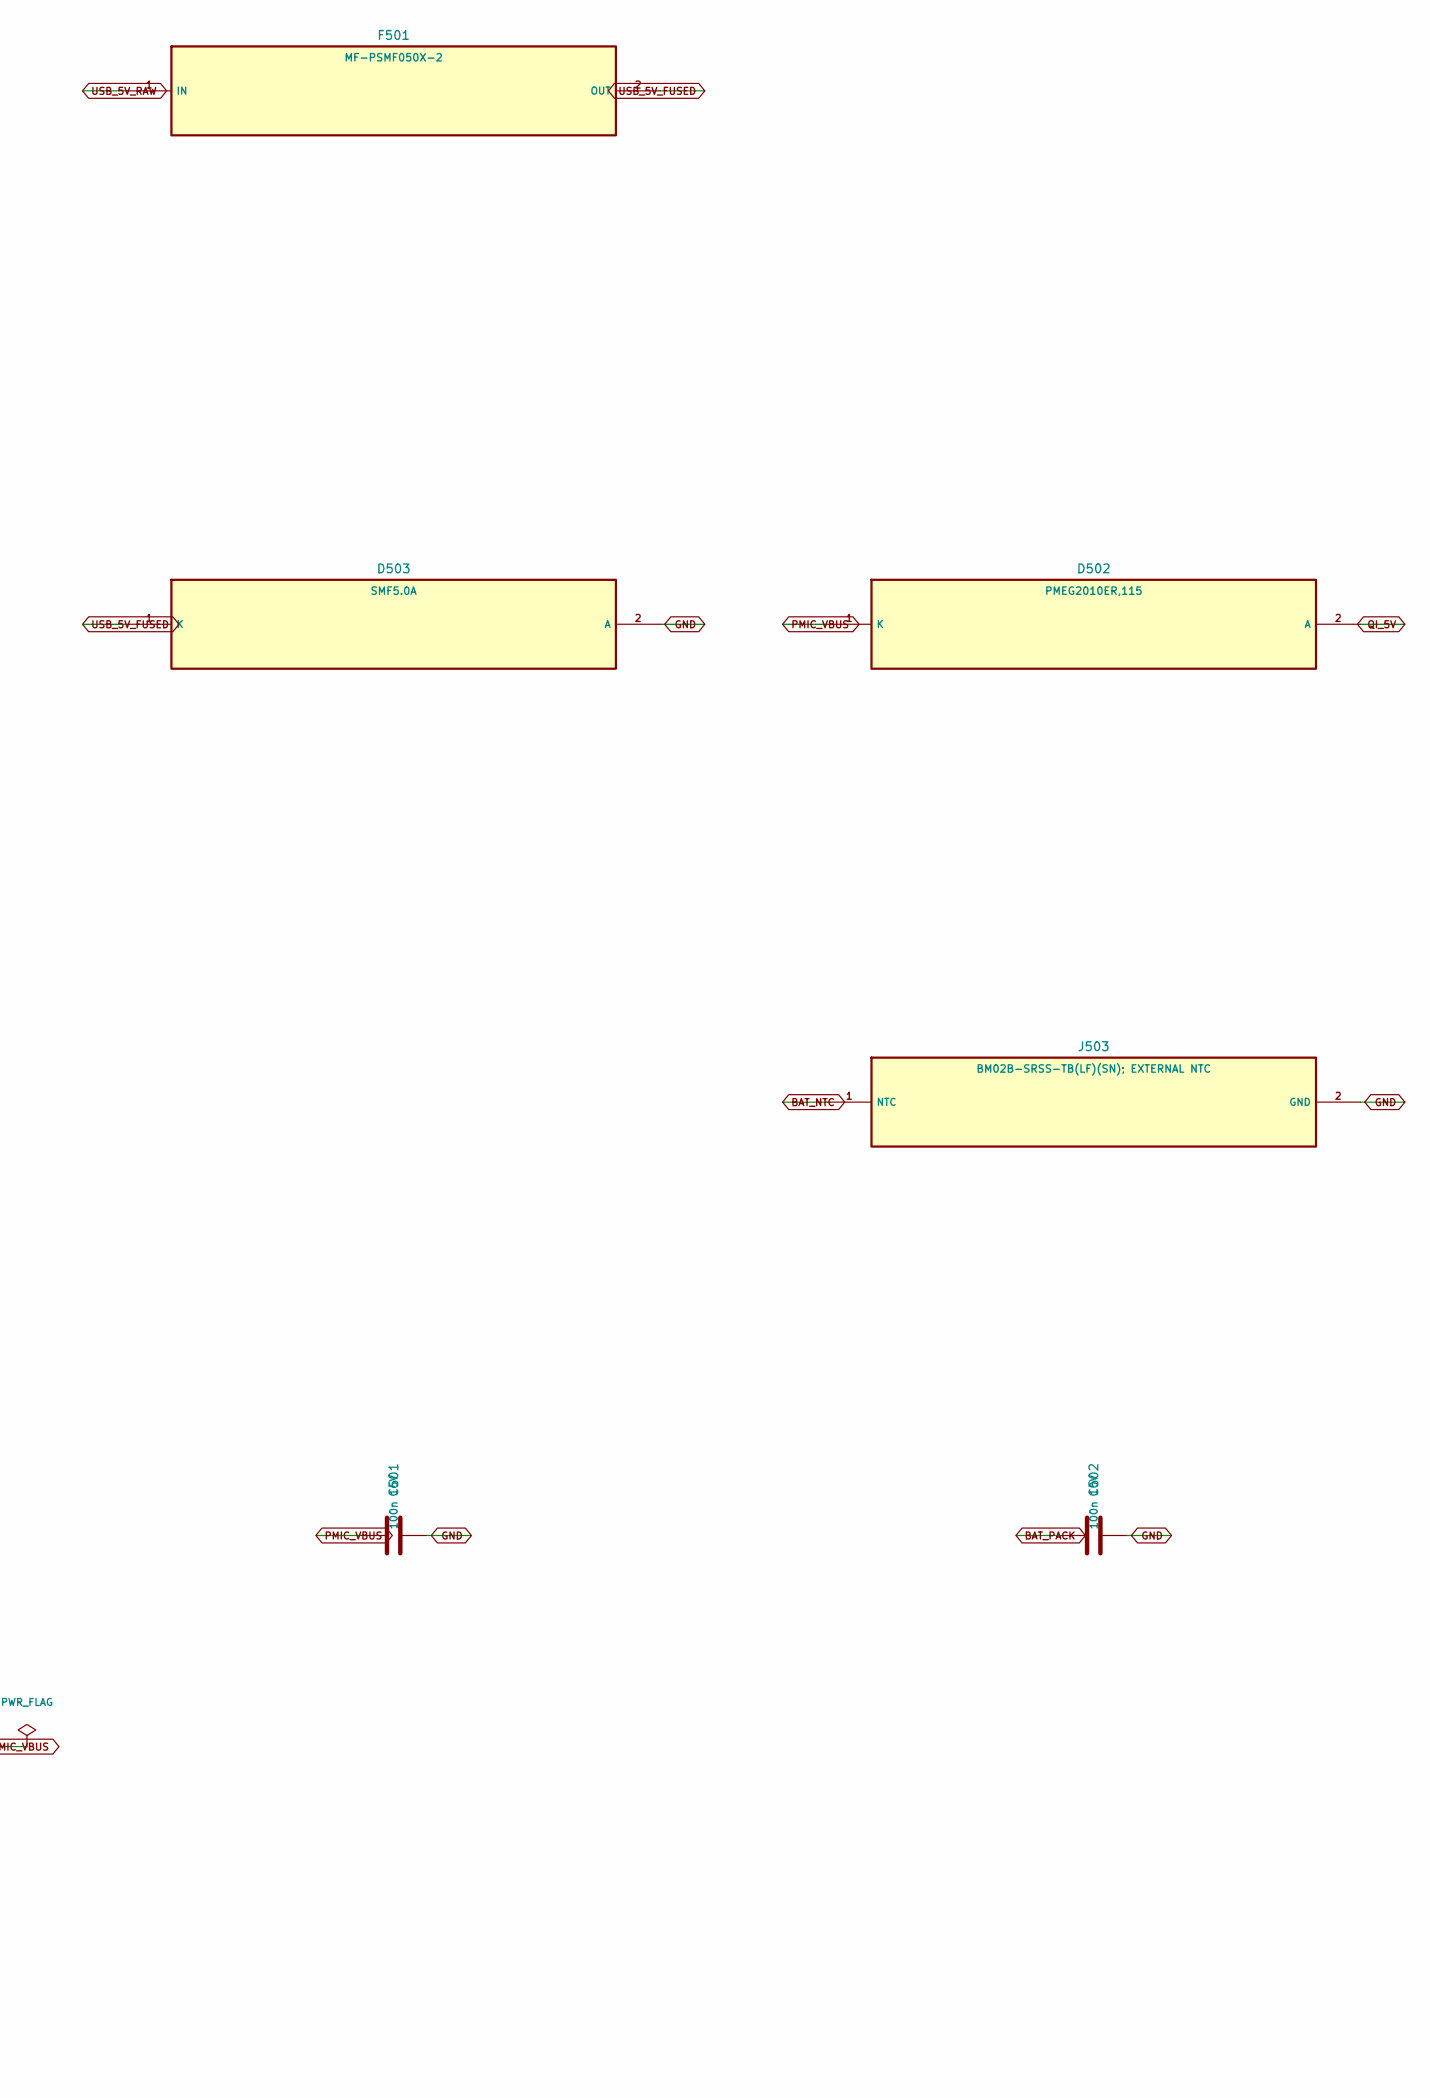
[picture p46: schematic circuit-power-entry.kicad_sch, USB, battery and local power entry, part in row 1, column 2]

Parts:
C501: 100n 16V; C_0402_1005Metric
C502: 100n 10V; C_0402_1005Metric
D501, D502: PMEG2010ER,115; Nexperia_CFP3_SOD-123W
D503: SMF5.0A; D_SOD-123F
F501: MF-PSMF050X-2; Fuse_0805_2012Metric
J501: USB4125-GF-A; USB_C_Receptacle_GCT_USB4125-xx-x_6P_TopMnt_Horizontal
J502: S2B-PH-SM4-TB(LF)(SN); BATTERY; JST_PH_S2B-PH-SM4-TB_1x02-1MP_P2.00mm_Horizontal
J503: BM02B-SRSS-TB(LF)(SN); EXTERNAL NTC; JST_SH_BM02B-SRSS-TB_1x02-1MP_P1.00mm_Vertical
SW503: TL3305AF160QG; POWER; SW_SPST_TL3305A

Connections:
BAT_NTC: J503.1 (NTC); also elsewhere on the board
BAT_PACK: C502.1, J502.1 (PACK_PLUS); also elsewhere on the board
BTN_POWER: SW503.1 (SHPHLD); also elsewhere on the board
GND: C501.2, C502.2, D503.2 (A), J501.A12 (GND), J501.B12 (GND), J501.SH (SHELL), J502.2 (PACK_MINUS), J503.2 (GND), SW503.2 (GND); also elsewhere on the board
PMIC_VBUS: C501.1, D501.1 (K), D502.1 (K); also elsewhere on the board
QI_5V: D502.2 (A); also elsewhere on the board
USB_5V_FUSED: D501.2 (A), D503.1 (K), F501.2 (OUT)
USB_5V_RAW: F501.1 (IN), J501.A9 (VBUS), J501.B9 (VBUS)
USB_CC1: J501.A5 (CC1); also elsewhere on the board
USB_CC2: J501.B5 (CC2); also elsewhere on the board

Notes on the sheet:
USB4125 has power/CC only: no USB data connection to trusted MCU. Power USB is for a trusted bench source.
USB/Qi Schottky OR prevents direct source paralleling; input allowance includes voltage drop, fuse derating and heat.
nPM1300 supplies CC pull-downs internally; do not add parallel 5.1k resistors.
External 10k NTC with configured beta must be thermally attached to the battery. Missing/invalid NTC must inhibit charging.
Battery is a protected external assembly. Verify actual connector polarity before power; no battery included in PCB assembly BOM.

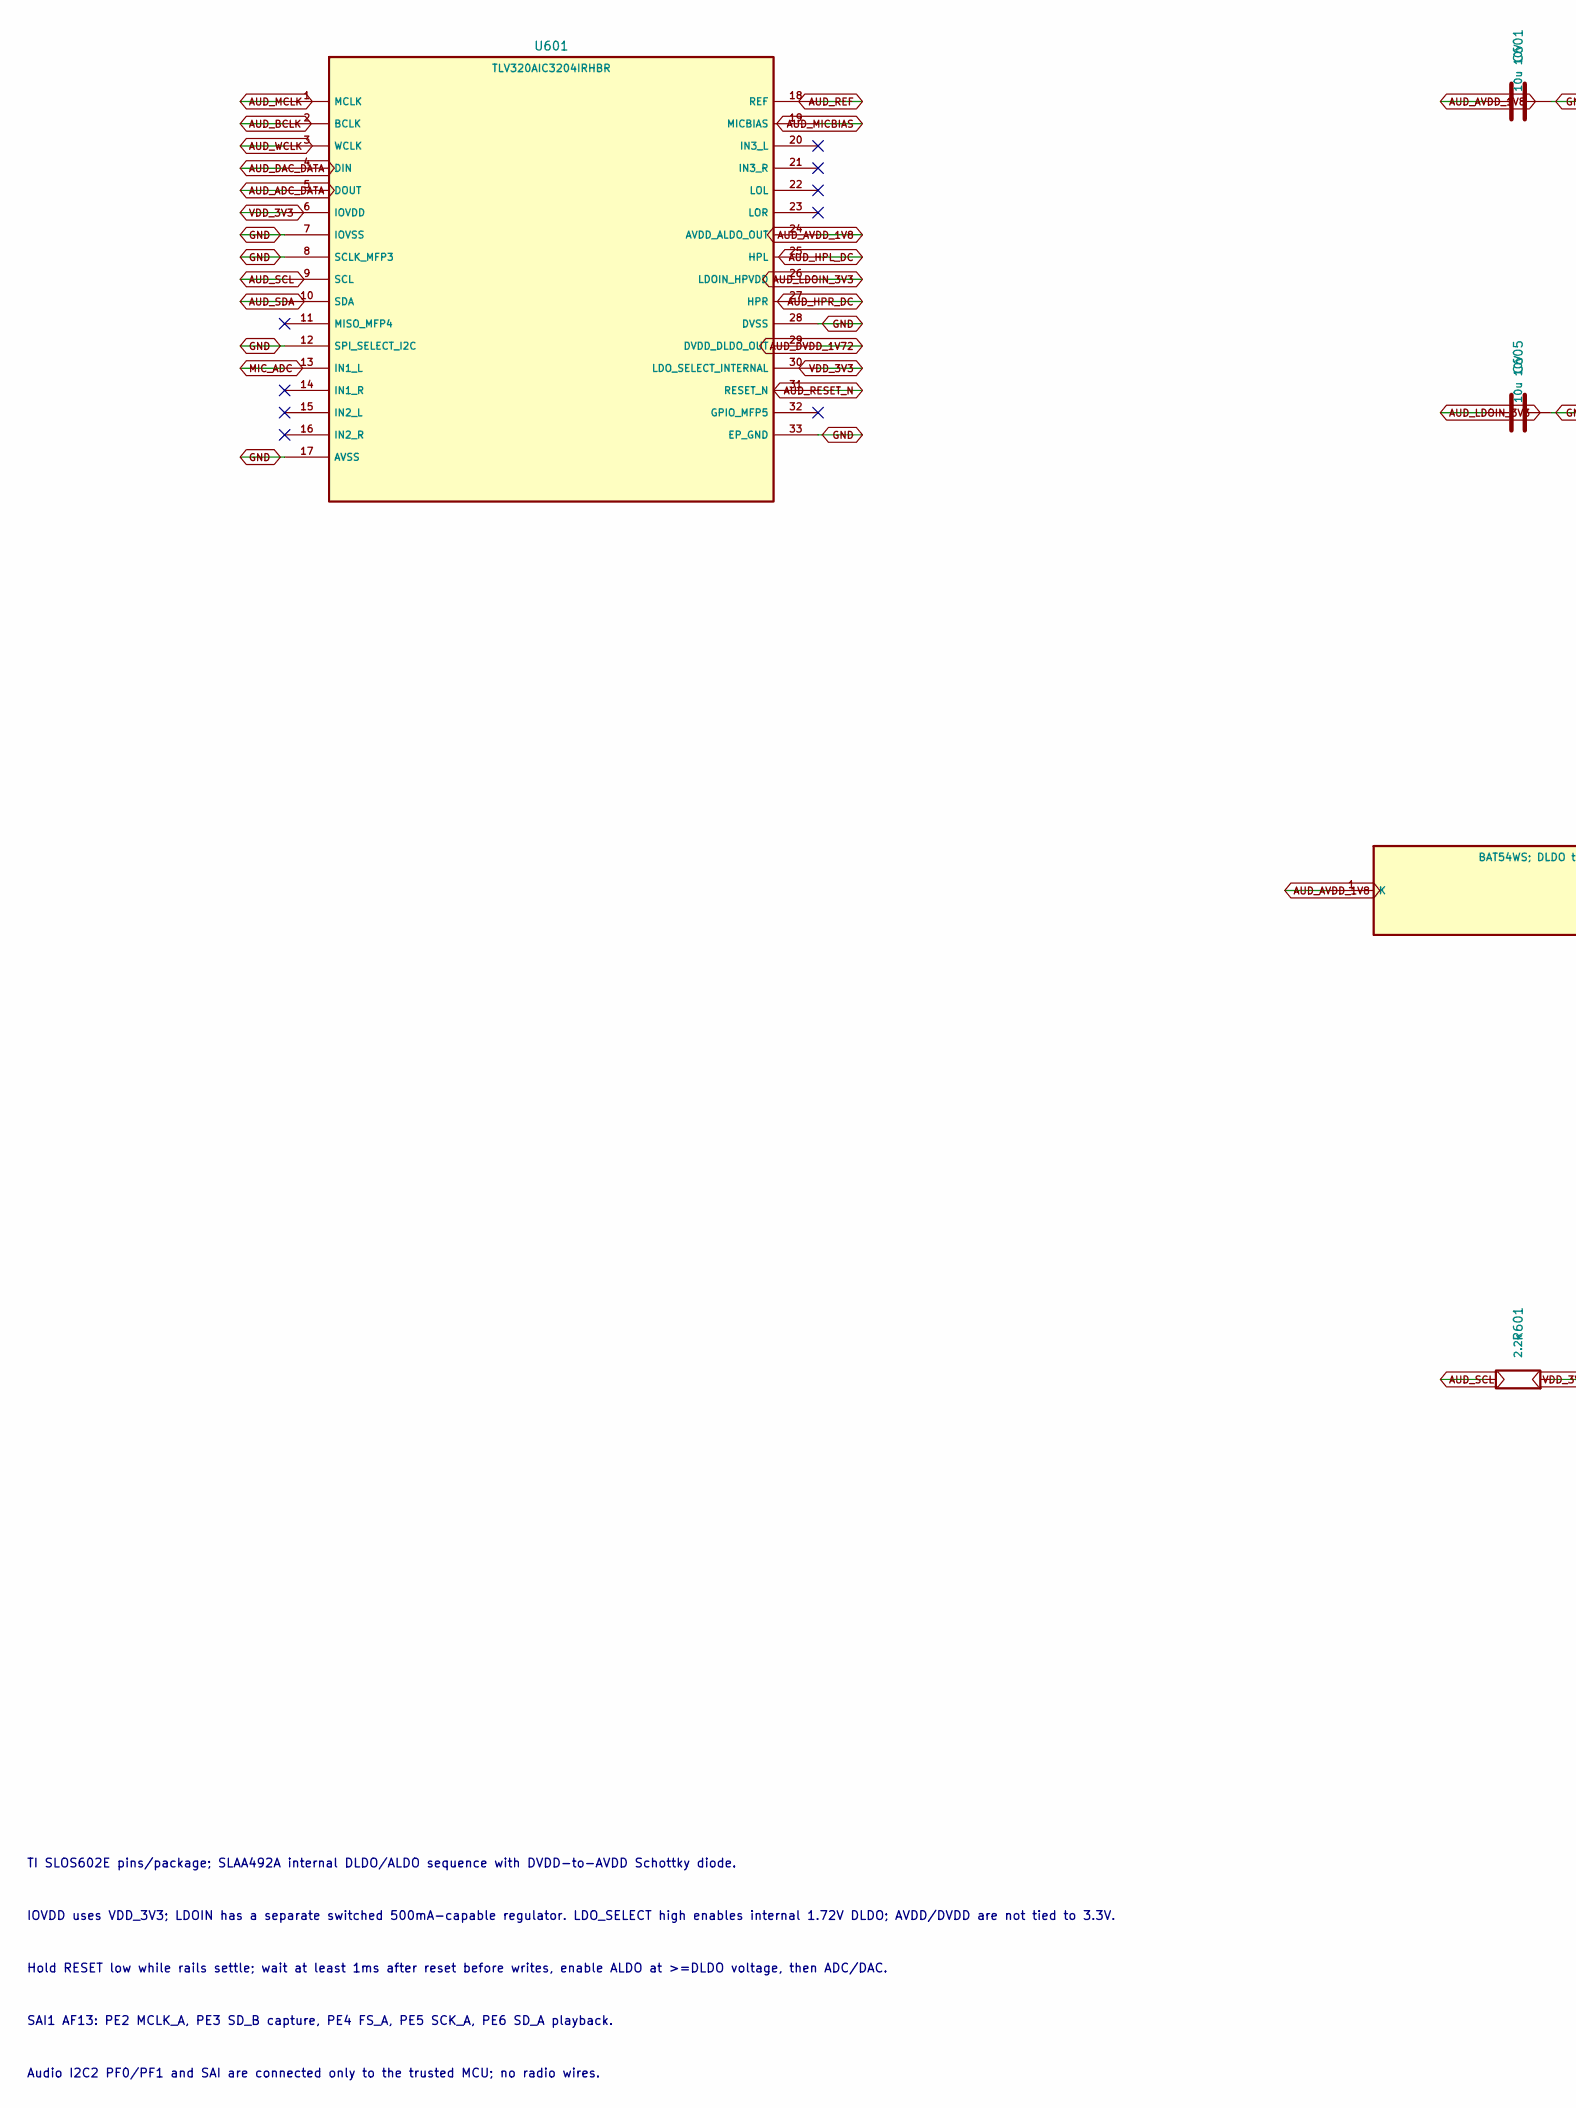
[picture p47: schematic circuit-audio-codec.kicad_sch, Trusted full-duplex audio codec, part in row 1, column 1]

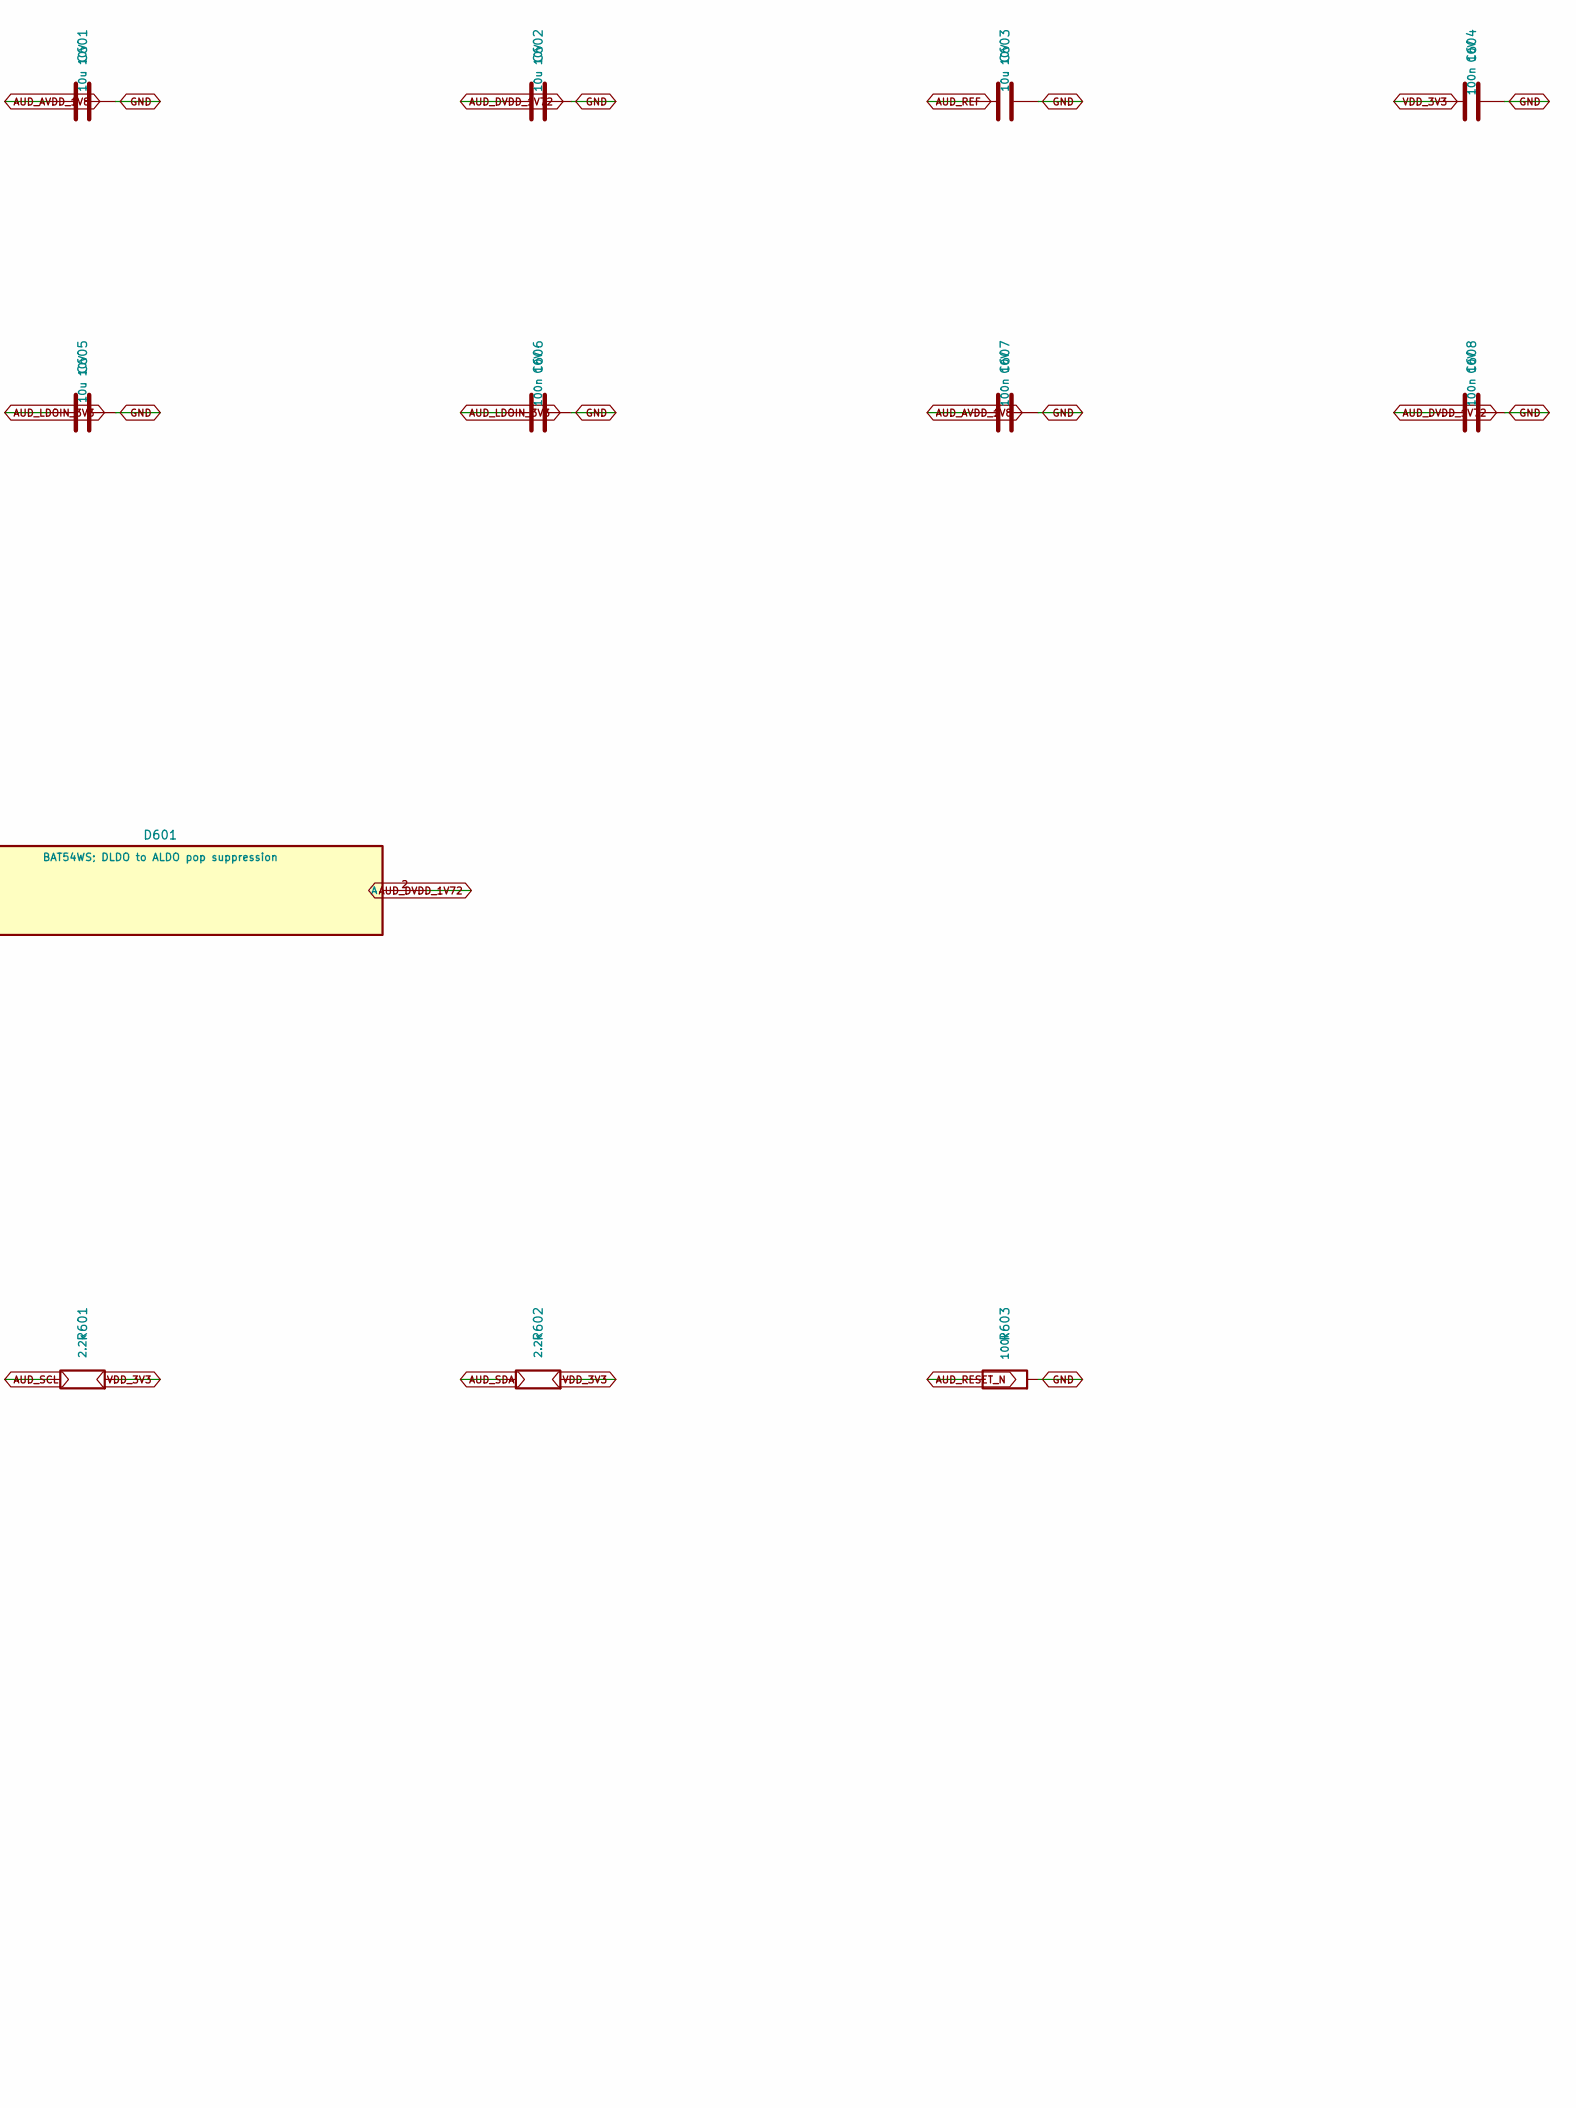
[picture p48: schematic circuit-audio-codec.kicad_sch, Trusted full-duplex audio codec, part in row 1, column 2]

Parts:
C601, C602, C603, C605: 10u 10V; C_0805_2012Metric
C604, C606, C607, C608: 100n 10V; C_0402_1005Metric
D601: BAT54WS; DLDO to ALDO pop suppression; D_SOD-323
R601, R602: 2.2k; R_0402_1005Metric
R603: 100k; R_0402_1005Metric
U601: TLV320AIC3204IRHBR; QFN-32-1EP_5x5mm_P0.5mm_EP3.45x3.45mm

Connections:
AUD_ADC_DATA: U601.5 (DOUT); also elsewhere on the board
AUD_AVDD_1V8: C601.1, C607.1, D601.1 (K), U601.24 (AVDD_ALDO_OUT)
AUD_BCLK: U601.2 (BCLK); also elsewhere on the board
AUD_DAC_DATA: U601.4 (DIN); also elsewhere on the board
AUD_DVDD_1V72: C602.1, C608.1, D601.2 (A), U601.29 (DVDD_DLDO_OUT)
AUD_HPL_DC: U601.25 (HPL); also elsewhere on the board
AUD_HPR_DC: U601.27 (HPR); also elsewhere on the board
AUD_LDOIN_3V3: C605.1, C606.1, U601.26 (LDOIN_HPVDD); also elsewhere on the board
AUD_MCLK: U601.1 (MCLK); also elsewhere on the board
AUD_MICBIAS: U601.19 (MICBIAS); also elsewhere on the board
AUD_REF: C603.1, U601.18 (REF)
AUD_RESET_N: R603.1, U601.31 (RESET_N); also elsewhere on the board
AUD_SCL: R601.1, U601.9 (SCL); also elsewhere on the board
AUD_SDA: R602.1, U601.10 (SDA); also elsewhere on the board
AUD_WCLK: U601.3 (WCLK); also elsewhere on the board
GND: C601.2, C602.2, C603.2, C604.2, C605.2, C606.2, C607.2, C608.2, R603.2, U601.7 (IOVSS), U601.8 (SCLK_MFP3), U601.12 (SPI_SELECT_I2C), U601.17 (AVSS), U601.28 (DVSS), U601.33 (EP_GND); also elsewhere on the board
MIC_ADC: U601.13 (IN1_L); also elsewhere on the board
VDD_3V3: C604.1, R601.2, R602.2, U601.6 (IOVDD), U601.30 (LDO_SELECT_INTERNAL); also elsewhere on the board

Notes on the sheet:
TI SLOS602E pins/package; SLAA492A internal DLDO/ALDO sequence with DVDD-to-AVDD Schottky diode.
IOVDD uses VDD_3V3; LDOIN has a separate switched 500mA-capable regulator. LDO_SELECT high enables internal 1.72V DLDO; AVDD/DVDD are not tied to 3.3V.
Hold RESET low while rails settle; wait at least 1ms after reset before writes, enable ALDO at >=DLDO voltage, then ADC/DAC.
SAI1 AF13: PE2 MCLK_A, PE3 SD_B capture, PE4 FS_A, PE5 SCK_A, PE6 SD_A playback.
Audio I2C2 PF0/PF1 and SAI are connected only to the trusted MCU; no radio wires.
