adlererik/voicevault/hardware/rev-b/voicevault-standalone-b0.kicad_pcb

## KiCad design hardware/rev-b/voicevault-standalone-b0.kicad_pcb (continued)

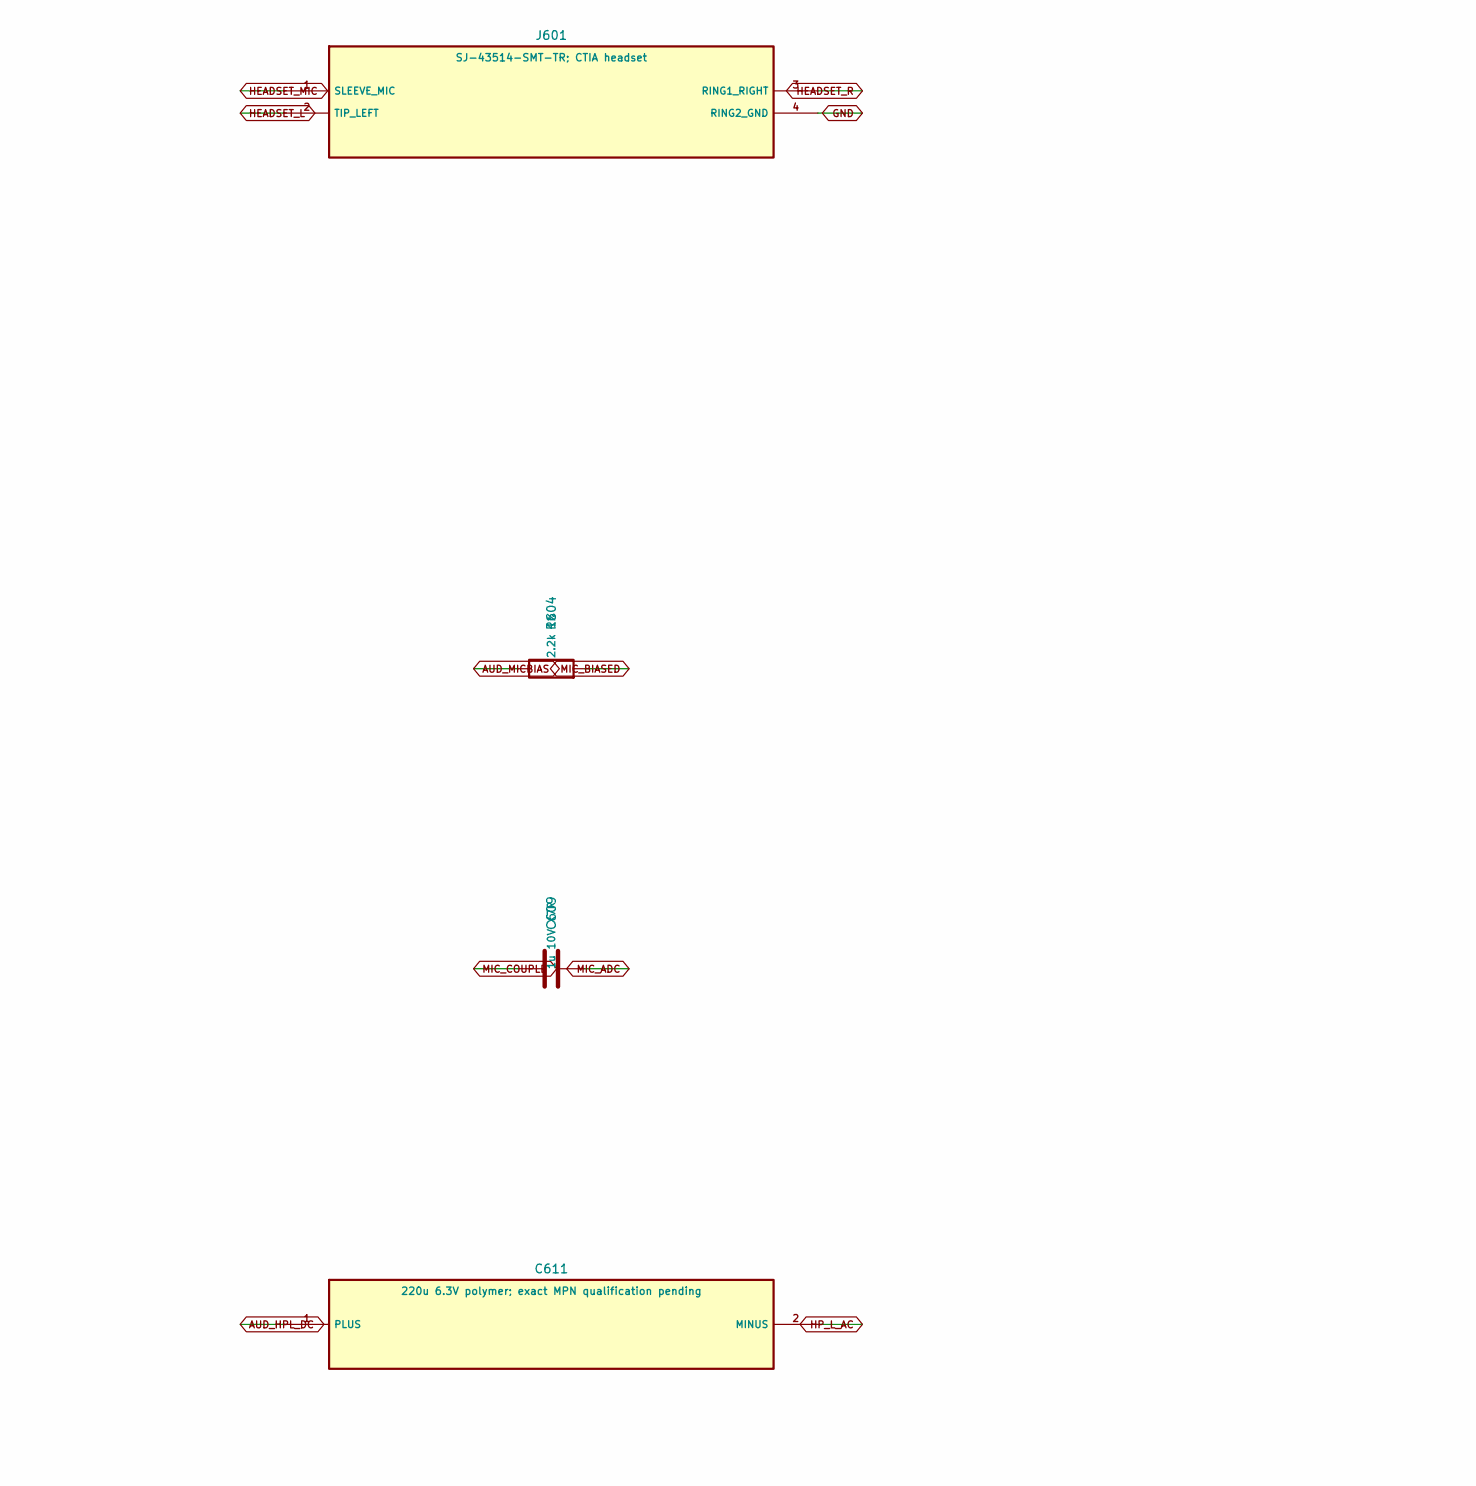
[picture p49: schematic circuit-headset.kicad_sch, Wired headset and physical microphone disconnect, part in row 1, column 1]

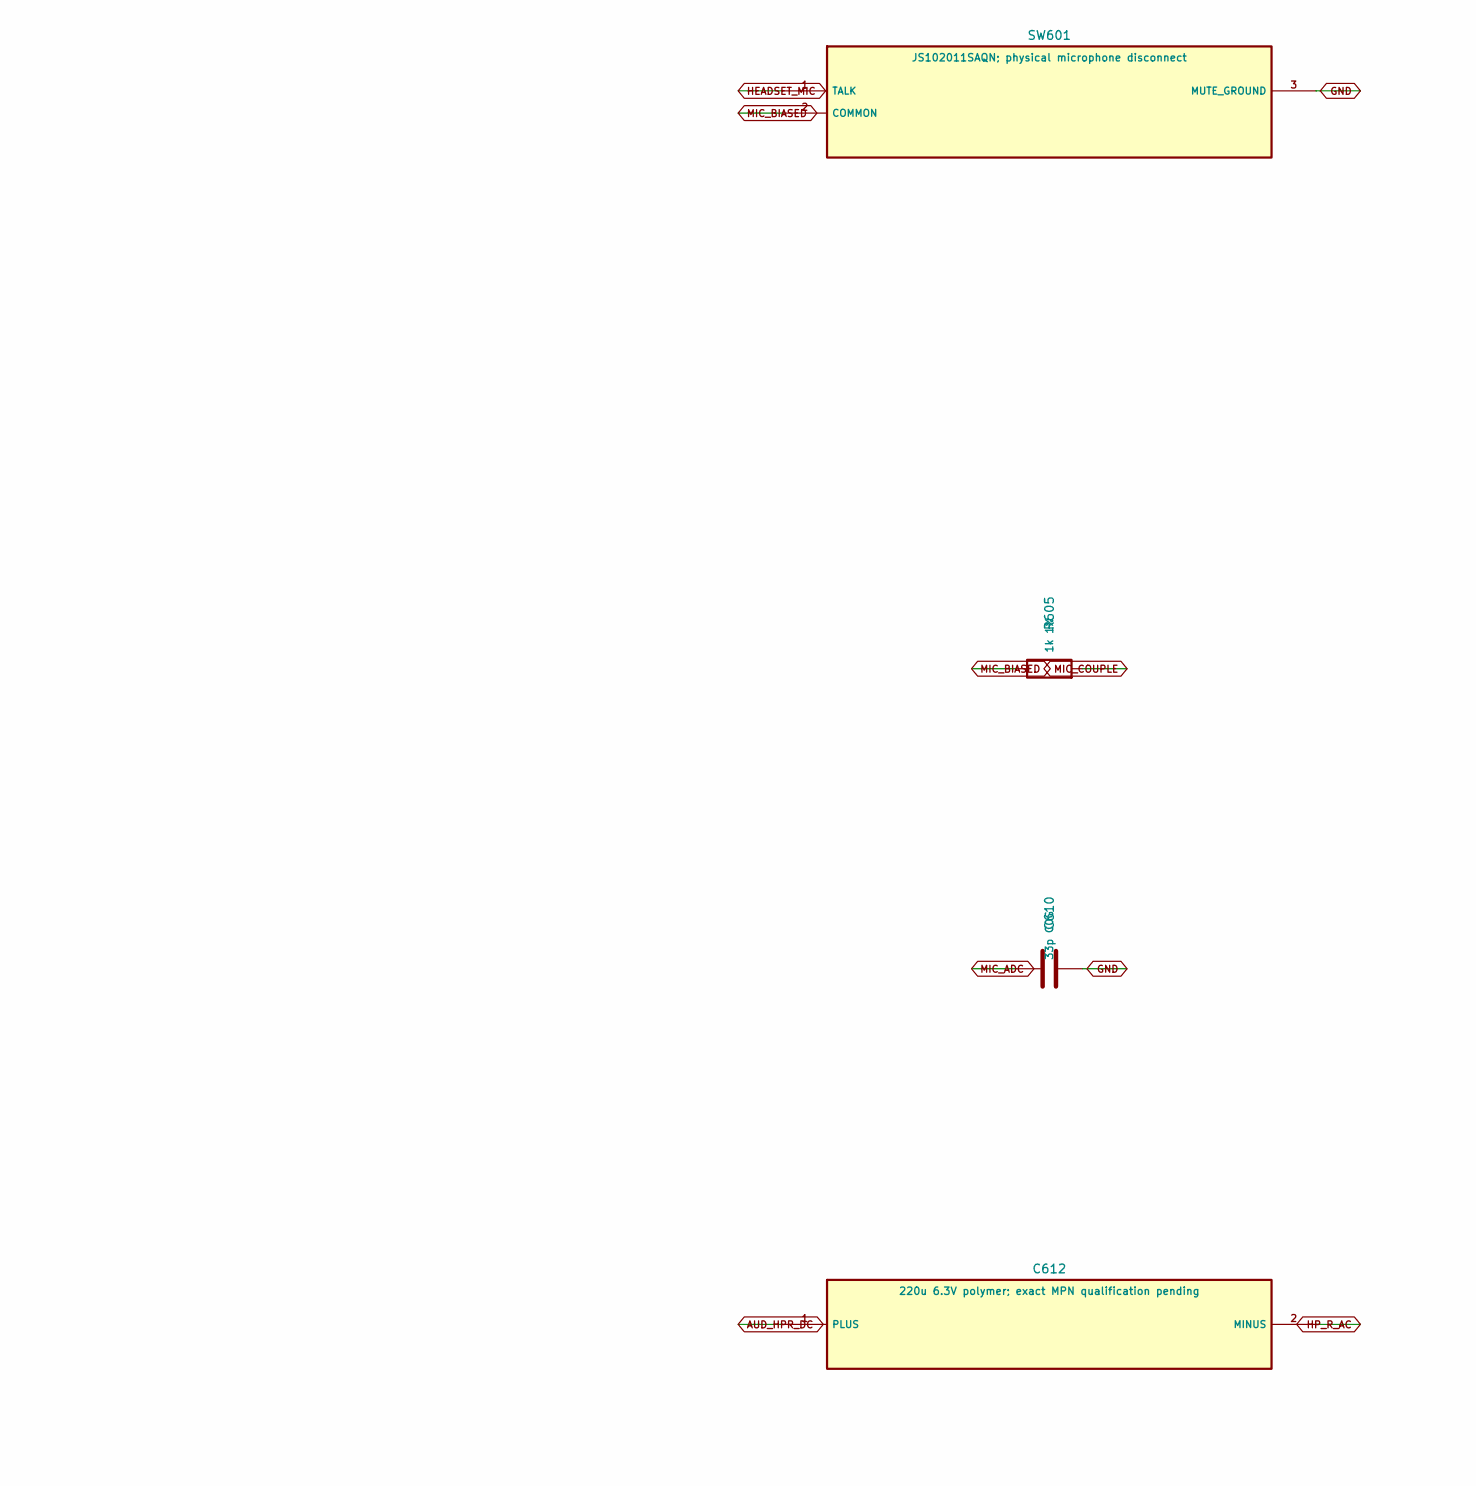
[picture p50: schematic circuit-headset.kicad_sch, Wired headset and physical microphone disconnect, part in row 1, column 2]

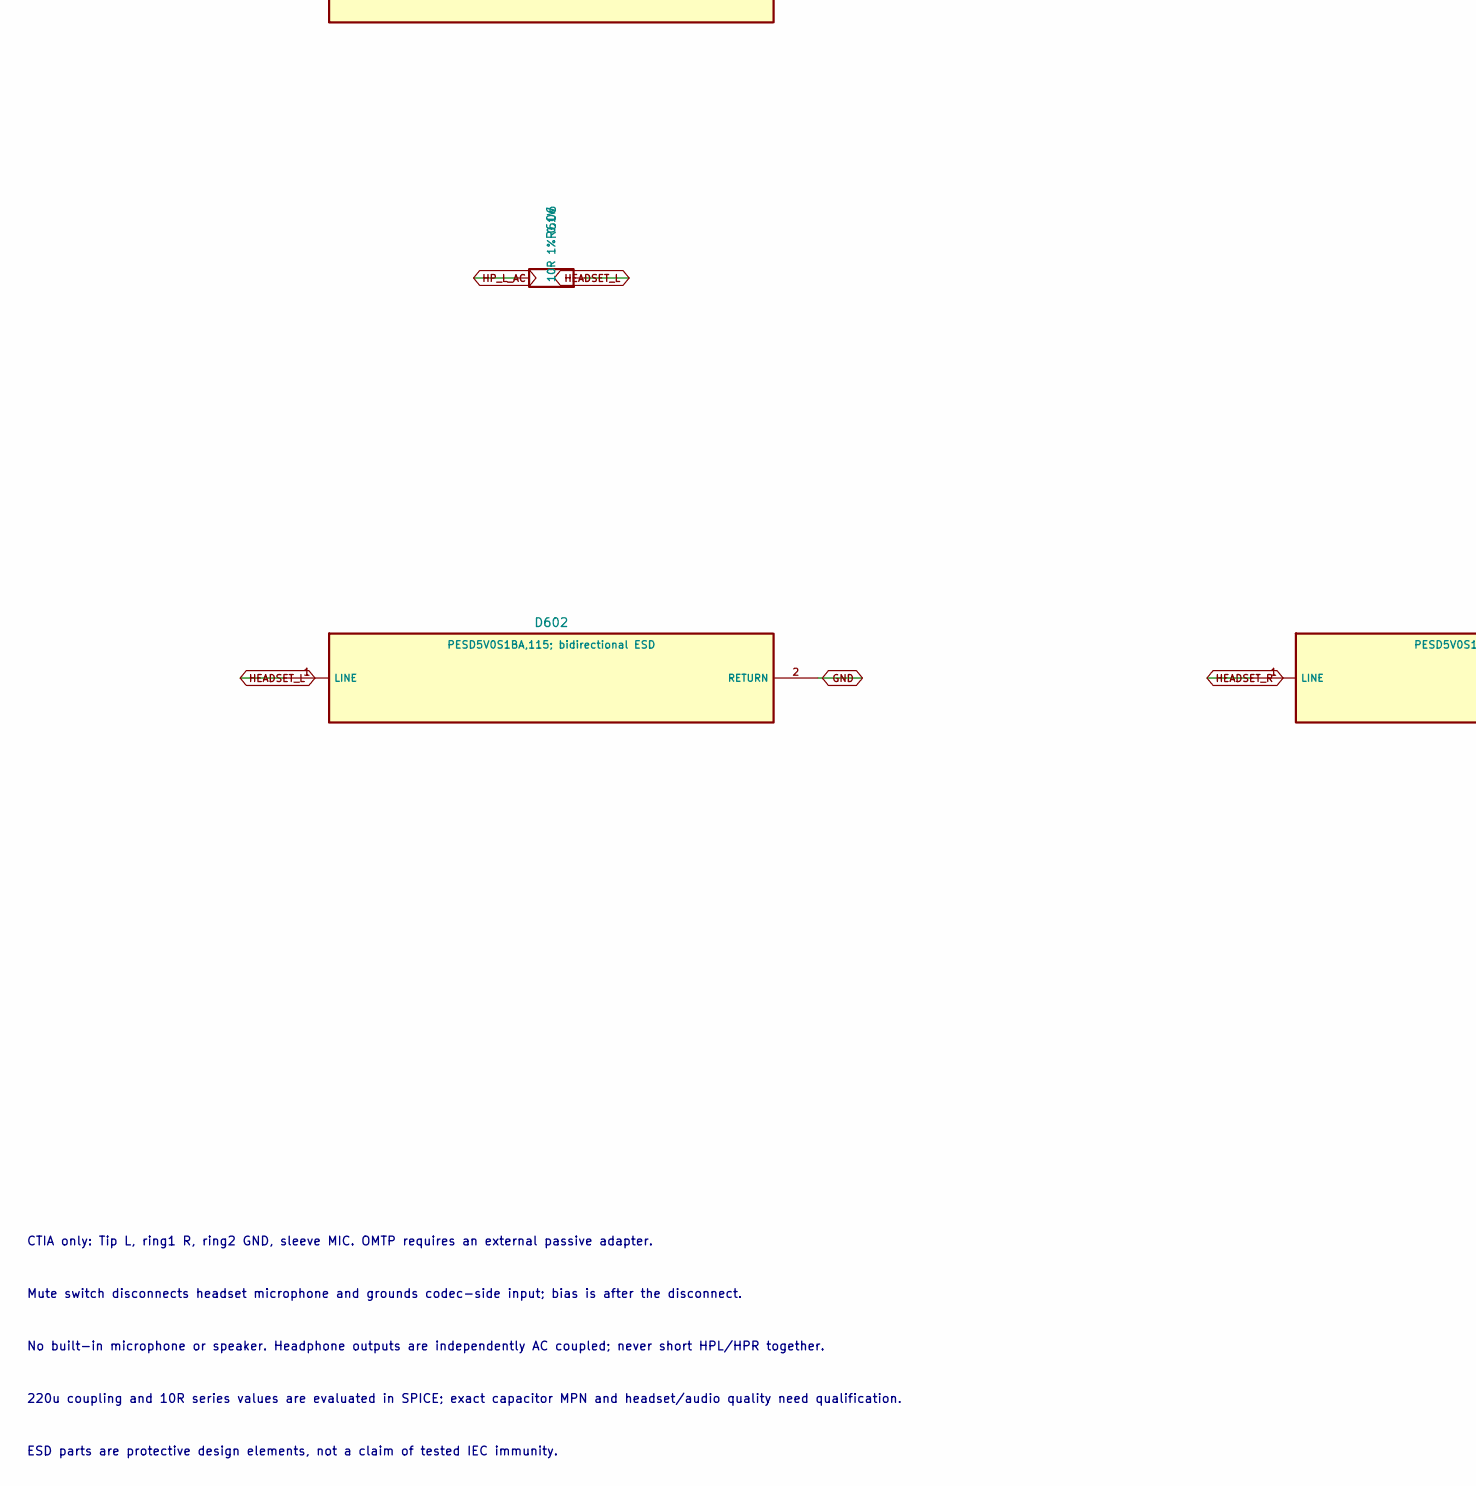
[picture p51: schematic circuit-headset.kicad_sch, Wired headset and physical microphone disconnect, part in row 2, column 1]

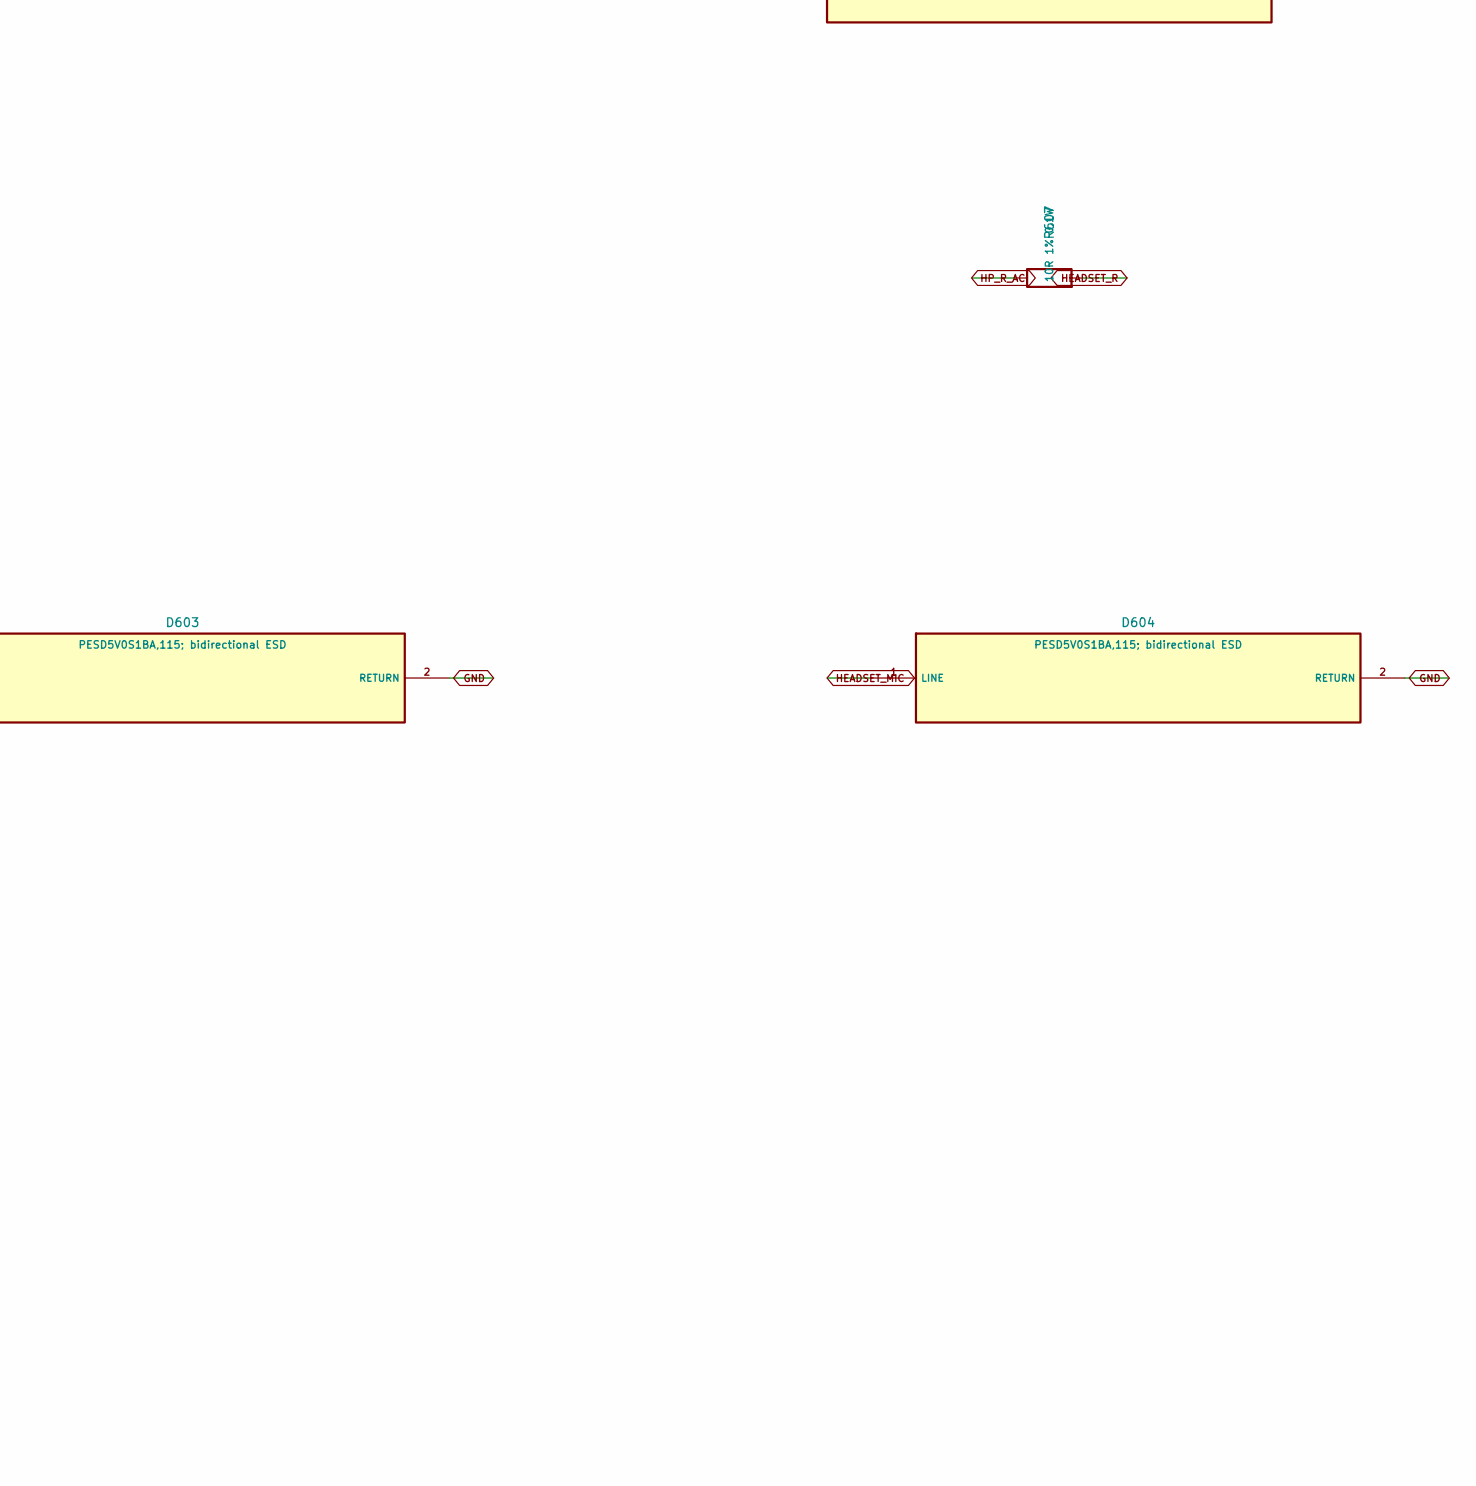
[picture p52: schematic circuit-headset.kicad_sch, Wired headset and physical microphone disconnect, part in row 2, column 2]

Parts:
C609: 1u 10V X7R; C_0603_1608Metric
C610: 33p C0G; C_0402_1005Metric
C611, C612: 220u 6.3V polymer; exact MPN qualification pending; CP_EIA-7343-31_Kemet-D
D602, D603, D604: PESD5V0S1BA,115; bidirectional ESD; D_SOD-323
J601: SJ-43514-SMT-TR; CTIA headset; SJ43514SMT
R604: 2.2k 1%; R_0402_1005Metric
R605: 1k 1%; R_0402_1005Metric
R606, R607: 10R 1% 0.1W; R_0402_1005Metric
SW601: JS102011SAQN; physical microphone disconnect; SW_SPDT_CK_JS102011SAQN

Connections:
AUD_HPL_DC: C611.1 (PLUS); also elsewhere on the board
AUD_HPR_DC: C612.1 (PLUS); also elsewhere on the board
AUD_MICBIAS: R604.1; also elsewhere on the board
GND: C610.2, D602.2 (RETURN), D603.2 (RETURN), D604.2 (RETURN), J601.4 (RING2_GND), SW601.3 (MUTE_GROUND); also elsewhere on the board
HEADSET_L: D602.1 (LINE), J601.2 (TIP_LEFT), R606.2
HEADSET_MIC: D604.1 (LINE), J601.1 (SLEEVE_MIC), SW601.1 (TALK)
HEADSET_R: D603.1 (LINE), J601.3 (RING1_RIGHT), R607.2
HP_L_AC: C611.2 (MINUS), R606.1
HP_R_AC: C612.2 (MINUS), R607.1
MIC_ADC: C609.2, C610.1; also elsewhere on the board
MIC_BIASED: R604.2, R605.1, SW601.2 (COMMON)
MIC_COUPLE: C609.1, R605.2

Notes on the sheet:
CTIA only: Tip L, ring1 R, ring2 GND, sleeve MIC. OMTP requires an external passive adapter.
Mute switch disconnects headset microphone and grounds codec-side input; bias is after the disconnect.
No built-in microphone or speaker. Headphone outputs are independently AC coupled; never short HPL/HPR together.
220u coupling and 10R series values are evaluated in SPICE; exact capacitor MPN and headset/audio quality need qualification.
ESD parts are protective design elements, not a claim of tested IEC immunity.

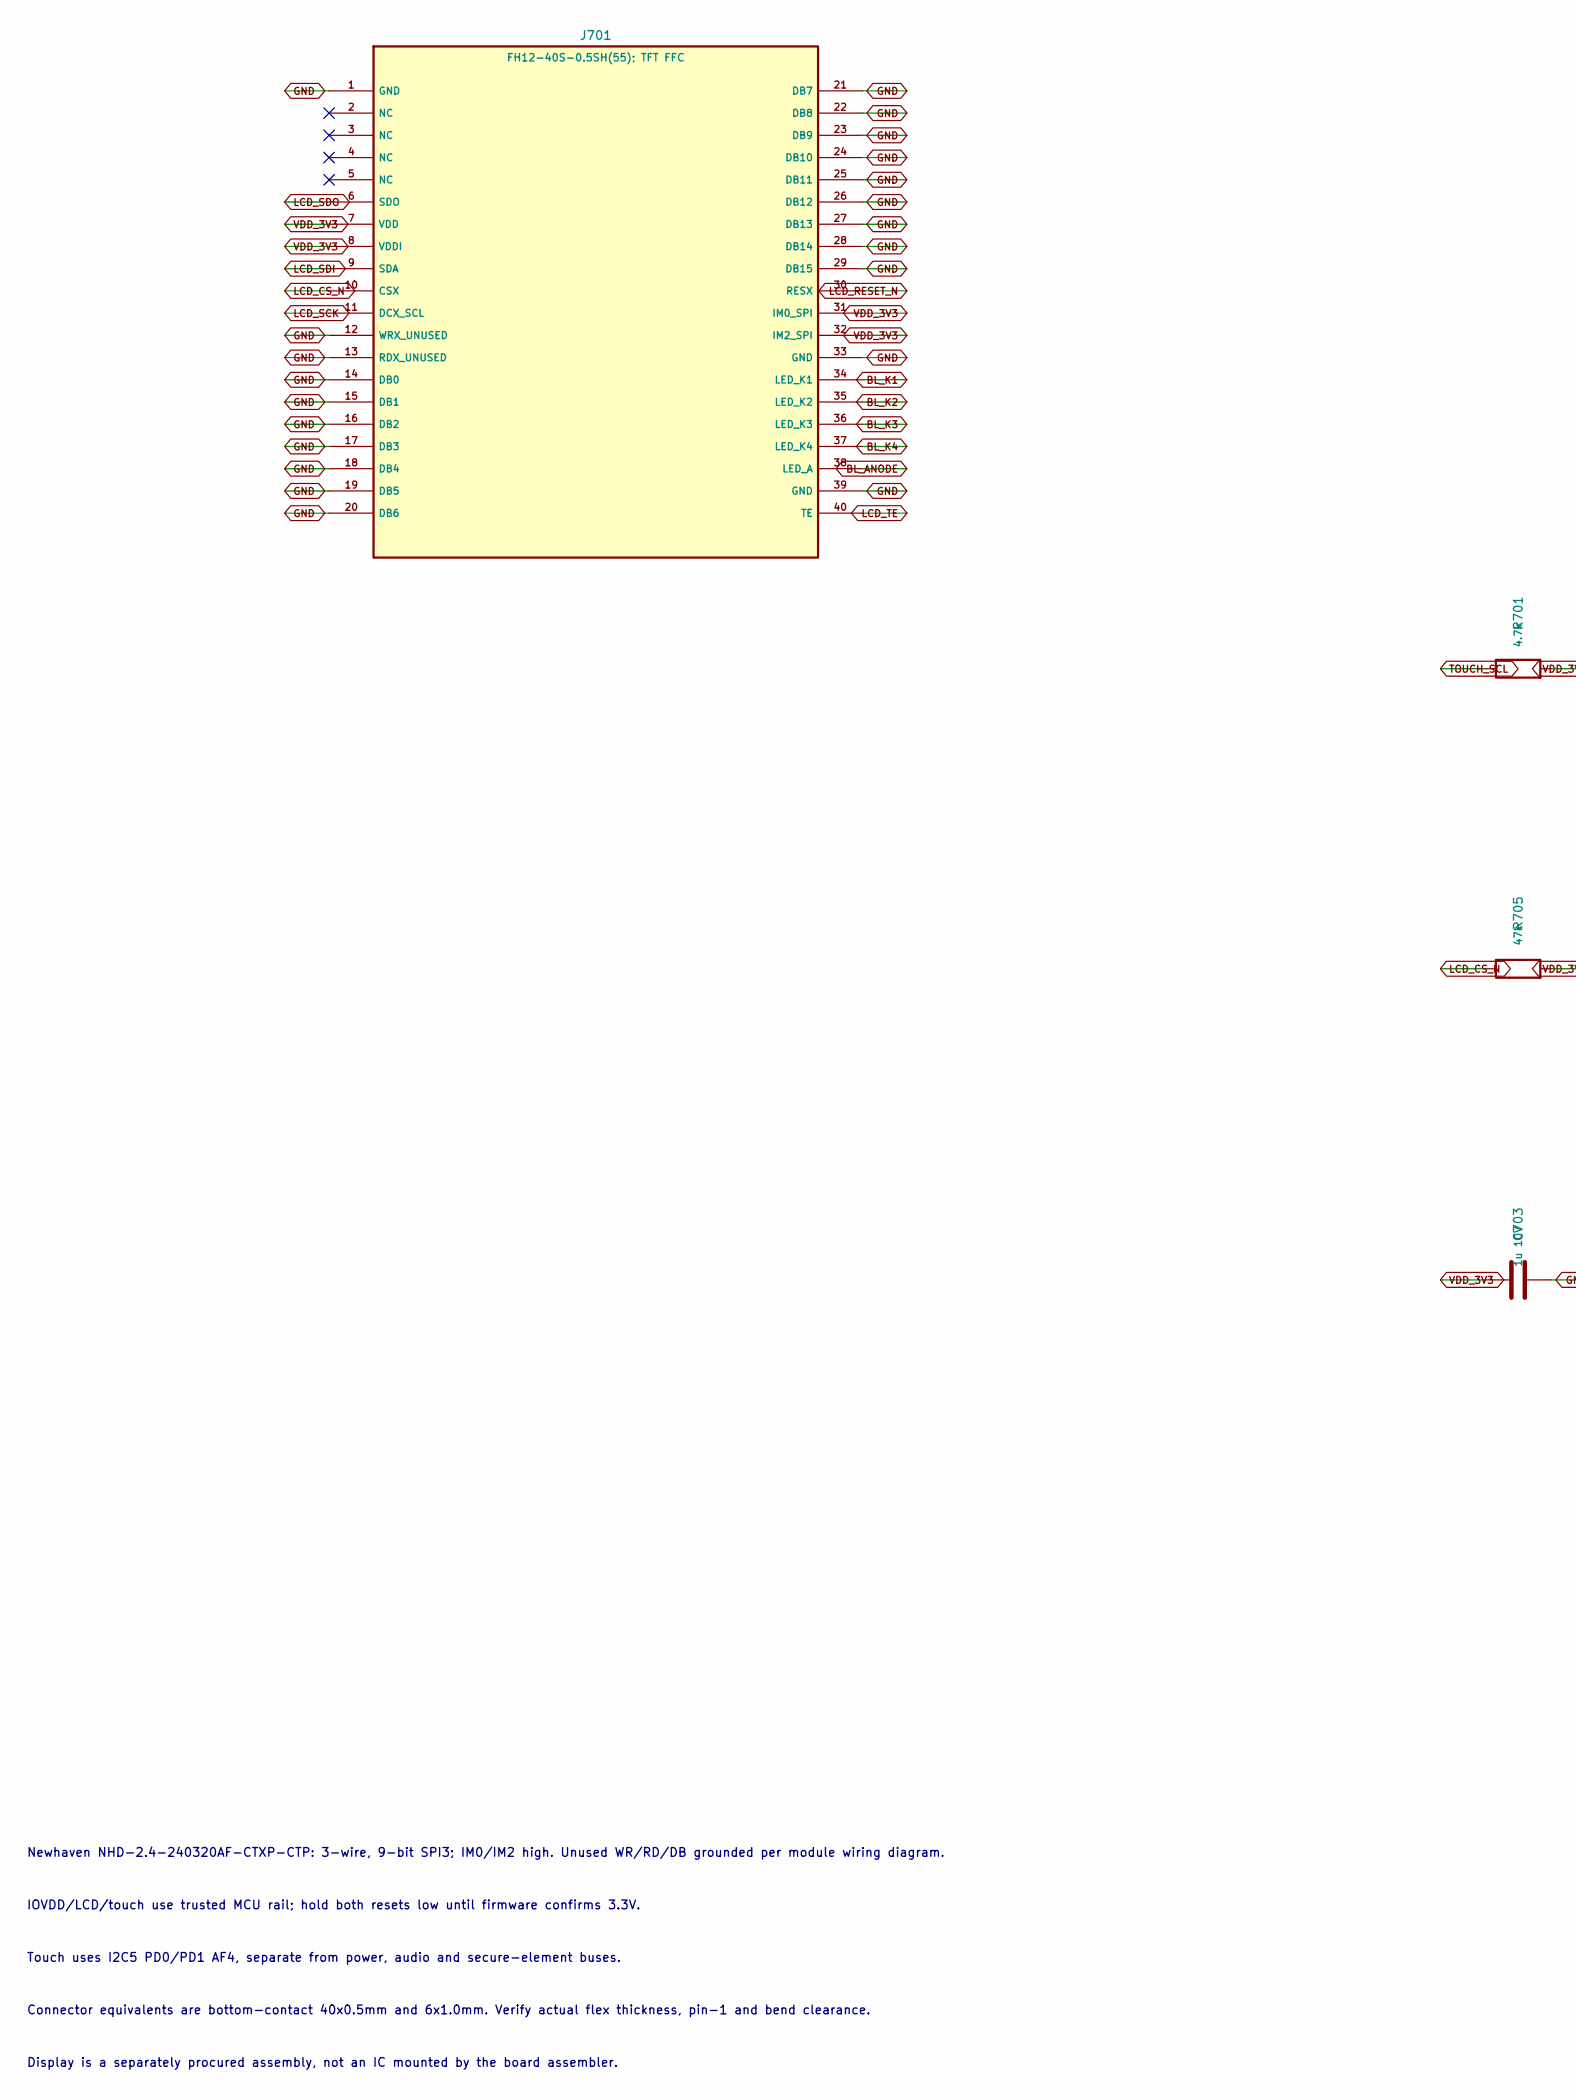
[picture p53: schematic circuit-display.kicad_sch, Trusted color display and touch, part in row 1, column 1]

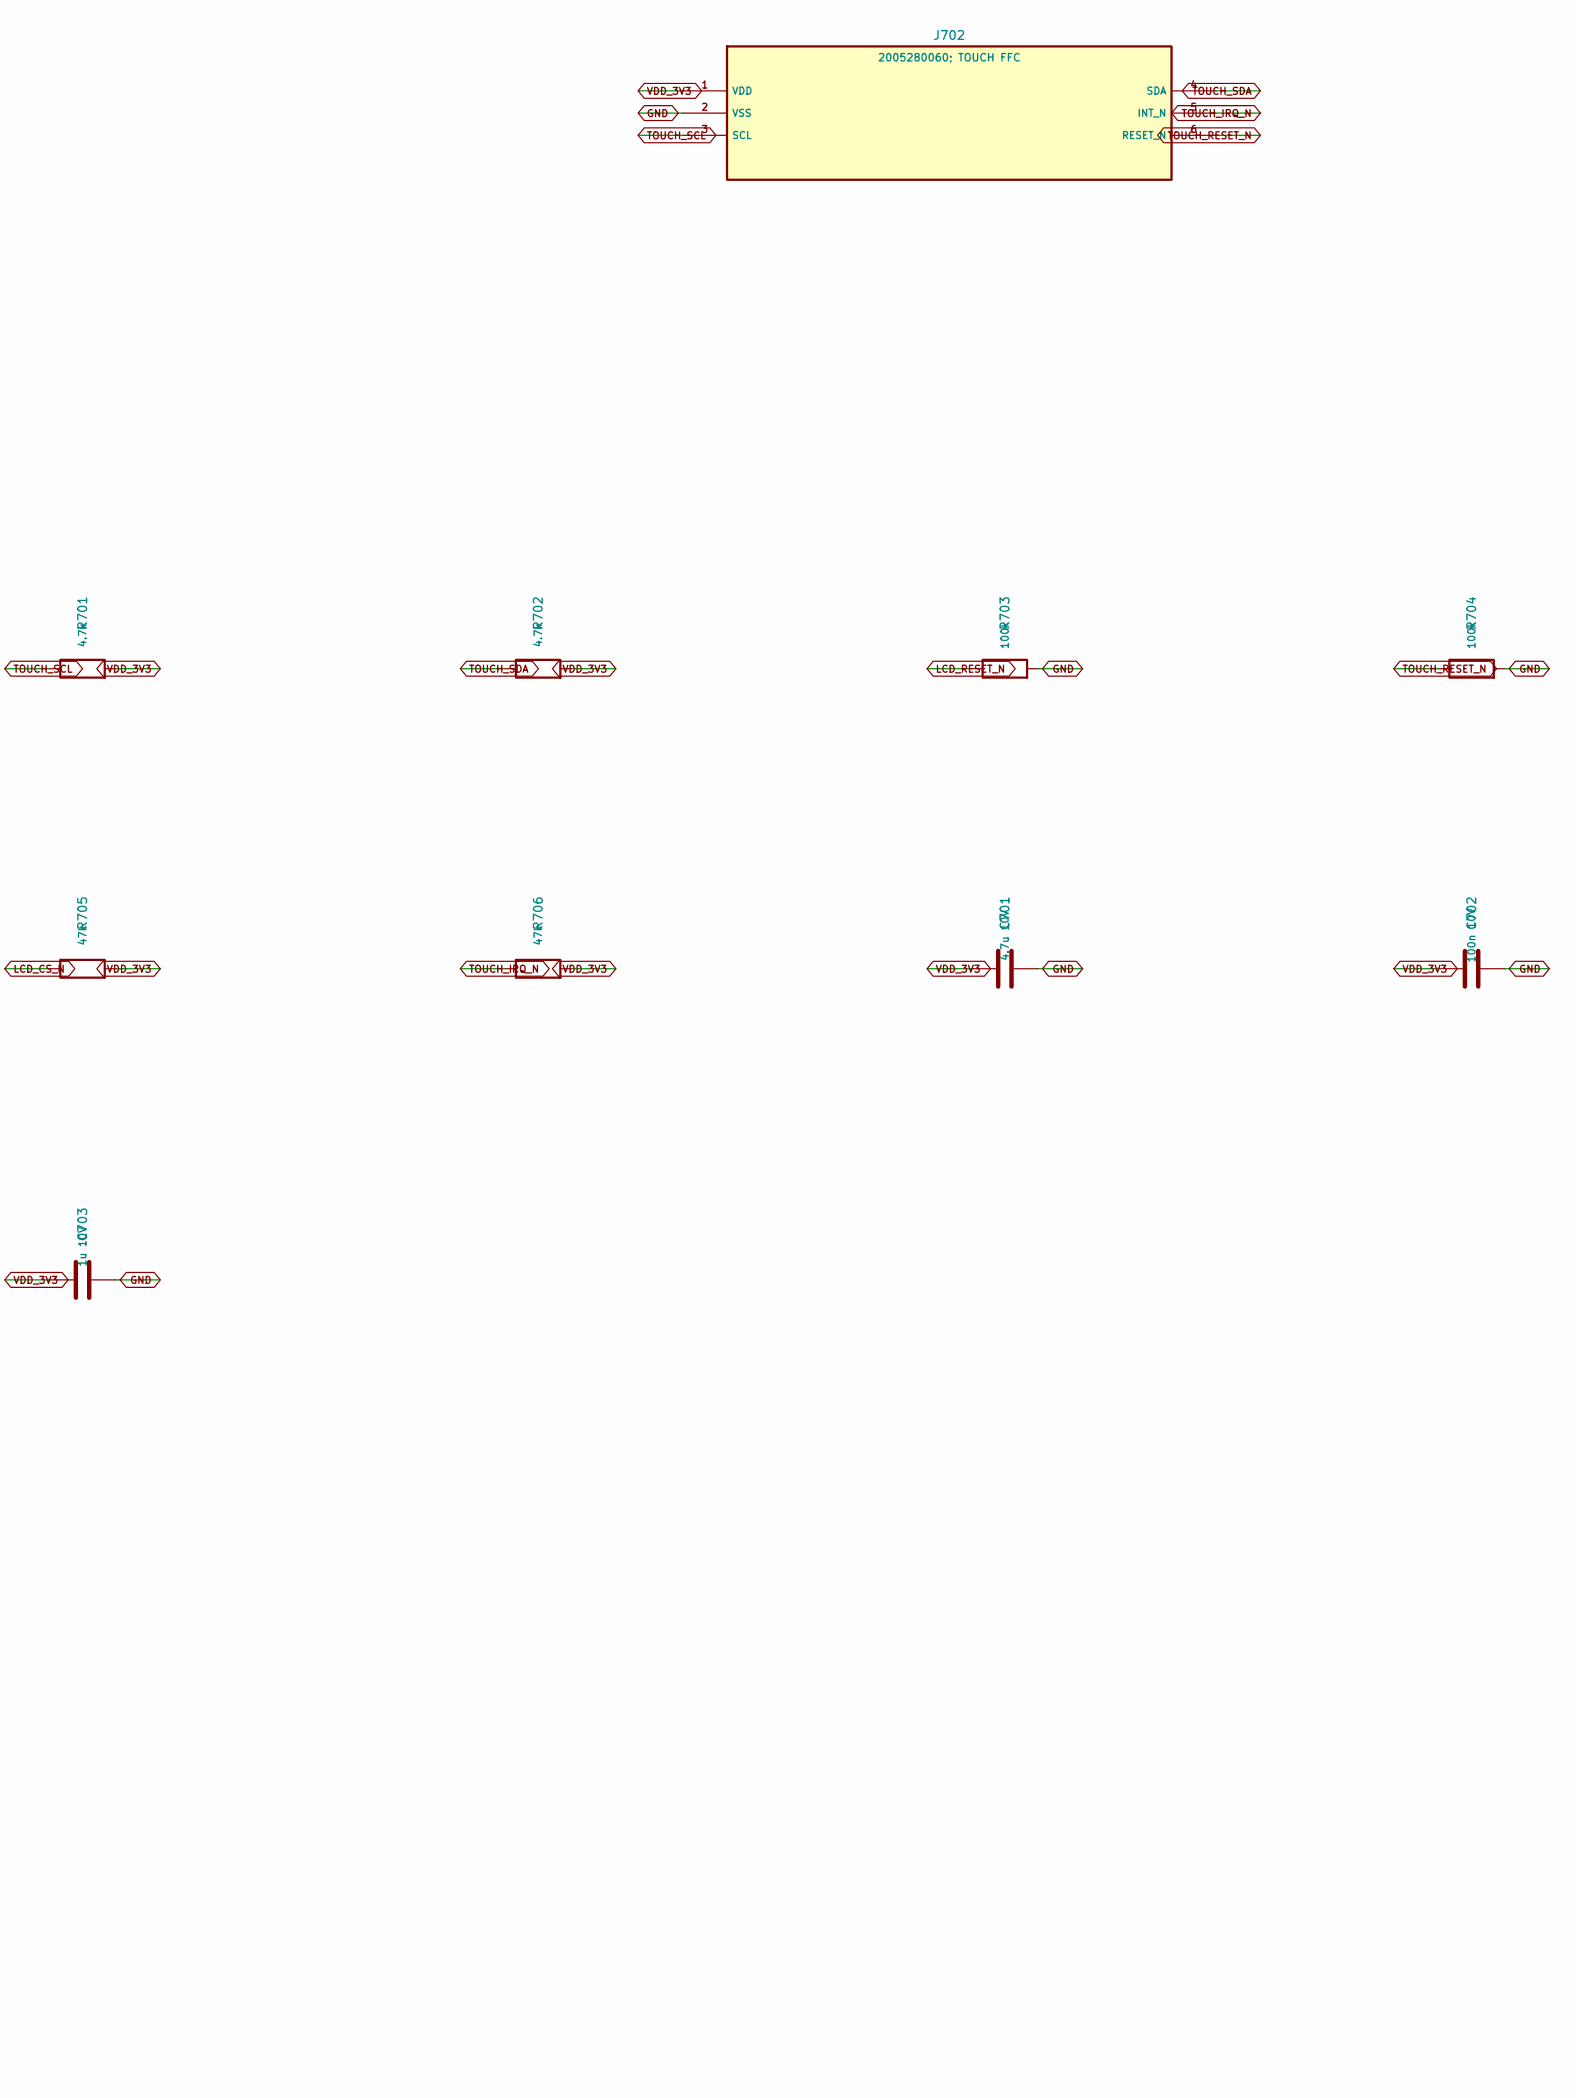
[picture p54: schematic circuit-display.kicad_sch, Trusted color display and touch, part in row 1, column 2]

Parts:
C701: 4.7u 10V; C_0603_1608Metric
C702: 100n 10V; C_0402_1005Metric
C703: 1u 10V; C_0603_1608Metric
J701: FH12-40S-0.5SH(55); TFT FFC; Hirose_FH12-40S-0.5SH_1x40-1MP_P0.50mm_Horizontal
J702: 2005280060; TOUCH FFC; Molex_200528-0060_1x06-1MP_P1.00mm_Horizontal
R701, R702: 4.7k; R_0402_1005Metric
R703, R704: 100k; R_0402_1005Metric
R705, R706: 47k; R_0402_1005Metric

Connections:
BL_ANODE: J701.38 (LED_A); also elsewhere on the board
BL_K1: J701.34 (LED_K1); also elsewhere on the board
BL_K2: J701.35 (LED_K2); also elsewhere on the board
BL_K3: J701.36 (LED_K3); also elsewhere on the board
BL_K4: J701.37 (LED_K4); also elsewhere on the board
GND: C701.2, C702.2, C703.2, J701.1 (GND), J701.12 (WRX_UNUSED), J701.13 (RDX_UNUSED), J701.14 (DB0), J701.15 (DB1), J701.16 (DB2), J701.17 (DB3), J701.18 (DB4), J701.19 (DB5), J701.20 (DB6), J701.21 (DB7), J701.22 (DB8), J701.23 (DB9), J701.24 (DB10), J701.25 (DB11), J701.26 (DB12), J701.27 (DB13), J701.28 (DB14), J701.29 (DB15), J701.33 (GND), J701.39 (GND), J702.2 (VSS), R703.2, R704.2; also elsewhere on the board
LCD_CS_N: J701.10 (CSX), R705.1; also elsewhere on the board
LCD_RESET_N: J701.30 (RESX), R703.1; also elsewhere on the board
LCD_SCK: J701.11 (DCX_SCL); also elsewhere on the board
LCD_SDI: J701.9 (SDA); also elsewhere on the board
LCD_SDO: J701.6 (SDO); also elsewhere on the board
LCD_TE: J701.40 (TE); also elsewhere on the board
TOUCH_IRQ_N: J702.5 (INT_N), R706.1; also elsewhere on the board
TOUCH_RESET_N: J702.6 (RESET_N), R704.1; also elsewhere on the board
TOUCH_SCL: J702.3 (SCL), R701.1; also elsewhere on the board
TOUCH_SDA: J702.4 (SDA), R702.1; also elsewhere on the board
VDD_3V3: C701.1, C702.1, C703.1, J701.7 (VDD), J701.8 (VDDI), J701.31 (IM0_SPI), J701.32 (IM2_SPI), J702.1 (VDD), R701.2, R702.2, R705.2, R706.2; also elsewhere on the board

Notes on the sheet:
Newhaven NHD-2.4-240320AF-CTXP-CTP: 3-wire, 9-bit SPI3; IM0/IM2 high. Unused WR/RD/DB grounded per module wiring diagram.
IOVDD/LCD/touch use trusted MCU rail; hold both resets low until firmware confirms 3.3V.
Touch uses I2C5 PD0/PD1 AF4, separate from power, audio and secure-element buses.
Connector equivalents are bottom-contact 40x0.5mm and 6x1.0mm. Verify actual flex thickness, pin-1 and bend clearance.
Display is a separately procured assembly, not an IC mounted by the board assembler.
