adlererik/voicevault/hardware/rev-b/voicevault-standalone-b0.kicad_pcb

## KiCad design hardware/rev-b/voicevault-standalone-b0.kicad_pcb (continued)

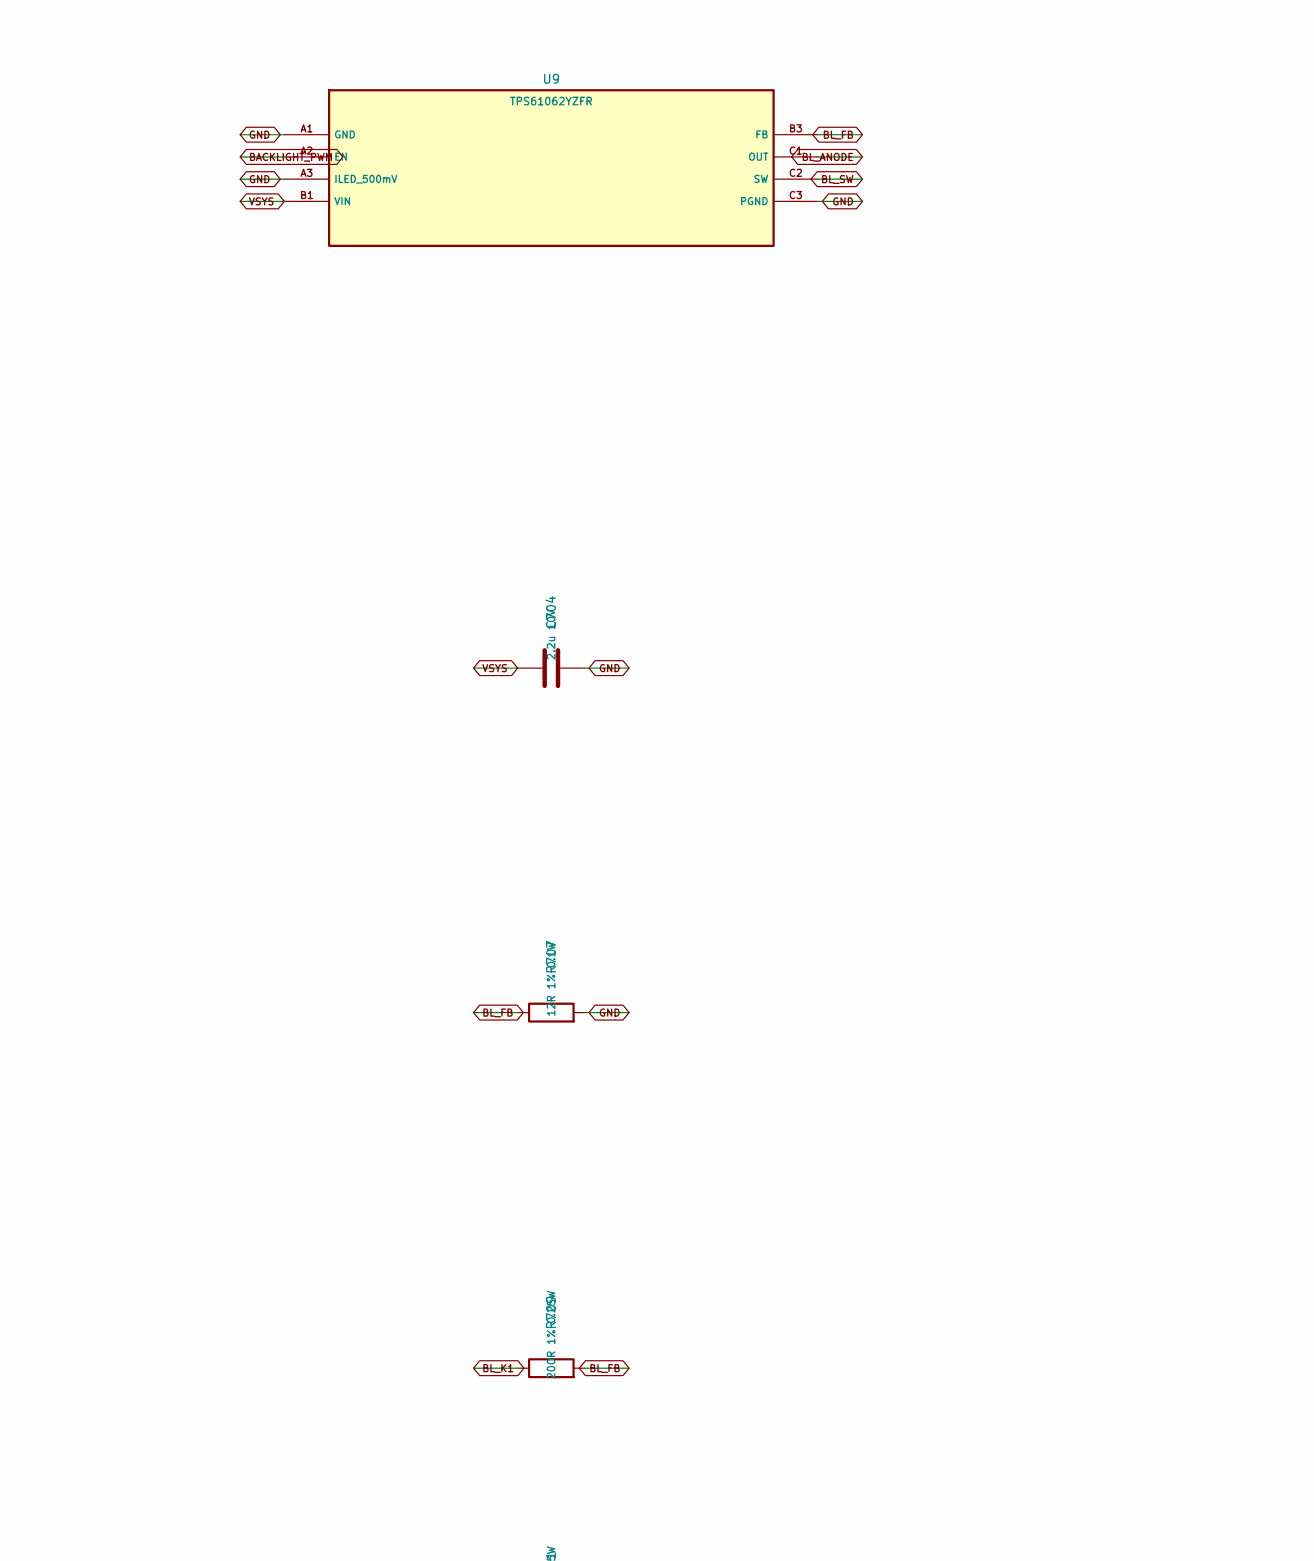
[picture p55: schematic circuit-backlight.kicad_sch, 40mA current-regulated parallel backlight, part in row 1, column 1]

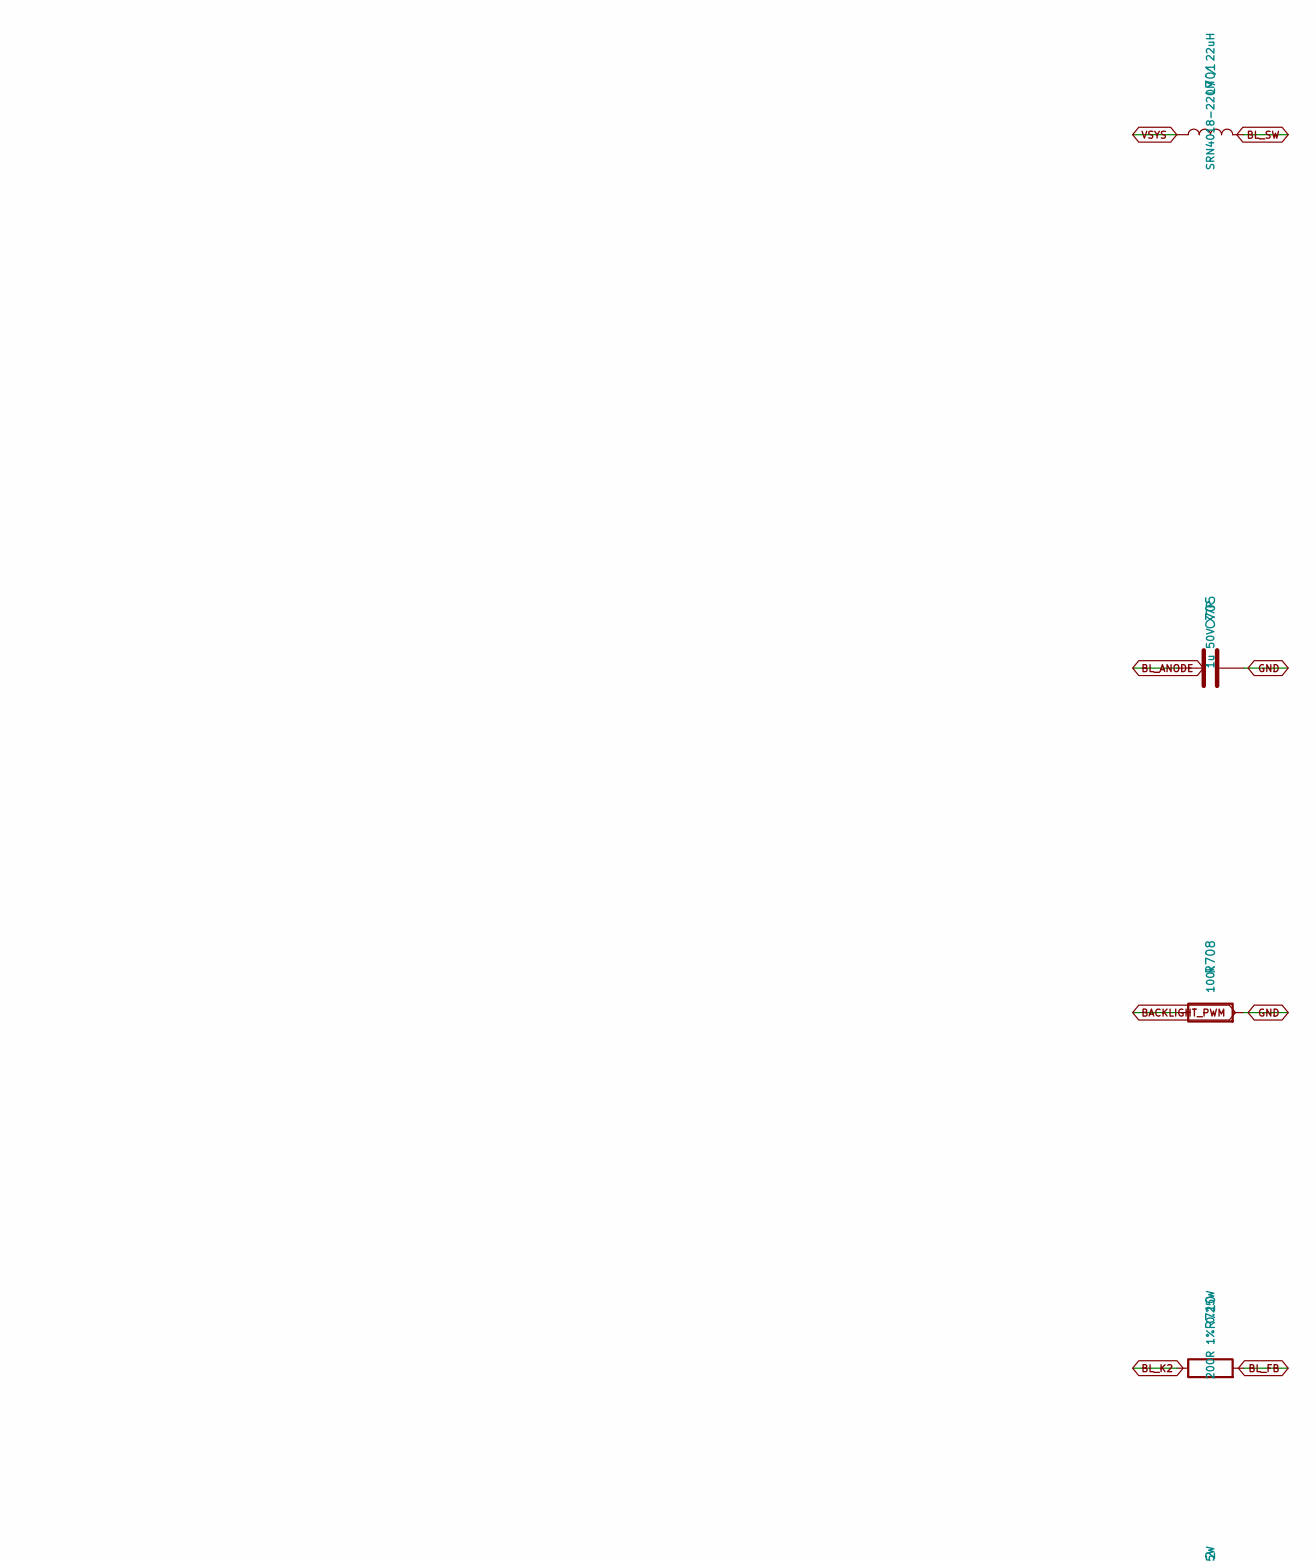
[picture p56: schematic circuit-backlight.kicad_sch, 40mA current-regulated parallel backlight, part in row 1, column 2]

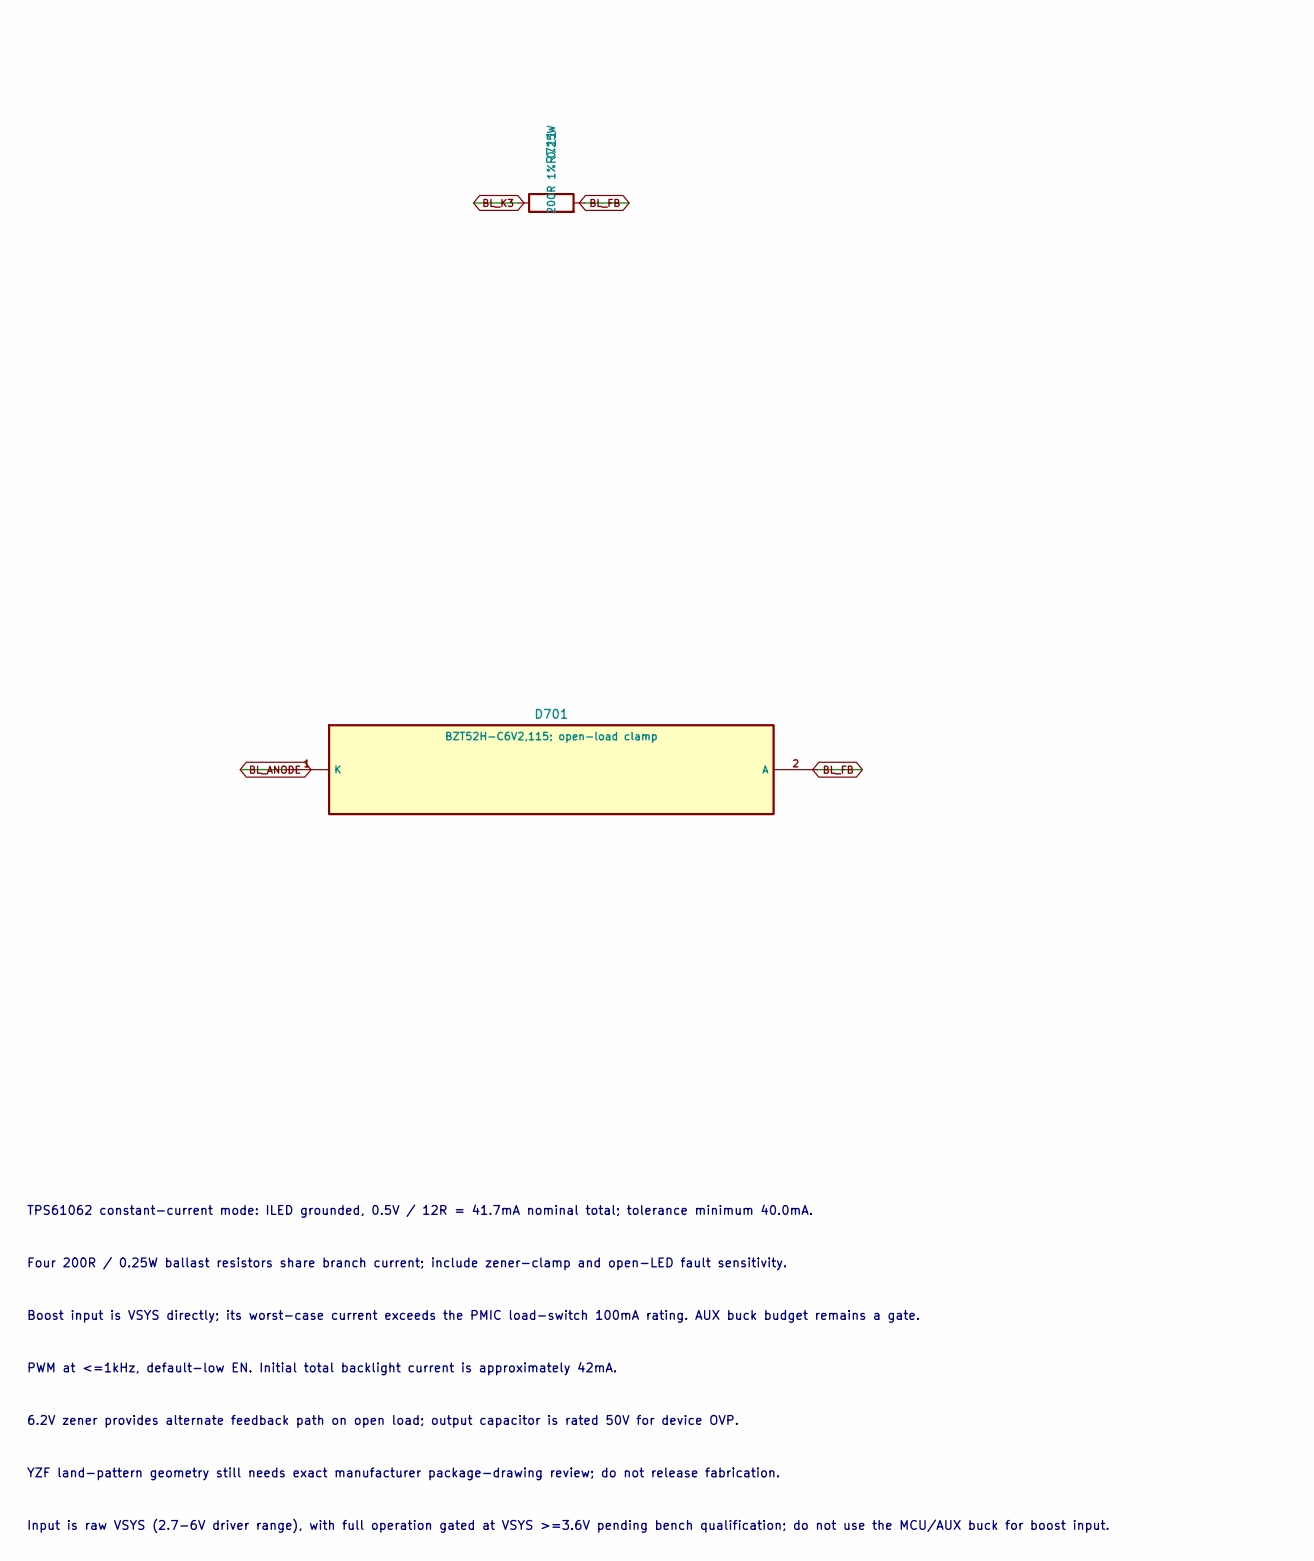
[picture p57: schematic circuit-backlight.kicad_sch, 40mA current-regulated parallel backlight, part in row 2, column 1]

Parts:
C704: 2.2u 10V; C_0603_1608Metric
C705: 1u 50V X7R; C_0805_2012Metric
D701: BZT52H-C6V2,115; open-load clamp; D_SOD-123F
L701: SRN4018-220M / 22uH; L_Bourns-SRN4018
R707: 12R 1% 0.1W; R_0402_1005Metric
R708: 100k; R_0402_1005Metric
R709, R710, R711, R712: 200R 1% 0.25W; R_0805_2012Metric
U9: TPS61062YZFR; TPS61062_YZF8_REVIEW

Connections:
BACKLIGHT_PWM: R708.1, U9.A2 (EN); also elsewhere on the board
BL_ANODE: C705.1, D701.1 (K), U9.C1 (OUT); also elsewhere on the board
BL_FB: D701.2 (A), R707.1, R709.2, R710.2, R711.2, R712.2, U9.B3 (FB)
BL_K1: R709.1; also elsewhere on the board
BL_K2: R710.1; also elsewhere on the board
BL_K3: R711.1; also elsewhere on the board
BL_K4: R712.1; also elsewhere on the board
BL_SW: L701.2, U9.C2 (SW)
GND: C704.2, C705.2, R707.2, R708.2, U9.A1 (GND), U9.A3 (ILED_500mV), U9.C3 (PGND); also elsewhere on the board
VSYS: C704.1, L701.1, U9.B1 (VIN); also elsewhere on the board

Notes on the sheet:
TPS61062 constant-current mode: ILED grounded, 0.5V / 12R = 41.7mA nominal total; tolerance minimum 40.0mA.
Four 200R / 0.25W ballast resistors share branch current; include zener-clamp and open-LED fault sensitivity.
Boost input is VSYS directly; its worst-case current exceeds the PMIC load-switch 100mA rating. AUX buck budget remains a gate.
PWM at <=1kHz, default-low EN. Initial total backlight current is approximately 42mA.
6.2V zener provides alternate feedback path on open load; output capacitor is rated 50V for device OVP.
YZF land-pattern geometry still needs exact manufacturer package-drawing review; do not release fabrication.
Input is raw VSYS (2.7-6V driver range), with full operation gated at VSYS >=3.6V pending bench qualification; do not use the MCU/AUX buck for boost input.

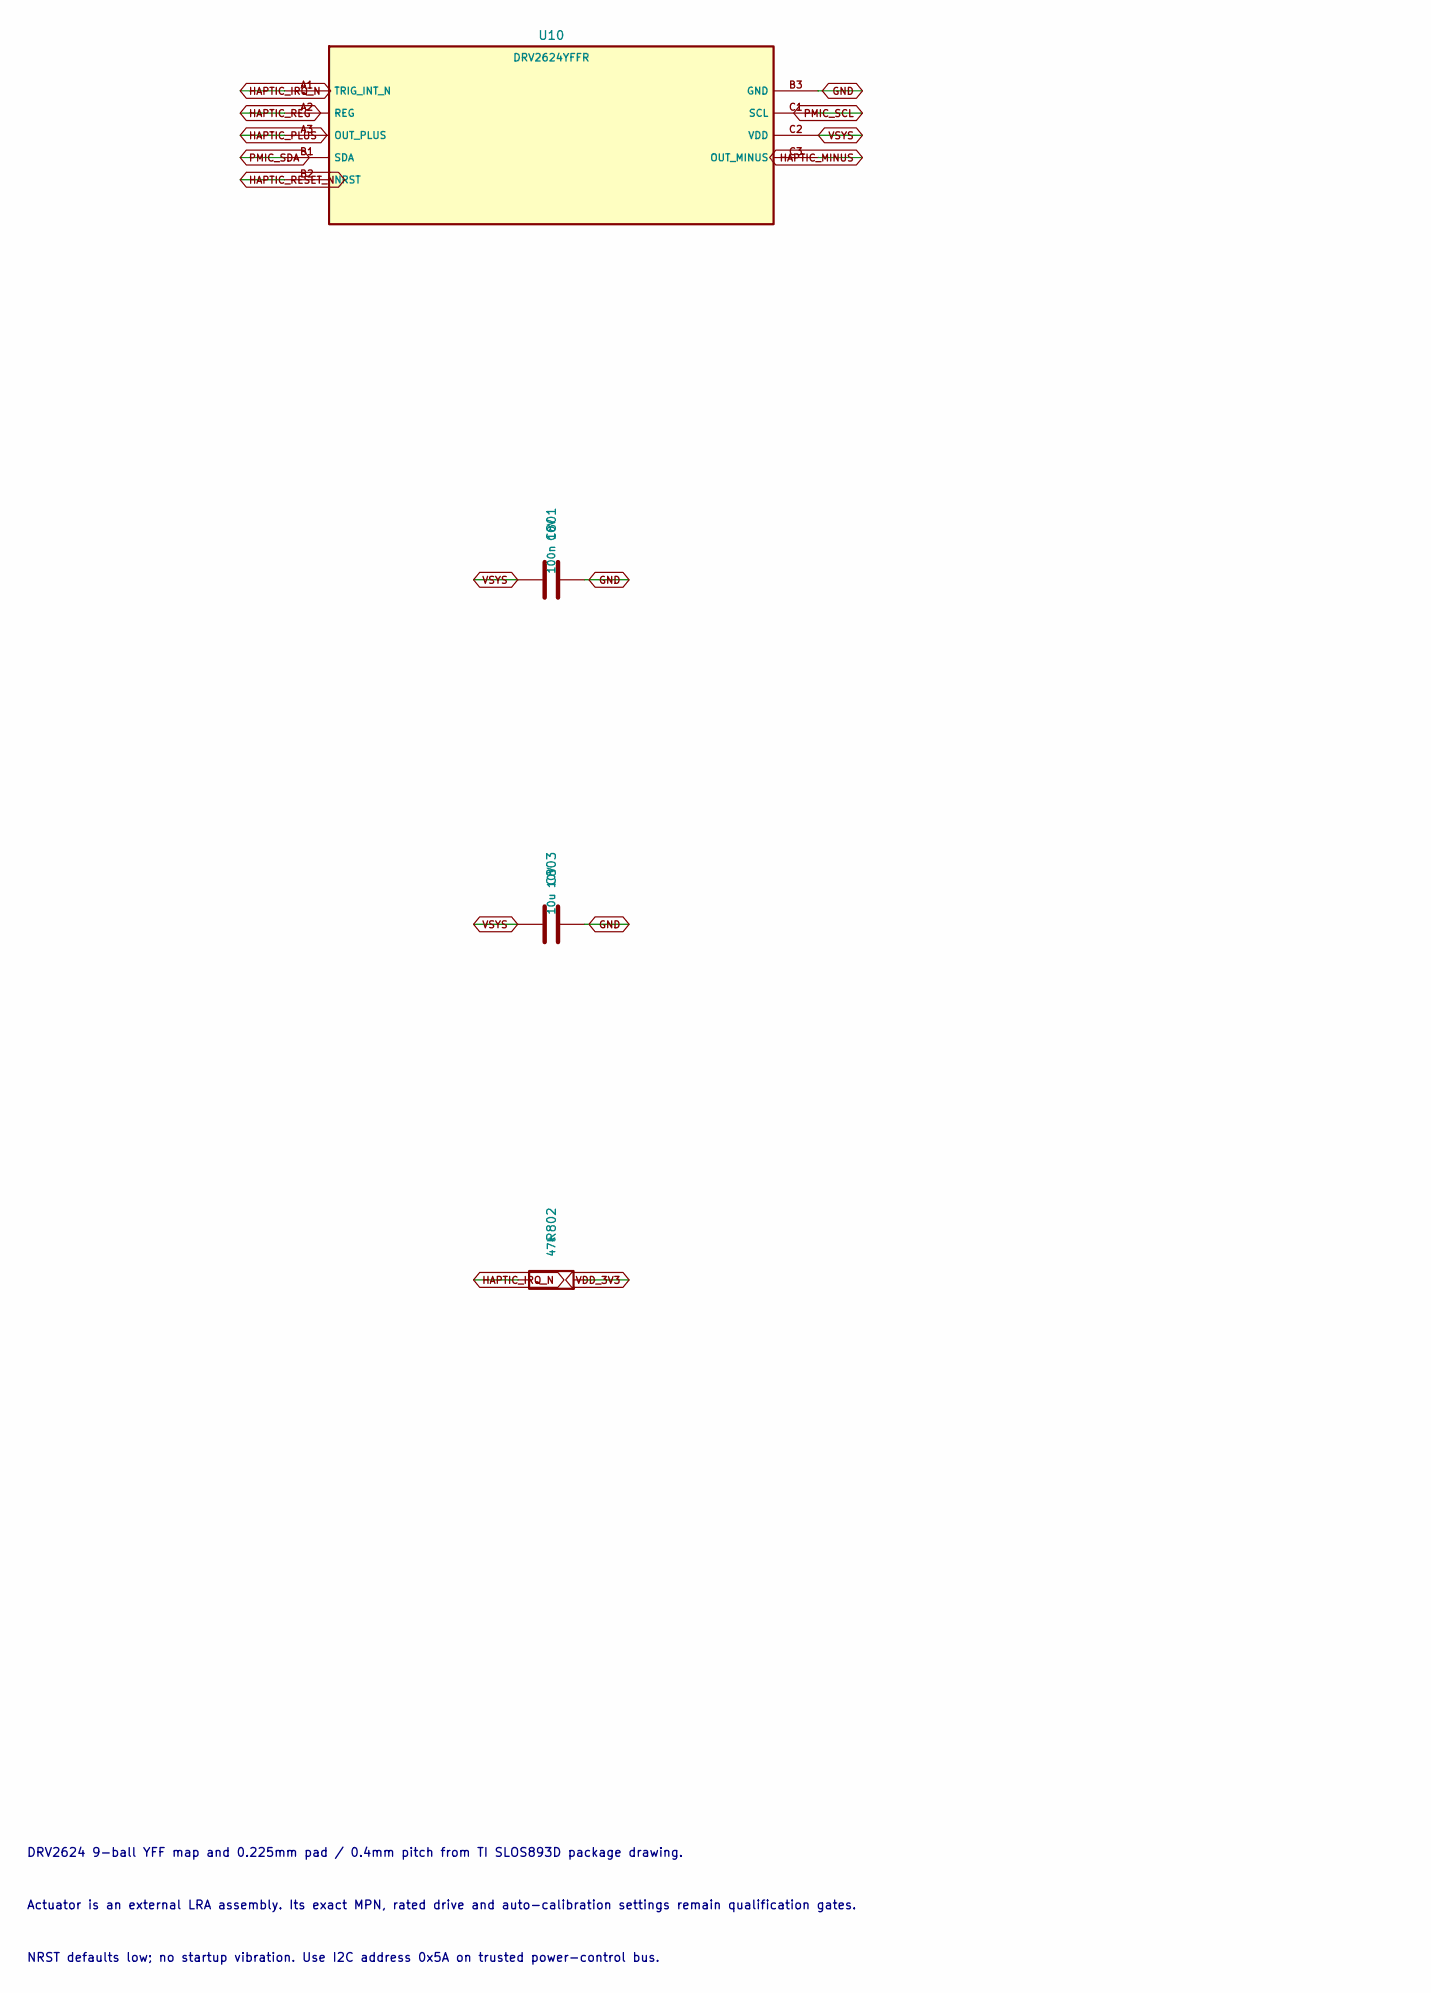
[picture p58: schematic circuit-haptic.kicad_sch, Haptic feedback driver, part in row 1, column 1]

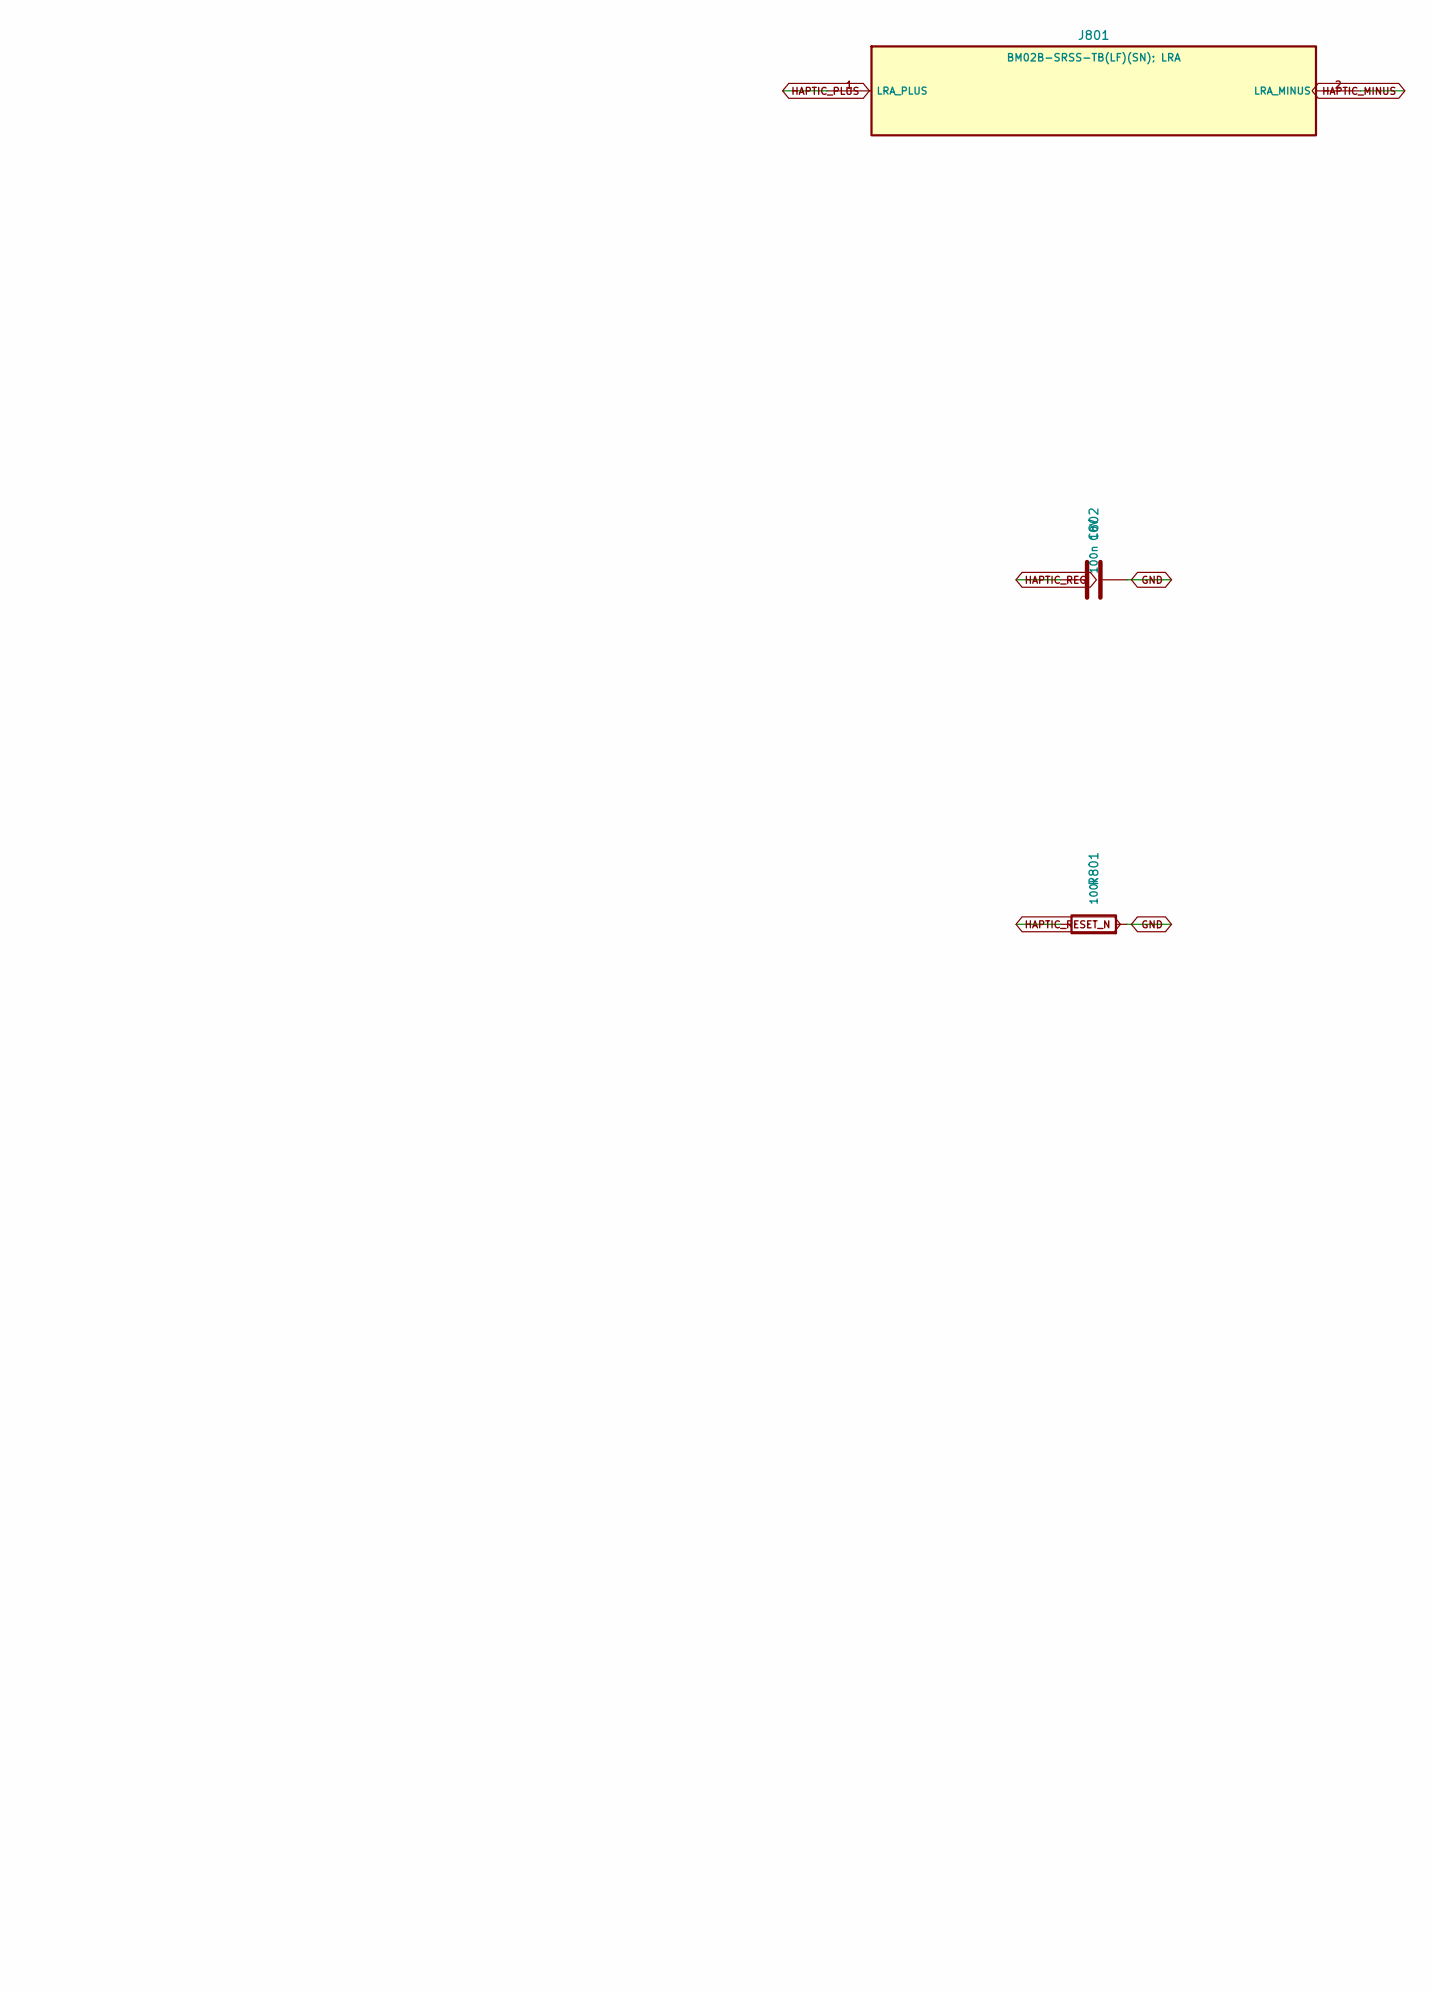
[picture p59: schematic circuit-haptic.kicad_sch, Haptic feedback driver, part in row 1, column 2]

Parts:
C801, C802: 100n 10V; C_0402_1005Metric
C803: 10u 10V; C_0805_2012Metric
J801: BM02B-SRSS-TB(LF)(SN); LRA; JST_SH_BM02B-SRSS-TB_1x02-1MP_P1.00mm_Vertical
R801: 100k; R_0402_1005Metric
R802: 47k; R_0402_1005Metric
U10: DRV2624YFFR; DRV2624_YFF9

Connections:
GND: C801.2, C802.2, C803.2, R801.2, U10.B3 (GND); also elsewhere on the board
HAPTIC_IRQ_N: R802.1, U10.A1 (TRIG_INT_N); also elsewhere on the board
HAPTIC_MINUS: J801.2 (LRA_MINUS), U10.C3 (OUT_MINUS)
HAPTIC_PLUS: J801.1 (LRA_PLUS), U10.A3 (OUT_PLUS)
HAPTIC_REG: C802.1, U10.A2 (REG)
HAPTIC_RESET_N: R801.1, U10.B2 (NRST); also elsewhere on the board
PMIC_SCL: U10.C1 (SCL); also elsewhere on the board
PMIC_SDA: U10.B1 (SDA); also elsewhere on the board
VDD_3V3: R802.2; also elsewhere on the board
VSYS: C801.1, C803.1, U10.C2 (VDD); also elsewhere on the board

Notes on the sheet:
DRV2624 9-ball YFF map and 0.225mm pad / 0.4mm pitch from TI SLOS893D package drawing.
Actuator is an external LRA assembly. Its exact MPN, rated drive and auto-calibration settings remain qualification gates.
NRST defaults low; no startup vibration. Use I2C address 0x5A on trusted power-control bus.

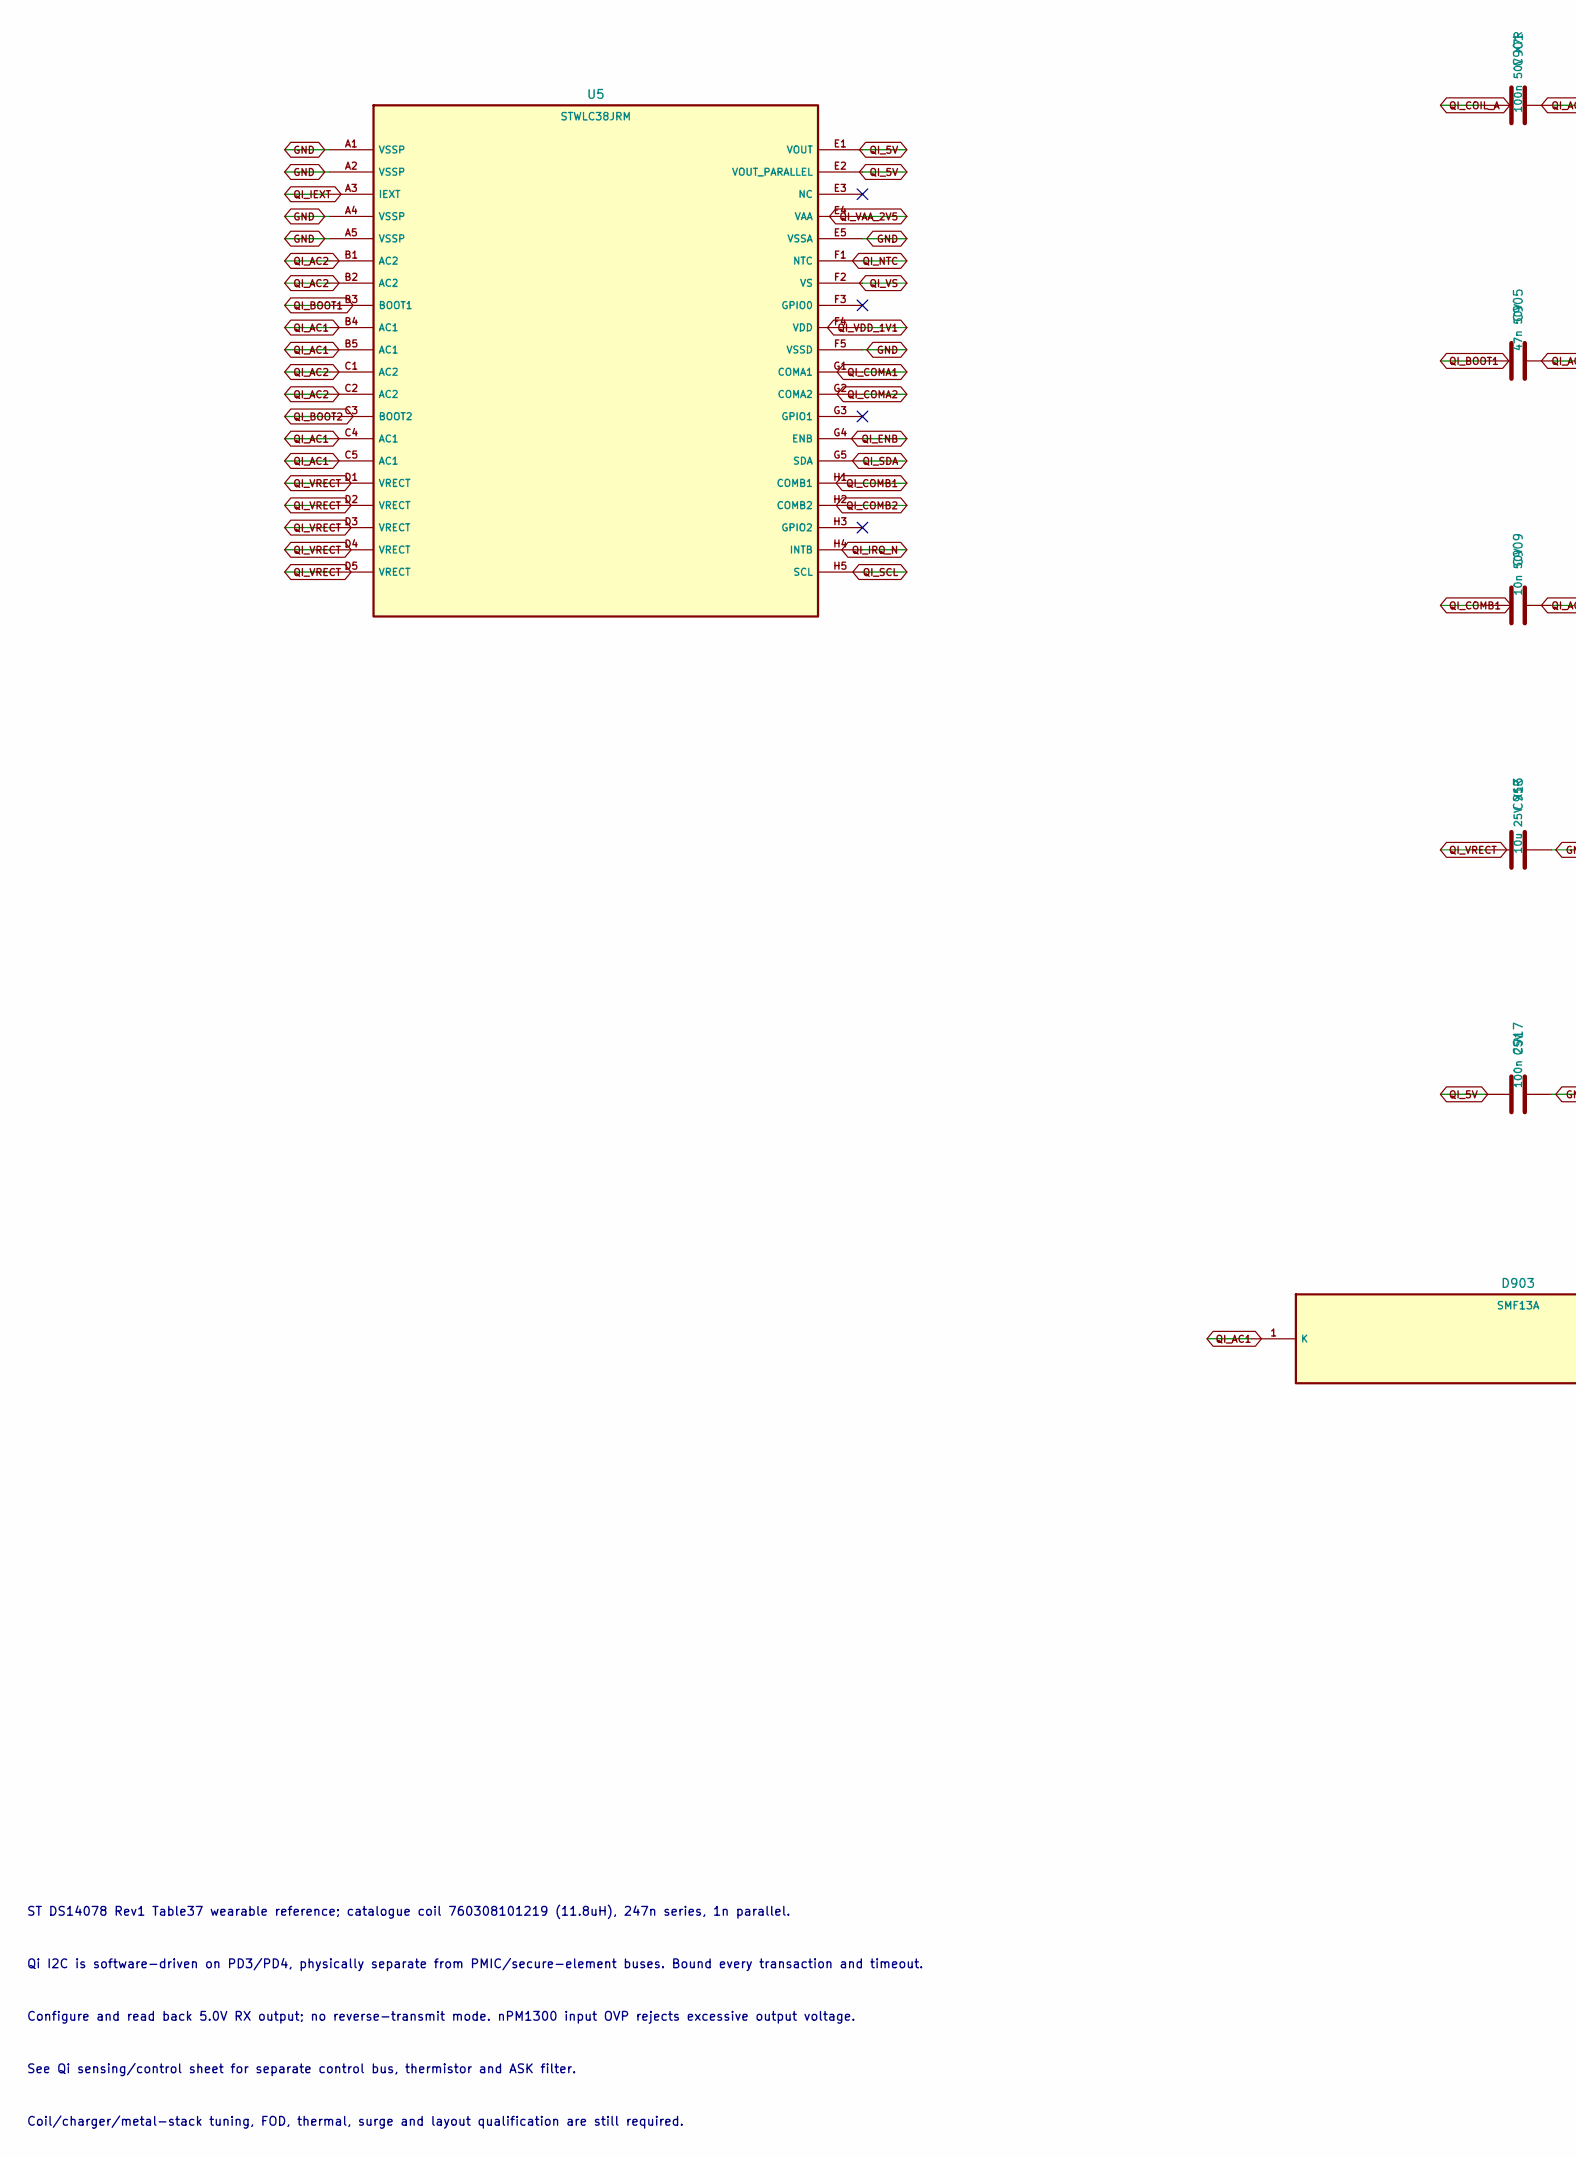
[picture p60: schematic circuit-qi.kicad_sch, Qi receiver and isolated power-control interface, part in row 1, column 1]

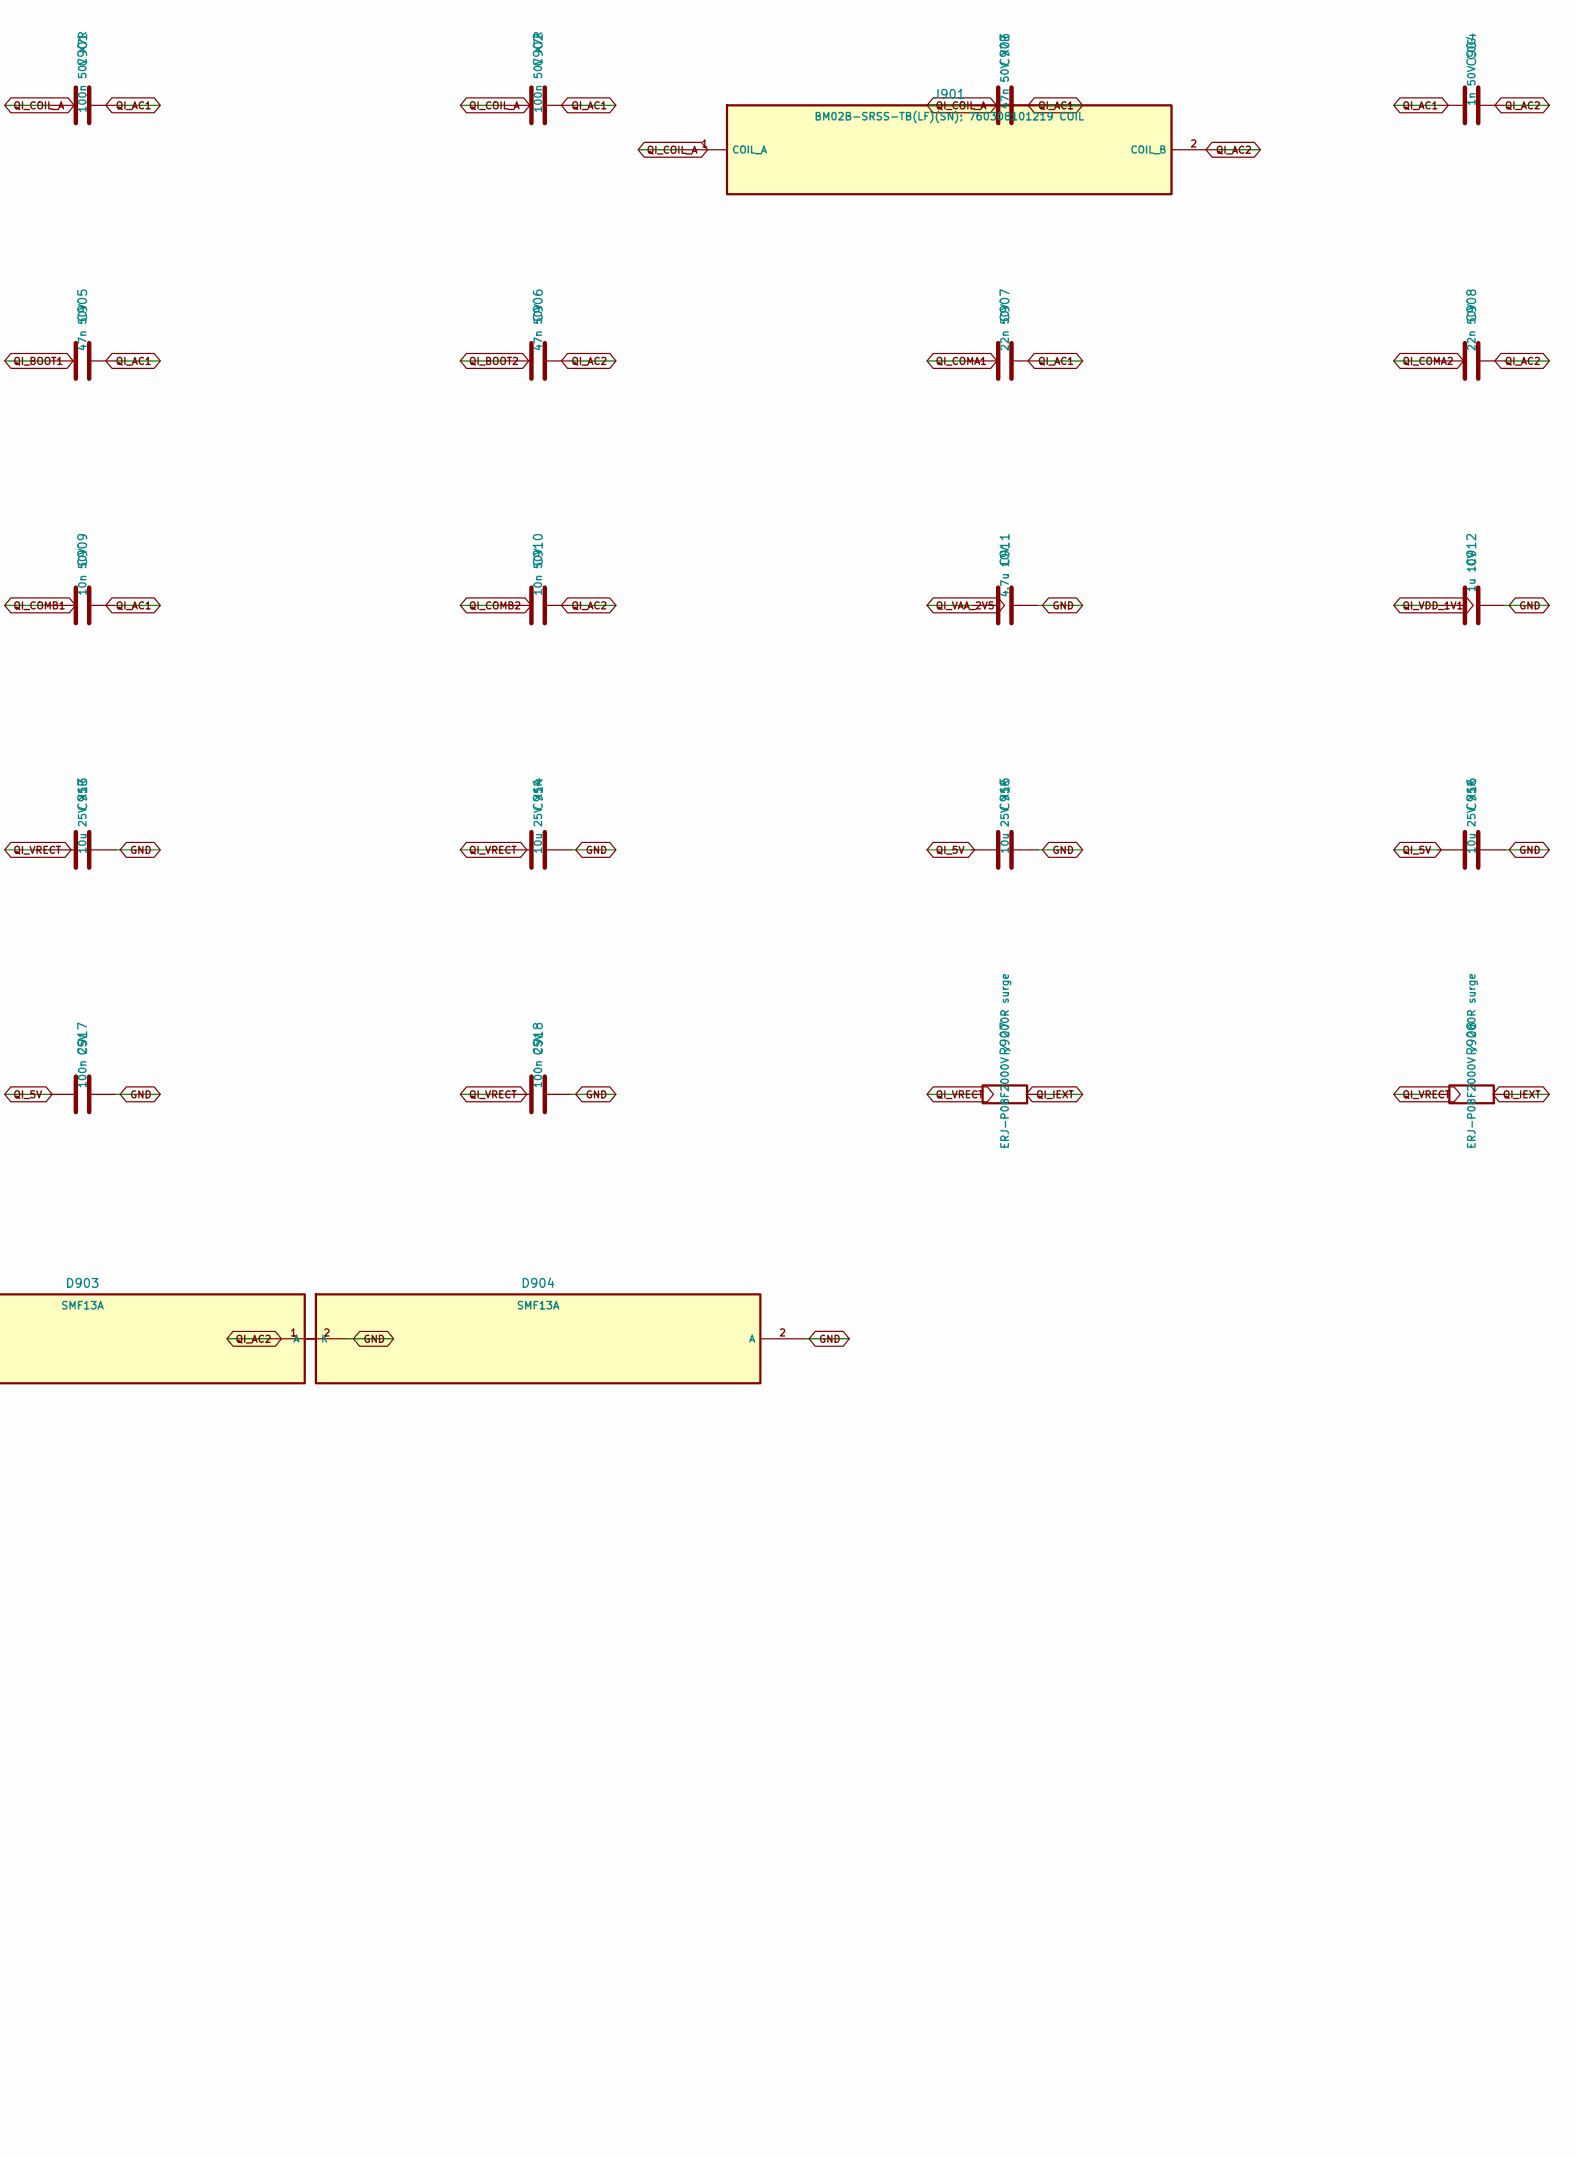
[picture p61: schematic circuit-qi.kicad_sch, Qi receiver and isolated power-control interface, part in row 1, column 2]

Parts:
C901, C902: 100n 50V X7R; C_0805_2012Metric
C903: 47n 50V X7R; C_0805_2012Metric
C904: 1n 50V C0G; C_0603_1608Metric
C905, C906: 47n 50V; C_0603_1608Metric
C907, C908: 22n 50V; C_0603_1608Metric
C909, C910: 10n 50V; C_0603_1608Metric
C911: 4.7u 10V; C_0603_1608Metric
C912: 1u 10V; C_0603_1608Metric
C913, C914, C915, C916: 10u 25V X5R; C_0805_2012Metric
C917, C918: 100n 25V; C_0603_1608Metric
D903, D904: SMF13A; D_SOD-123F
J901: BM02B-SRSS-TB(LF)(SN); 760308101219 COIL; JST_SH_BM02B-SRSS-TB_1x02-1MP_P1.00mm_Vertical
R907, R908: ERJ-P08F2000V / 200R surge; R_1206_3216Metric
U5: STWLC38JRM; STWLC38_WLCSP40_REVIEW

Connections:
GND: C911.2, C912.2, C913.2, C914.2, C915.2, C916.2, C917.2, C918.2, D903.2 (A), D904.2 (A), U5.A1 (VSSP), U5.A2 (VSSP), U5.A4 (VSSP), U5.A5 (VSSP), U5.E5 (VSSA), U5.F5 (VSSD); also elsewhere on the board
QI_5V: C915.1, C916.1, C917.1, U5.E1 (VOUT), U5.E2 (VOUT_PARALLEL); also elsewhere on the board
QI_AC1: C901.2, C902.2, C903.2, C904.1, C905.2, C907.2, C909.2, D903.1 (K), U5.B4 (AC1), U5.B5 (AC1), U5.C4 (AC1), U5.C5 (AC1)
QI_AC2: C904.2, C906.2, C908.2, C910.2, D904.1 (K), J901.2 (COIL_B), U5.B1 (AC2), U5.B2 (AC2), U5.C1 (AC2), U5.C2 (AC2)
QI_BOOT1: C905.1, U5.B3 (BOOT1)
QI_BOOT2: C906.1, U5.C3 (BOOT2)
QI_COIL_A: C901.1, C902.1, C903.1, J901.1 (COIL_A); also elsewhere on the board
QI_COMA1: C907.1, U5.G1 (COMA1)
QI_COMA2: C908.1, U5.G2 (COMA2)
QI_COMB1: C909.1, U5.H1 (COMB1)
QI_COMB2: C910.1, U5.H2 (COMB2)
QI_ENB: U5.G4 (ENB); also elsewhere on the board
QI_IEXT: R907.2, R908.2, U5.A3 (IEXT)
QI_IRQ_N: U5.H4 (INTB); also elsewhere on the board
QI_NTC: U5.F1 (NTC); also elsewhere on the board
QI_SCL: U5.H5 (SCL); also elsewhere on the board
QI_SDA: U5.G5 (SDA); also elsewhere on the board
QI_VAA_2V5: C911.1, U5.E4 (VAA); also elsewhere on the board
QI_VDD_1V1: C912.1, U5.F4 (VDD)
QI_VRECT: C913.1, C914.1, C918.1, R907.1, R908.1, U5.D1 (VRECT), U5.D2 (VRECT), U5.D3 (VRECT), U5.D4 (VRECT), U5.D5 (VRECT)
QI_VS: U5.F2 (VS); also elsewhere on the board

Notes on the sheet:
ST DS14078 Rev1 Table37 wearable reference; catalogue coil 760308101219 (11.8uH), 247n series, 1n parallel.
Qi I2C is software-driven on PD3/PD4, physically separate from PMIC/secure-element buses. Bound every transaction and timeout.
Configure and read back 5.0V RX output; no reverse-transmit mode. nPM1300 input OVP rejects excessive output voltage.
See Qi sensing/control sheet for separate control bus, thermistor and ASK filter.
Coil/charger/metal-stack tuning, FOD, thermal, surge and layout qualification are still required.
