adlererik/voicevault/hardware/rev-b/voicevault-standalone-b0.kicad_pcb

## KiCad design hardware/rev-b/voicevault-standalone-b0.kicad_pcb (continued)

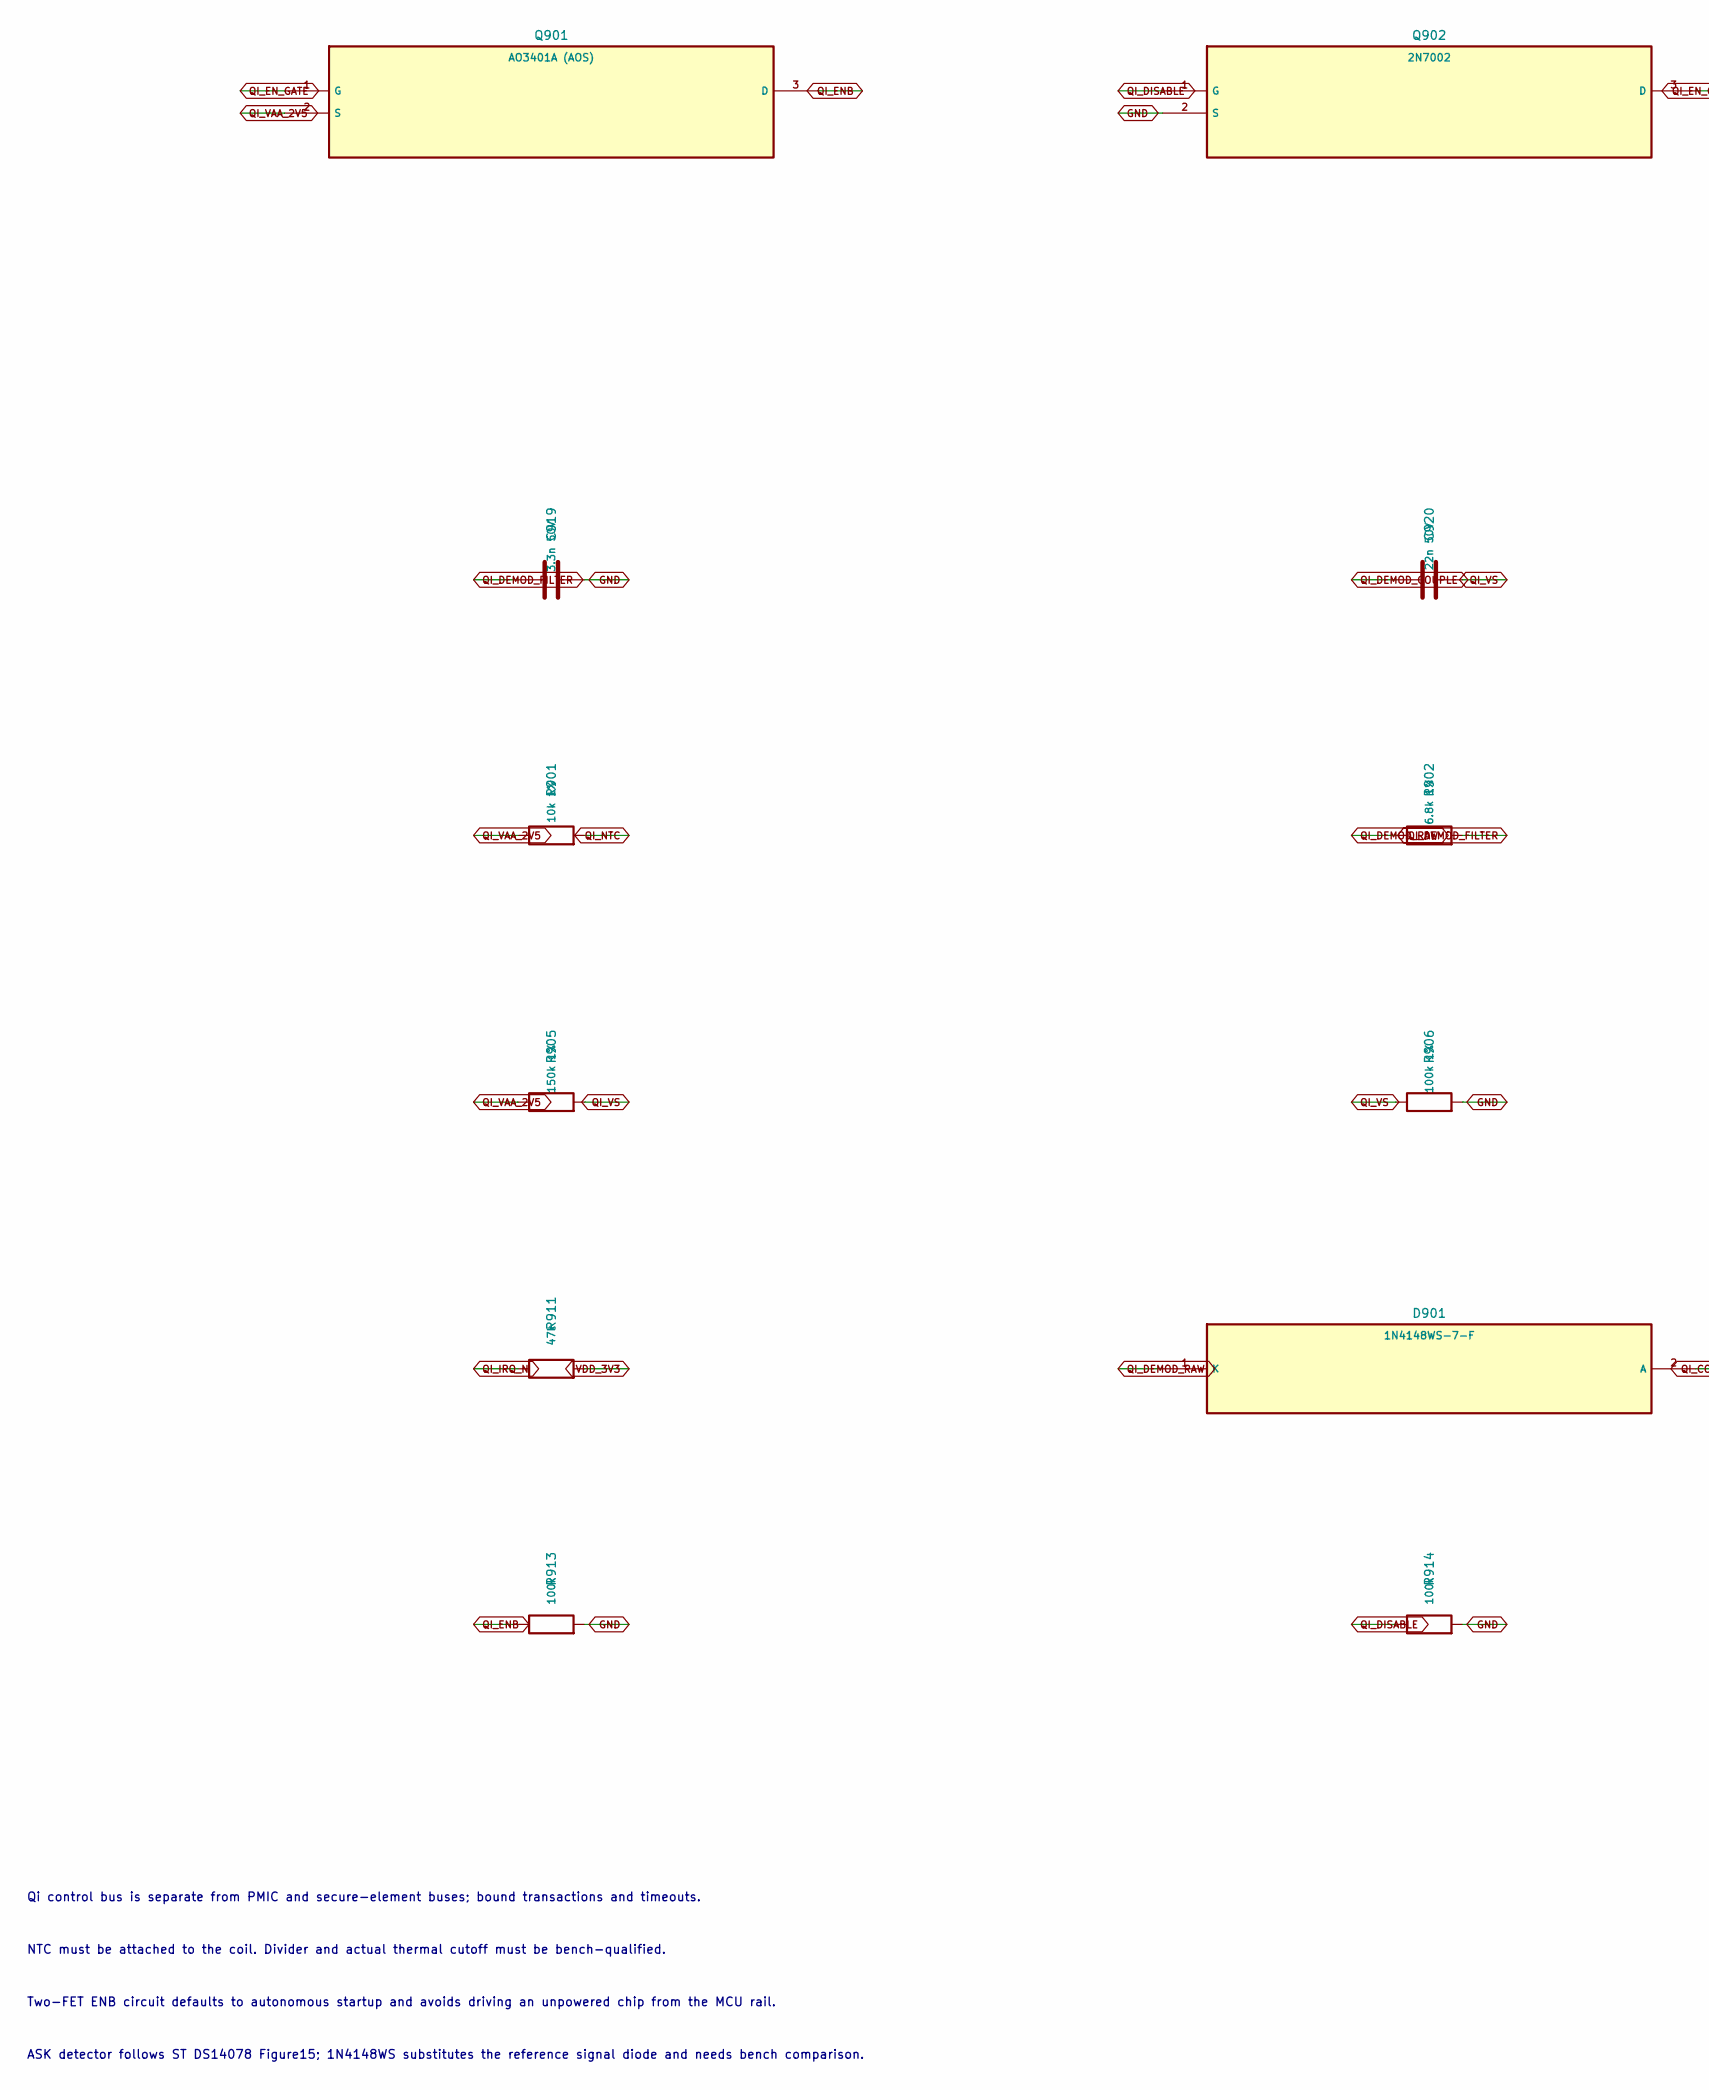
[picture p62: schematic circuit-qi-control.kicad_sch, Qi sensing, ASK detector and host disable, part in row 1, column 1]

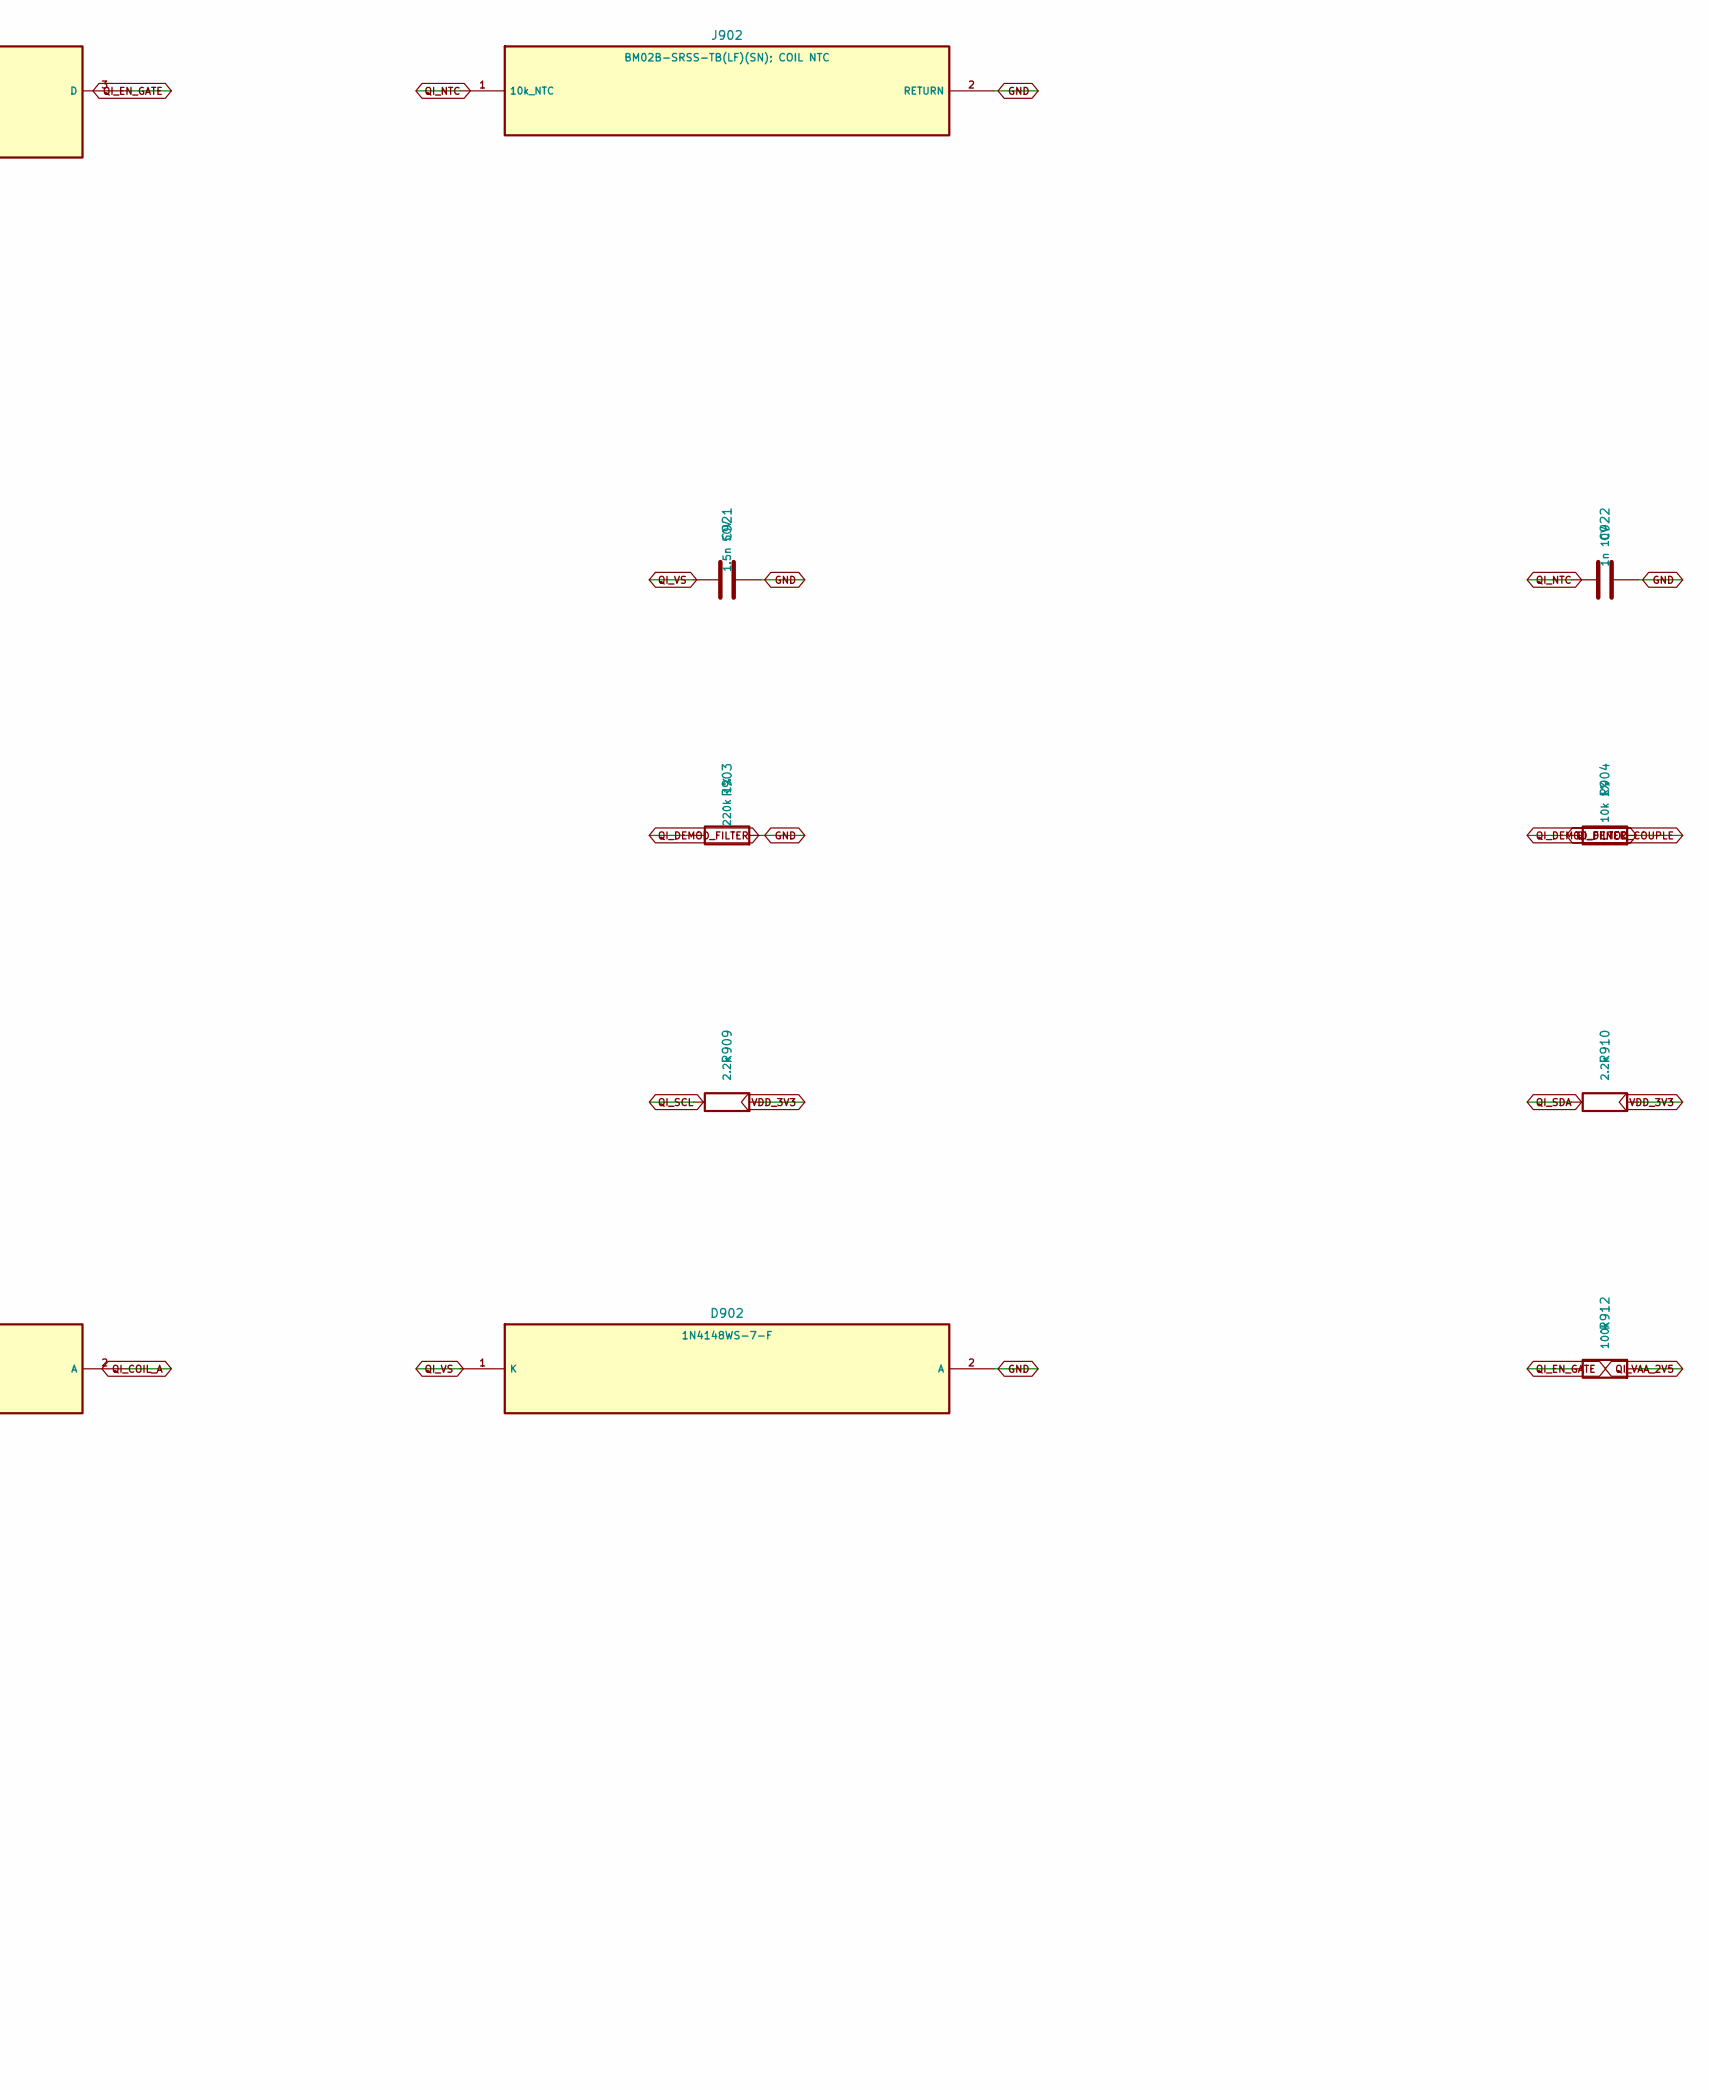
[picture p63: schematic circuit-qi-control.kicad_sch, Qi sensing, ASK detector and host disable, part in row 1, column 2]

Parts:
C919: 3.3n 50V; C_0603_1608Metric
C920: 22n 50V; C_0603_1608Metric
C921: 1.5n 50V; C_0603_1608Metric
C922: 1n 10V; C_0402_1005Metric
D901, D902: 1N4148WS-7-F; D_SOD-323
J902: BM02B-SRSS-TB(LF)(SN); COIL NTC; JST_SH_BM02B-SRSS-TB_1x02-1MP_P1.00mm_Vertical
Q901: AO3401A (AOS); SOT-23
Q902: 2N7002; SOT-23
R901, R904: 10k 1%; R_0402_1005Metric
R902: 6.8k 1%; R_0402_1005Metric
R903: 220k 1%; R_0402_1005Metric
R905: 150k 1%; R_0402_1005Metric
R906: 100k 1%; R_0402_1005Metric
R909, R910: 2.2k; R_0402_1005Metric
R911: 47k; R_0402_1005Metric
R912, R913, R914: 100k; R_0402_1005Metric

Connections:
GND: C919.2, C921.2, C922.2, D902.2 (A), J902.2 (RETURN), Q902.2 (S), R903.2, R906.2, R913.2, R914.2; also elsewhere on the board
QI_COIL_A: D901.2 (A); also elsewhere on the board
QI_DEMOD_COUPLE: C920.1, R904.2
QI_DEMOD_FILTER: C919.1, R902.2, R903.1, R904.1
QI_DEMOD_RAW: D901.1 (K), R902.1
QI_DISABLE: Q902.1 (G), R914.1; also elsewhere on the board
QI_ENB: Q901.3 (D), R913.1; also elsewhere on the board
QI_EN_GATE: Q901.1 (G), Q902.3 (D), R912.1
QI_IRQ_N: R911.1; also elsewhere on the board
QI_NTC: C922.1, J902.1 (10k_NTC), R901.2; also elsewhere on the board
QI_SCL: R909.1; also elsewhere on the board
QI_SDA: R910.1; also elsewhere on the board
QI_VAA_2V5: Q901.2 (S), R901.1, R905.1, R912.2; also elsewhere on the board
QI_VS: C920.2, C921.1, D902.1 (K), R905.2, R906.1; also elsewhere on the board
VDD_3V3: R909.2, R910.2, R911.2; also elsewhere on the board

Notes on the sheet:
Qi control bus is separate from PMIC and secure-element buses; bound transactions and timeouts.
NTC must be attached to the coil. Divider and actual thermal cutoff must be bench-qualified.
Two-FET ENB circuit defaults to autonomous startup and avoids driving an unpowered chip from the MCU rail.
ASK detector follows ST DS14078 Figure15; 1N4148WS substitutes the reference signal diode and needs bench comparison.

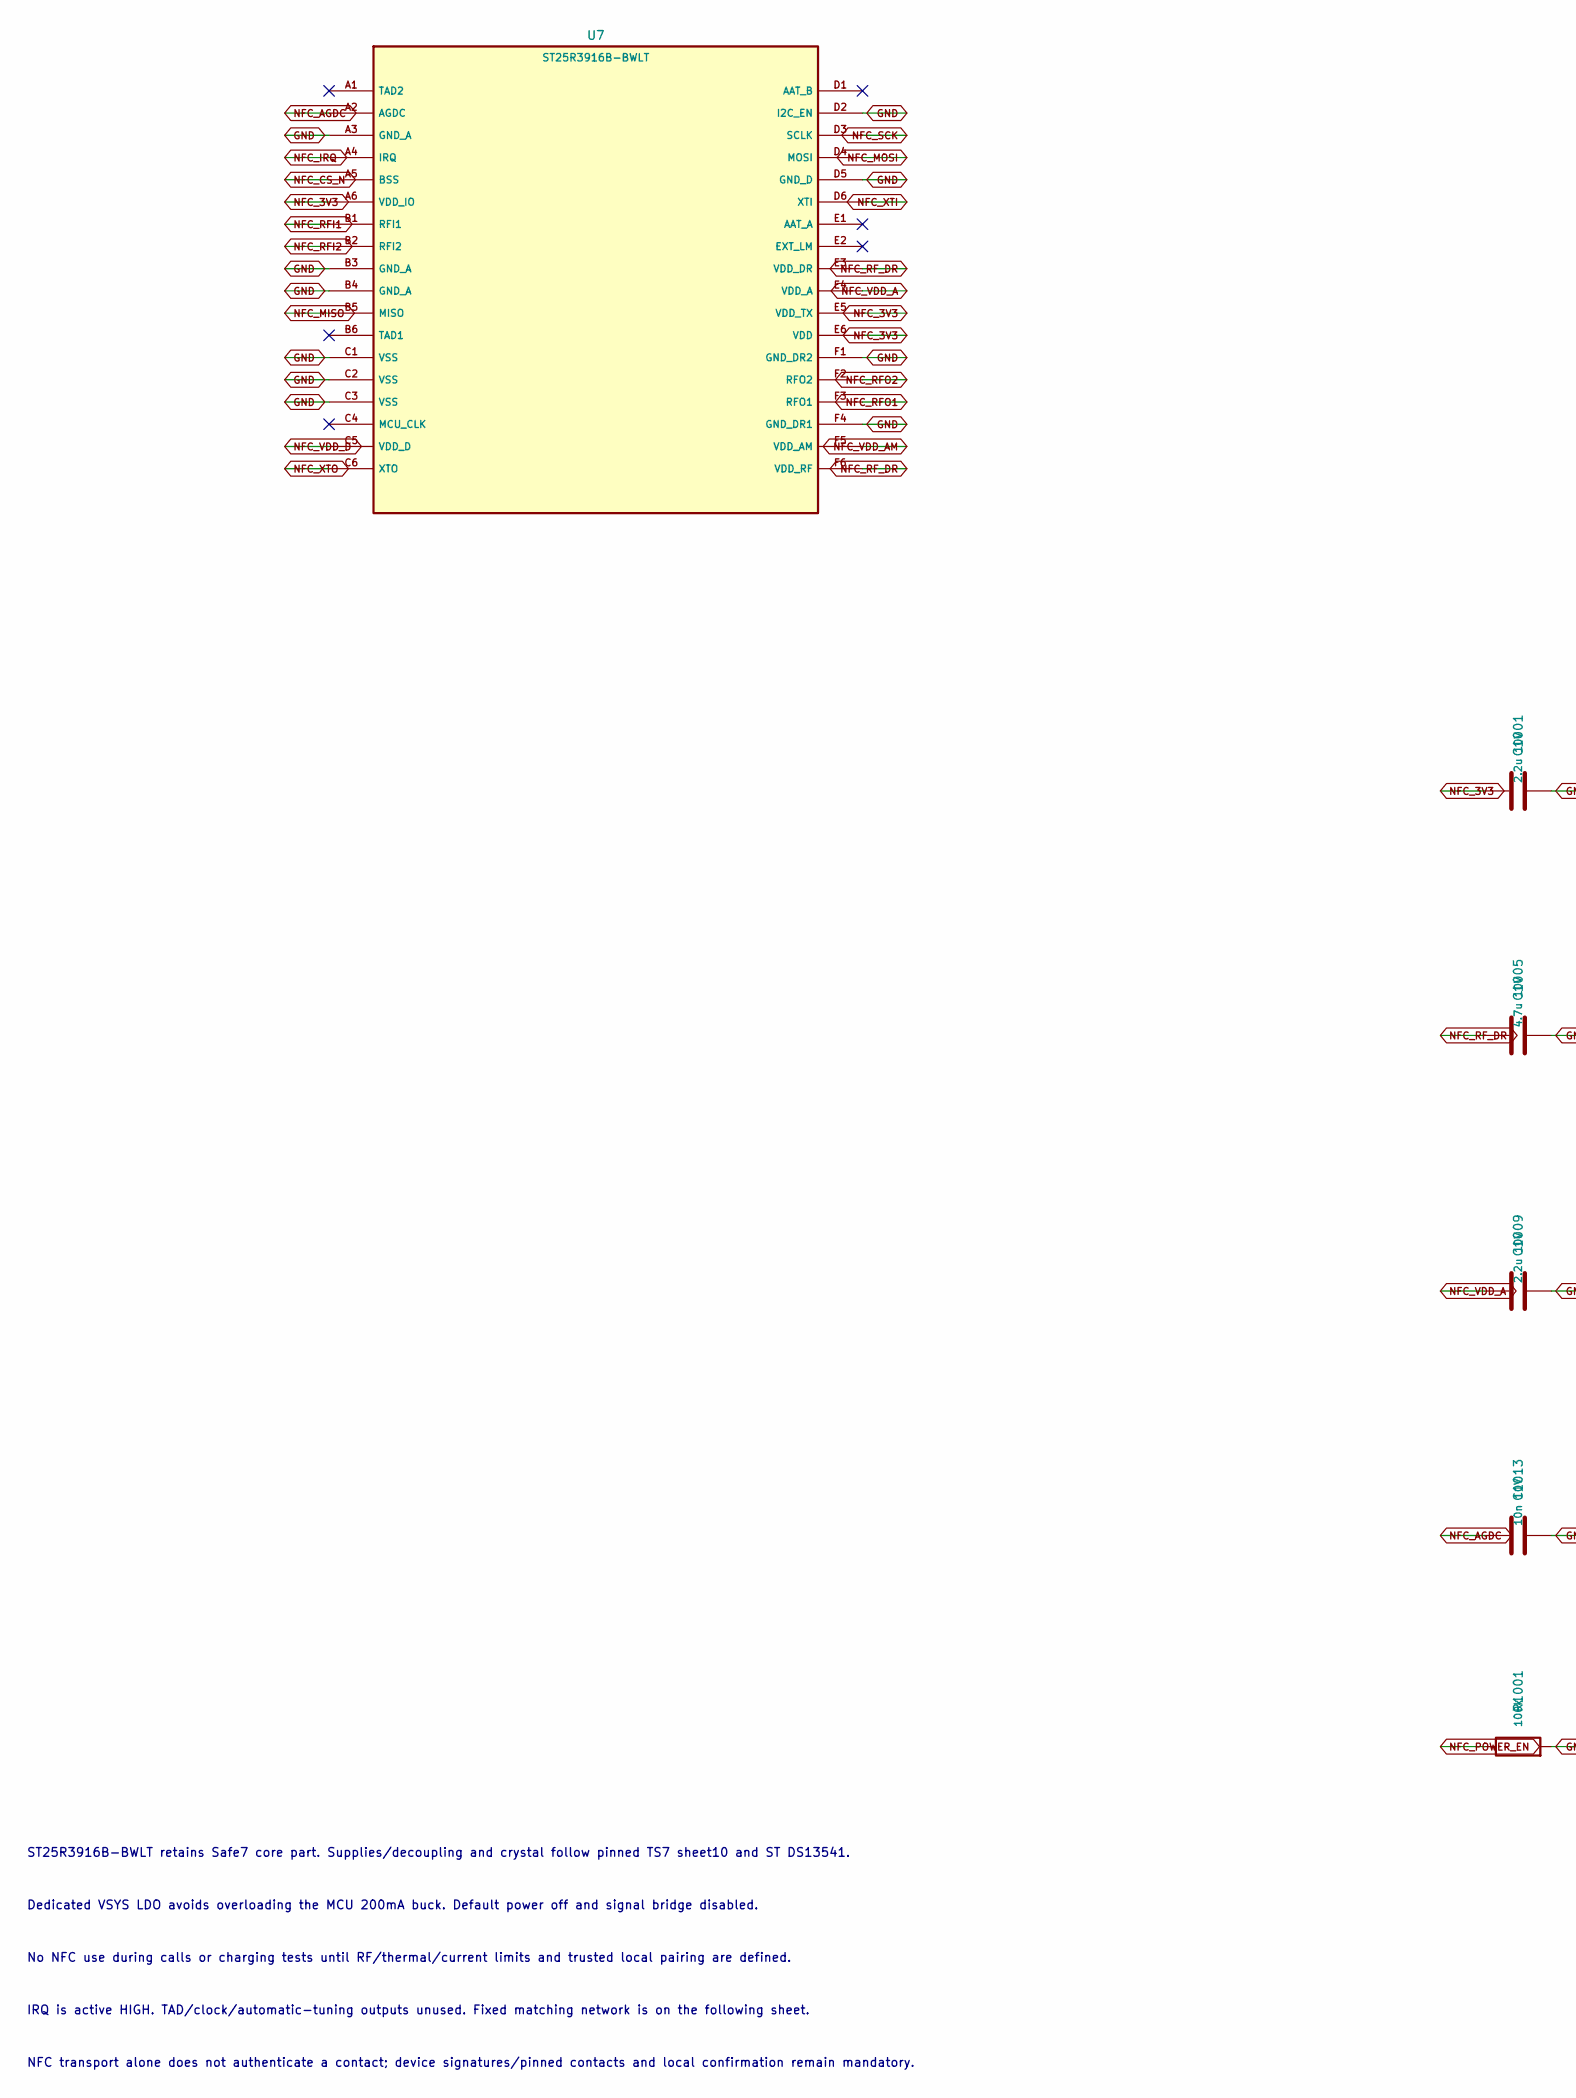
[picture p64: schematic circuit-nfc.kicad_sch, Optional locally enabled NFC transceiver, part in row 1, column 1]

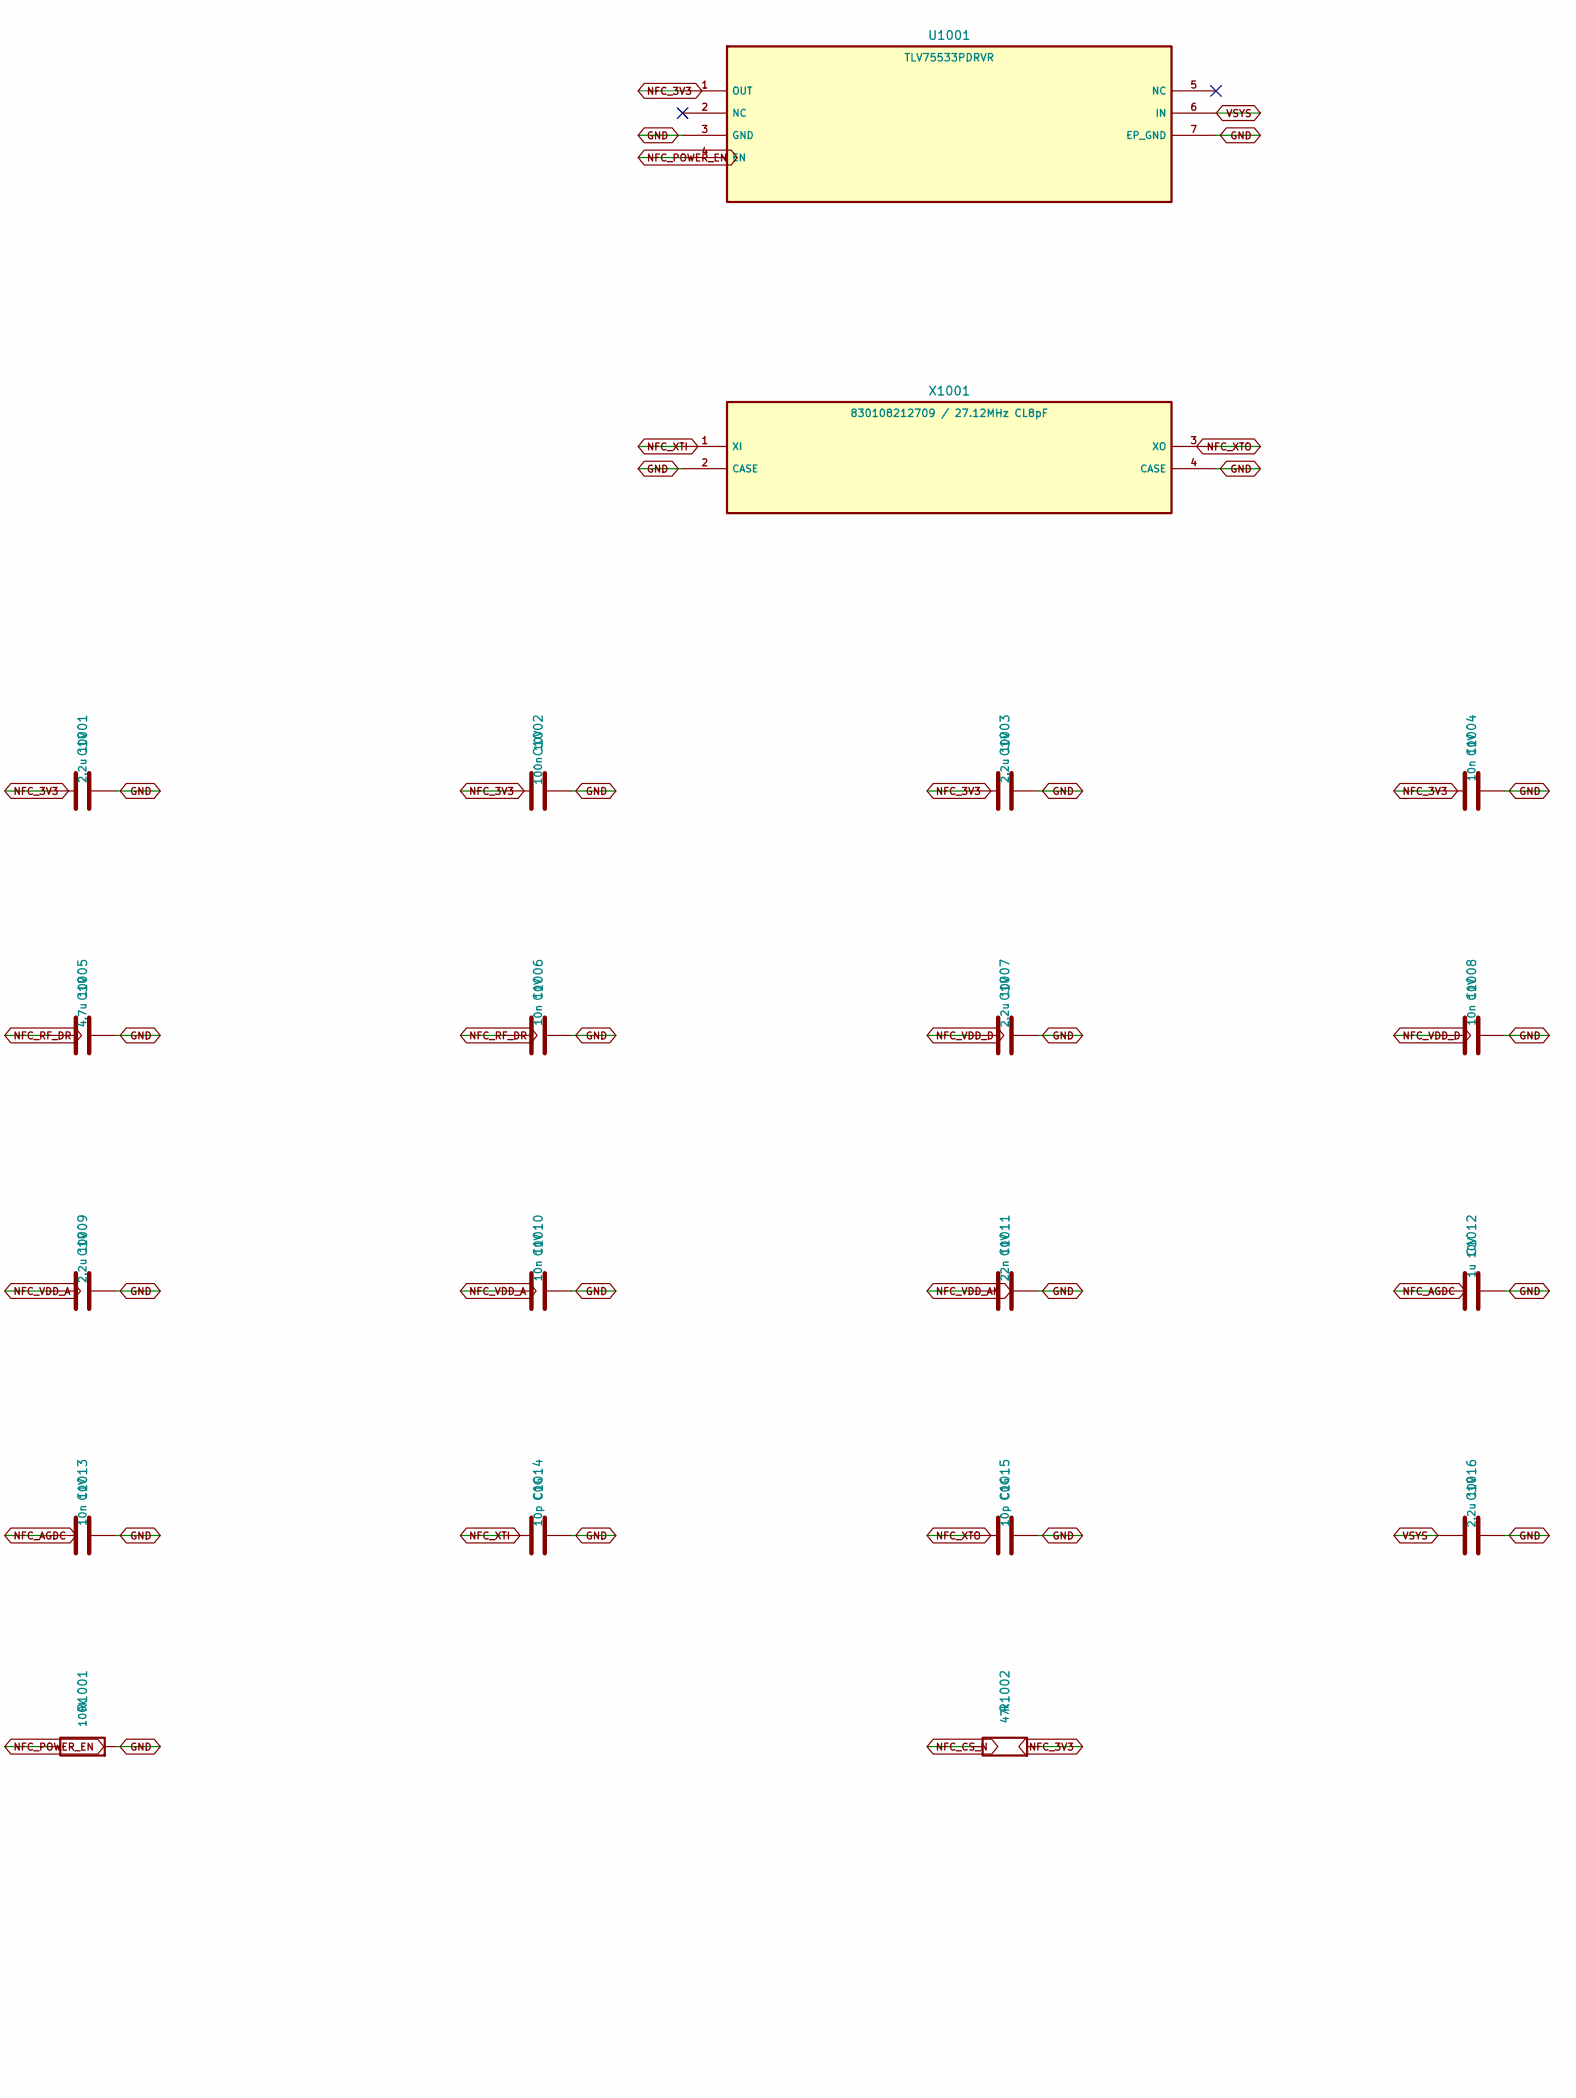
[picture p65: schematic circuit-nfc.kicad_sch, Optional locally enabled NFC transceiver, part in row 1, column 2]

Parts:
C1001, C1003, C1007, C1009, C1016: 2.2u 10V; C_0603_1608Metric
C1002: 100n 10V; C_0402_1005Metric
C1004, C1006, C1008, C1010, C1013: 10n 10V; C_0402_1005Metric
C1005: 4.7u 10V; C_0603_1608Metric
C1011: 22n 10V; C_0402_1005Metric
C1012: 1u 10V; C_0603_1608Metric
C1014, C1015: 10p C0G; C_0402_1005Metric
R1001: 100k; R_0402_1005Metric
R1002: 47k; R_0402_1005Metric
U7: ST25R3916B-BWLT; ST25R3916B_WLCSP36_REVIEW
U1001: TLV75533PDRVR; TI_DRV0006A_WSON6_2x2_EP1x1p6
X1001: 830108212709 / 27.12MHz CL8pF; Crystal_SMD_2016-4Pin_2.0x1.6mm

Connections:
GND: C1001.2, C1002.2, C1003.2, C1004.2, C1005.2, C1006.2, C1007.2, C1008.2, C1009.2, C1010.2, C1011.2, C1012.2, C1013.2, C1014.2, C1015.2, C1016.2, R1001.2, U7.A3 (GND_A), U7.B3 (GND_A), U7.B4 (GND_A), U7.C1 (VSS), U7.C2 (VSS), U7.C3 (VSS), U7.D2 (I2C_EN), U7.D5 (GND_D), U7.F1 (GND_DR2), U7.F4 (GND_DR1), U1001.3 (GND), U1001.7 (EP_GND), X1001.2 (CASE), X1001.4 (CASE); also elsewhere on the board
NFC_3V3: C1001.1, C1002.1, C1003.1, C1004.1, R1002.2, U7.A6 (VDD_IO), U7.E5 (VDD_TX), U7.E6 (VDD), U1001.1 (OUT); also elsewhere on the board
NFC_AGDC: C1012.1, C1013.1, U7.A2 (AGDC)
NFC_CS_N: R1002.1, U7.A5 (BSS); also elsewhere on the board
NFC_IRQ: U7.A4 (IRQ); also elsewhere on the board
NFC_MISO: U7.B5 (MISO); also elsewhere on the board
NFC_MOSI: U7.D4 (MOSI); also elsewhere on the board
NFC_POWER_EN: R1001.1, U1001.4 (EN); also elsewhere on the board
NFC_RFI1: U7.B1 (RFI1); also elsewhere on the board
NFC_RFI2: U7.B2 (RFI2); also elsewhere on the board
NFC_RFO1: U7.F3 (RFO1); also elsewhere on the board
NFC_RFO2: U7.F2 (RFO2); also elsewhere on the board
NFC_RF_DR: C1005.1, C1006.1, U7.E3 (VDD_DR), U7.F6 (VDD_RF)
NFC_SCK: U7.D3 (SCLK); also elsewhere on the board
NFC_VDD_A: C1009.1, C1010.1, U7.E4 (VDD_A)
NFC_VDD_AM: C1011.1, U7.F5 (VDD_AM)
NFC_VDD_D: C1007.1, C1008.1, U7.C5 (VDD_D)
NFC_XTI: C1014.1, U7.D6 (XTI), X1001.1 (XI)
NFC_XTO: C1015.1, U7.C6 (XTO), X1001.3 (XO)
VSYS: C1016.1, U1001.6 (IN); also elsewhere on the board

Notes on the sheet:
ST25R3916B-BWLT retains Safe7 core part. Supplies/decoupling and crystal follow pinned TS7 sheet10 and ST DS13541.
Dedicated VSYS LDO avoids overloading the MCU 200mA buck. Default power off and signal bridge disabled.
No NFC use during calls or charging tests until RF/thermal/current limits and trusted local pairing are defined.
IRQ is active HIGH. TAD/clock/automatic-tuning outputs unused. Fixed matching network is on the following sheet.
NFC transport alone does not authenticate a contact; device signatures/pinned contacts and local confirmation remain mandatory.
