adlererik/voicevault/hardware/rev-b/voicevault-standalone-b0.kicad_pcb

## KiCad design hardware/rev-b/voicevault-standalone-b0.kicad_pcb (continued)

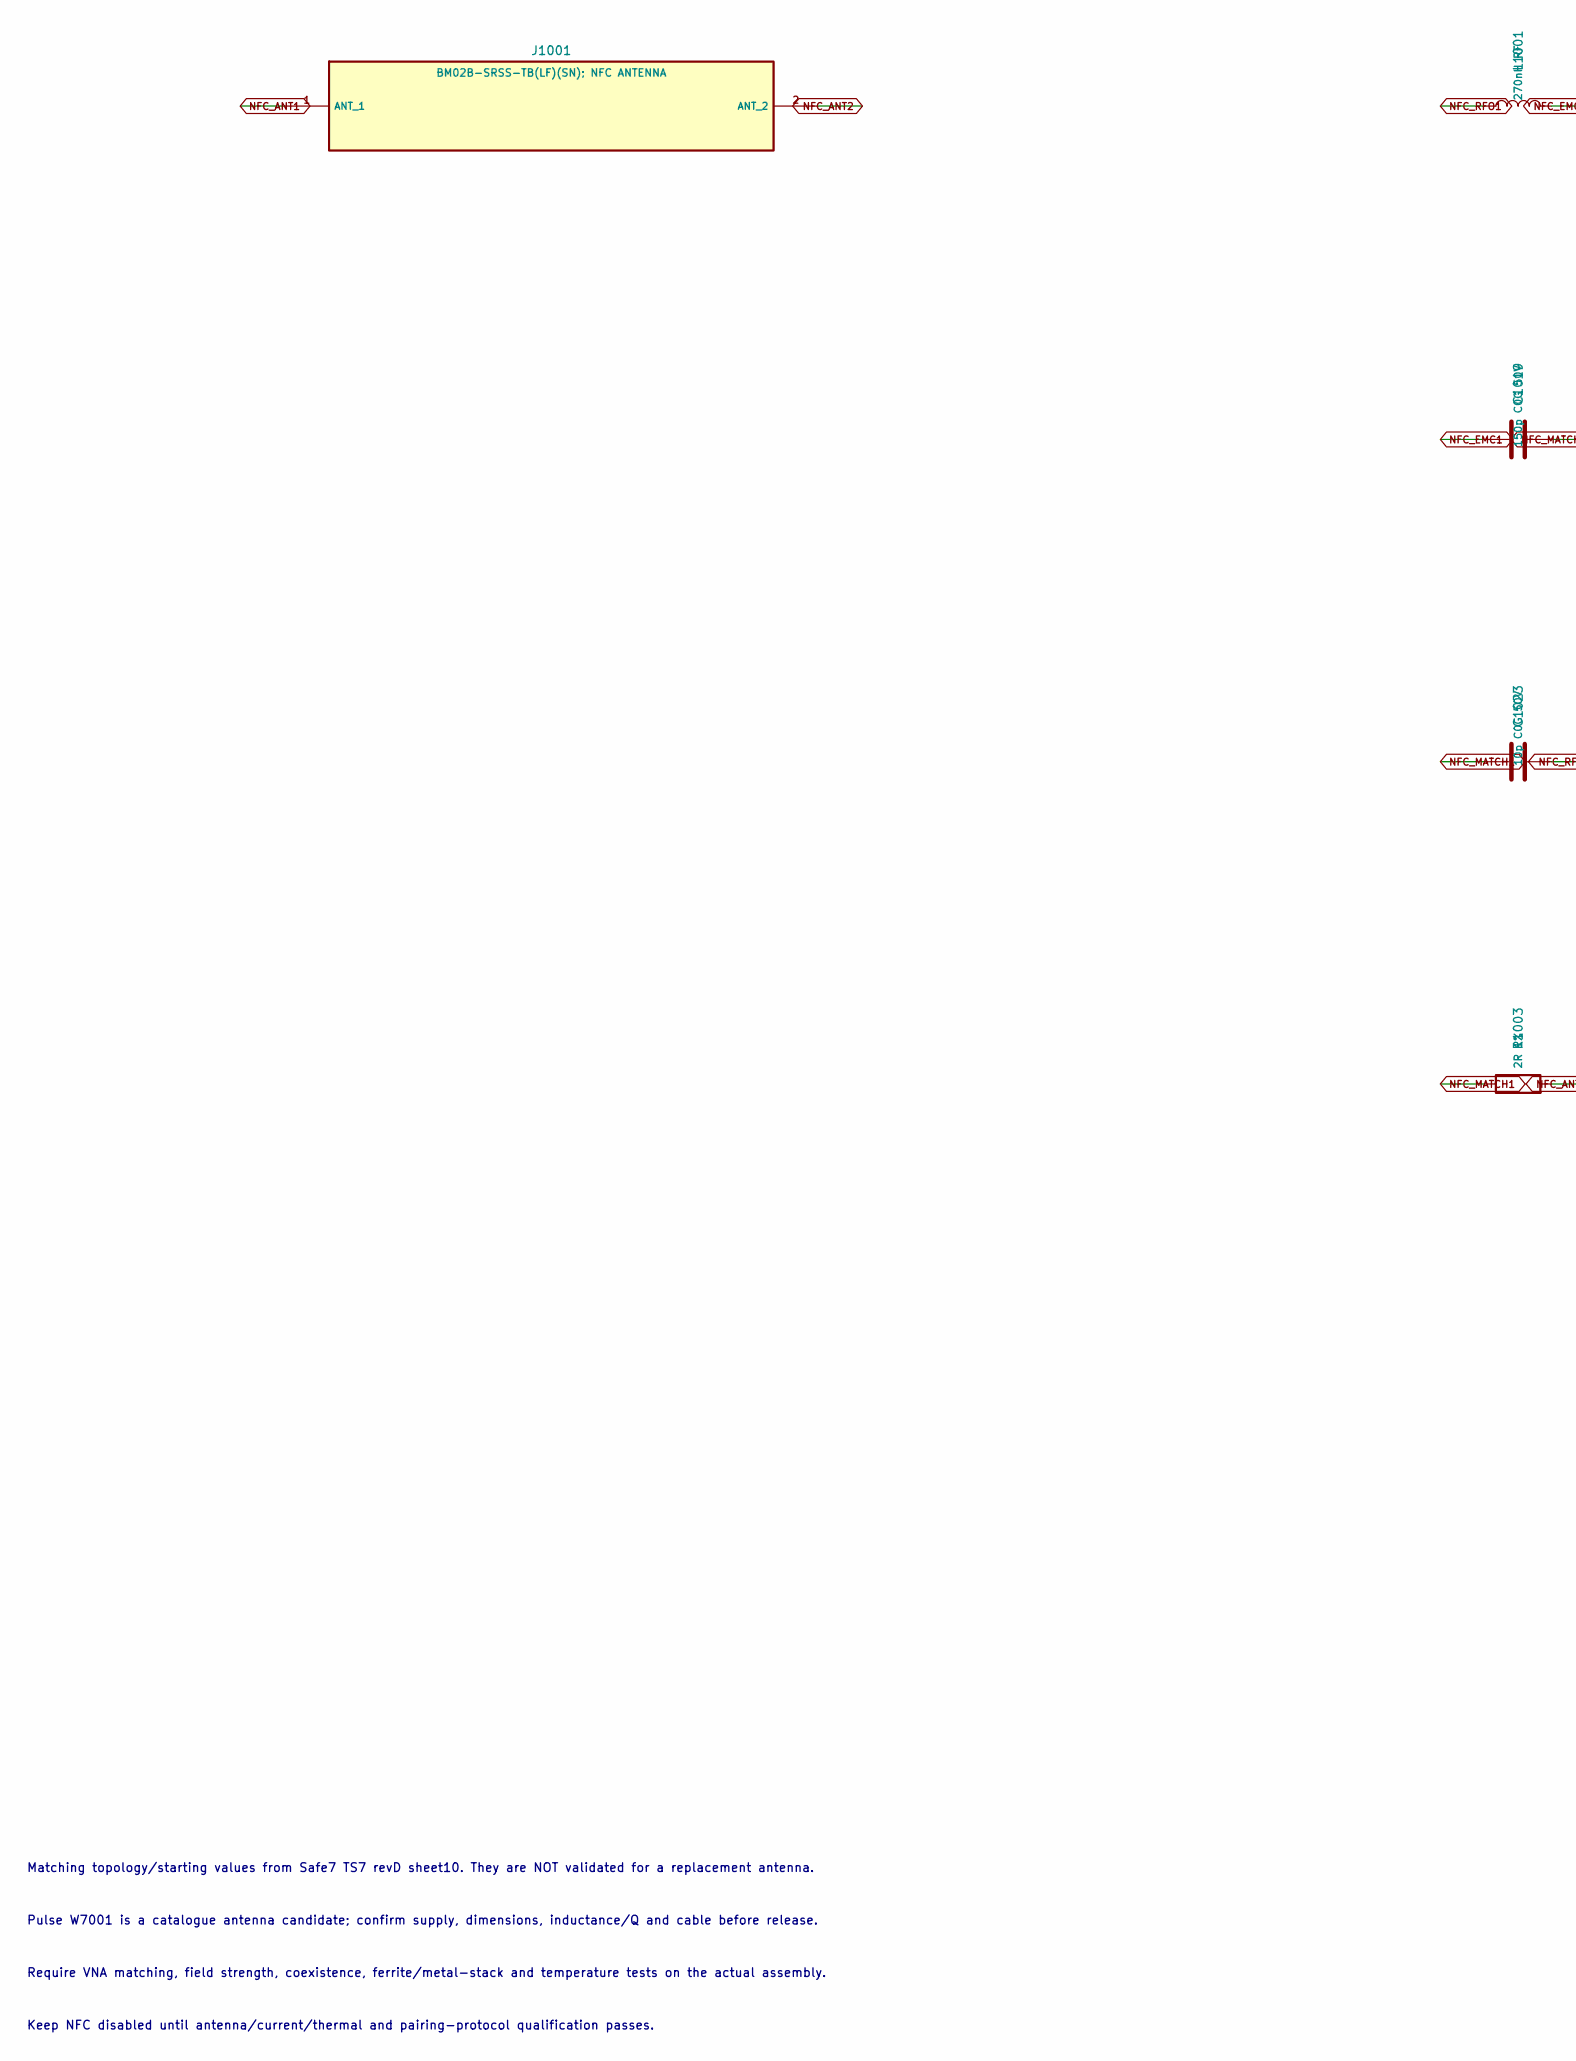
[picture p66: schematic circuit-nfc-matching.kicad_sch, Differential NFC matching and antenna interface, part in row 1, column 1]

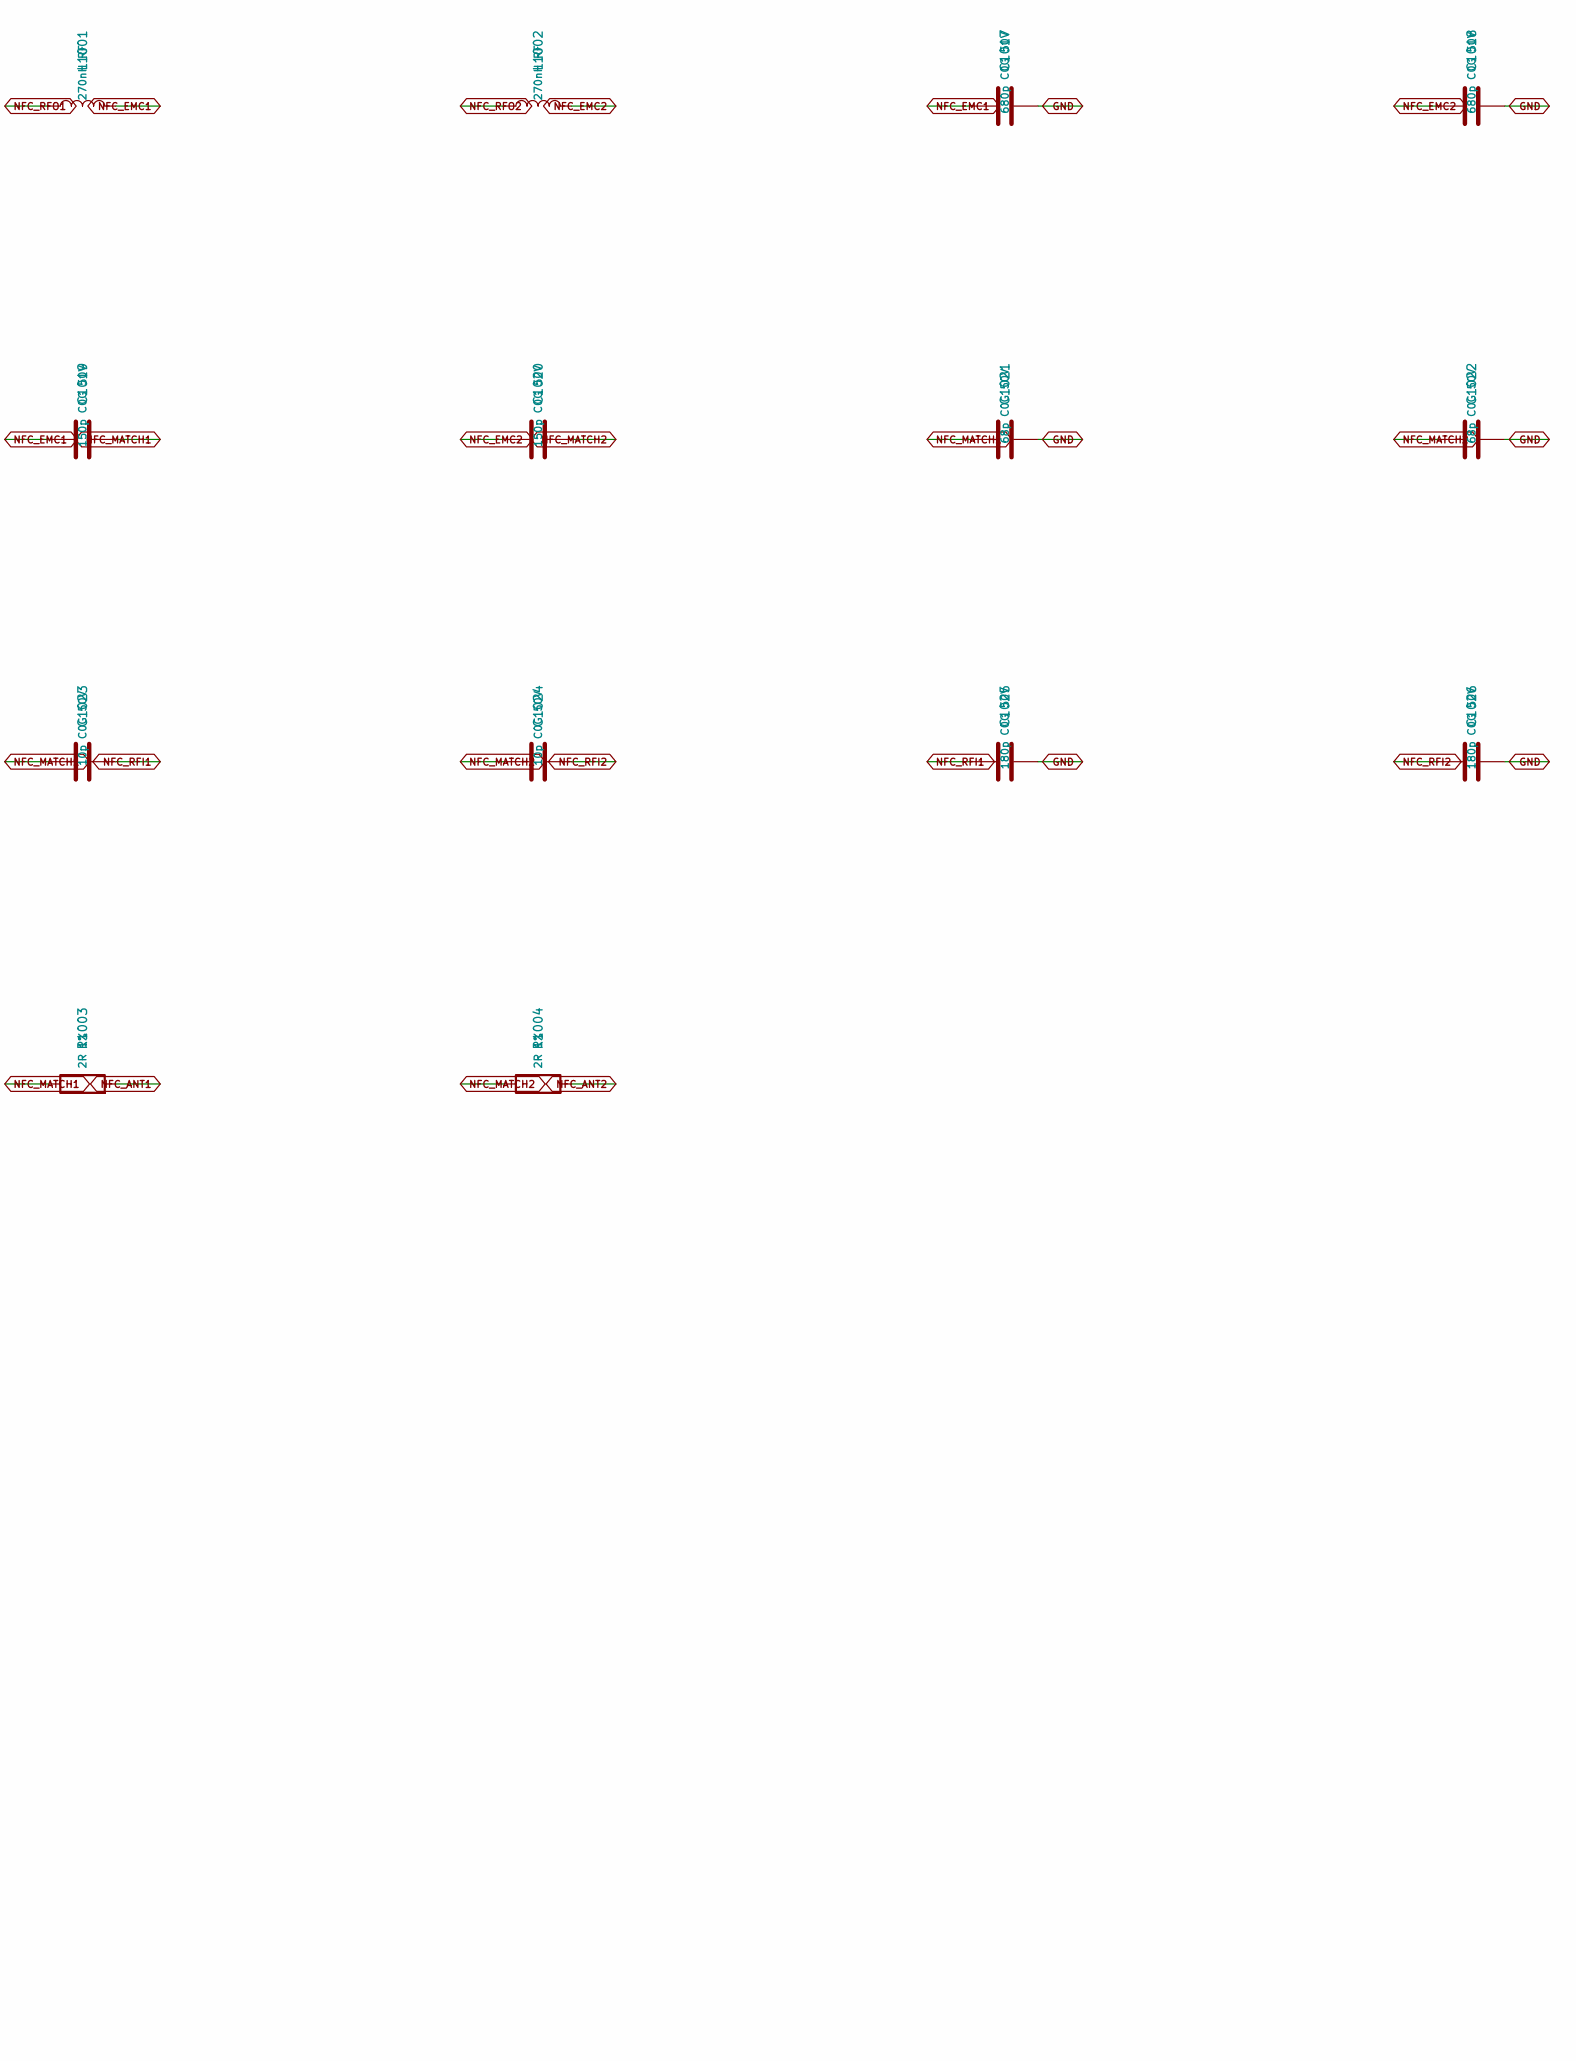
[picture p67: schematic circuit-nfc-matching.kicad_sch, Differential NFC matching and antenna interface, part in row 1, column 2]

Parts:
C1017, C1018: 680p C0G 50V; C_0402_1005Metric
C1019, C1020: 150p C0G 50V; C_0402_1005Metric
C1021, C1022: 68p C0G 50V; C_0402_1005Metric
C1023, C1024: 10p C0G 50V; C_0402_1005Metric
C1025, C1026: 180p C0G 50V; C_0402_1005Metric
J1001: BM02B-SRSS-TB(LF)(SN); NFC ANTENNA; JST_SH_BM02B-SRSS-TB_1x02-1MP_P1.00mm_Vertical
L1001, L1002: 270nH RF; L_0603_1608Metric
R1003, R1004: 2R 1%; R_0402_1005Metric

Connections:
GND: C1017.2, C1018.2, C1021.2, C1022.2, C1025.2, C1026.2; also elsewhere on the board
NFC_ANT1: J1001.1 (ANT_1), R1003.2
NFC_ANT2: J1001.2 (ANT_2), R1004.2
NFC_EMC1: C1017.1, C1019.1, L1001.2
NFC_EMC2: C1018.1, C1020.1, L1002.2
NFC_MATCH1: C1019.2, C1021.1, C1023.1, R1003.1
NFC_MATCH2: C1020.2, C1022.1, C1024.1, R1004.1
NFC_RFI1: C1023.2, C1025.1; also elsewhere on the board
NFC_RFI2: C1024.2, C1026.1; also elsewhere on the board
NFC_RFO1: L1001.1; also elsewhere on the board
NFC_RFO2: L1002.1; also elsewhere on the board

Notes on the sheet:
Matching topology/starting values from Safe7 TS7 revD sheet10. They are NOT validated for a replacement antenna.
Pulse W7001 is a catalogue antenna candidate; confirm supply, dimensions, inductance/Q and cable before release.
Require VNA matching, field strength, coexistence, ferrite/metal-stack and temperature tests on the actual assembly.
Keep NFC disabled until antenna/current/thermal and pairing-protocol qualification passes.

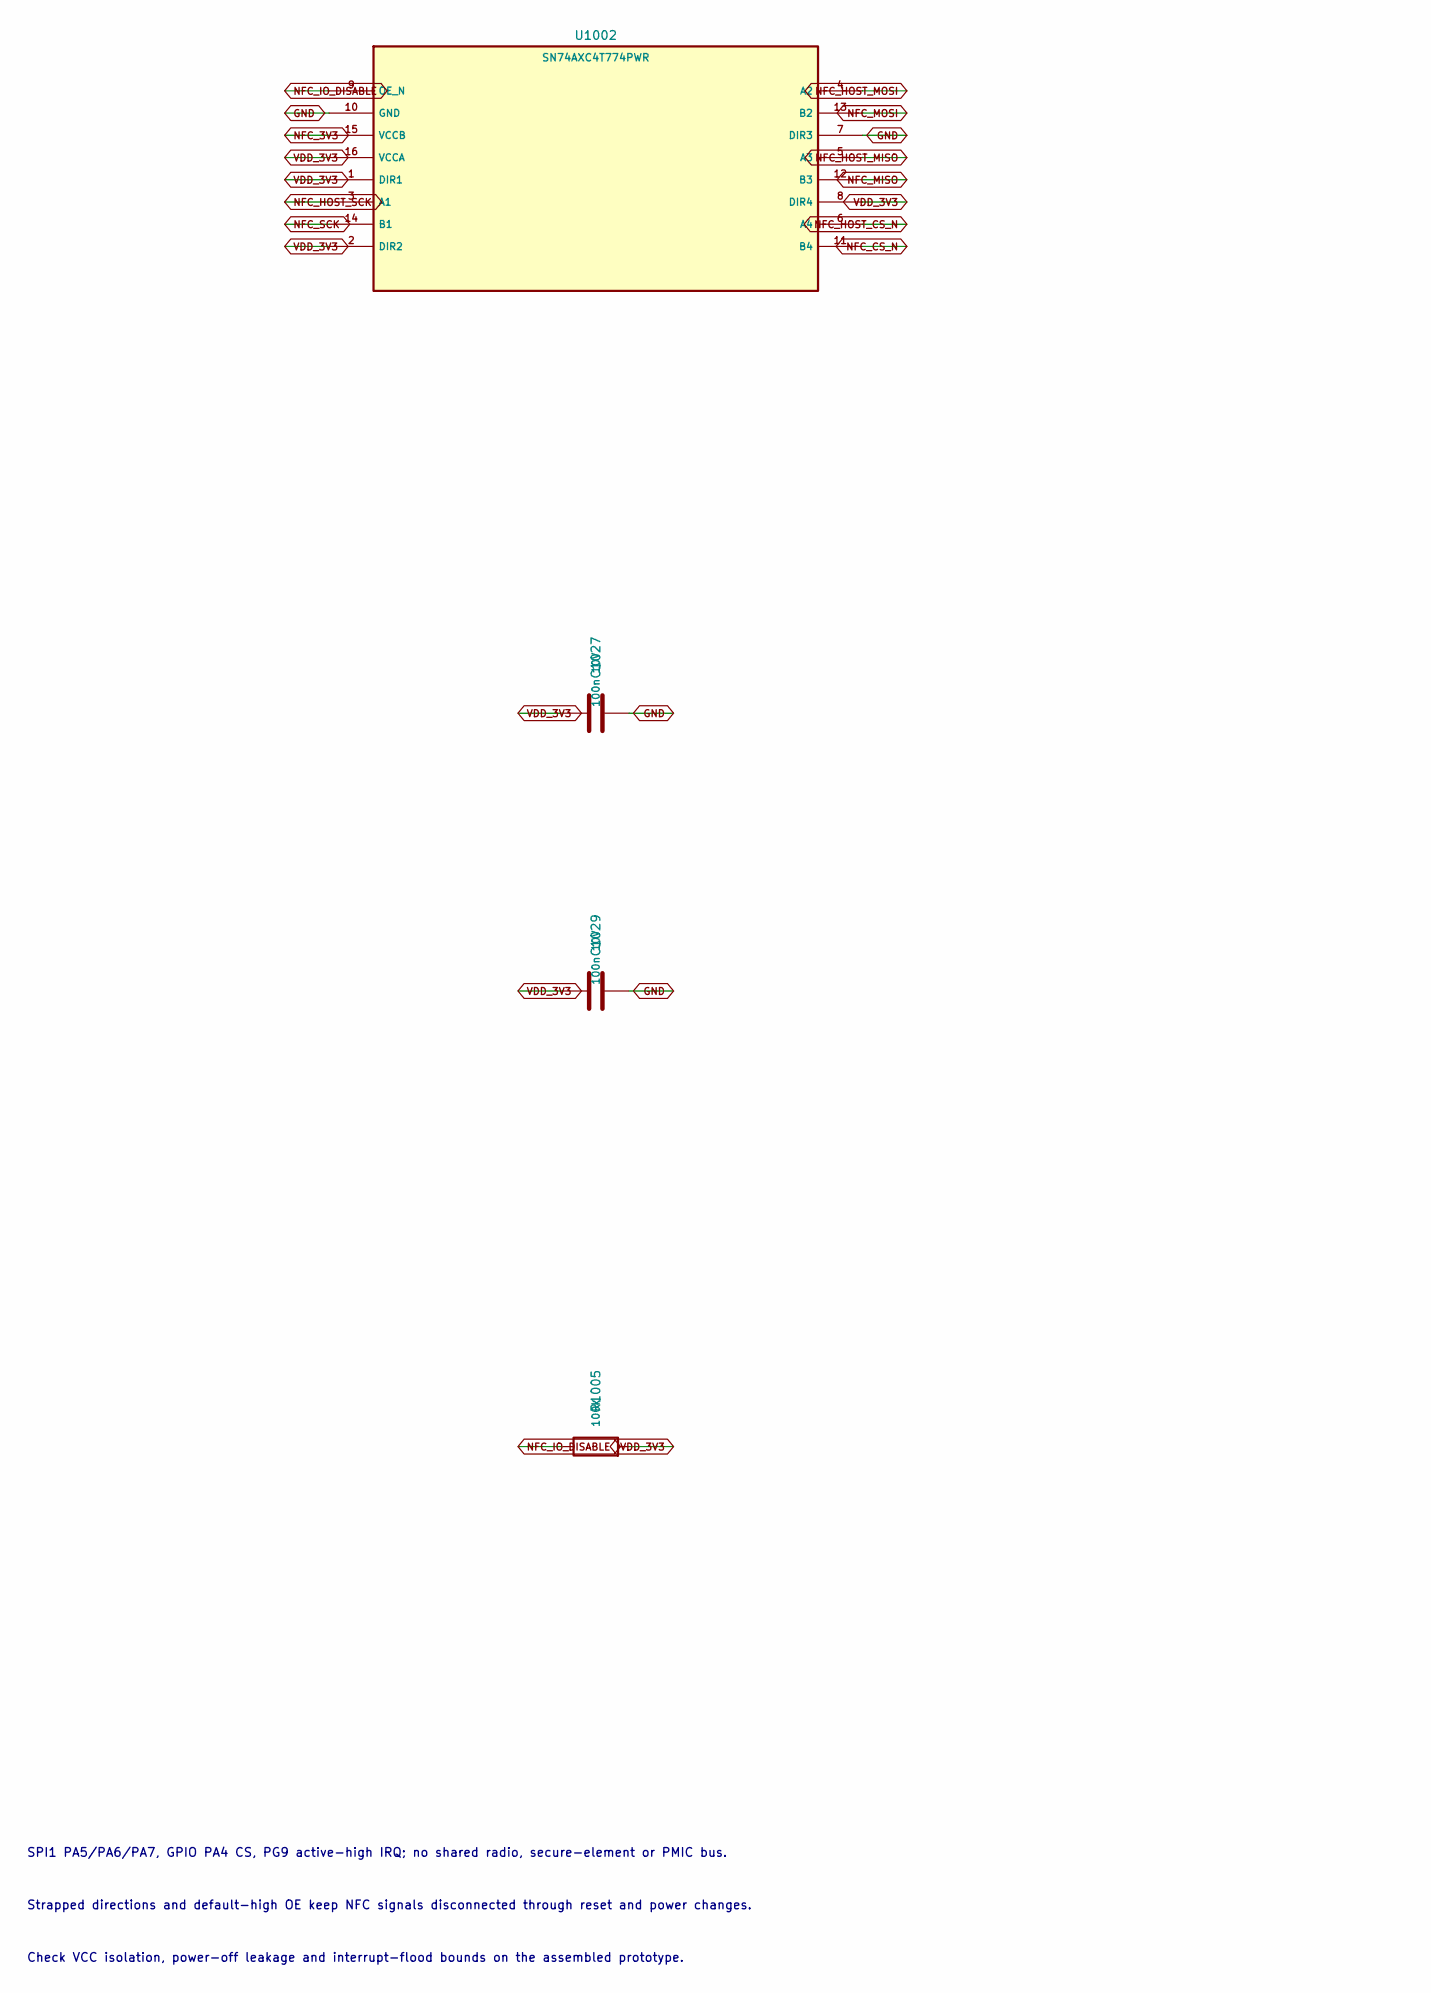
[picture p68: schematic circuit-nfc-interface.kicad_sch, Default-disabled NFC signal boundary, part in row 1, column 1]

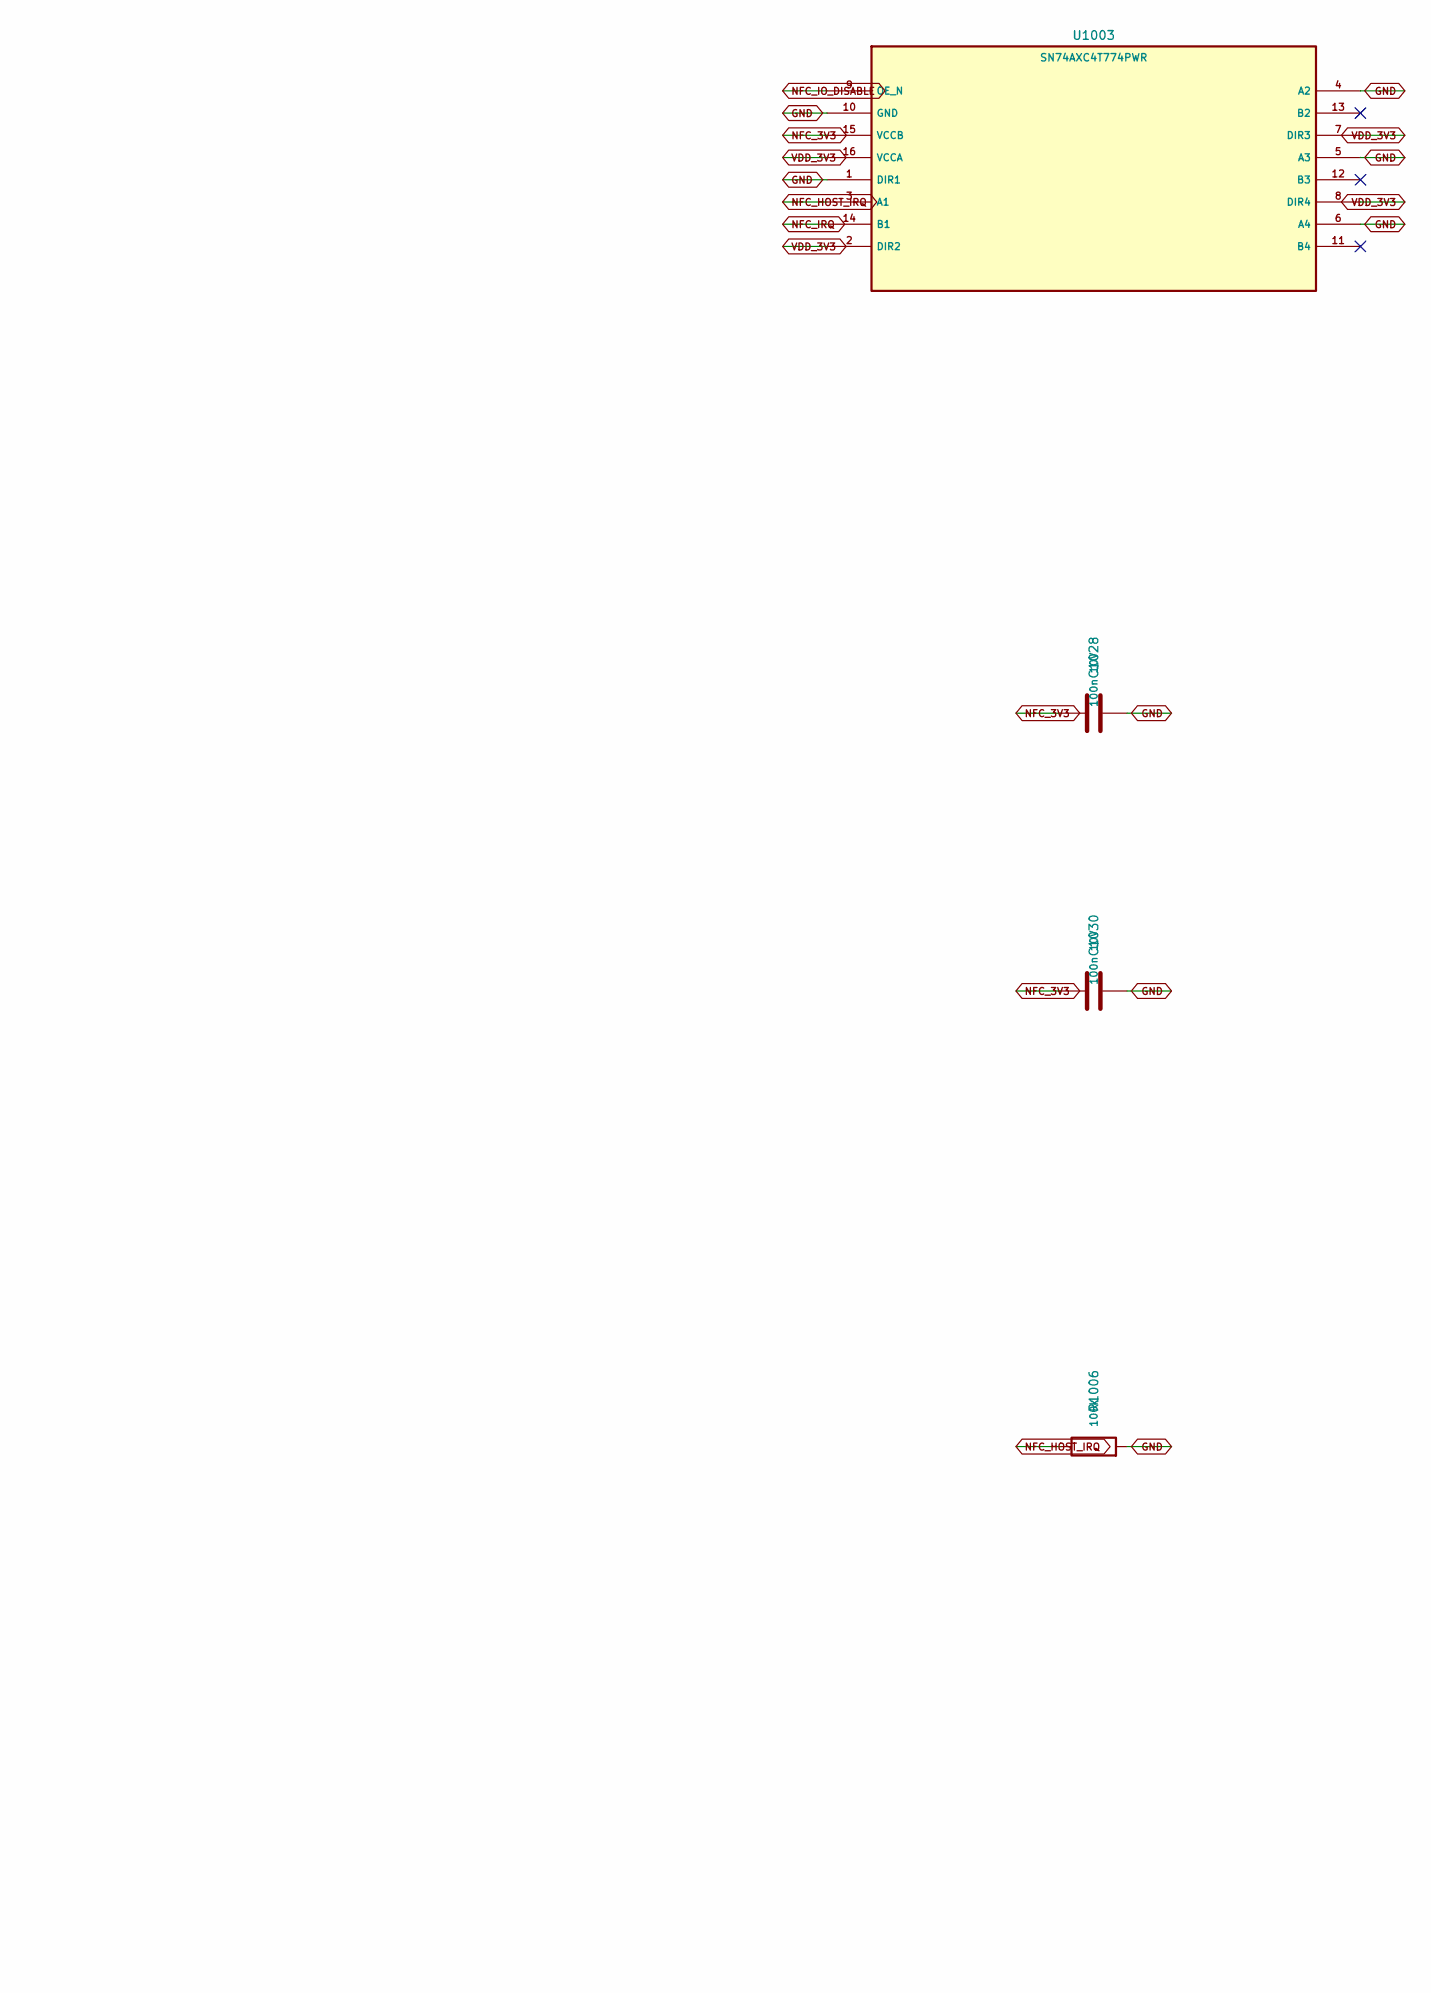
[picture p69: schematic circuit-nfc-interface.kicad_sch, Default-disabled NFC signal boundary, part in row 1, column 2]

Parts:
C1027, C1028, C1029, C1030: 100n 10V; C_0402_1005Metric
R1005, R1006: 100k; R_0402_1005Metric
U1002, U1003: SN74AXC4T774PWR; TSSOP-16_4.4x5mm_P0.65mm

Connections:
GND: C1027.2, C1028.2, C1029.2, C1030.2, R1006.2, U1002.7 (DIR3), U1002.10 (GND), U1003.1 (DIR1), U1003.4 (A2), U1003.5 (A3), U1003.6 (A4), U1003.10 (GND); also elsewhere on the board
NFC_3V3: C1028.1, C1030.1, U1002.15 (VCCB), U1003.15 (VCCB); also elsewhere on the board
NFC_CS_N: U1002.11 (B4); also elsewhere on the board
NFC_HOST_CS_N: U1002.6 (A4); also elsewhere on the board
NFC_HOST_IRQ: R1006.1, U1003.3 (A1); also elsewhere on the board
NFC_HOST_MISO: U1002.5 (A3); also elsewhere on the board
NFC_HOST_MOSI: U1002.4 (A2); also elsewhere on the board
NFC_HOST_SCK: U1002.3 (A1); also elsewhere on the board
NFC_IO_DISABLE: R1005.1, U1002.9 (OE_N), U1003.9 (OE_N); also elsewhere on the board
NFC_IRQ: U1003.14 (B1); also elsewhere on the board
NFC_MISO: U1002.12 (B3); also elsewhere on the board
NFC_MOSI: U1002.13 (B2); also elsewhere on the board
NFC_SCK: U1002.14 (B1); also elsewhere on the board
VDD_3V3: C1027.1, C1029.1, R1005.2, U1002.1 (DIR1), U1002.2 (DIR2), U1002.8 (DIR4), U1002.16 (VCCA), U1003.2 (DIR2), U1003.7 (DIR3), U1003.8 (DIR4), U1003.16 (VCCA); also elsewhere on the board

Notes on the sheet:
SPI1 PA5/PA6/PA7, GPIO PA4 CS, PG9 active-high IRQ; no shared radio, secure-element or PMIC bus.
Strapped directions and default-high OE keep NFC signals disconnected through reset and power changes.
Check VCC isolation, power-off leakage and interrupt-flood bounds on the assembled prototype.

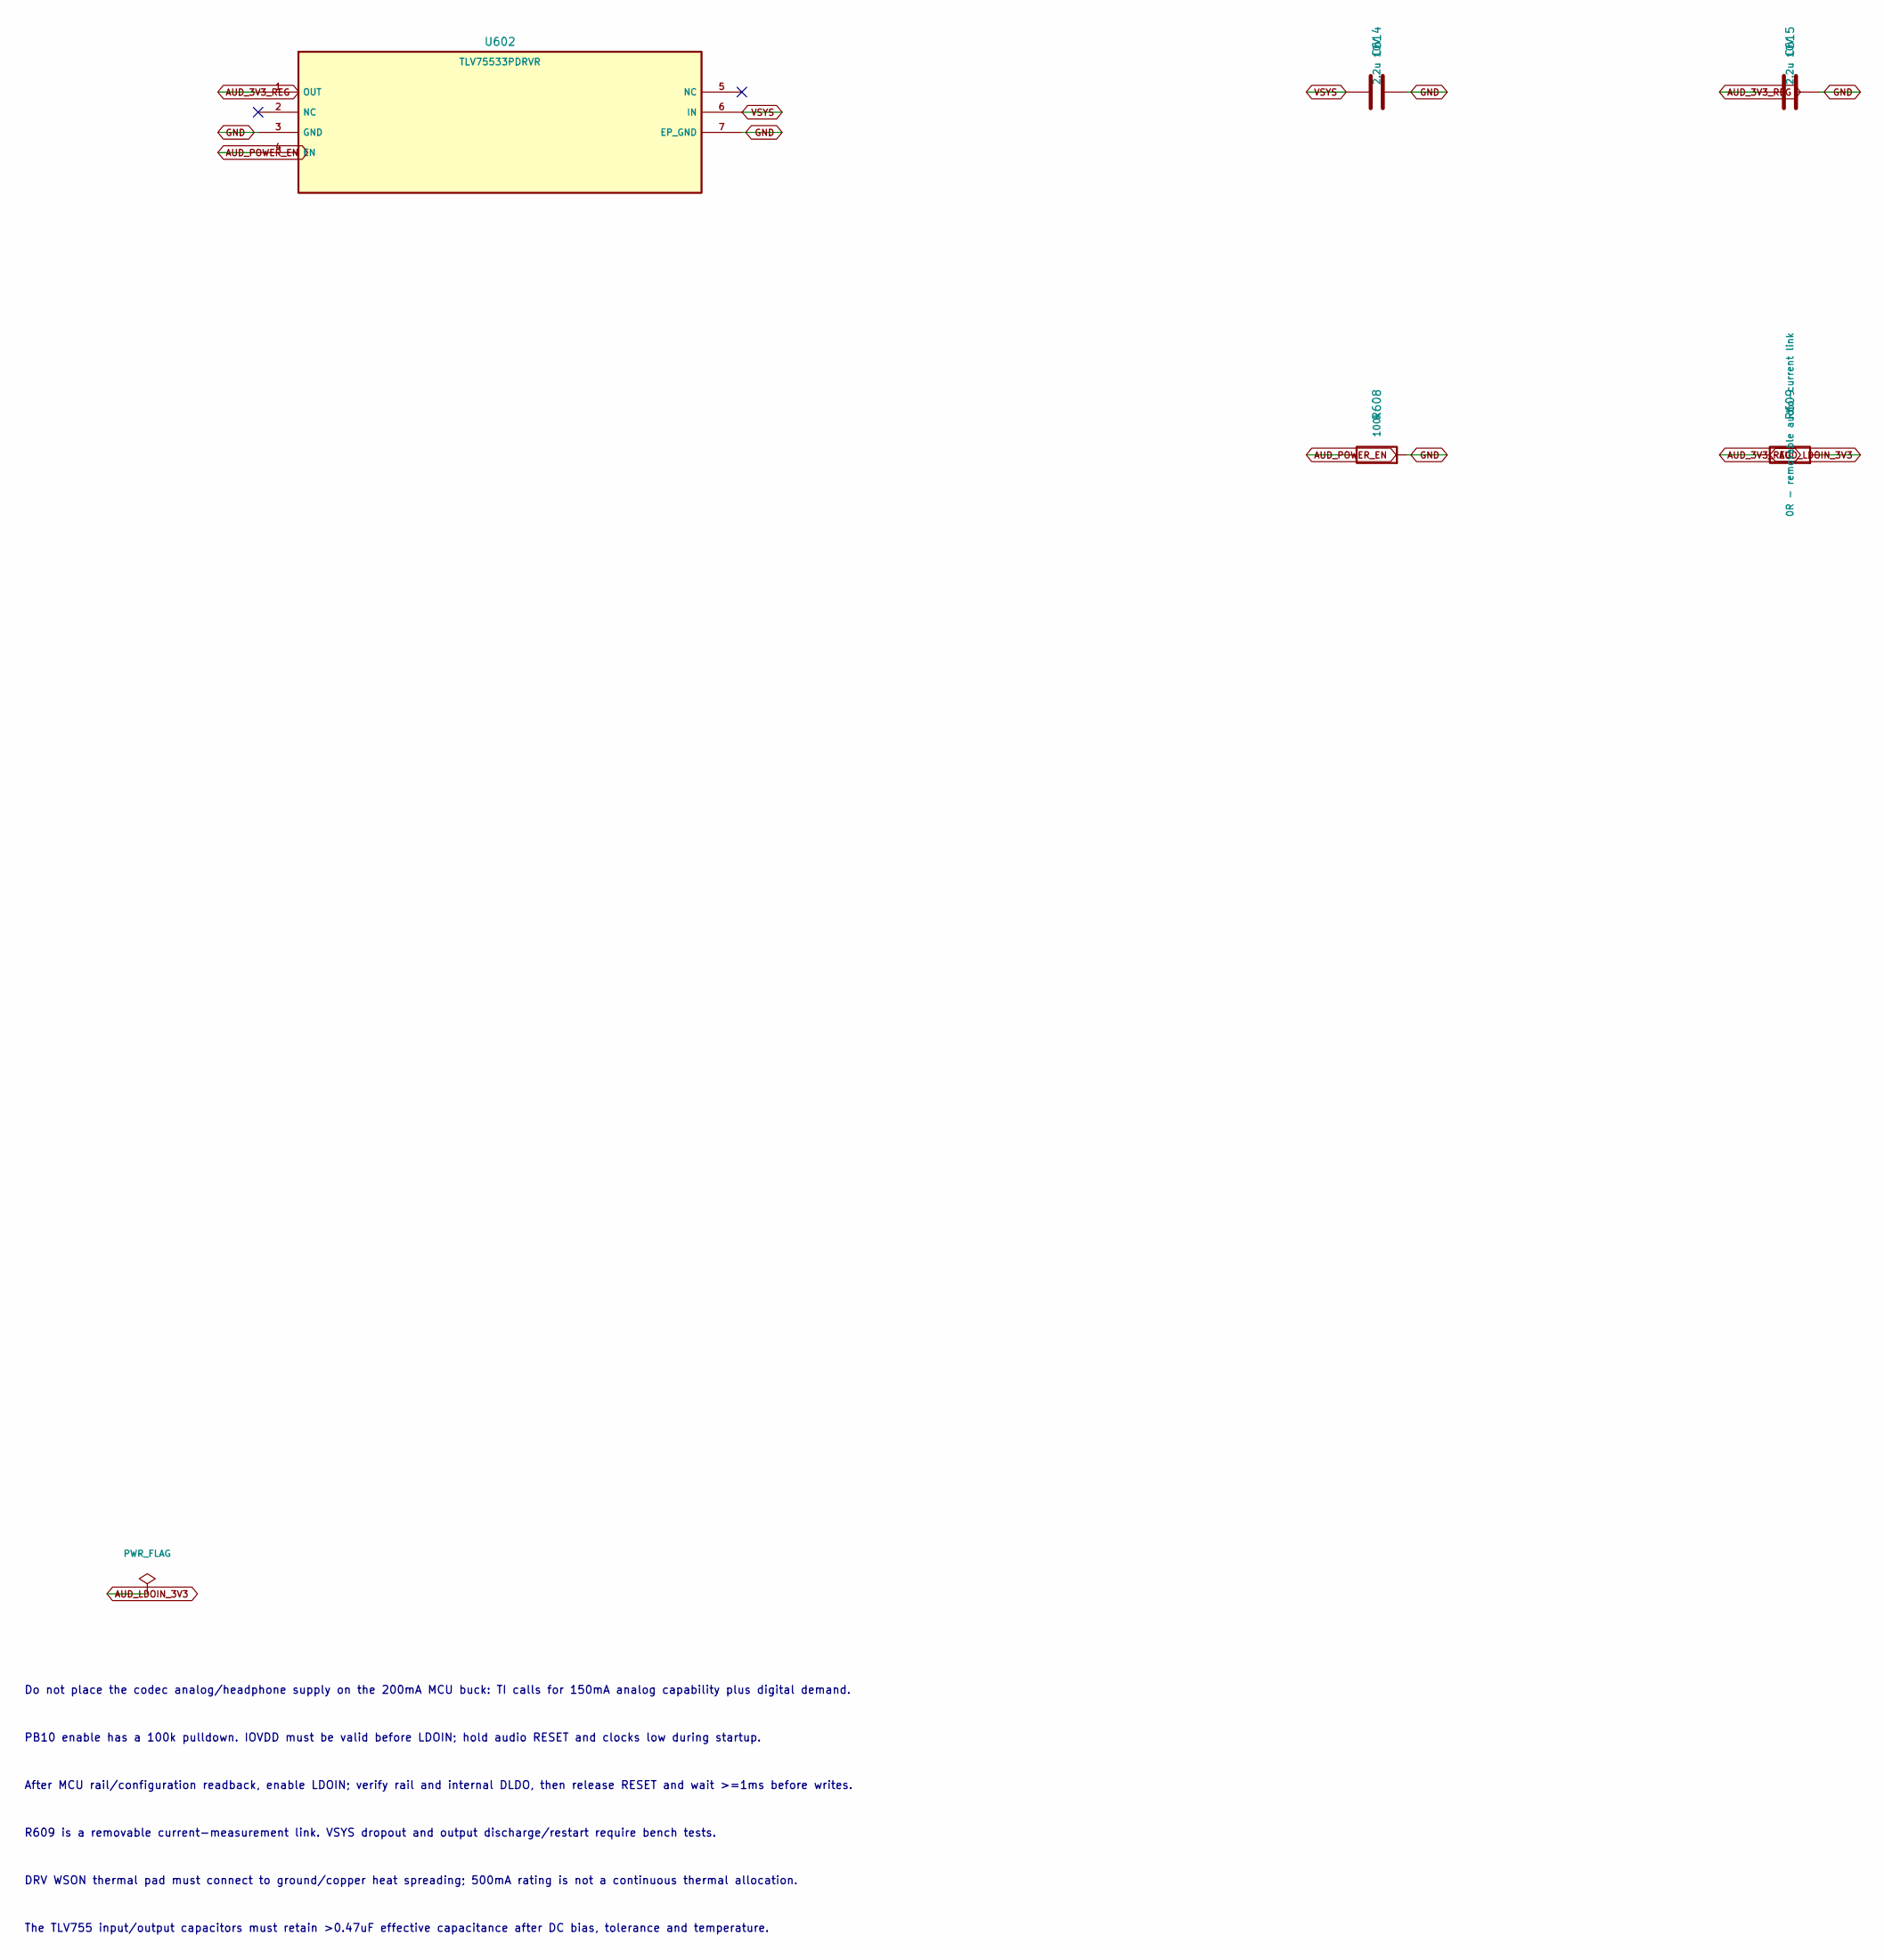
[picture p70: schematic circuit-audio-power.kicad_sch, Dedicated switched audio supply]

Parts:
C614, C615: 2.2u 10V; C_0603_1608Metric
R608: 100k; R_0402_1005Metric
R609: 0R - removable audio-current link; R_0603_1608Metric
U602: TLV75533PDRVR; TI_DRV0006A_WSON6_2x2_EP1x1p6

Connections:
AUD_3V3_REG: C615.1, R609.1, U602.1 (OUT)
AUD_LDOIN_3V3: R609.2; also elsewhere on the board
AUD_POWER_EN: R608.1, U602.4 (EN); also elsewhere on the board
GND: C614.2, C615.2, R608.2, U602.3 (GND), U602.7 (EP_GND); also elsewhere on the board
VSYS: C614.1, U602.6 (IN); also elsewhere on the board

Notes on the sheet:
Do not place the codec analog/headphone supply on the 200mA MCU buck: TI calls for 150mA analog capability plus digital demand.
PB10 enable has a 100k pulldown. IOVDD must be valid before LDOIN; hold audio RESET and clocks low during startup.
After MCU rail/configuration readback, enable LDOIN; verify rail and internal DLDO, then release RESET and wait >=1ms before writes.
R609 is a removable current-measurement link. VSYS dropout and output discharge/restart require bench tests.
DRV WSON thermal pad must connect to ground/copper heat spreading; 500mA rating is not a continuous thermal allocation.
The TLV755 input/output capacitors must retain >0.47uF effective capacitance after DC bias, tolerance and temperature.

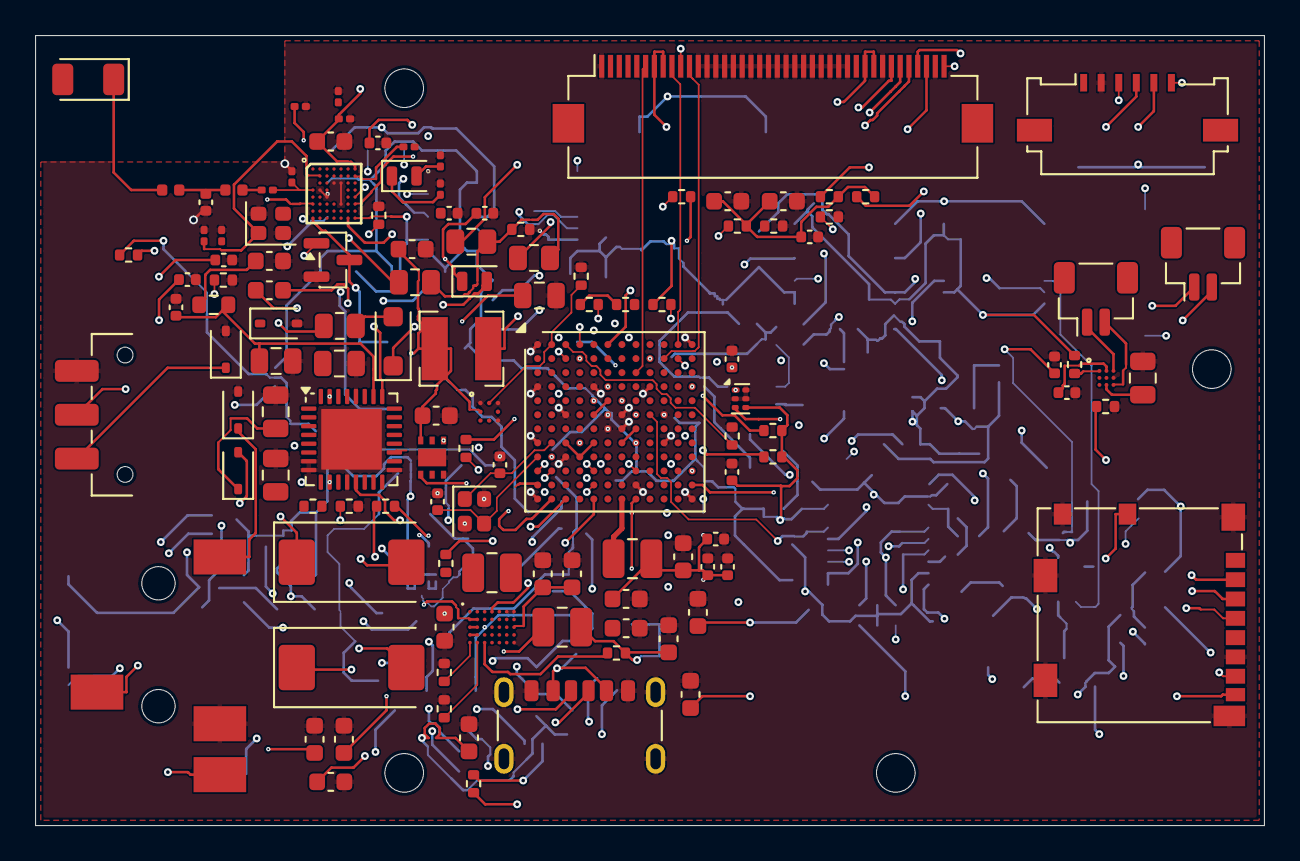
[picture p71: board voicevault-standalone-b0.kicad_pcb from above]

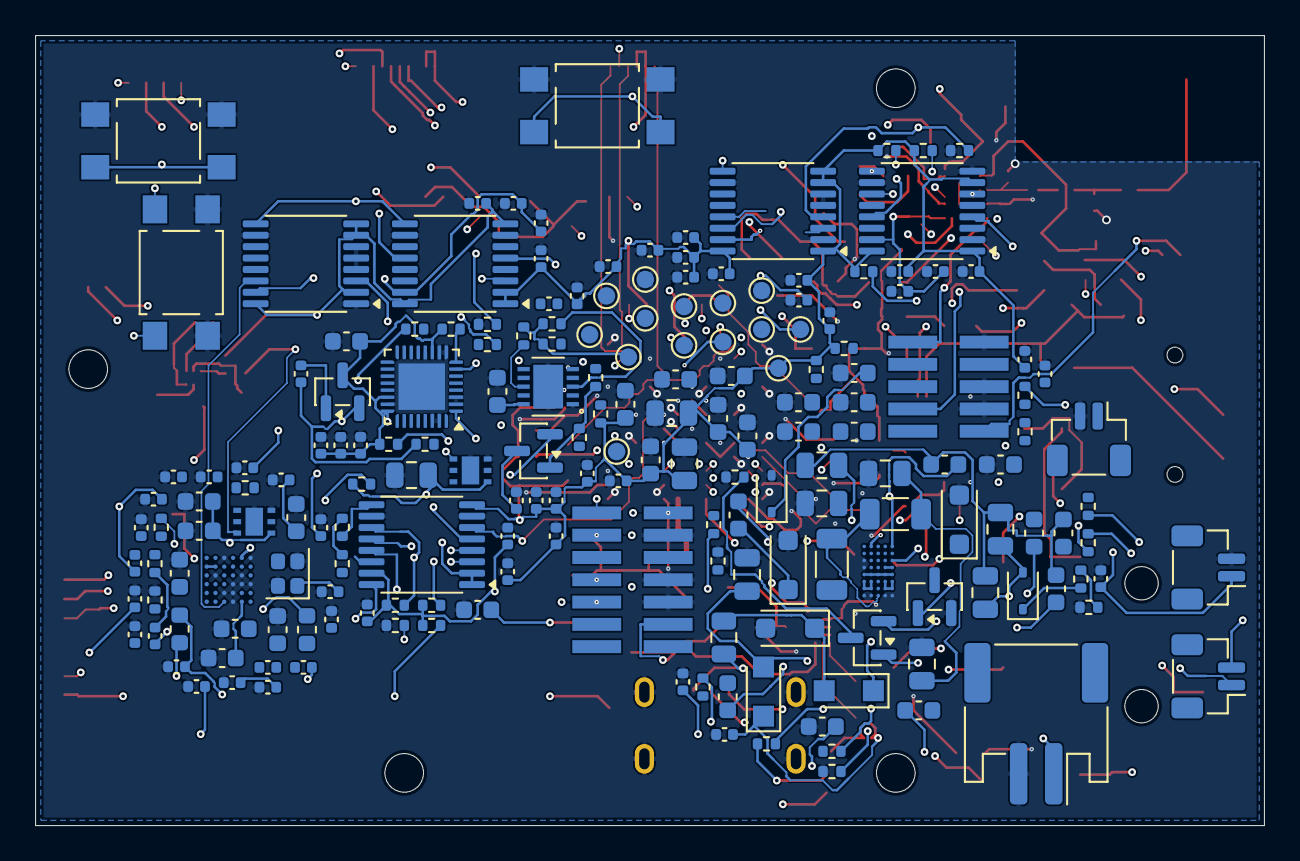
[picture p72: board voicevault-standalone-b0.kicad_pcb from below]

Board: 6 copper layers, 70.0 x 45.0 mm, 314 parts (189 on the bottom side), 199 nets.

Other parts of the board:
H1, H2, H3, H4: M2 mounting hole / not an assembled component; MountingHole_2.2mm_M2
TP1: PROBE VSYS; TestPoint_Pad_D1.0mm
TP2, TP14: PROBE GND; TestPoint_Pad_D1.0mm
TP3: PROBE VDD_3V3; TestPoint_Pad_D1.0mm
TP4: PROBE AUX_3V3; TestPoint_Pad_D1.0mm
TP5: PROBE MCU_VDD11; TestPoint_Pad_D1.0mm
TP6: PROBE RADIO_3V3; TestPoint_Pad_D1.0mm
TP7: PROBE TR_3V3; TestPoint_Pad_D1.0mm
TP8: PROBE OP_3V3; TestPoint_Pad_D1.0mm
TP9: PROBE SD_3V3; TestPoint_Pad_D1.0mm
TP10: PROBE NFC_3V3; TestPoint_Pad_D1.0mm
TP11: PROBE AUD_LDOIN_3V3; TestPoint_Pad_D1.0mm
TP12: PROBE QI_5V; TestPoint_Pad_D1.0mm
TP13: PROBE BAT_PACK; TestPoint_Pad_D1.0mm

Their connections:
AUD_LDOIN_3V3: TP11.1; also elsewhere on the board
AUX_3V3: TP4.1; also elsewhere on the board
BAT_PACK: TP13.1; also elsewhere on the board
GND: TP2.1, TP14.1; also elsewhere on the board
MCU_VDD11: TP5.1; also elsewhere on the board
NFC_3V3: TP10.1; also elsewhere on the board
OP_3V3: TP8.1; also elsewhere on the board
QI_5V: TP12.1; also elsewhere on the board
RADIO_3V3: TP6.1; also elsewhere on the board
SD_3V3: TP9.1; also elsewhere on the board
TR_3V3: TP7.1; also elsewhere on the board
VDD_3V3: TP3.1; also elsewhere on the board
VSYS: TP1.1; also elsewhere on the board
