adlererik/voicevault/hardware/rev-a/voicevault-reva.kicad_pcb

## KiCad design hardware/rev-a/voicevault-reva.kicad_pcb (2026-11-12, an earlier design)

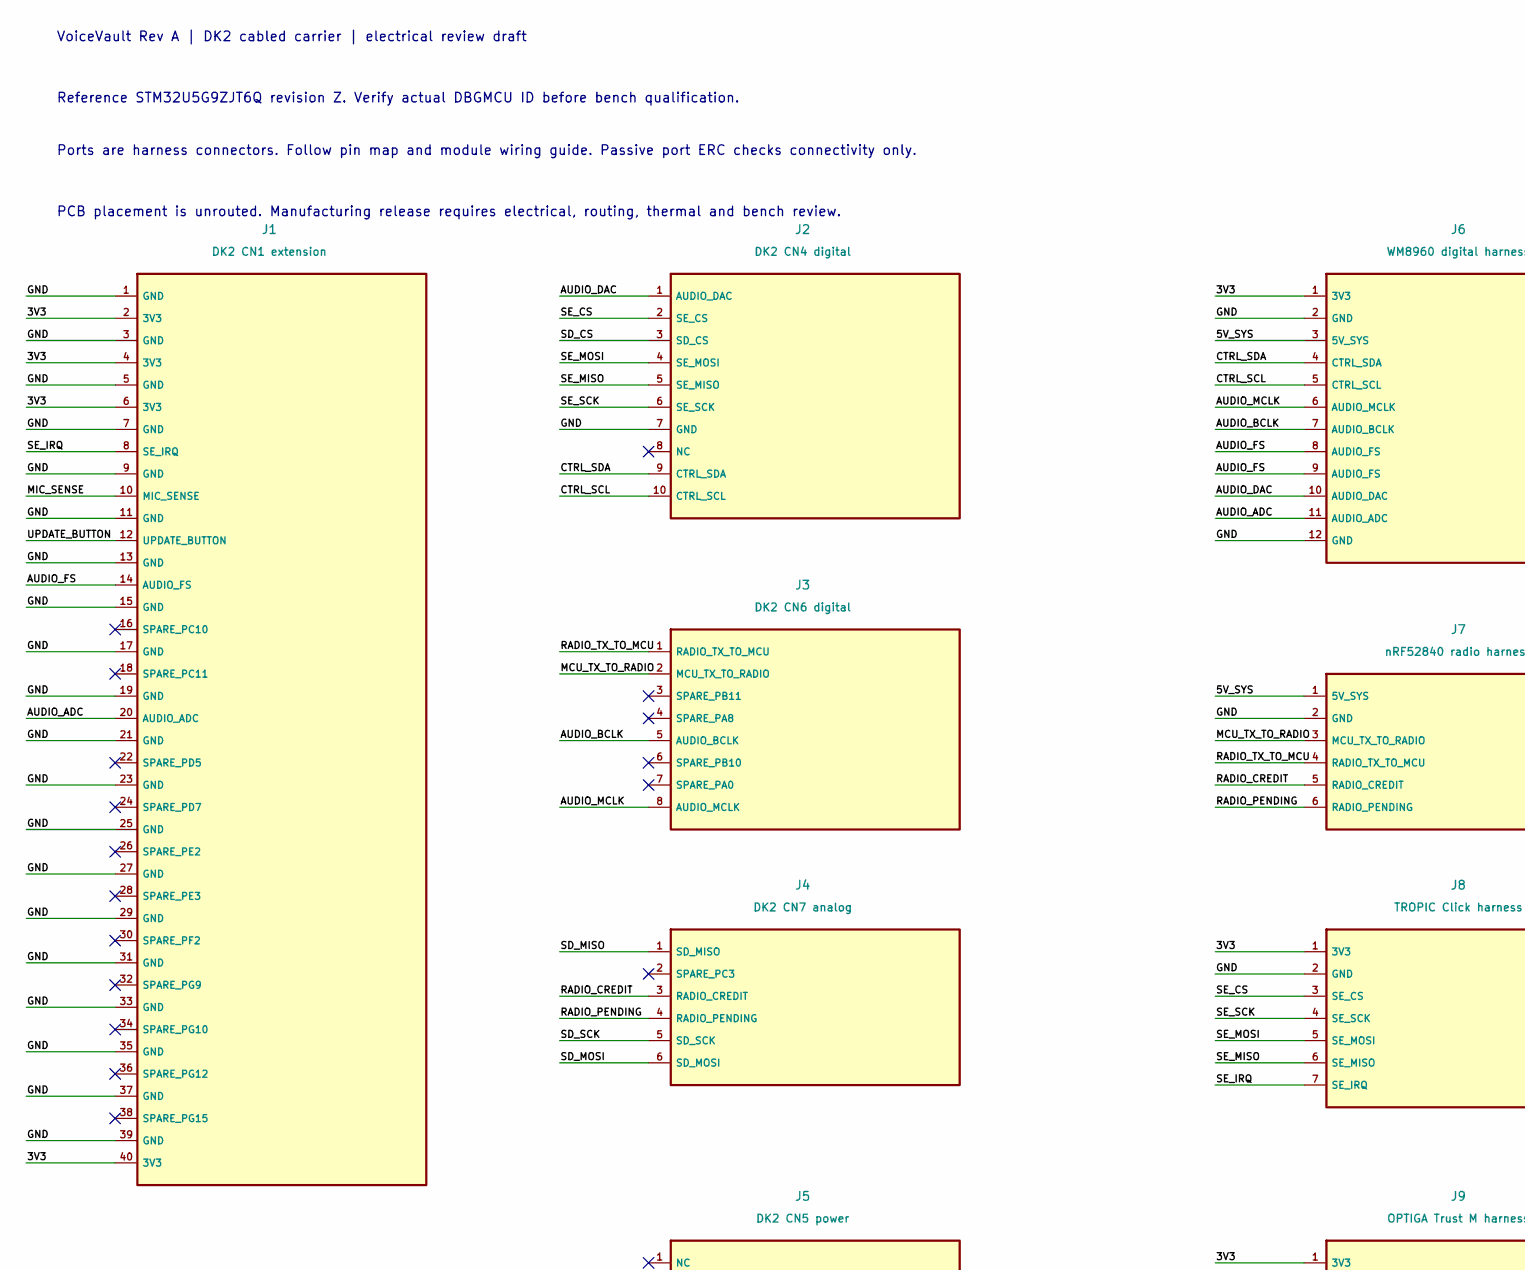
[picture p73: schematic voicevault-reva.kicad_sch, VoiceVault Rev A serviceable carrier, part in row 1, column 1]

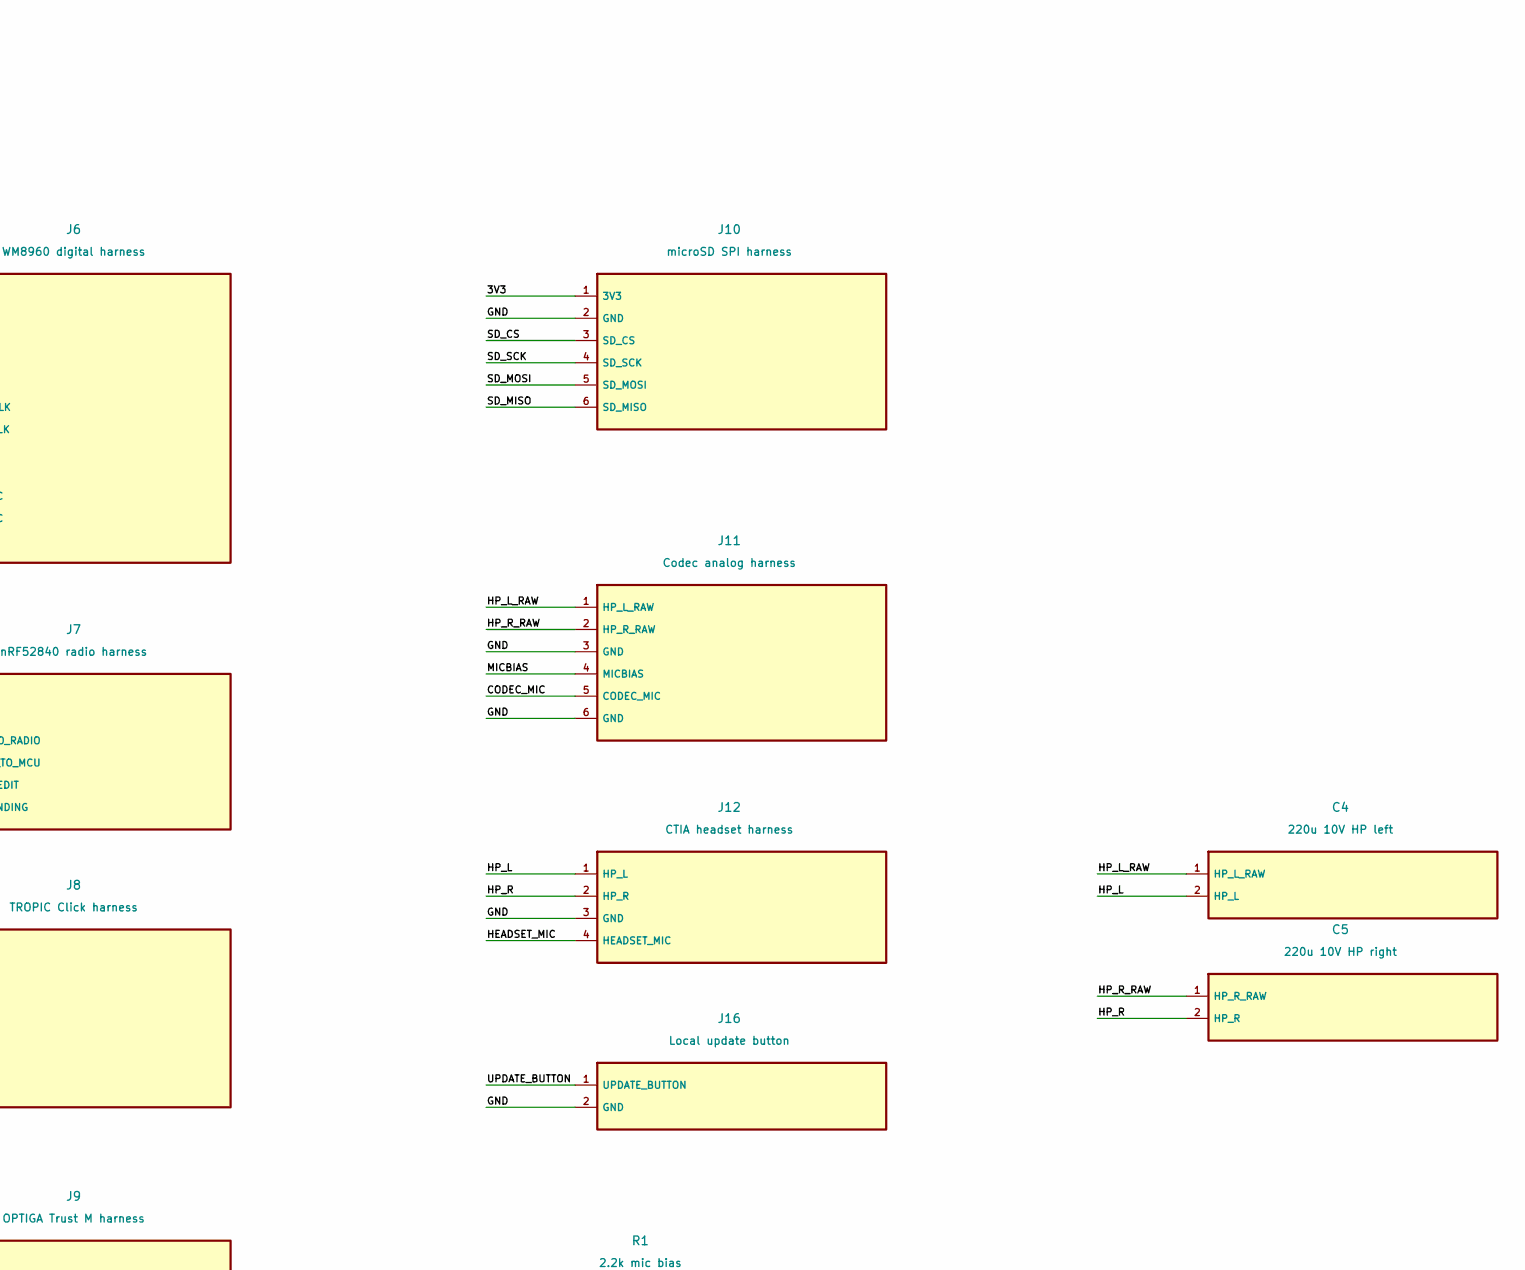
[picture p74: schematic voicevault-reva.kicad_sch, VoiceVault Rev A serviceable carrier, part in row 1, column 2]

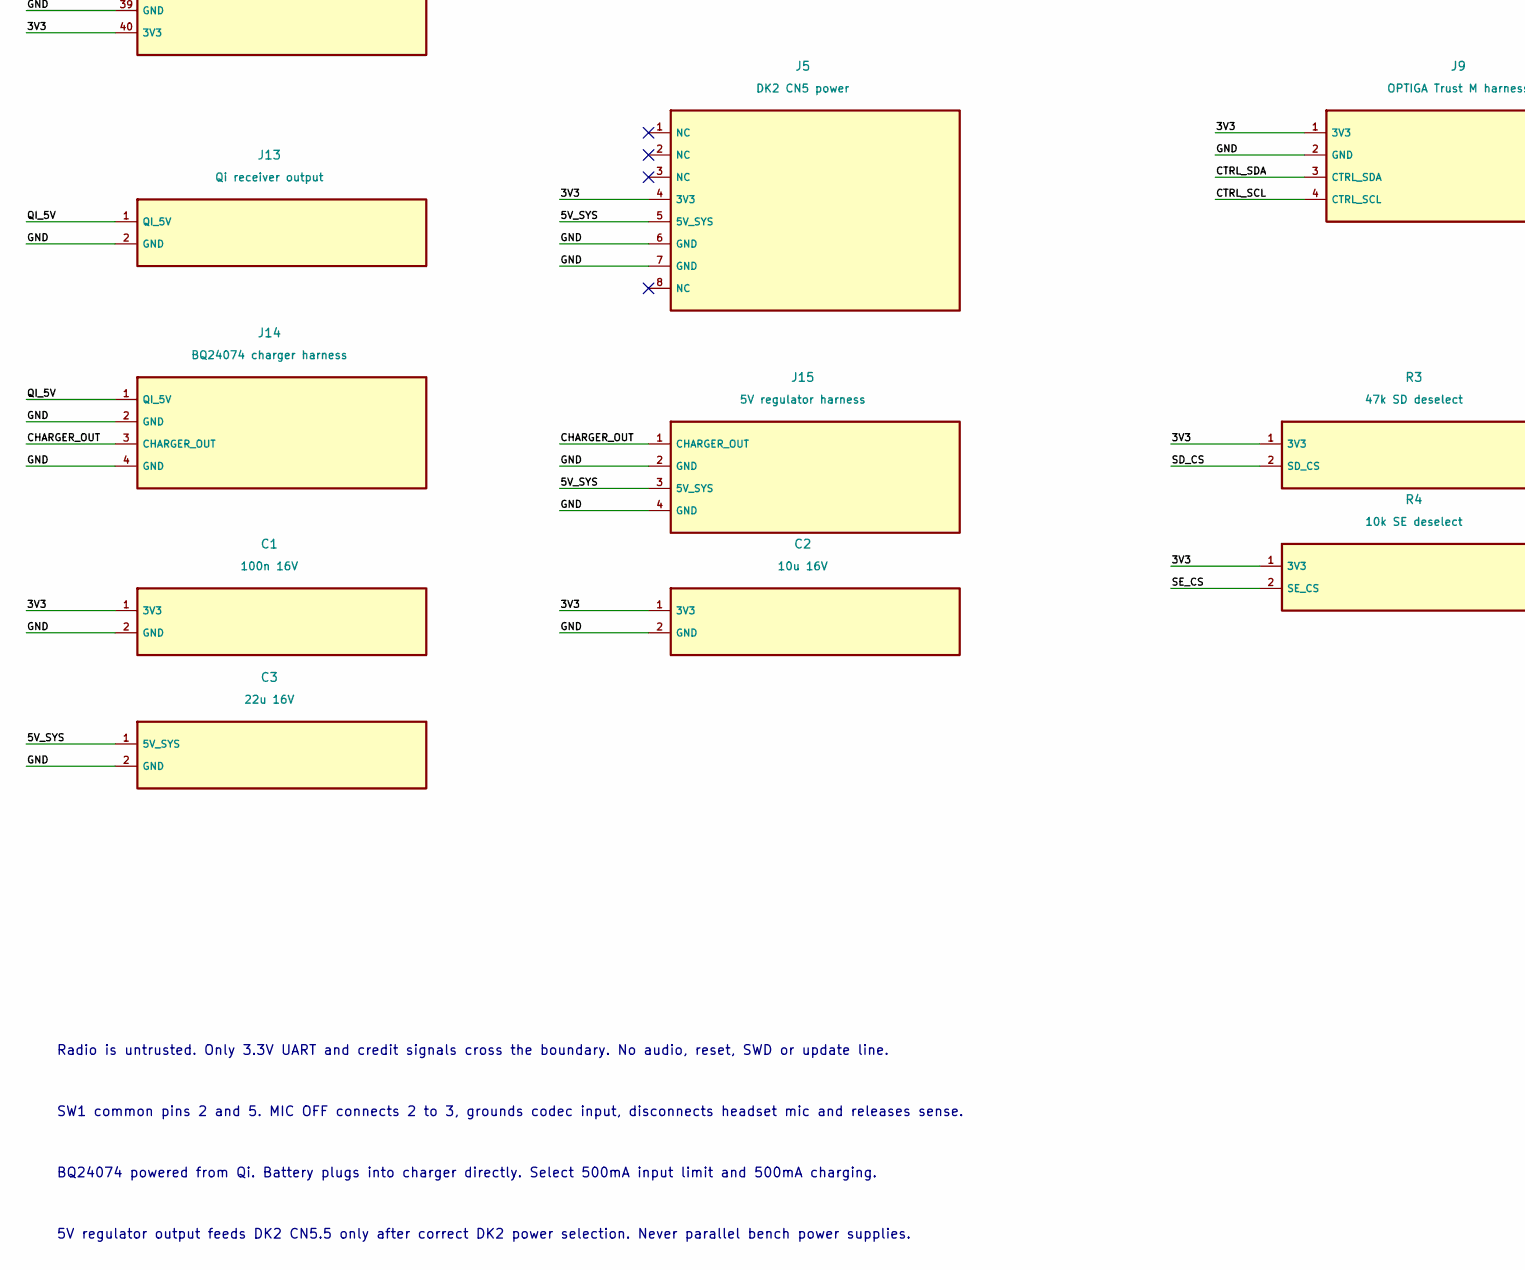
[picture p75: schematic voicevault-reva.kicad_sch, VoiceVault Rev A serviceable carrier, part in row 2, column 1]

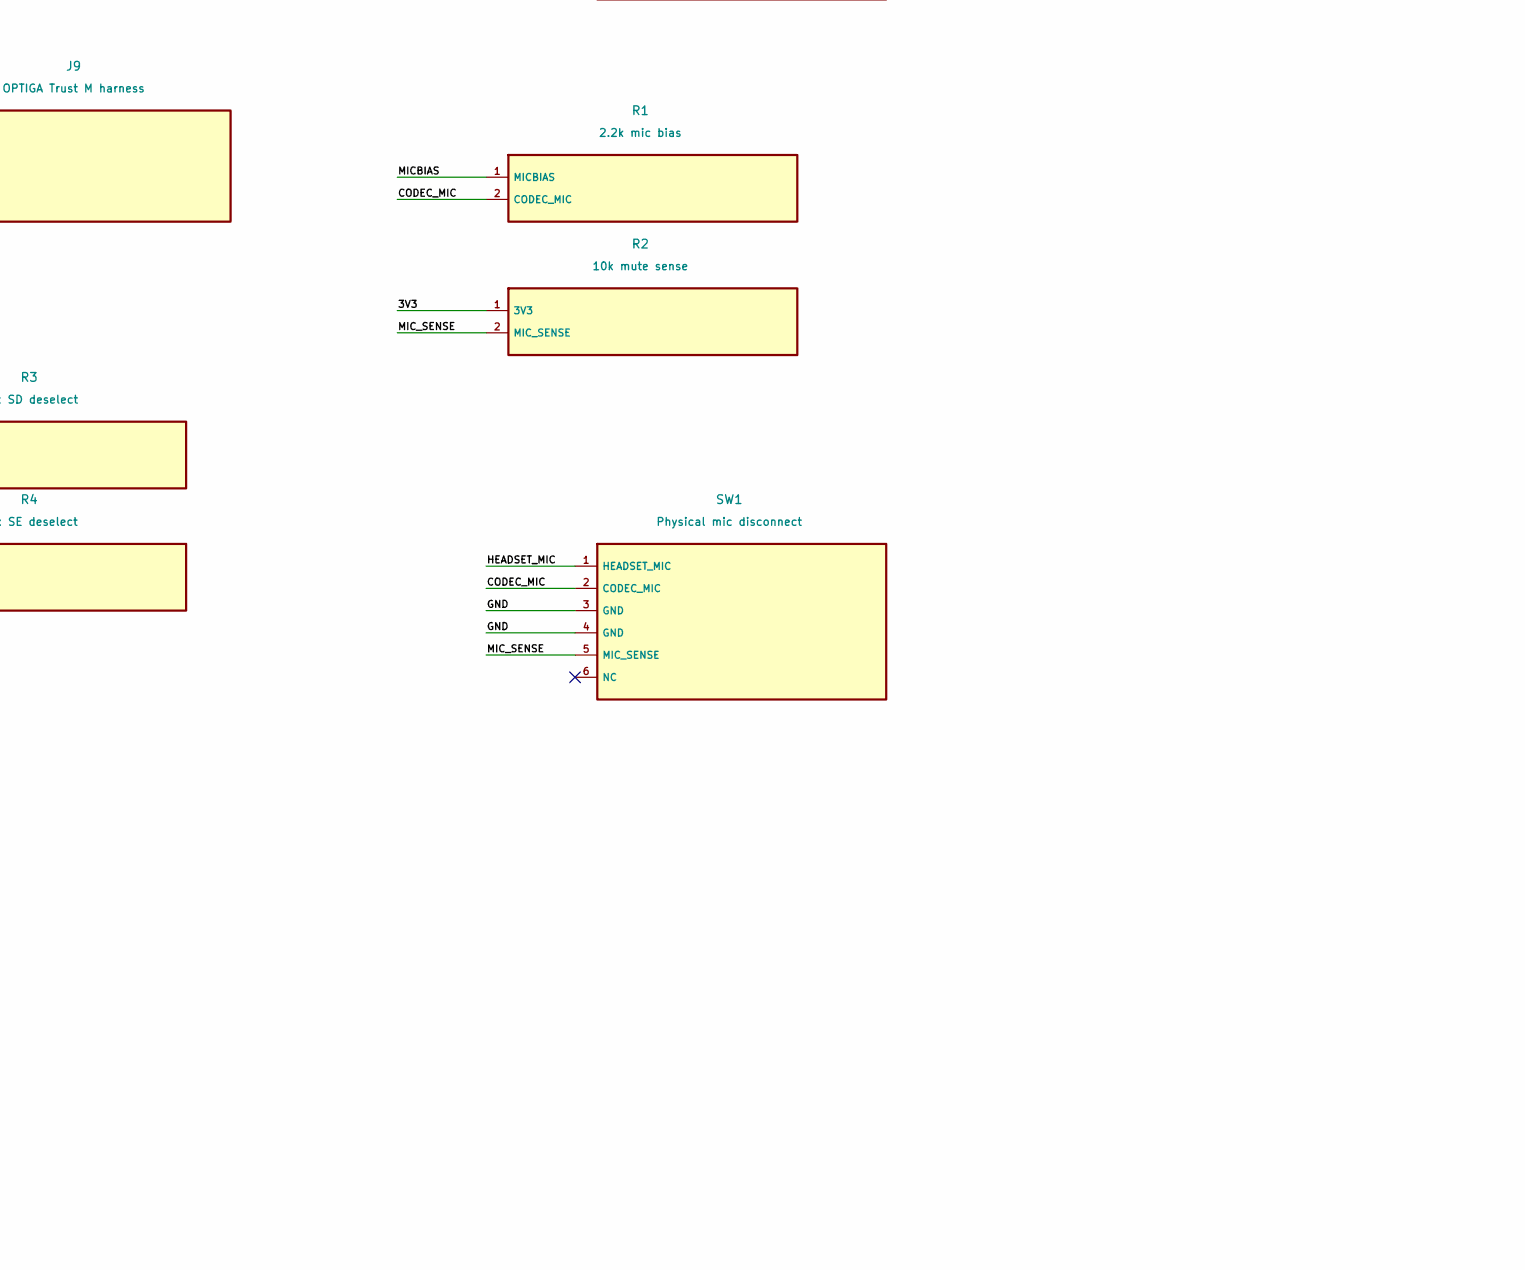
[picture p76: schematic voicevault-reva.kicad_sch, VoiceVault Rev A serviceable carrier, part in row 2, column 2]

Parts:
C1: 100n 16V; C_0603_1608Metric
C2: 10u 16V; C_0805_2012Metric
C3: 22u 16V; C_1210_3225Metric
C4: 220u 10V HP left; CP_Radial_D6.3mm_P2.50mm
C5: 220u 10V HP right; CP_Radial_D6.3mm_P2.50mm
J1: DK2 CN1 extension; PinHeader_2x20_P2.54mm_Vertical
J2: DK2 CN4 digital; PinHeader_1x10_P2.54mm_Vertical
J3: DK2 CN6 digital; PinHeader_1x08_P2.54mm_Vertical
J4: DK2 CN7 analog; PinHeader_1x06_P2.54mm_Vertical
J5: DK2 CN5 power; PinHeader_1x08_P2.54mm_Vertical
J6: WM8960 digital harness; PinHeader_1x12_P2.54mm_Vertical
J7: nRF52840 radio harness; PinHeader_1x06_P2.54mm_Vertical
J8: TROPIC Click harness; PinHeader_1x07_P2.54mm_Vertical
J9: OPTIGA Trust M harness; PinHeader_1x04_P2.54mm_Vertical
J10: microSD SPI harness; PinHeader_1x06_P2.54mm_Vertical
J11: Codec analog harness; PinHeader_1x06_P2.54mm_Vertical
J12: CTIA headset harness; PinHeader_1x04_P2.54mm_Vertical
J13: Qi receiver output; PinHeader_1x02_P2.54mm_Vertical
J14: BQ24074 charger harness; PinHeader_1x04_P2.54mm_Vertical
J15: 5V regulator harness; PinHeader_1x04_P2.54mm_Vertical
J16: Local update button; PinHeader_1x02_P2.54mm_Vertical
R1: 2.2k mic bias; R_0603_1608Metric
R2: 10k mute sense; R_0603_1608Metric
R3: 47k SD deselect; R_0603_1608Metric
R4: 10k SE deselect; R_0603_1608Metric
SW1: Physical mic disconnect; SW_CK_JS202011CQN_DPDT_Straight

Connections:
3V3: C1.1 (3V3), C2.1 (3V3), J1.2 (3V3), J1.4 (3V3), J1.6 (3V3), J1.40 (3V3), J5.4 (3V3), J6.1 (3V3), J8.1 (3V3), J9.1 (3V3), J10.1 (3V3), R2.1 (3V3), R3.1 (3V3), R4.1 (3V3)
5V_SYS: C3.1 (5V_SYS), J5.5 (5V_SYS), J6.3 (5V_SYS), J7.1 (5V_SYS), J15.3 (5V_SYS)
AUDIO_ADC: J1.20 (AUDIO_ADC), J6.11 (AUDIO_ADC)
AUDIO_BCLK: J3.5 (AUDIO_BCLK), J6.7 (AUDIO_BCLK)
AUDIO_DAC: J2.1 (AUDIO_DAC), J6.10 (AUDIO_DAC)
AUDIO_FS: J1.14 (AUDIO_FS), J6.8 (AUDIO_FS), J6.9 (AUDIO_FS)
AUDIO_MCLK: J3.8 (AUDIO_MCLK), J6.6 (AUDIO_MCLK)
CHARGER_OUT: J14.3 (CHARGER_OUT), J15.1 (CHARGER_OUT)
CODEC_MIC: J11.5 (CODEC_MIC), R1.2 (CODEC_MIC), SW1.2 (CODEC_MIC)
CTRL_SCL: J2.10 (CTRL_SCL), J6.5 (CTRL_SCL), J9.4 (CTRL_SCL)
CTRL_SDA: J2.9 (CTRL_SDA), J6.4 (CTRL_SDA), J9.3 (CTRL_SDA)
GND: C1.2 (GND), C2.2 (GND), C3.2 (GND), J1.1 (GND), J1.3 (GND), J1.5 (GND), J1.7 (GND), J1.9 (GND), J1.11 (GND), J1.13 (GND), J1.15 (GND), J1.17 (GND), J1.19 (GND), J1.21 (GND), J1.23 (GND), J1.25 (GND), J1.27 (GND), J1.29 (GND), J1.31 (GND), J1.33 (GND), J1.35 (GND), J1.37 (GND), J1.39 (GND), J2.7 (GND), J5.6 (GND), J5.7 (GND), J6.2 (GND), J6.12 (GND), J7.2 (GND), J8.2 (GND), J9.2 (GND), J10.2 (GND), J11.3 (GND), J11.6 (GND), J12.3 (GND), J13.2 (GND), J14.2 (GND), J14.4 (GND), J15.2 (GND), J15.4 (GND), J16.2 (GND), SW1.3 (GND), SW1.4 (GND)
HEADSET_MIC: J12.4 (HEADSET_MIC), SW1.1 (HEADSET_MIC)
HP_L: C4.2 (HP_L), J12.1 (HP_L)
HP_L_RAW: C4.1 (HP_L_RAW), J11.1 (HP_L_RAW)
HP_R: C5.2 (HP_R), J12.2 (HP_R)
HP_R_RAW: C5.1 (HP_R_RAW), J11.2 (HP_R_RAW)
MCU_TX_TO_RADIO: J3.2 (MCU_TX_TO_RADIO), J7.3 (MCU_TX_TO_RADIO)
MICBIAS: J11.4 (MICBIAS), R1.1 (MICBIAS)
MIC_SENSE: J1.10 (MIC_SENSE), R2.2 (MIC_SENSE), SW1.5 (MIC_SENSE)
QI_5V: J13.1 (QI_5V), J14.1 (QI_5V)
RADIO_CREDIT: J4.3 (RADIO_CREDIT), J7.5 (RADIO_CREDIT)
RADIO_PENDING: J4.4 (RADIO_PENDING), J7.6 (RADIO_PENDING)
RADIO_TX_TO_MCU: J3.1 (RADIO_TX_TO_MCU), J7.4 (RADIO_TX_TO_MCU)
SD_CS: J2.3 (SD_CS), J10.3 (SD_CS), R3.2 (SD_CS)
SD_MISO: J4.1 (SD_MISO), J10.6 (SD_MISO)
SD_MOSI: J4.6 (SD_MOSI), J10.5 (SD_MOSI)
SD_SCK: J4.5 (SD_SCK), J10.4 (SD_SCK)
SE_CS: J2.2 (SE_CS), J8.3 (SE_CS), R4.2 (SE_CS)
SE_IRQ: J1.8 (SE_IRQ), J8.7 (SE_IRQ)
SE_MISO: J2.5 (SE_MISO), J8.6 (SE_MISO)
SE_MOSI: J2.4 (SE_MOSI), J8.5 (SE_MOSI)
SE_SCK: J2.6 (SE_SCK), J8.4 (SE_SCK)
UPDATE_BUTTON: J1.12 (UPDATE_BUTTON), J16.1 (UPDATE_BUTTON)

Notes on the sheet:
VoiceVault Rev A | DK2 cabled carrier | electrical review draft
Reference STM32U5G9ZJT6Q revision Z. Verify actual DBGMCU ID before bench qualification.
Ports are harness connectors. Follow pin map and module wiring guide. Passive port ERC checks connectivity only.
PCB placement is unrouted. Manufacturing release requires electrical, routing, thermal and bench review.
Radio is untrusted. Only 3.3V UART and credit signals cross the boundary. No audio, reset, SWD or update line.
SW1 common pins 2 and 5. MIC OFF connects 2 to 3, grounds codec input, disconnects headset mic and releases sense.
BQ24074 powered from Qi. Battery plugs into charger directly. Select 500mA input limit and 500mA charging.
5V regulator output feeds DK2 CN5.5 only after correct DK2 power selection. Never parallel bench power supplies.

Board: 2 copper layers, 30 parts (0 on the bottom side), 34 nets, no tracks yet.

Other parts of the board:
H1, H2, H3, H4: MountingHole_3.2mm_M3
