adlererik/voicevault/platform/build.rs

fn main() {
    let out = std::path::PathBuf::from(std::env::var_os("OUT_DIR").unwrap());
    std::fs::copy("memory.x", out.join("memory.x")).unwrap();
    println!("cargo:rustc-link-search={}", out.display());
    println!("cargo:rustc-link-arg=-Tlink.x");
    println!("cargo:rerun-if-changed=memory.x");
}
