adlererik/voicevault/(commit log)

2026-11-10 Model trusted-device lifecycle and verify Cortex-M33 capacity
2026-11-10 Present VoxBastion as a device project with complete security documentation
2026-11-10 Rename project to VoiceVault and stream live device verification
2026-11-10 Put live device activity first and add decoded test-audio monitoring
2026-11-11 Track the upstream platform lockfile for integrity verification
2026-11-11 Track the codec lockfile used by the upstream integrity check
2026-11-11 Explain VoiceVault fuzz coverage and plan the first hardware prototype
2026-11-12 Add VoiceVault standalone B0 circuits, placement review and hardware verification
    Add the Safe 7 core-based custom SMD circuit with audio, microSD, isolated interfaces and separate debug access. Include native pad/ball checks, antenna-rule negative controls, 799 ngspice model cases, measured plots and explicit manufacturing/qualification gates. Repair local MCP runtime setup and rear-side footprint generation.
    [bom.csv, circuit-audio-codec.kicad_sch, circuit-audio-power.kicad_sch, circuit-backlight.kicad_sch, circuit-control.kicad_sch, circuit-display.kicad_sch, circuit-haptic.kicad_sch, circuit-headset.kicad_sch]
2026-11-12 Start B0 RF routing and document four-board manufacturing costs
    [voicevault-standalone-b0.kicad_pcb]
2026-11-12 Add checked core routing and fail-closed copper import controls
    [voicevault-standalone-b0.kicad_pcb]
2026-11-12 Route MCU ground and sixteen control nets with guarded KiCad MCP acceptance
    [voicevault-standalone-b0.kicad_pcb]
2026-11-12 Tighten and route main crystal layout with checked ground escapes
    [voicevault-standalone-b0.kicad_pcb]
2026-11-12 Replace obsolete microSD candidate with reviewed Molex socket and land checks
    [circuit-inventory.csv, circuit-microsd.kicad_sch, voicevault-standalone-b0.kicad_pcb]
2026-11-12 Preserve checked placement and copper before whole-board autorouting
    [voicevault-standalone-b0.kicad_pcb]
2026-11-12 Import whole-board FreeRouting SES through kipy and record native DRC findings
    [voicevault-standalone-b0.kicad_pcb, voicevault.dsn]
2026-11-13 Record launched Quilter routing trial and preserve reviewed input
    [bga_components.csv, bypass_capacitors.csv, crystal_oscillators.csv, ground_nets.csv, high_current_nets.csv, switching_converters.csv, voicevault-standalone-b0.kicad_pcb]
2026-11-13 Add returned-board identity gate and native escape connectivity evidence
2026-11-13 Record checked core-capacitor placement proposal for post-routing review
2026-11-13 Record sourced passive candidates and checked battery decoupling correction
    [parts-candidates.csv]
2026-11-13 Deepen returned-board checks and review fine-pitch manufacturer lands
2026-11-13 Screen additional capacitor candidates and reject tolerance mismatches
    [parts-candidates.csv]
2026-11-13 Record finished Quilter candidate and native rejection evidence
    [voicevault-standalone-b0.kicad_pcb]
2026-11-13 Launch corrected unattended Quilter retry and preserve handoff evidence
    [bga_components.csv, bypass_capacitors.csv, crystal_oscillators.csv, high_current_nets.csv, switching_converters.csv]
